simakma5/diploma-thesis/latex/declaration.tex

\clearpage
\vspace*{\fill}
\noindent\textbf{Declaration}\\[0.25cm]
I declare that I completed the presented thesis independently and that all used sources are quoted in accordance with the Methodological instructions that cover the ethical principles for writing an academic thesis.\\
\hrule\vspace*{1cm}
\begin{otherlanguage}{czech}
    \noindent\textbf{Prohlášení}\\[0.25cm]
    Prohlašuji, že jsem předloženou práci vypracoval samostatně a že jsem uvedl veškeré použité informační zdroje v souladu s Metodickým pokynem o dodržování etických principů při přípravě vysokoškolských závěrečných prací.\\
    \begin{center}
        \begin{minipage}{0.45\textwidth}
            \begin{flushleft}
                V Praze \hdashrule{3cm}{0.5pt}{2pt}
            \end{flushleft}
        \end{minipage}
        ~
        \begin{minipage}{0.45\textwidth}
            \begin{flushright}
                \noindent\begin{tabular}{c}
                    \\
                    \hdashrule{4cm}{0.5pt}{2pt}\\
                    Martin Šimák
                \end{tabular}
            \end{flushright}
        \end{minipage}
    \end{center}
\end{otherlanguage}
\clearpage
