simakma5/diploma-thesis/latex/frontpage.tex

% Define a new command for horizontal lines, change thickness here
\newcommand{\HRule}{\rule{\linewidth}{0.5mm}}
\center

%========== Header ==========
\textsc{\LARGE Czech Technical University in Prague,\\Faculty of Electrical Engineering}\\[1.5cm]
\textsc{\Large Master's thesis}\\[0.5cm]

%========== Title ==========
\HRule\\[0.6cm]
{\huge\bfseries Dual Circularly Polarized Waveguide Antenna}\\[0.3cm] % Title of your document
\HRule\\[1.5cm]

%========== Authors ==========
\begin{minipage}{0.45\textwidth}
    \begin{flushleft}
        \large
        \textit{Author}\\
        M. \textsc{Šimák}\\
        \textsc{Department of Electromagnetic Field}
    \end{flushleft}
\end{minipage}
~
\begin{minipage}{0.45\textwidth}
    \begin{flushright}
        \large
        \textit{Supervisor}\\
        doc. Ing. P. \textsc{Hazdra}, Ph.D.\\
        \textsc{Department of Electromagnetic Field}
    \end{flushright}
\end{minipage}

%========== Logo ==========
% Position at 3/4 of the screen
\vfill\vfill\vfill
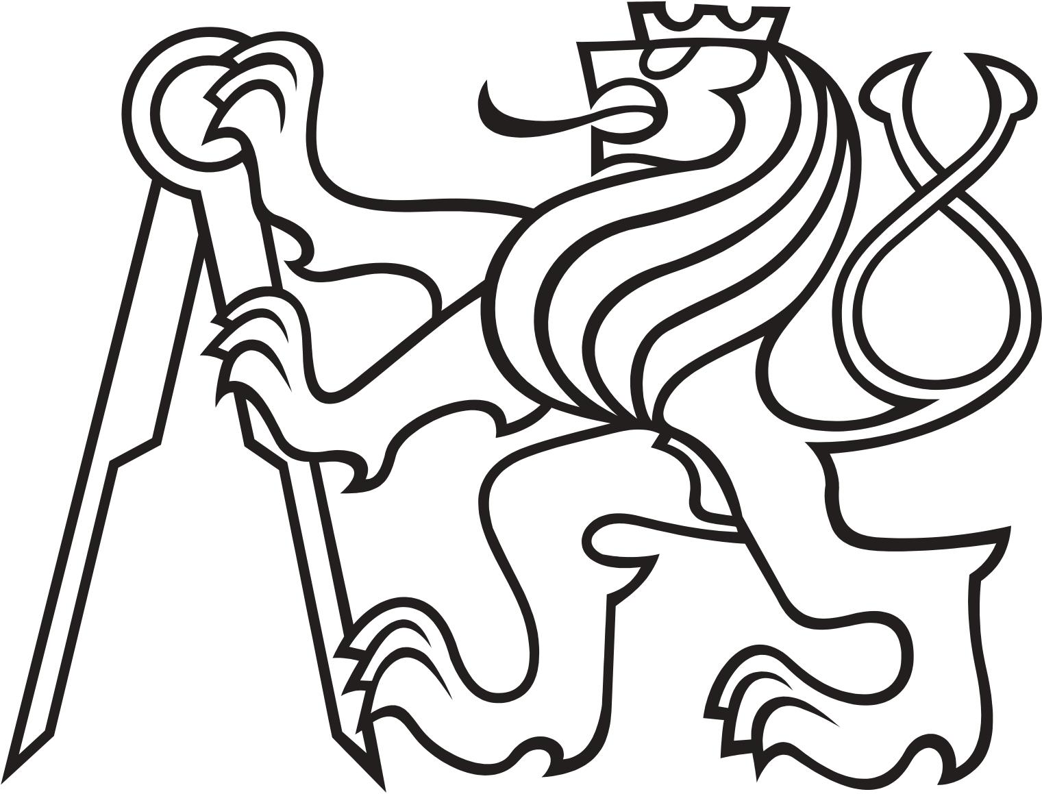
[picture p1: latex/src/ctu_logo_black.jpg]


%========== Date ==========
\vfill\vfill
{\large\monthyeardate\today}
% Push the date up 1/4 of the remaining page
\vfill
