simakma5/diploma-thesis/progress-reports/09-progress_report.pptx

## Dual circularly polarized waveguide antenna

Final design

## Outline

- Conical horn design
- Prototype
- Functional changes
- Assembly-related adjustments
- Thesis
- Conclusion

Research progress report

## Conical horn design

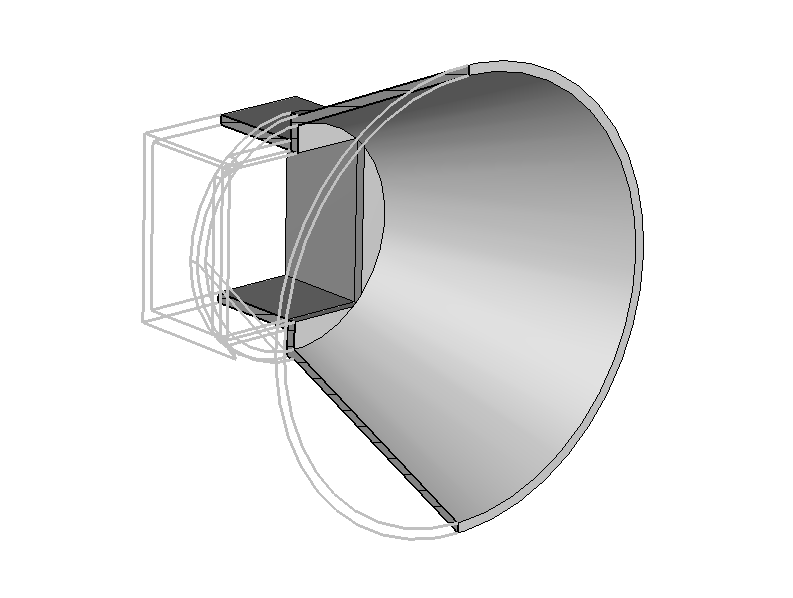
[picture p2: figure]

- Valuable theoretical analysis and guidelines given in [1]
- Antenna Magus
- Adaptation of a cone to the square waveguide

## Conical horn – reflection

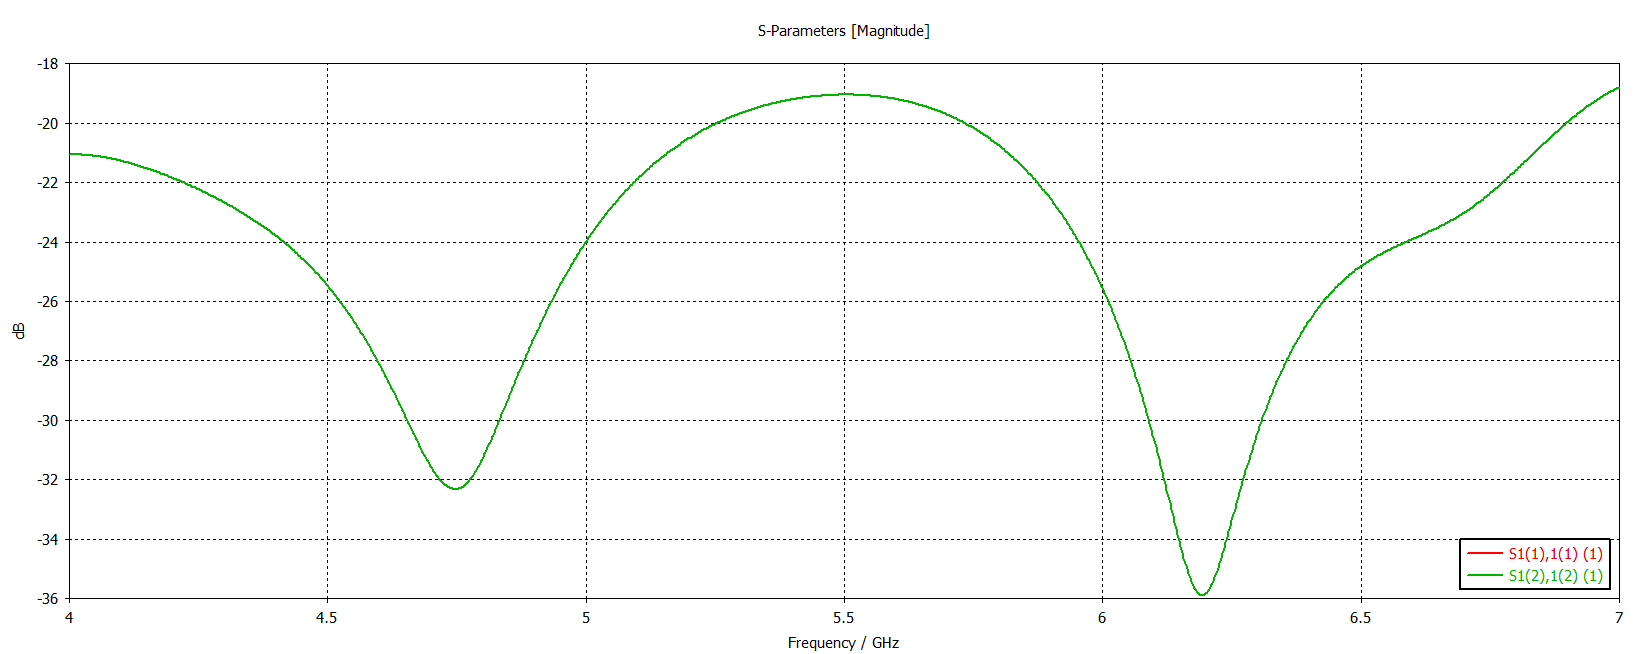
[picture p3: figure]

## Conical horn – gain

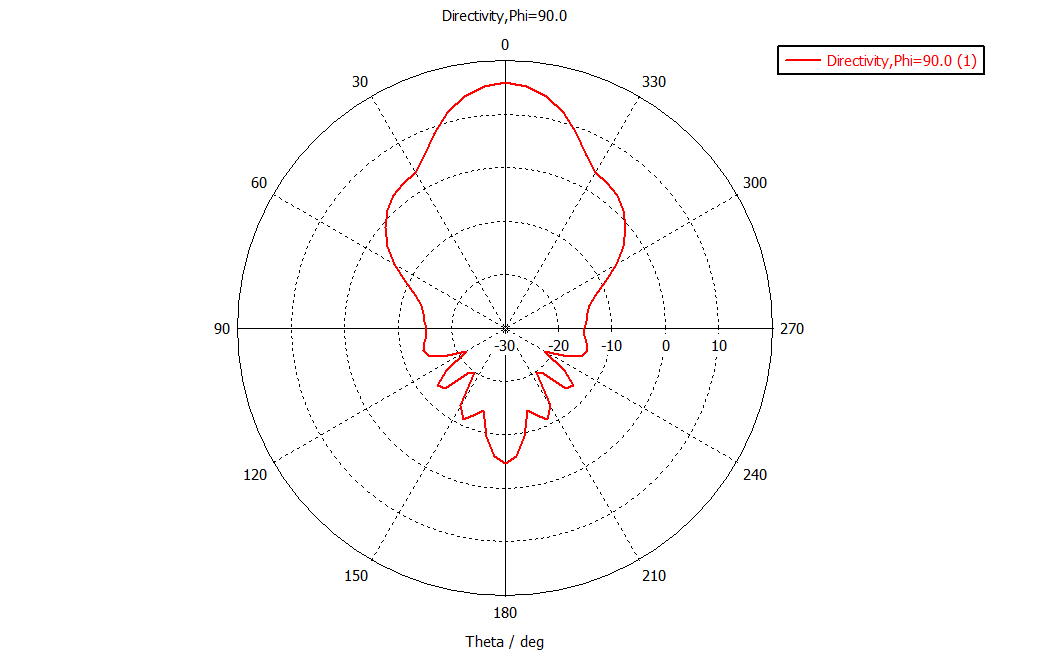
[picture p4: figure]

## Prototype – per partes

- Managed to get good simulation results piece-by-piece
- Especially difficult of the dual feeding structure with grating

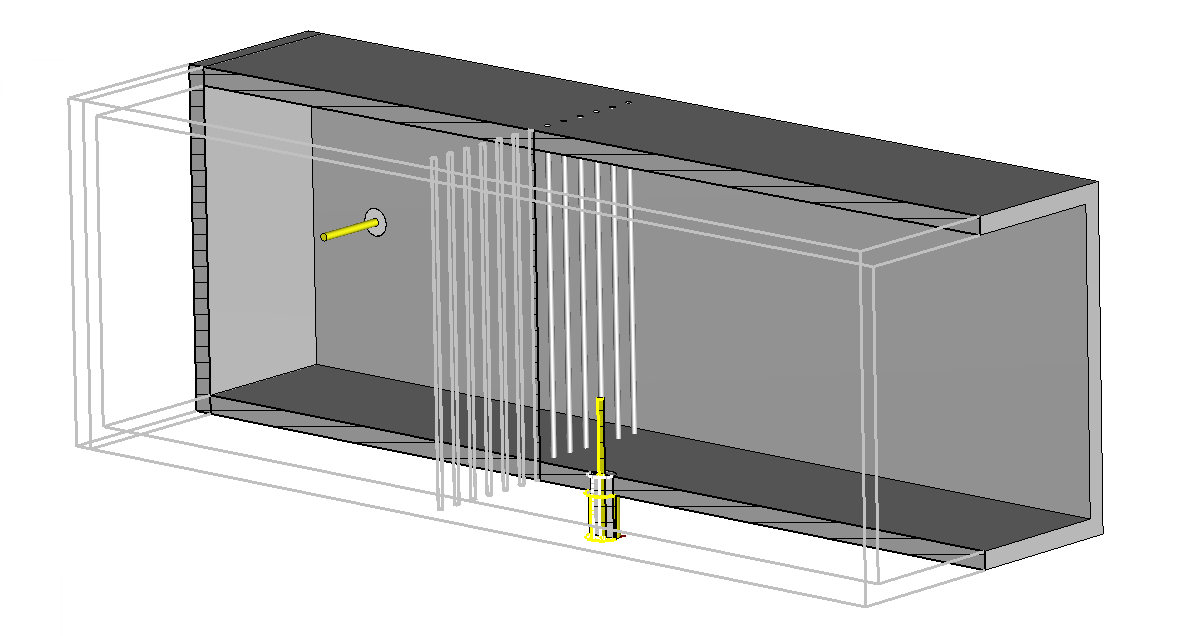
[picture p5: figure]
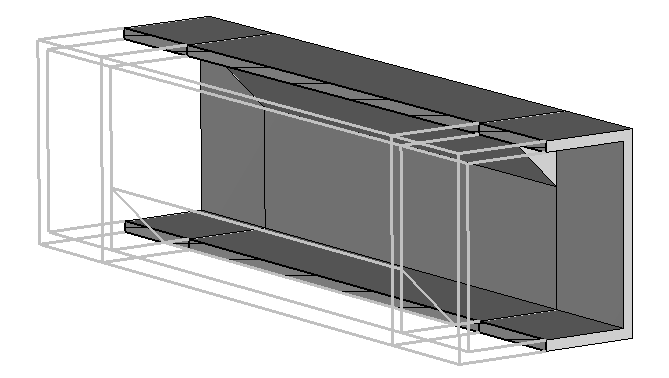
[picture p6: figure]
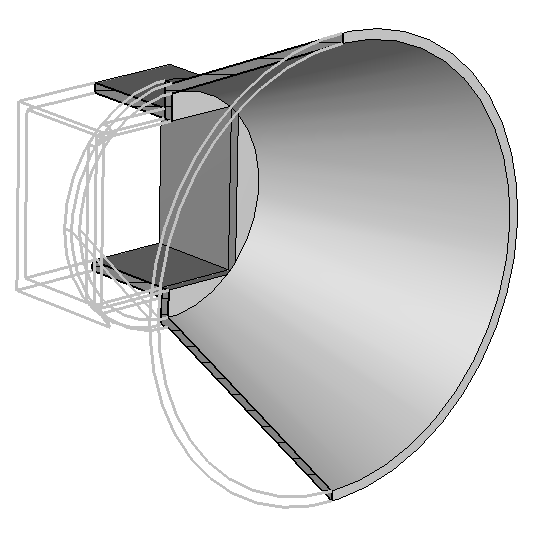
[picture p7: figure]

## Prototype – model

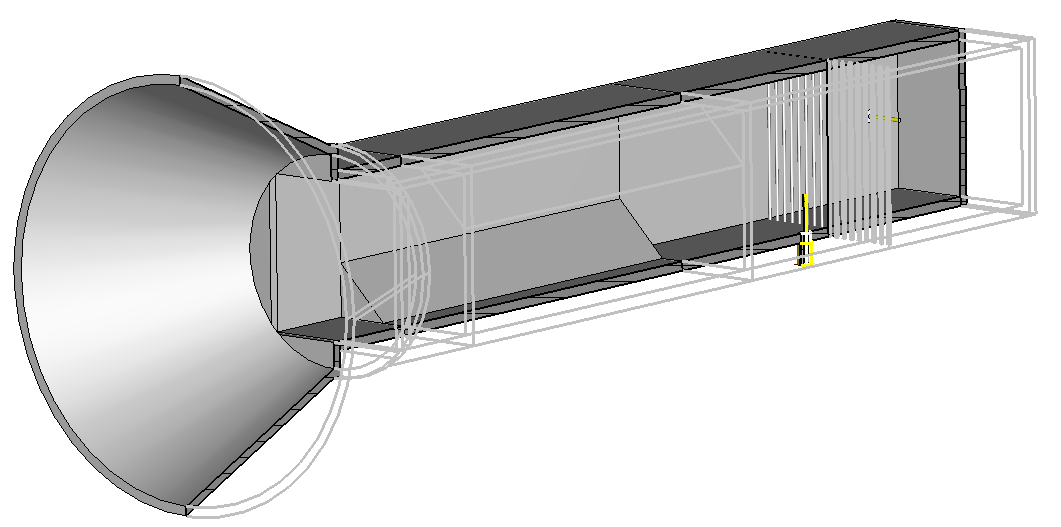
[picture p8: figure]

## Prototype – results

- Unfortunately, performance was much worse after completion
- Cause analysis
  - Grating causes unwanted field torsion
  - Newly introduced reflections increase probe coupling
  - Higher order modes appearance with more complex propagation geometry
- Crosstalk had risen so much the grating polarizer lost its meaning

## Prototype – S-parameters

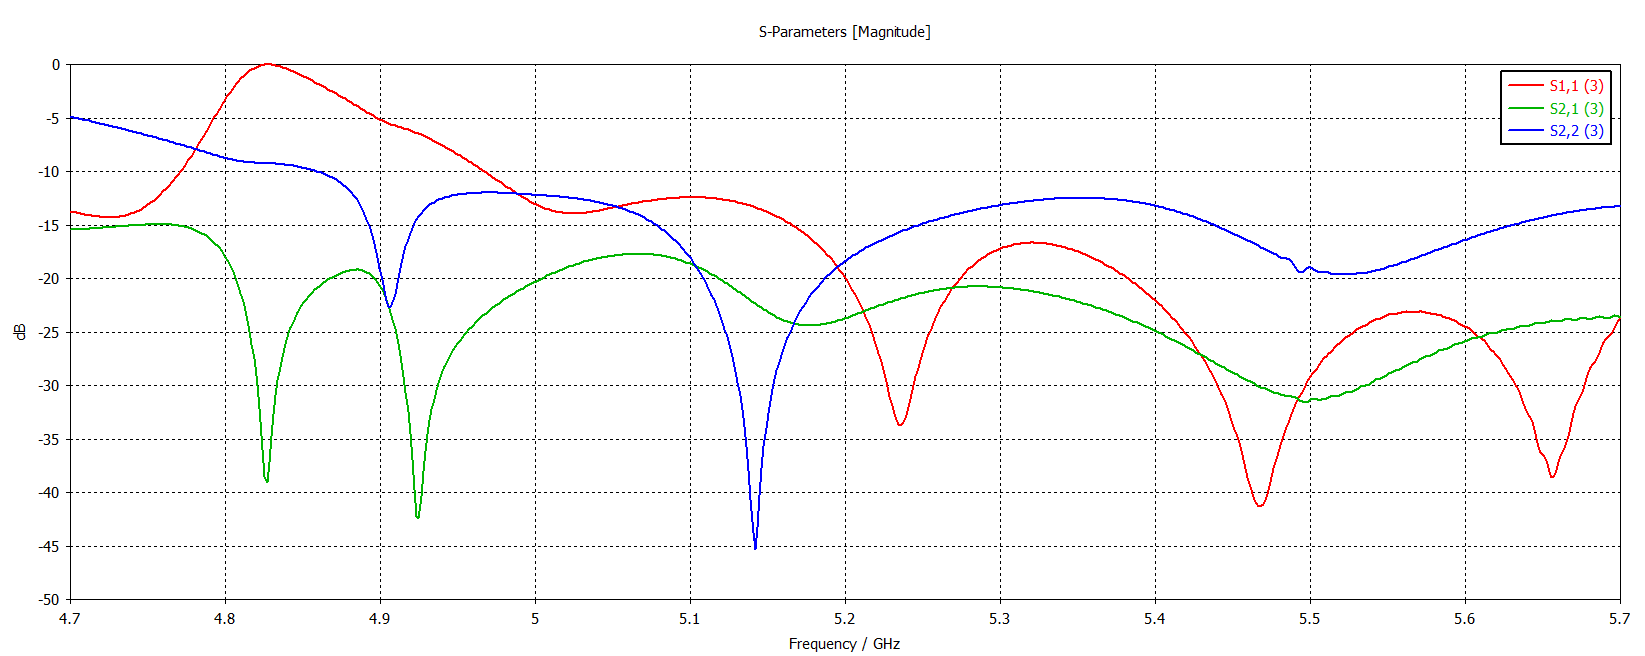
[picture p9: figure]

## Prototype – Axial ratio

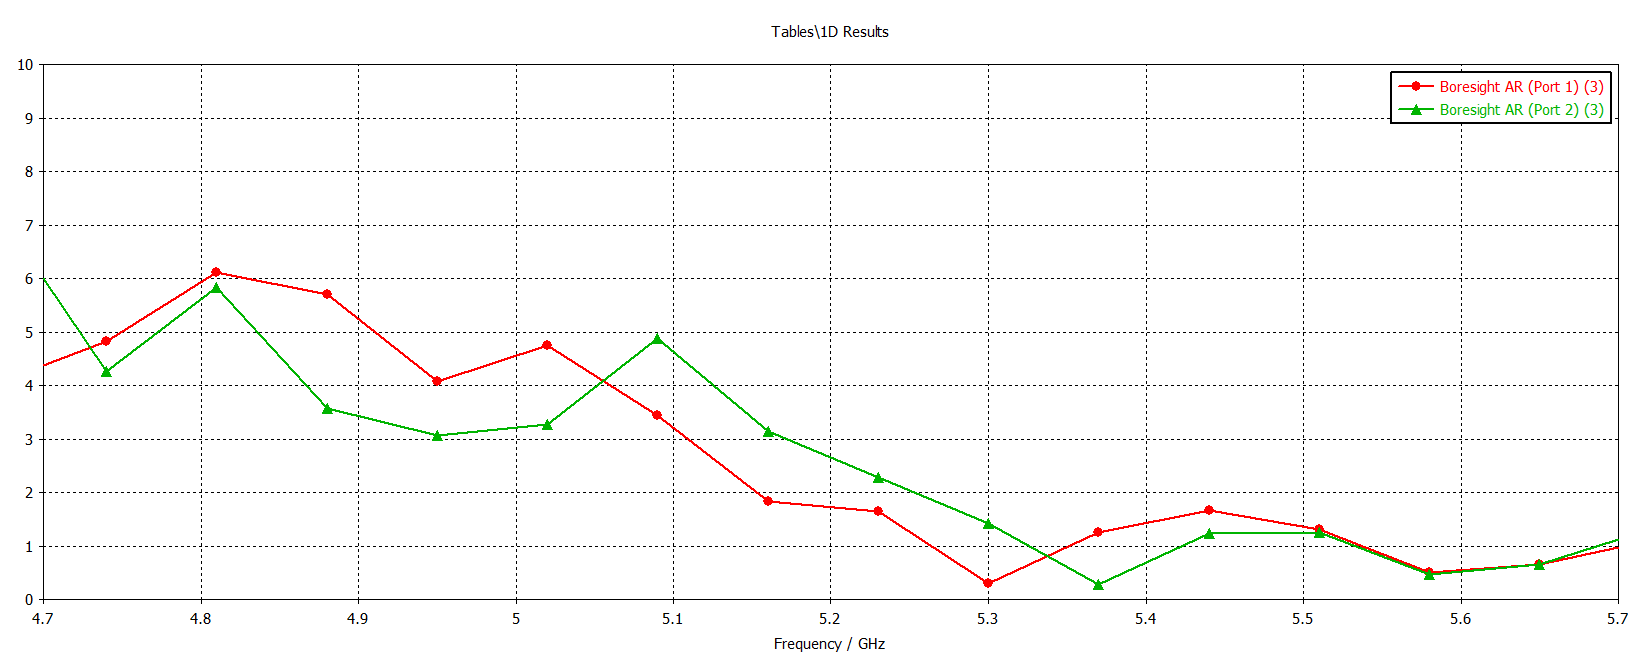
[picture p10: figure]

## Functional changes

- Further simulations, tweaking the geometry:
  - Tuning the grating geometry
  - Adjusting various waveguide lengths
  - Complete removal of grating
- Turns out the crosstalk without the grating is viable!
- Design MVP* was simulated for timely manufacturing
  - Precise simulation with over 35 million mesh cells, -50 dB energy precision
*MVP stands for Minimum Viable Product

## Functional changes – model

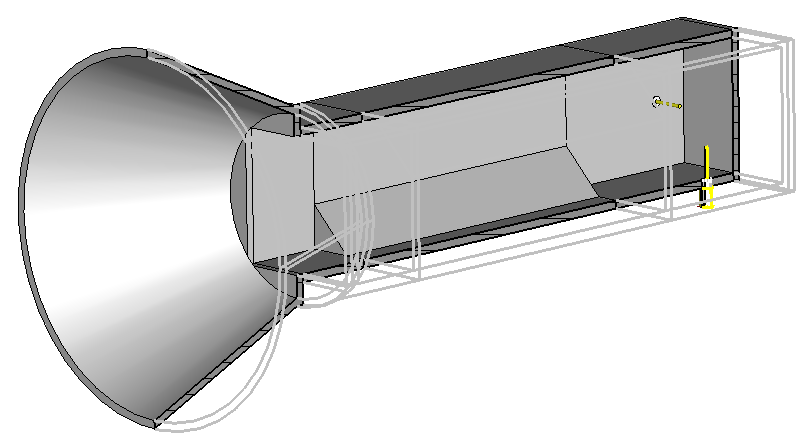
[picture p11: figure]

## Functional changes – S-parameters

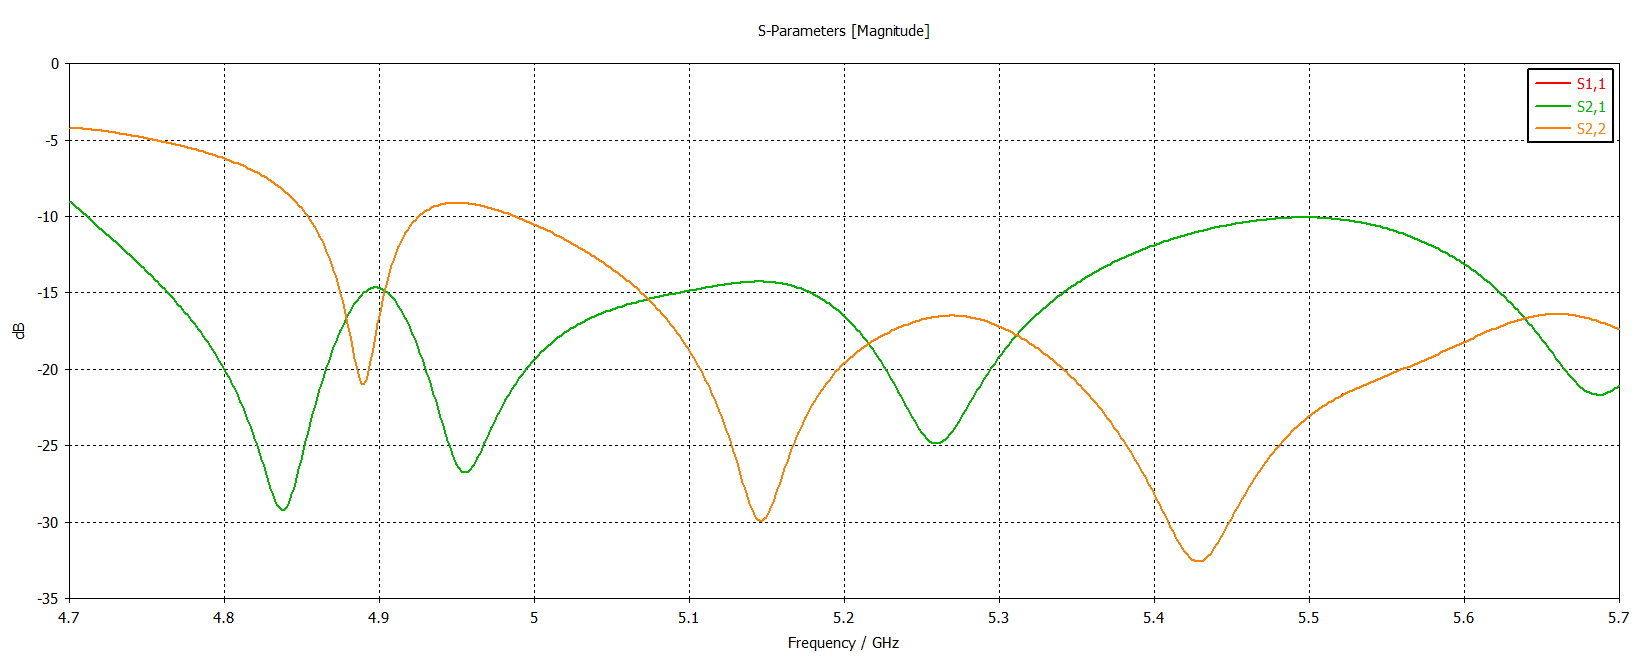
[picture p12: figure]

## Functional changes – Axial ratio

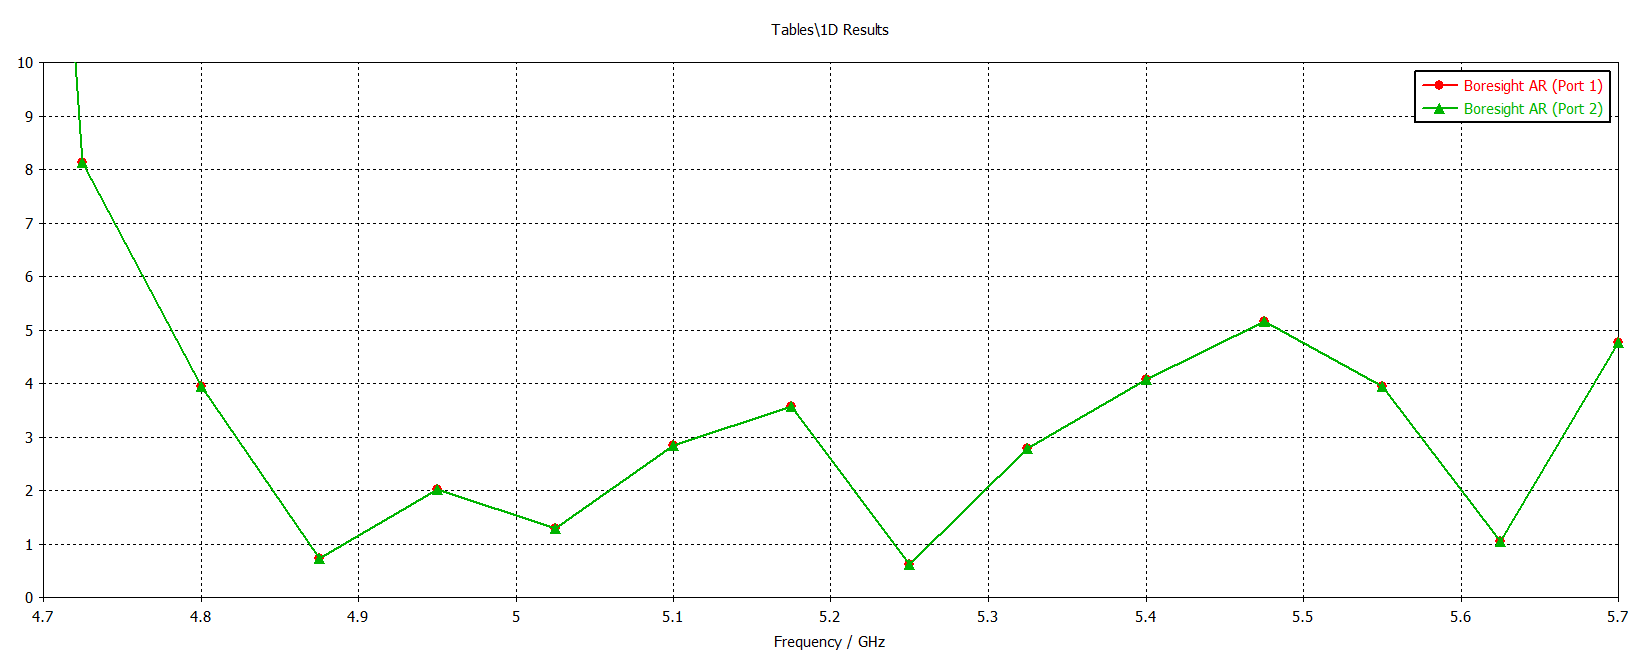
[picture p13: figure]

## Assembly-related adjustments

- The fabrication company* uses CNC machining for fabrication
- Division of the whole piece into 5
  - Horn, transition, polarizer, feed, back-short
  - Connected by flanges
- Adjustments of the horn antenna to make it suitable for milling fabrication
  - While preserving inner dimensions
*Universal Microwave Technology

## Assembly-related adjustments (final)

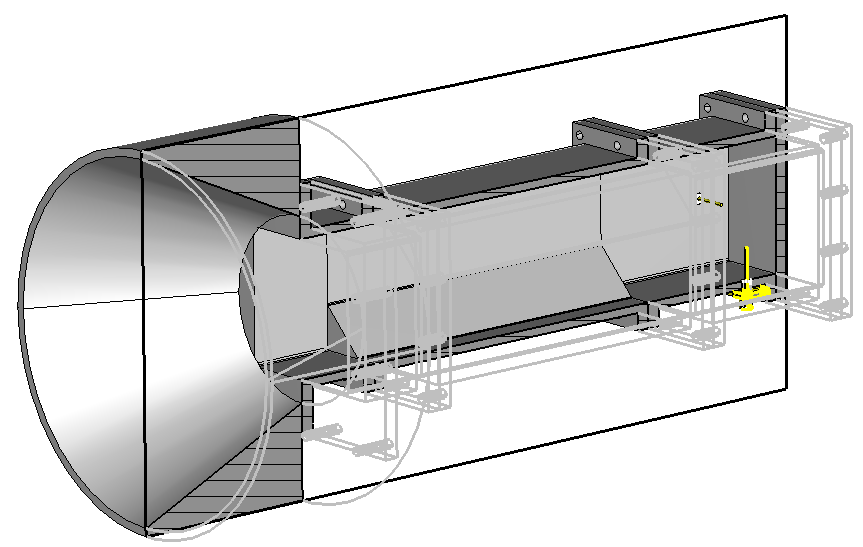
[picture p14: figure]

## Thesis

- Introduction
- 1 Theory of operation
- 2 Design process
  - 2.1 Polarizer design
  - 2.2 Dual feeding structure
    - Mention the grating polarizer variant
  - 2.3 Horn antenna
- 3 Fabrication, measurement and comparison
  - Discuss possibility of the grating polarizer, provide simulation results
  - Simulation and measurement results
- Conclusion

## Conclusion

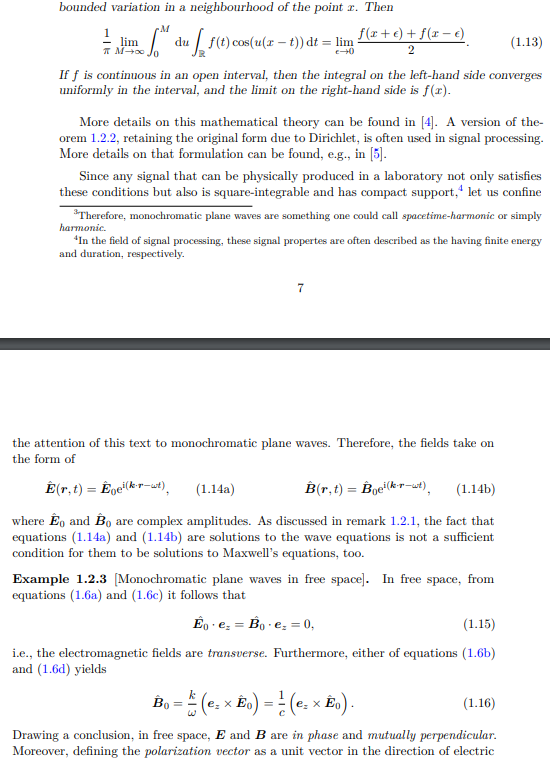
[picture p15: figure]

- Design
  - finalized
  - being manufactured
- In the meanwhile
  - Thesis text in progress
  - Analysis of dual feeding structure with grating

## Thank you

for your attention

## References

[1] N. A. Aboserwal, C. A. Balanis and C. R. Birtcher, "Conical Horn: Gain and Amplitude Patterns," in IEEE Transactions on Antennas and Propagation, vol. 61, no. 7, pp. 3427-3433, July 2013, doi: 10.1109/TAP.2013.2256453.
