simakma5/diploma-thesis/progress-reports/01-progress-report.pptx

## Inductive wireless power transfer

Simulation results and analytical validation

## Outline

- Motivation
- Equivalent circuit analysis
- Coupled inductors
  - Resistance
  - Inductance
  - Comparison of results
- Conclusion
- Outlooks

Research progress report

## Motivation

- Growing demand for WPT systems
- Imperfections in the Qi 2.0 standard, especially the Magnetic Power Profile (MPP)
- Need for accurate and precise simulations
- Collaboration with esteemed companies
Image: How the New Qi2 Standard Will Change the Future of Wireless Charging (graniteriverlabs.com) (https://www.graniteriverlabs.com/en-us/industry-insights/qi2-wireless-charging-mpp-wpc)

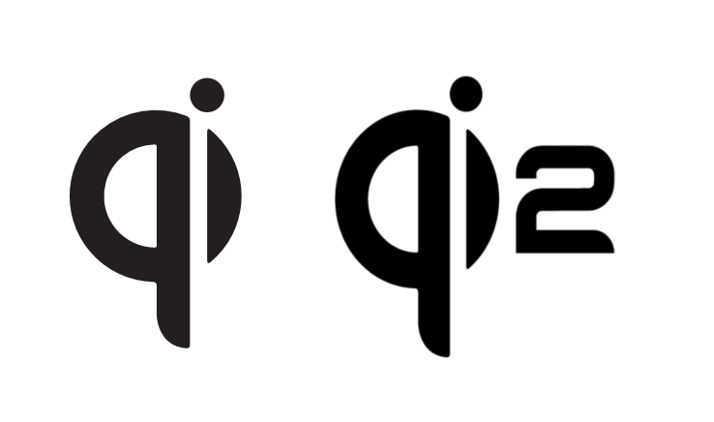
[picture p16: figure]
How the New Qi2 Standard Will Change the Future of Wireless Charging

## Equivalent circuit analysis – IWPT system

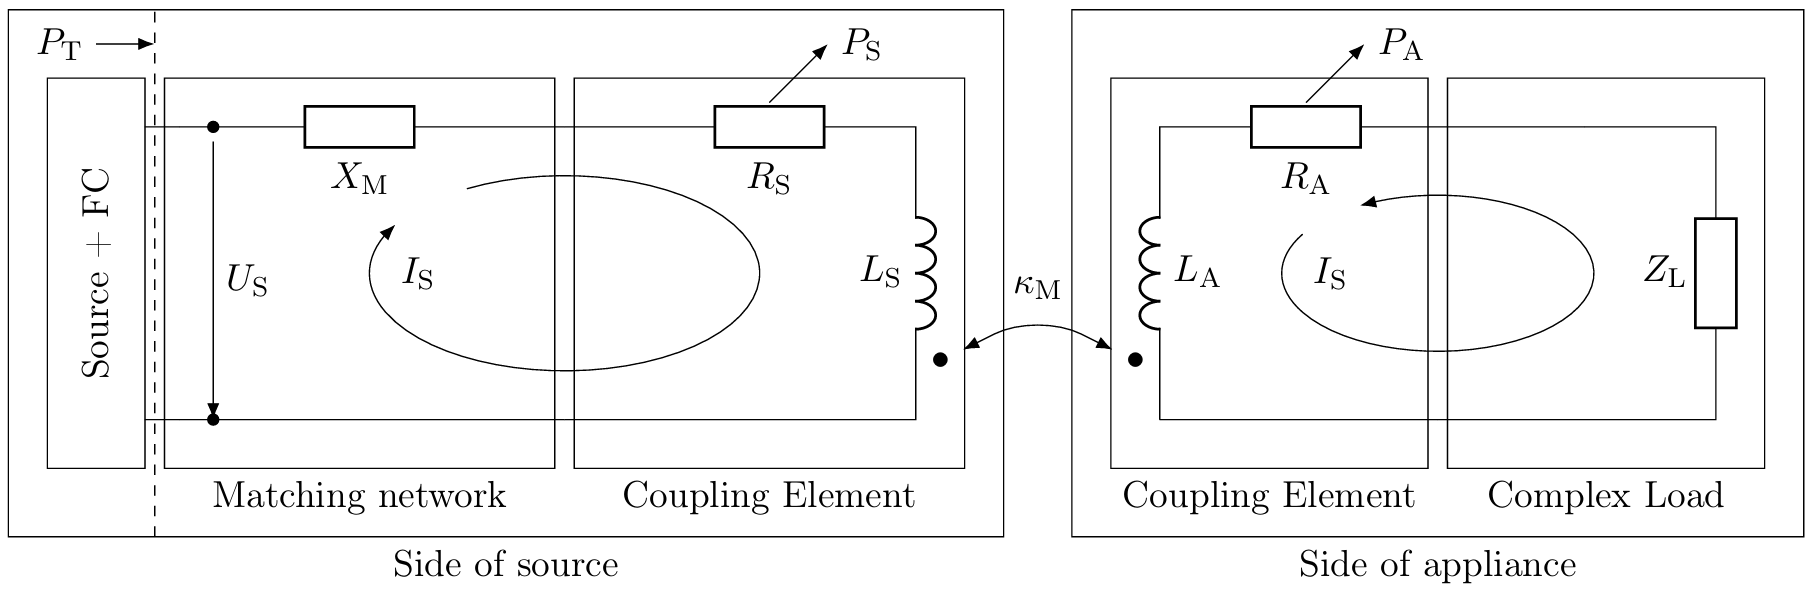
[picture p17: figure]

## Equivalent circuit analysis – coupled inductors

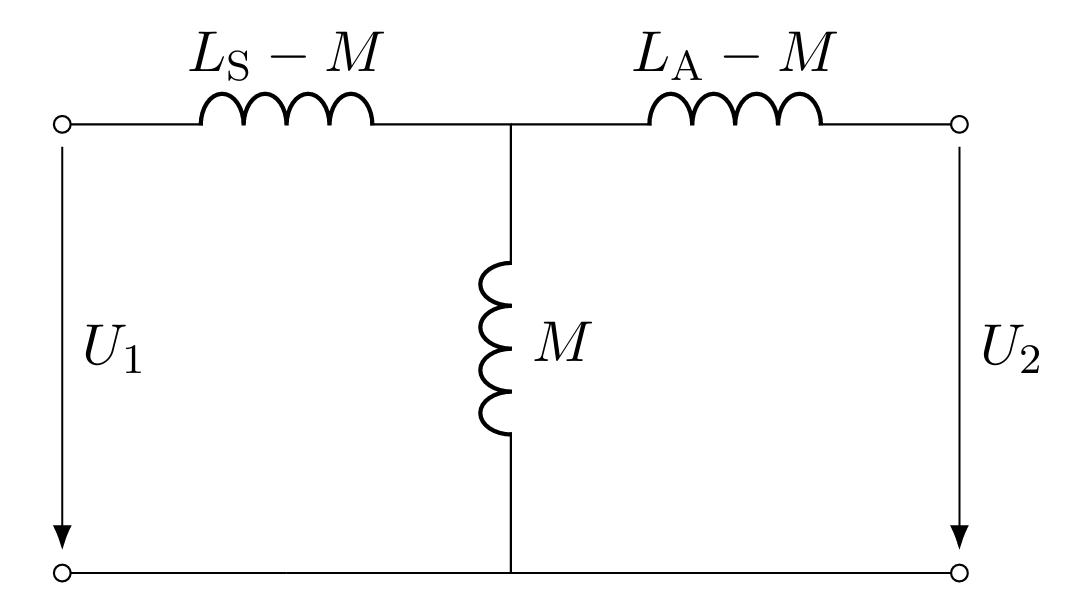
[picture p18: figure]
Equivalent circuit of coupled inductors

## Coupled inductors – 3D CAD model

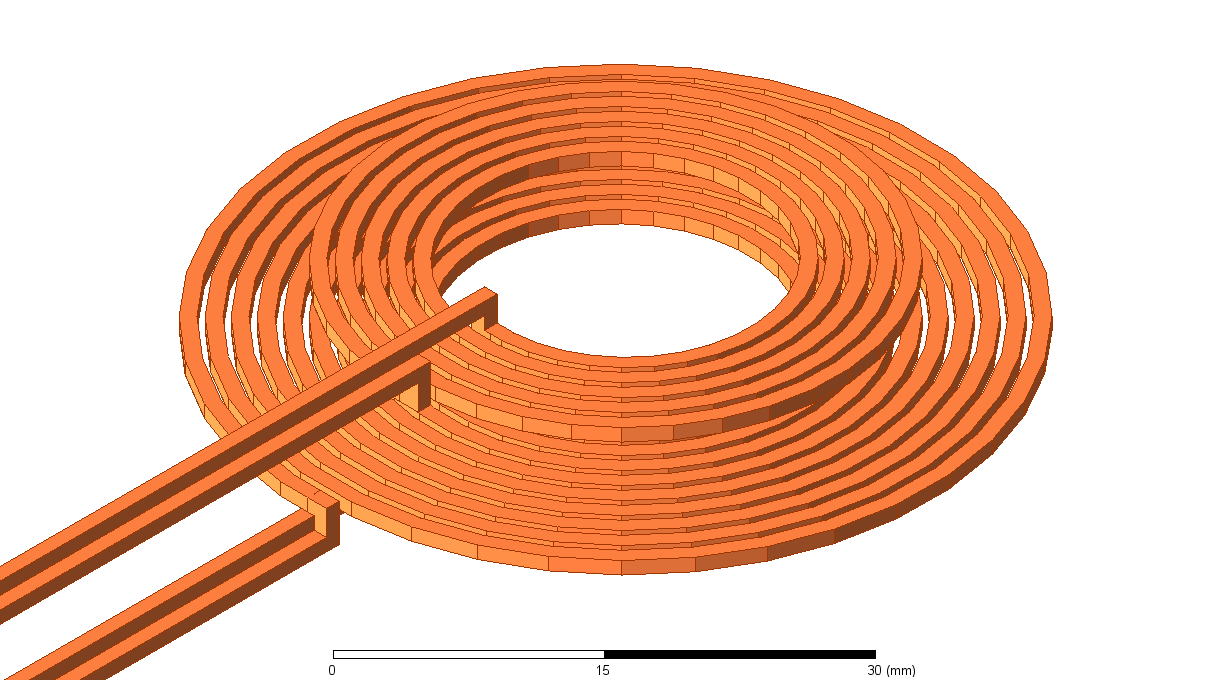
[picture p19: figure]
CAD model of coupled inductors

## Coupled inductors – dimensions

- Transmitting coil (Tx)

- Inner diameter: 20 mm,
- outer diameter: 51 mm,
- coil height: 1 mm,
- number of turns: 10.

- Receiving coil (Rx)

- Inner diameter: 20 mm,
- outer diameter: 36 mm,
- coil height: 1 mm,
- number of turns: 5.

## Resistance – analytical formulas

- DC resistance R=(ρ⋅ℓ)/A=ℓ/(σA) .
- Conductivity of annealed copper σ=5.8001×10^7 S m^(−1) .
- Length ℓ=∫_α^β √(|f(θ)|^2 +|f^(′) (θ)|^2) dθ= ∫_α^β √(r^2 +((∂r)/(∂θ))^2) dθ .
- Transmitting inductor r_(Tx) (θ)=10+1.46/(2π)θ, where 0≤θ≤10×2π .
- Receiving inductor r_(Rx) (θ)=10+1.46/(2π)θ, where 0≤θ≤5×2π .

## Inductance – analytical formulas

- The formulas are in accordance with [3].
- M=4/3μ_0 (R_1 R_2 )^(3/2) (N_1)/(h_1)(N_2)/(h_2)[X(k_11 )−X(k_22 )−X(k_33 )−X(k_44 )].
- L=8/3μ_0 R^3 (N^2)/(h^2)[1/kCel(k,1,1,−2(k^2 −1))−1] .
- Mathematical functions: X(k)=1/k[Cel(k,1,(3ρ)/2−2,−((3ρ−2)(k^2 −1))/2)−3/2ρ(1−k^2 )Cel(k,−(ρ(k^2 −1))/(ρ−2),1,1)] , Cel(k,p,a,b)=∫_0^(π/2) (acos^2 (φ)+bsin^2 (φ))/(cos^2 (φ)+psin^2 (φ))1/(√(1−k^2 sin^2 (φ))) dφ .

## Inductance – numerical software [2]

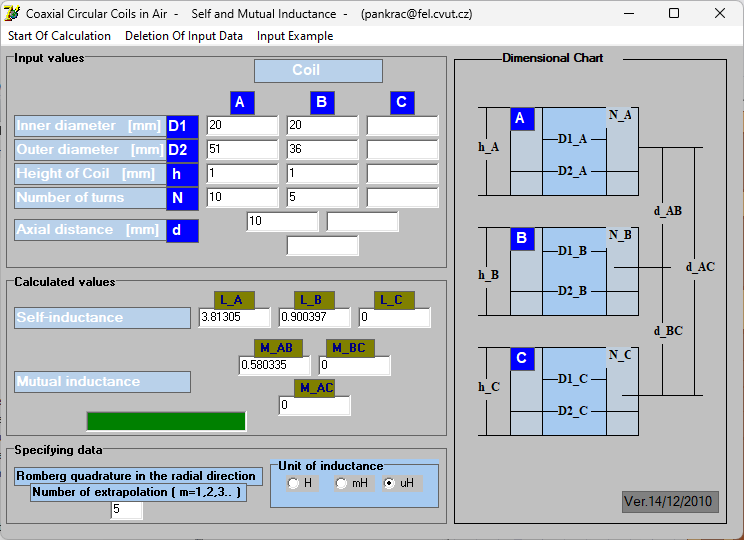
[picture p20: figure]

## Comparison of results

- Analytical

- R_(Tx) =21.9 mΩ ,
- R_(Rx) =10.4 mΩ ,
- L_(Tx) =3.8 μH ,
- L_(Rx) =0.9 μH ,
- M=0.6 μH.

- Simulation

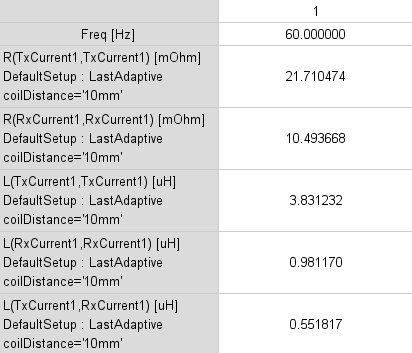
[picture p21: figure]

## Conclusion

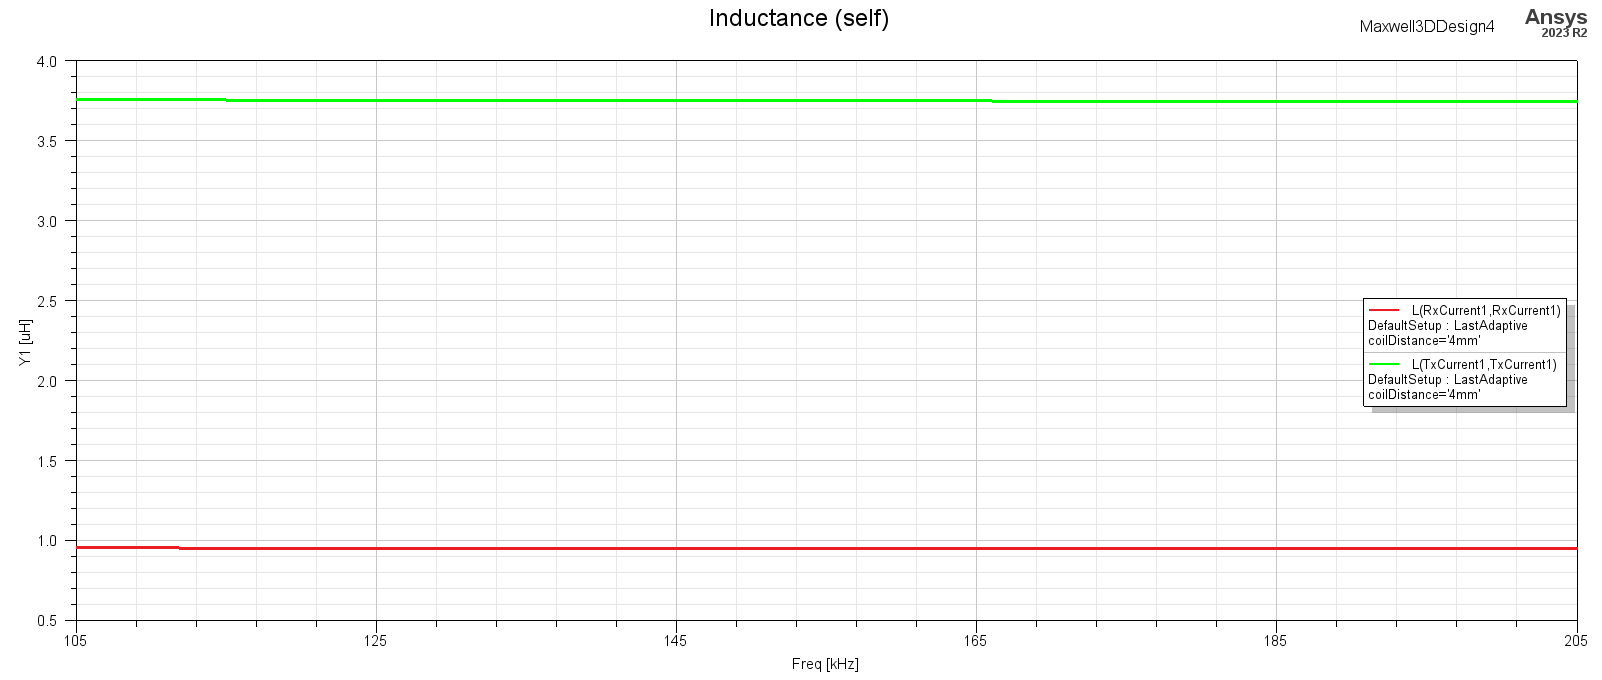
[picture p22: figure]

- ANSYS Maxwell software result validation
- Extension to different geometries
- Extension to AC-excited systems

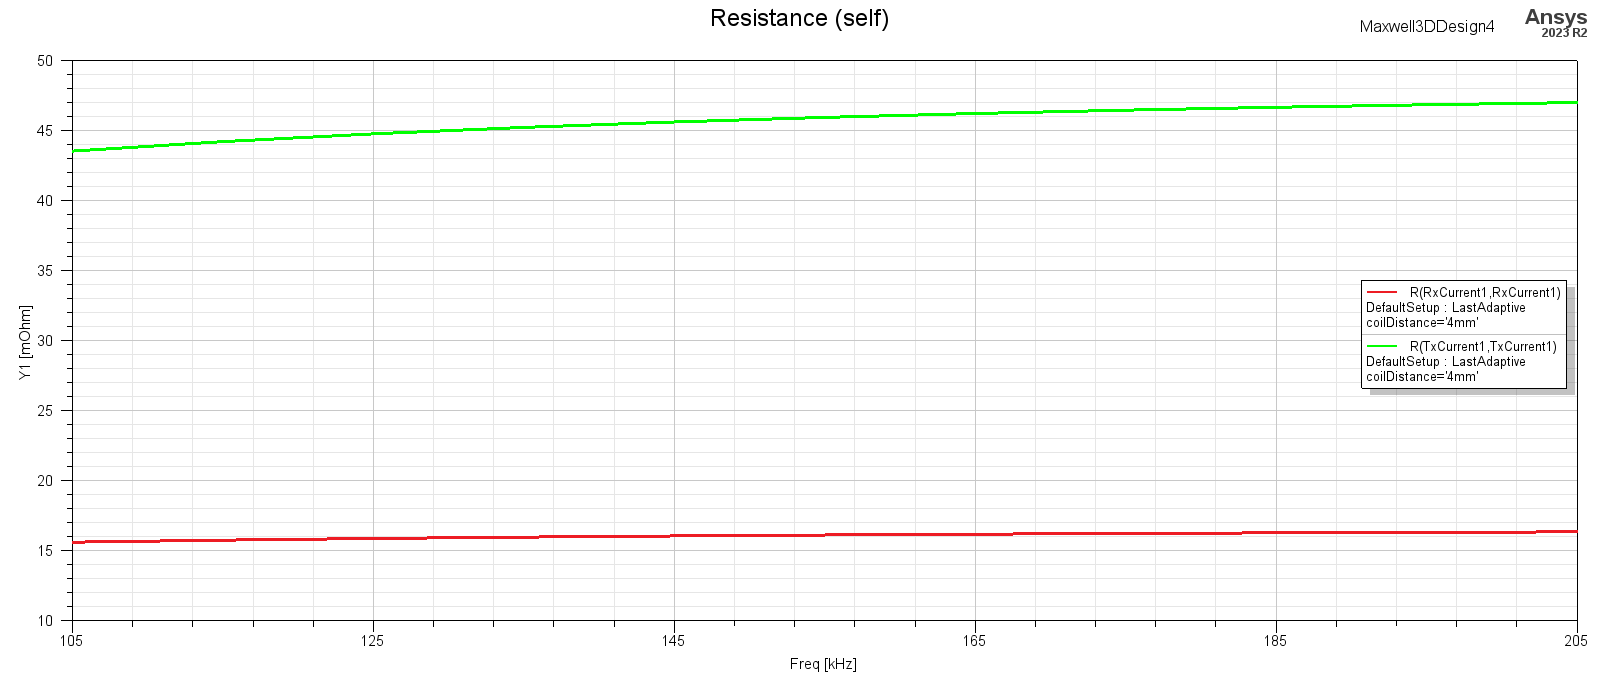
[picture p23: figure]
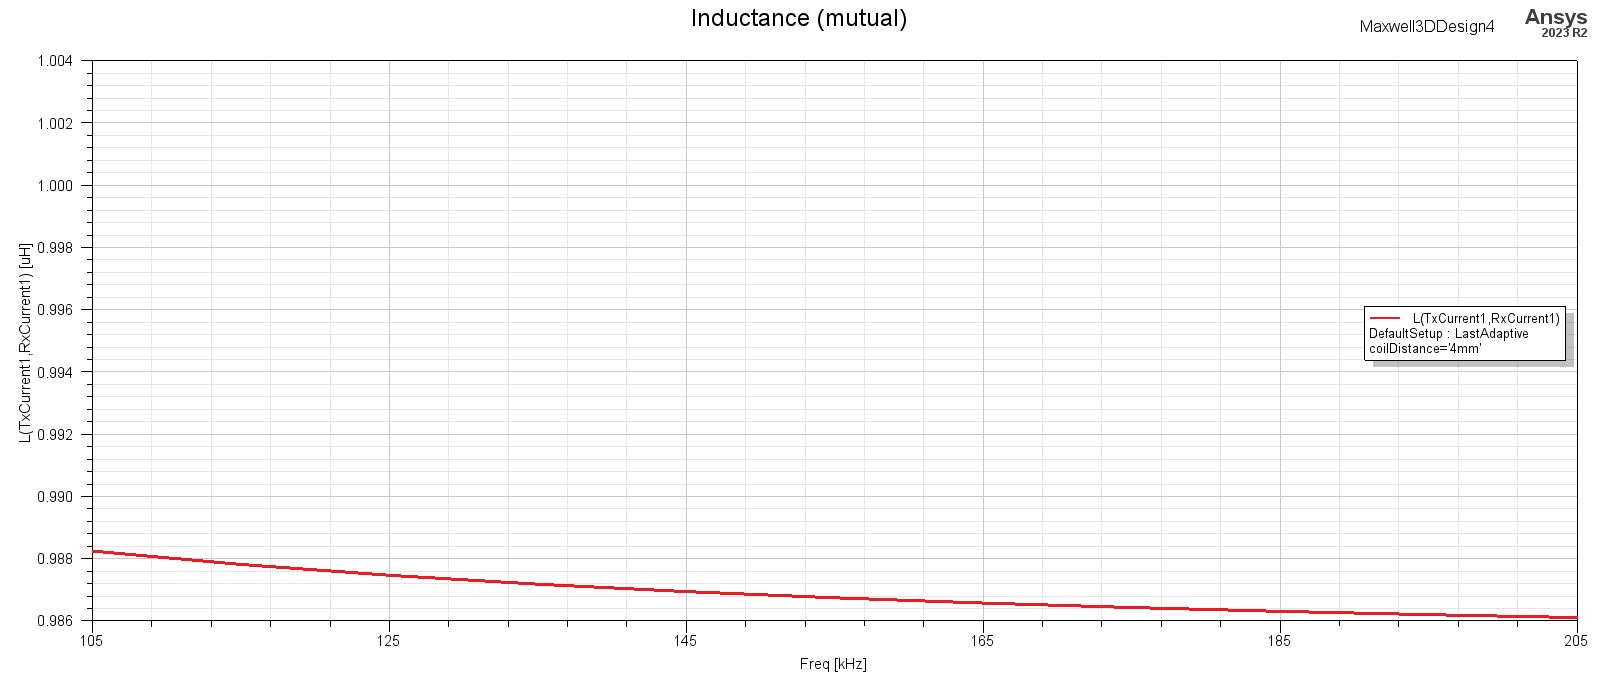
[picture p24: figure]

## Outlooks – STMicroelectronics

- A multinational corporation of French-Italian origin.
- Regional headquarters in Singapore and Shanghai.
- Design centers across the world including Prague, Czech Republic.
- Manufacturer of Qi(氣)-compliant IWPT systems.

## References

[1] J. Kraček and M. Mazánek. Power balance of inductive wireless power transmission. Proceedings of the 5th European Conference on Antennas and Propagation, EUCAP 2011, 01 2011.
[2] V. Pankrác. Software for self and mutual inductance calculation of coaxial coils in air. https://elmag.fel.cvut.cz/uzivatel/vitezslav-pankrac/.
[3] V. Pankrác. Power inductors (part 3). Elektrorevue, 12(1):1–15, 2010. ISSN 1213 1539.

## Thank you

for your attention
