simakma5/diploma-thesis/progress-reports/02-progress_report.pptx

## Inductive wireless power transfer

Power transfer efficiency assessment

## Outline

- Coupled inductors
- Power transfer efficiency assessment
- Power balance
  - Maximal efficiency
  - Maximal active power delivered
- Simulation results
- Conclusion

Research progress report

## Coupled inductors

- Reference coils used by STMicroelectronics
- Oval transmitter coil [1]
- Ferrite cores

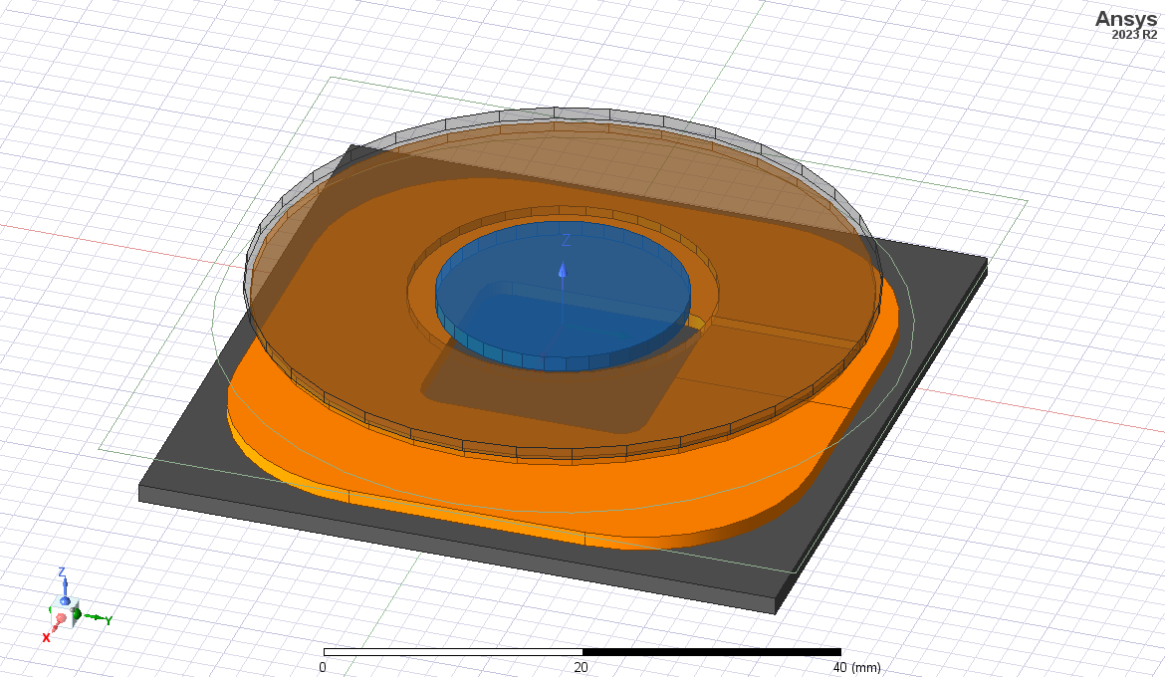
[picture p25: figure]

## Slide 4

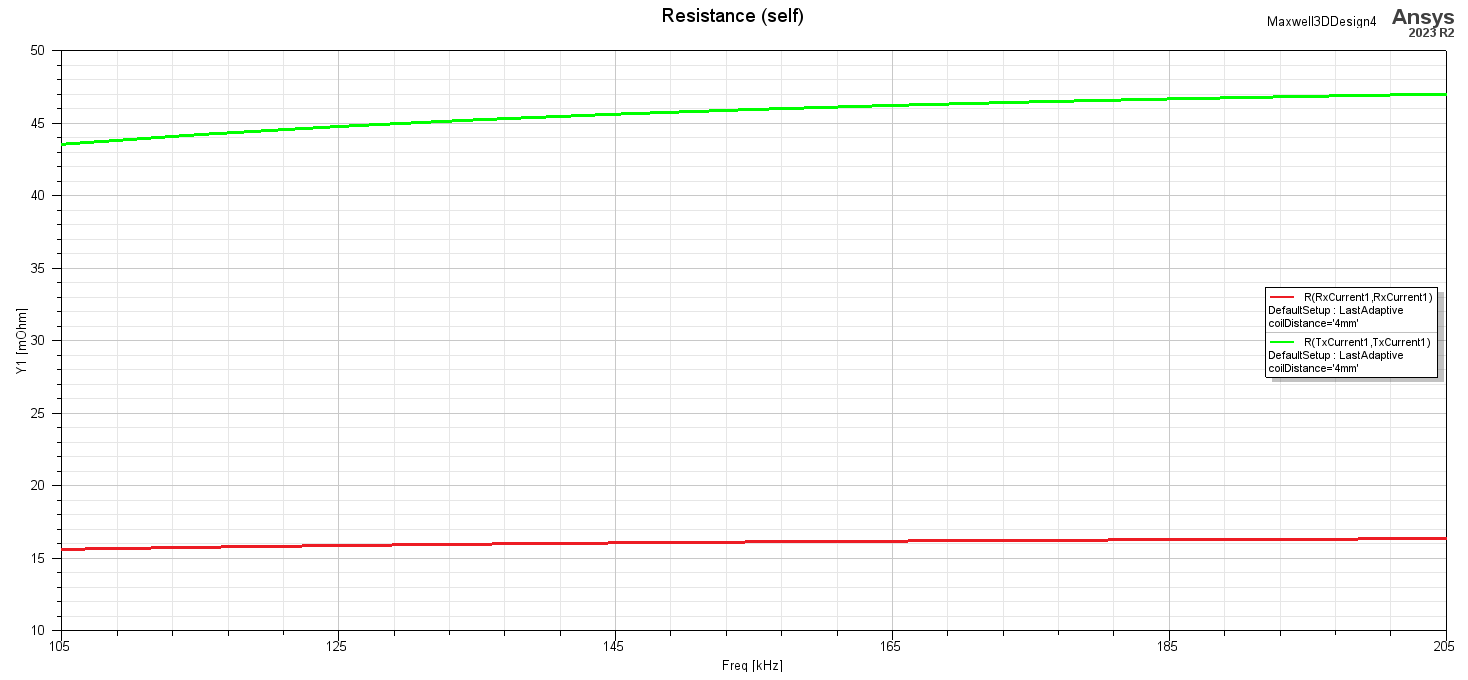
[picture p26: figure]
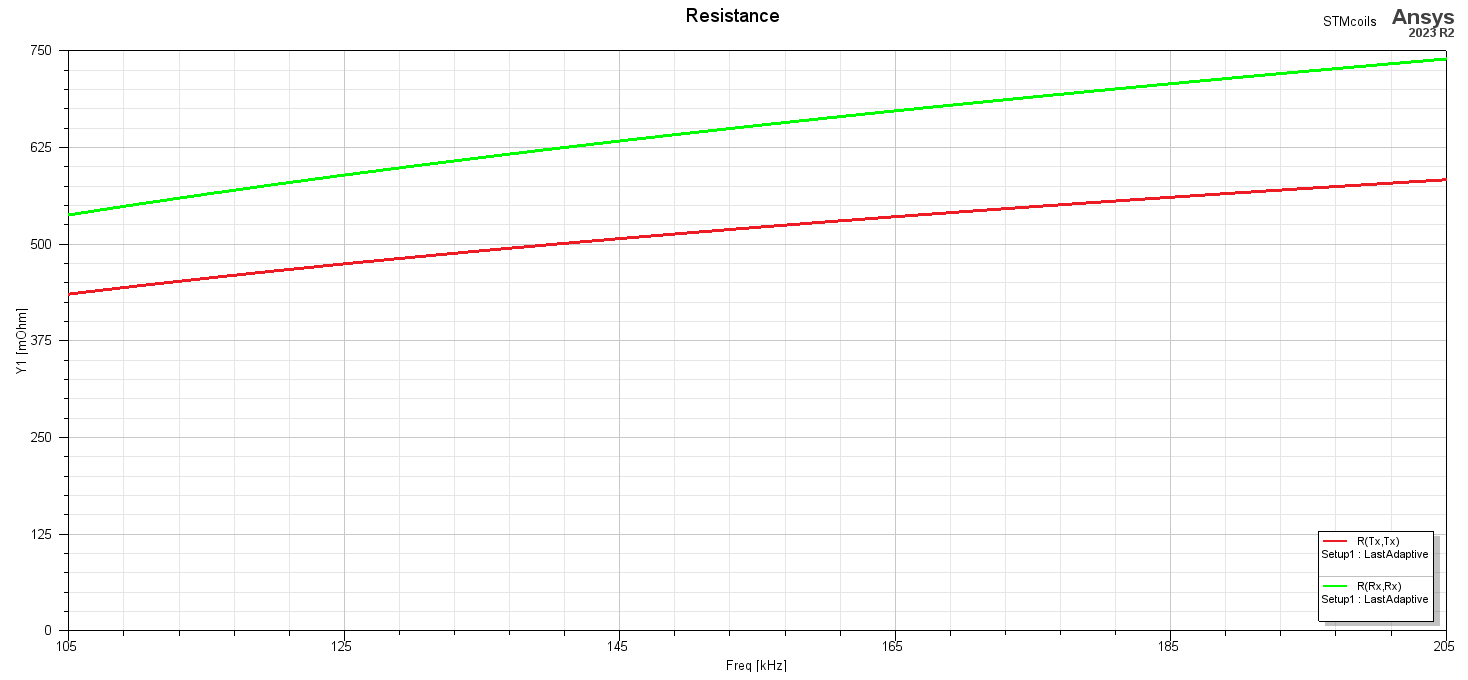
[picture p27: figure]

## Slide 5

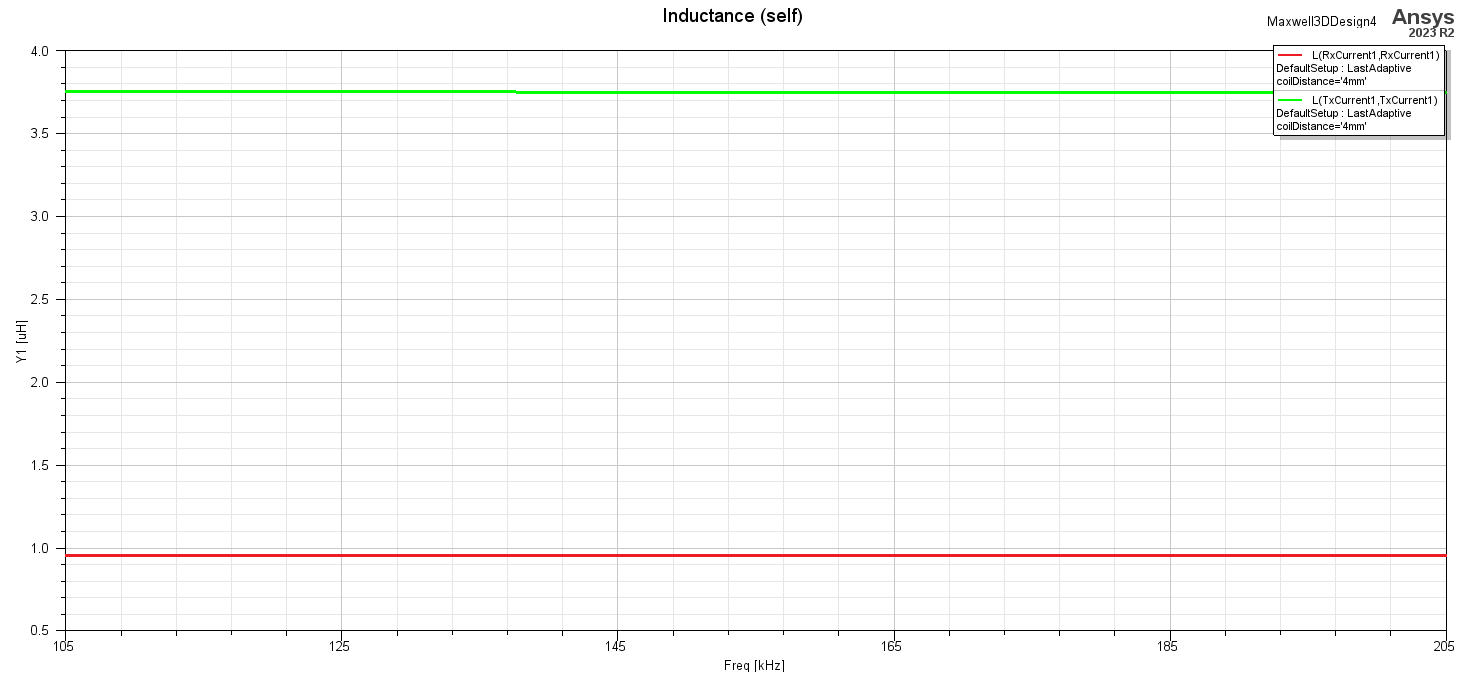
[picture p28: figure]
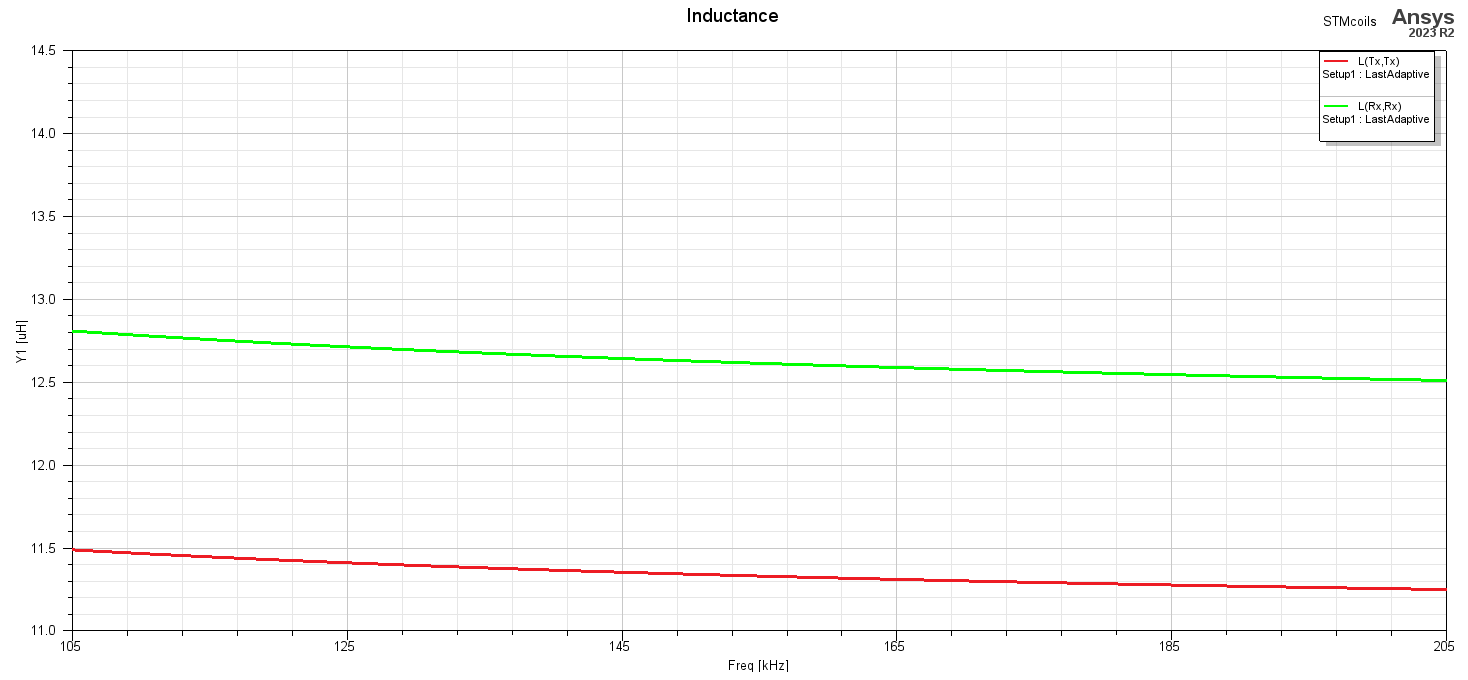
[picture p29: figure]

## Slide 6

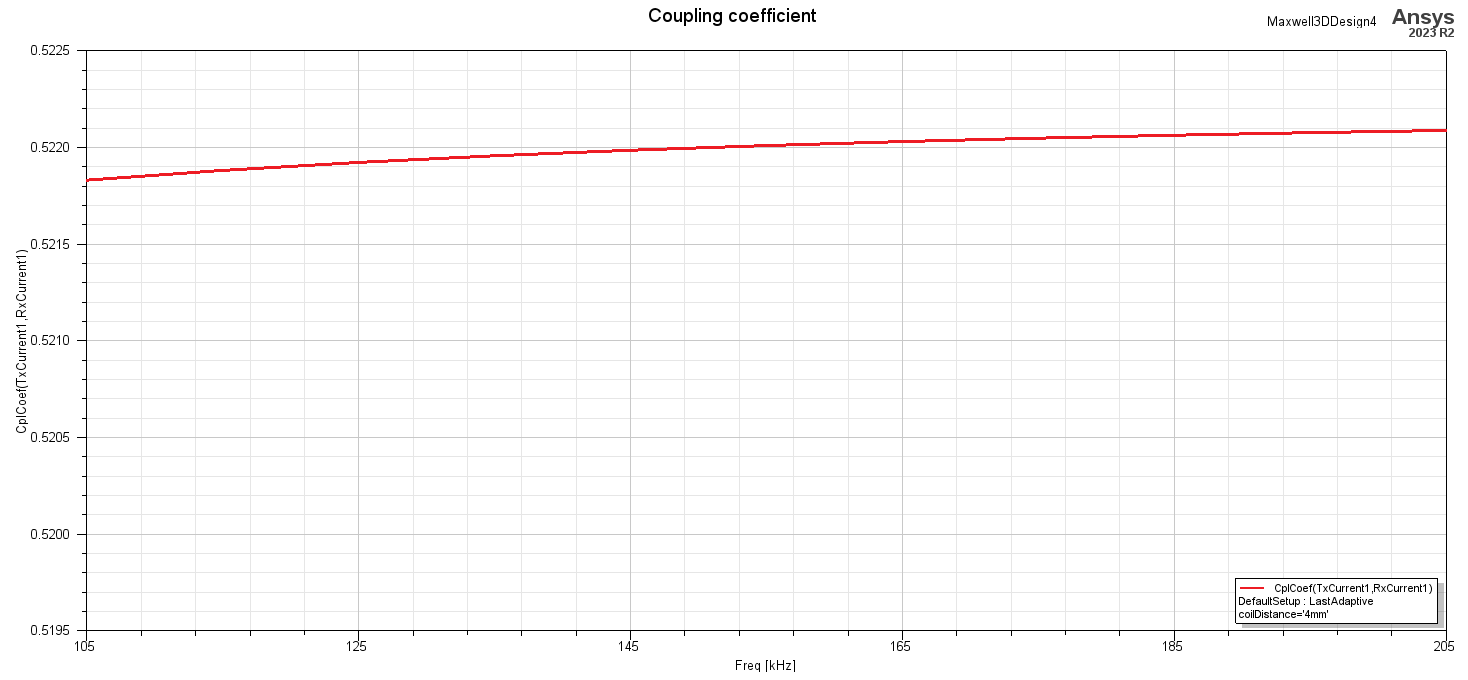
[picture p30: figure]
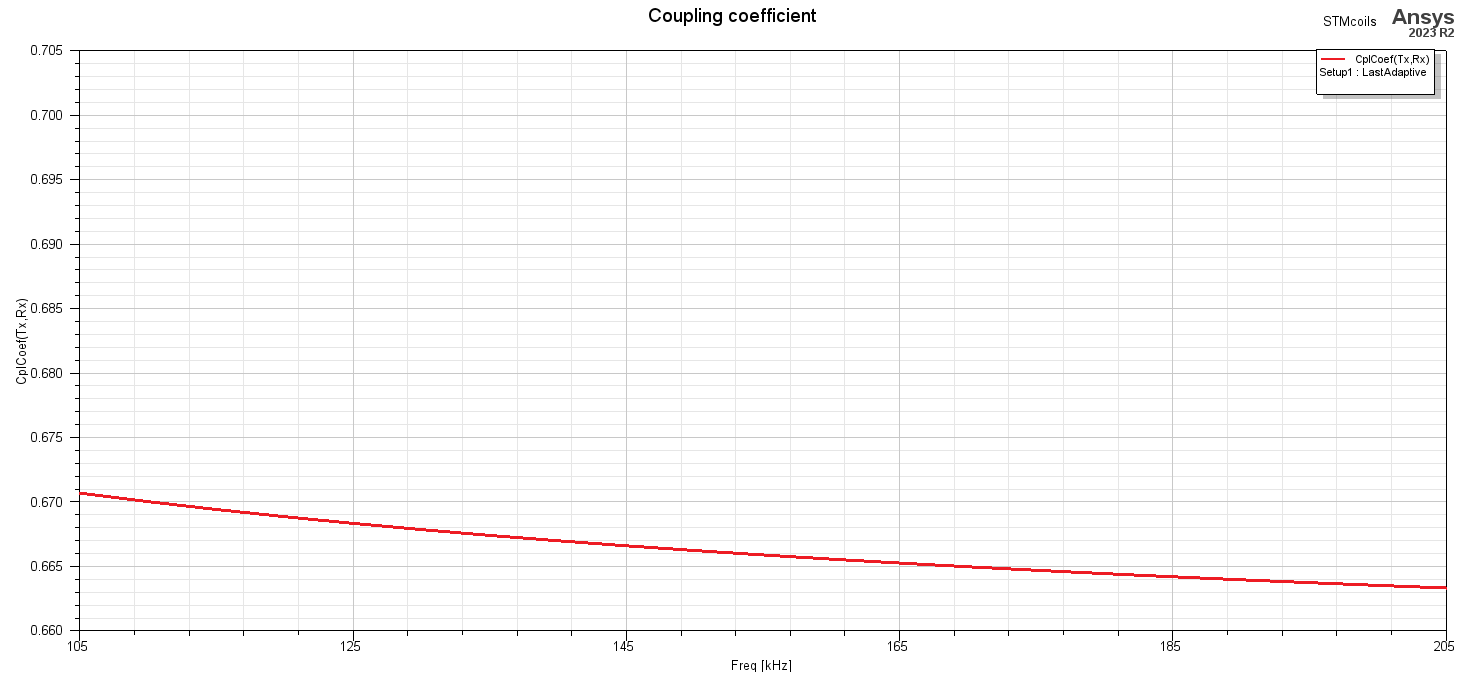
[picture p31: figure]

## Power transfer efficiency assessment

- Whole transmission chain analysis
  - Source
  - Source matching circuit
  - Complex load (appliance matching)

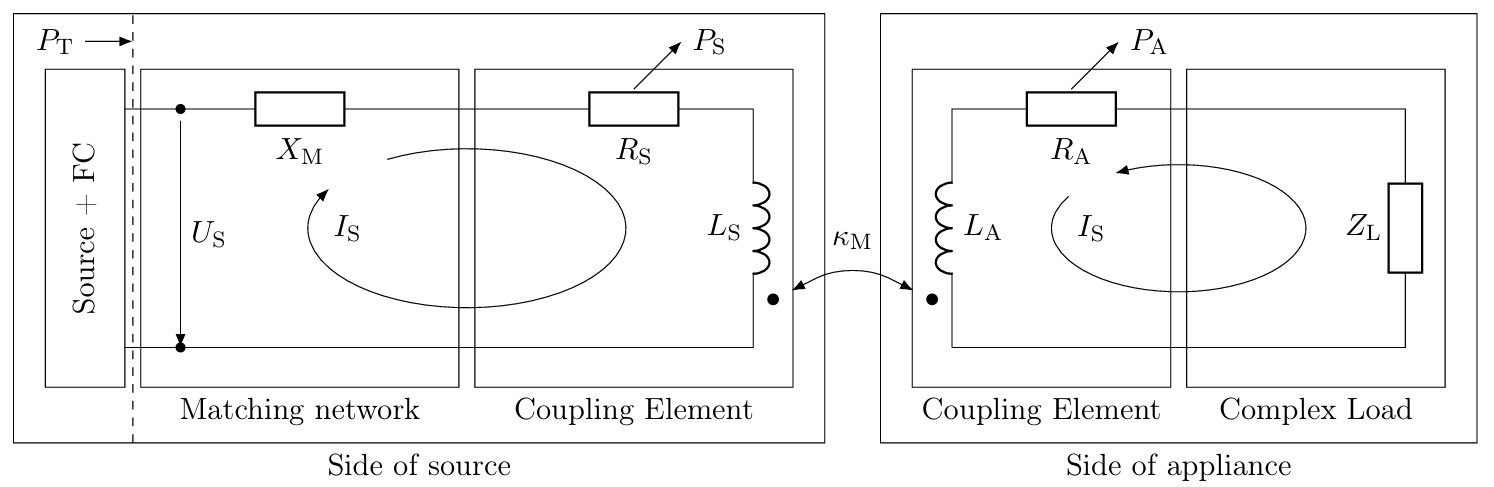
[picture p32: figure]

## ANSYS Simplorer circuit with ROM

- Reduced-order modelling
- RLGC-based dynamic description
- Embedding the model in a custom circuit
- Complex output variables tracking

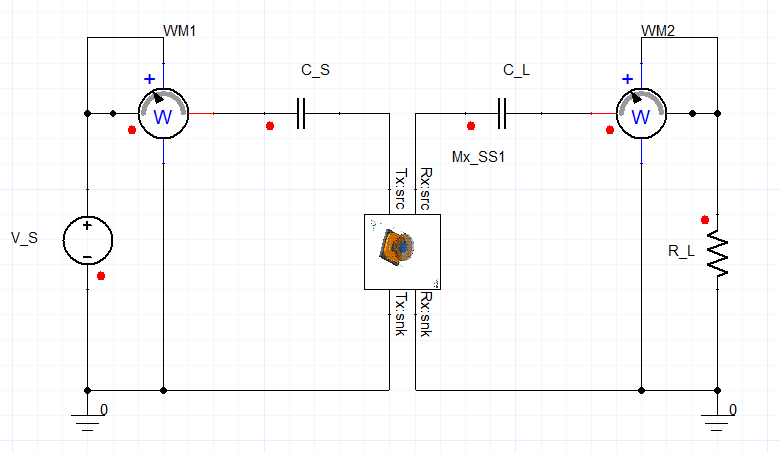
[picture p33: figure]

## Power balance

- Calculation of the matching circuit parameters [2]
- Maximization of efficiency
  - Load impedance
- Maximization of active power delivered
  - Source impedance

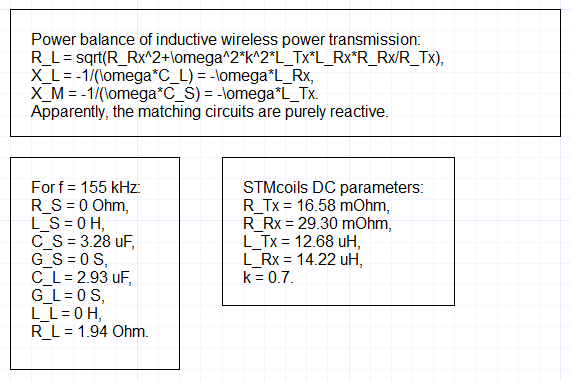
[picture p34: figure]

## Maximal efficiency

- Condition of maximal efficiency: (∂η)/(∂ξ_i)(R_L ,X_L )=(∂)/(∂ξ_i)[(P_L)/(P_S +P_A +P_L)](R_L ,X_L )=0.
- Circuit equations (Kirchhoff’s laws) yield the load parameters.
- R_L =√(R_(Rx) +ω^2 k^2 L_(Rx) L_(Tx) (R_(Rx))/(R_(Tx))).
- X_L =−X_(Rx) =−ωL_(Rx) is clearly capacitive.
- C_L =1/(ω^2 L_(Rx)).

## Maximal active power delivered

- Condition of maximal active power delivered: (∂P_L)/(∂X_S)=0.
- Circuit equations (Kirchhoff’s laws) yield the source parameters.
- Source matching is reactive ( R_S =0 Ω ).
- X_S =−X_(Tx) =−ωL_(Tx) is clearly capacitive.
- C_S =1/(ω^2 L_(Tx)).

## Simulation results – powers

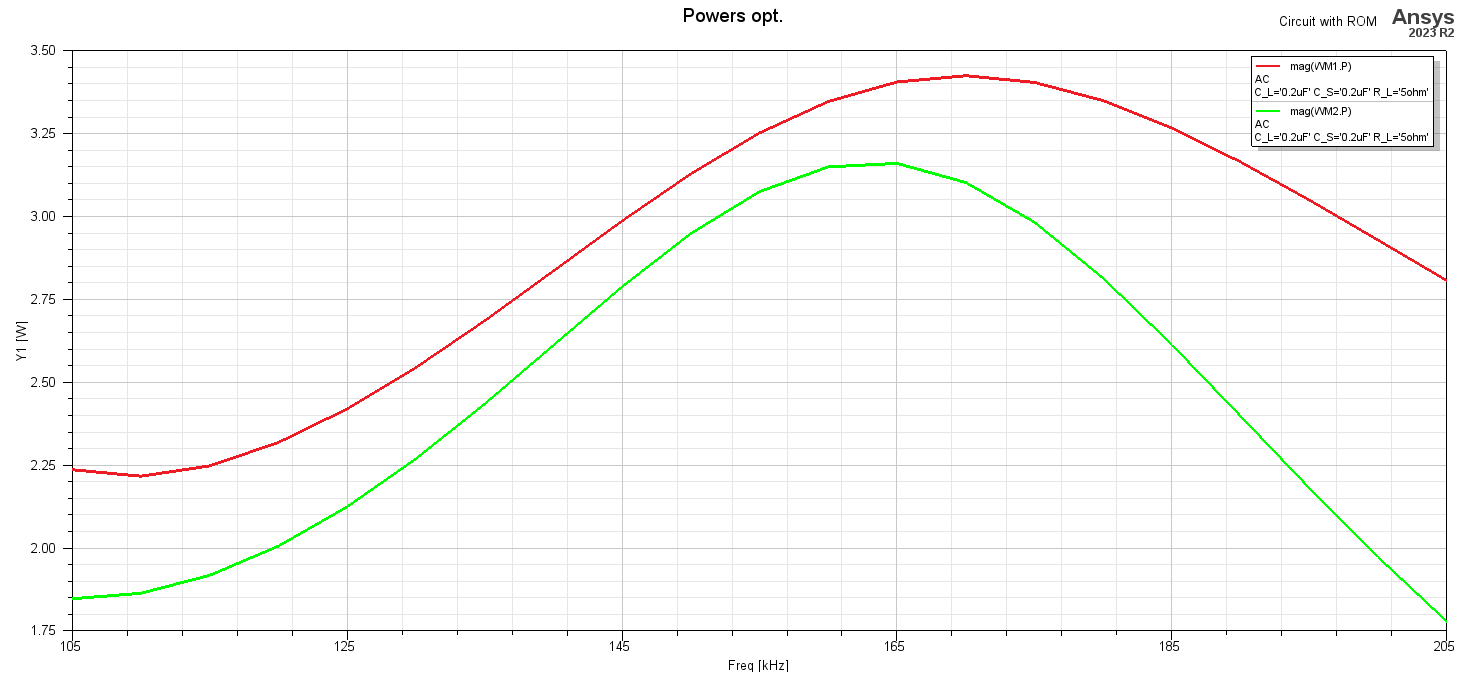
[picture p35: figure]

## Simulation results – transfer efficiency

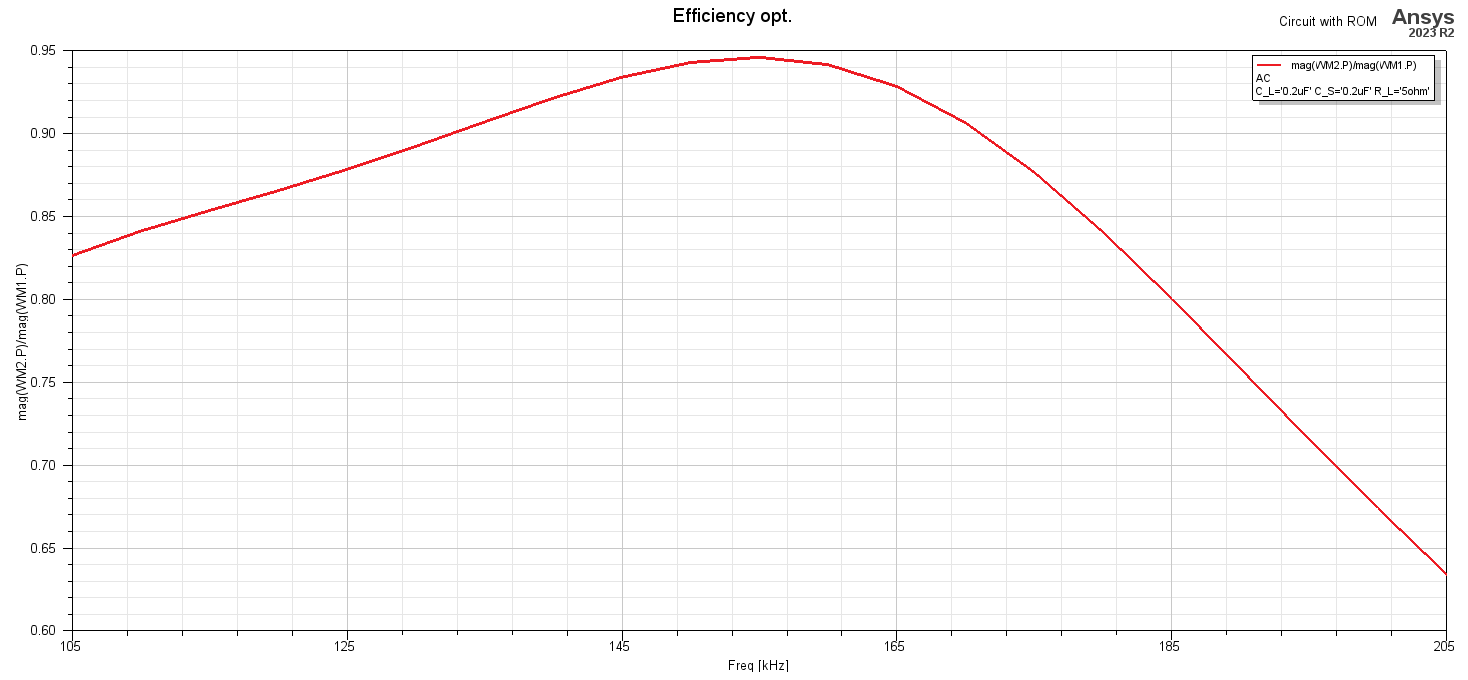
[picture p36: figure]

## Simulation results – tabular data

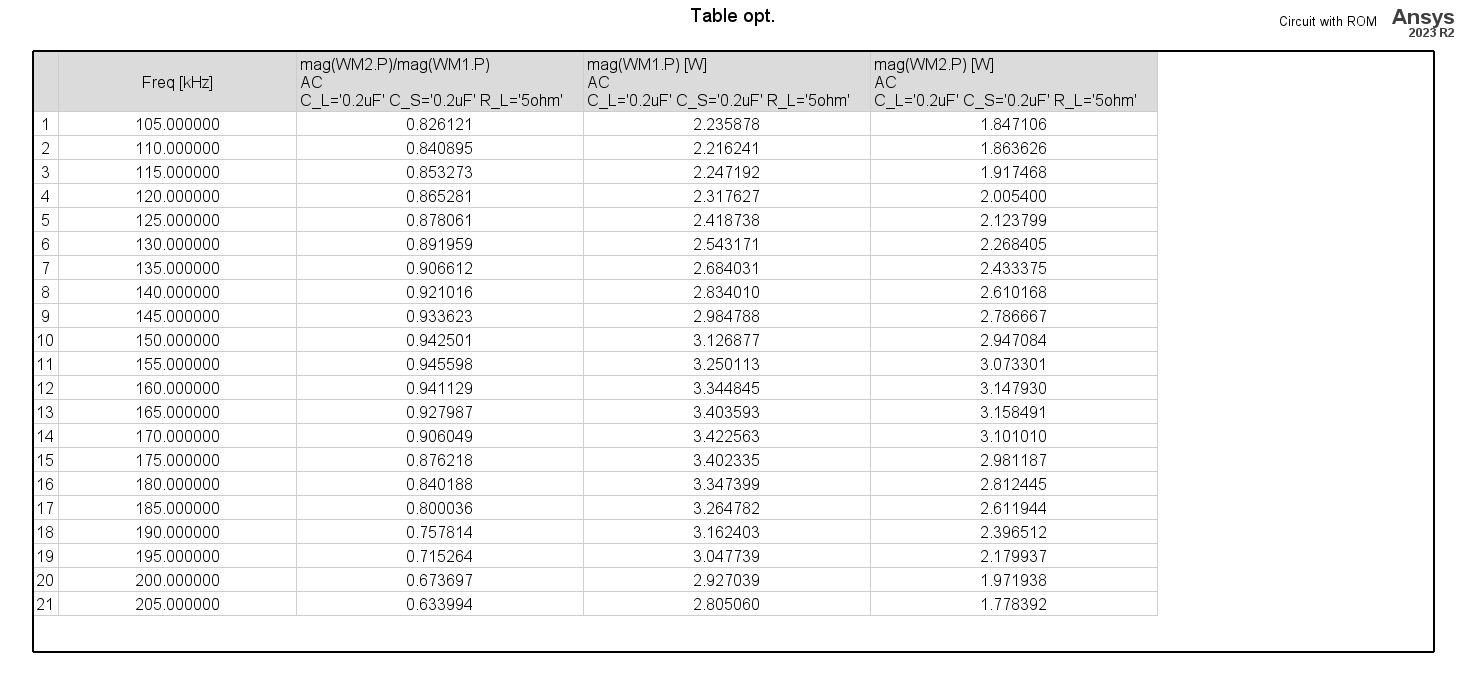
[picture p37: figure]

## Conclusion

- Increase of coupling in the new coil arrangement
- Ability to assess the transfer efficiency of the whole transmission chain
- Analytical guidelines for the selection of matching elements based on power balance
  - Confirmed within reasonable bounds
  - Slight tuning was necessary

## Thank you

for your attention

## References

[1] S. Hasegawa and H. Iwasaki, "Oval double spiral coil for high efficiency wireless power transmission," 2017 11th European Conference on Antennas and Propagation (EUCAP), Paris, France, 2017, pp. 496-499, doi: 10.23919/EuCAP.2017.7928055.
[2] J. Kraček and M. Mazánek, "Power balance of inductive wireless power transmission," Proceedings of the 5th European Conference on Antennas and Propagation (EUCAP), Rome, Italy, 2011, pp. 3974-3978.
