simakma5/diploma-thesis/progress-reports/05-progress_report.pptx

## Dual circularly polarized waveguide antenna

Waveguide polarizer design – broadband performance evaluation

## Outline

- Evaluation of polarization purity
  - Far field
  - Intrinsic
- CST Studio Suite results
- Post-processing
  - Port information
  - S-parameters
  - E-field probe
- Conclusion

Research progress report

## Evaluation of polarization purity – far field

- Assumes elliptical polarization
- Uses polarization components E_(major) and E_(minor) of the radiated waves
- Axial ratio AR=20log((E_(major))/(E_(minor))) [dB]
- Ideal circular polarization has E_(major) =E_(minor)
  - AR = 0 dB

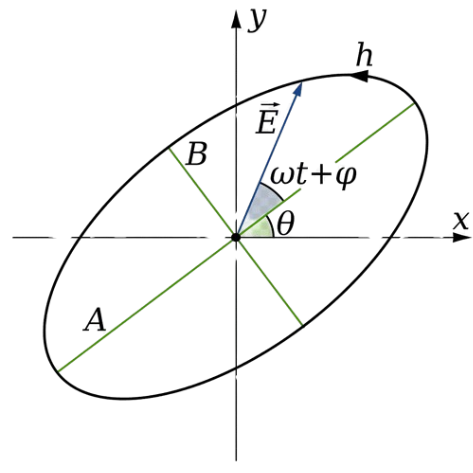
[picture p38: figure]

## Evaluation of polarization purity – intrinsic

- No assumptions
- Uses properties intrinsic to the waveguide polarizer
- Orthogonal modes TE01 and TE10 excited in the waveguide cavity
- Given by the polarizer physical dimensions

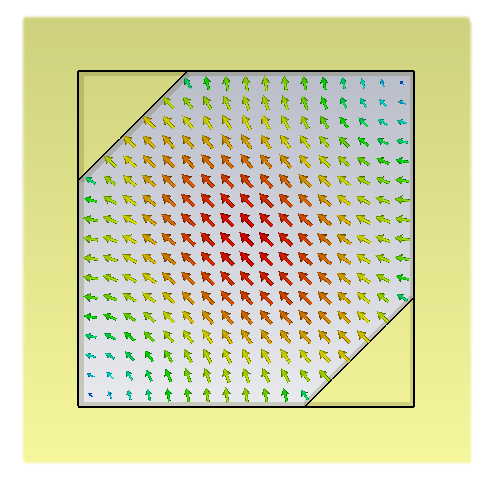
[picture p39: figure]
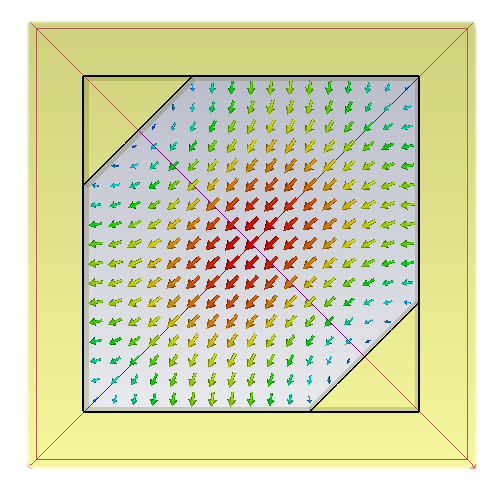
[picture p40: figure]

## Evaluation of polarization purity – intrinsic

1. Condition of polarization ellipticity (orthogonality)
  - Mode phase difference |∠E_2 −∠E_1 |=90°
2. Condition of polarization circularity (symmetry)
  - Mode amplitude ratio (|E_2 |)/(|E_1 |)=1
- Notation: E_1 and E_2 represent the E-field of modes 1 and 2, respectively.
- Axial ratio is an aggregate figure of intrinsic field properties

## CST Studio Suite results

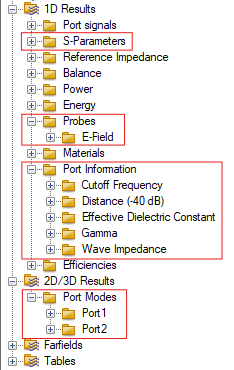
[picture p41: figure]

- No direct means of evaluating intrinsic properties
- Extracting the properties from existing results:
  - Port information/Gamma
  - Port modes
  - S-parameters
  - E-field probe
- Axial ratio evaluated using a predefined macro

## Post-processing – port information

- Mode phase difference
  - |∠E_2 −∠E_1 |=|Im(γ_2 )−Im(γ_1 )|⋅L
  - L as the waveguide length
  - γ_i from Port Information/Gamma
- Mode amplitude ratio
  - |E_i |=max⁡(|E_i (x,y,z=L)|)
  - E_i (x,y,z) from Port Modes
- Advantages: very accurate, direct results by CST
- Disadvantages: single-frequency results

## Post-processing – port information (phase)

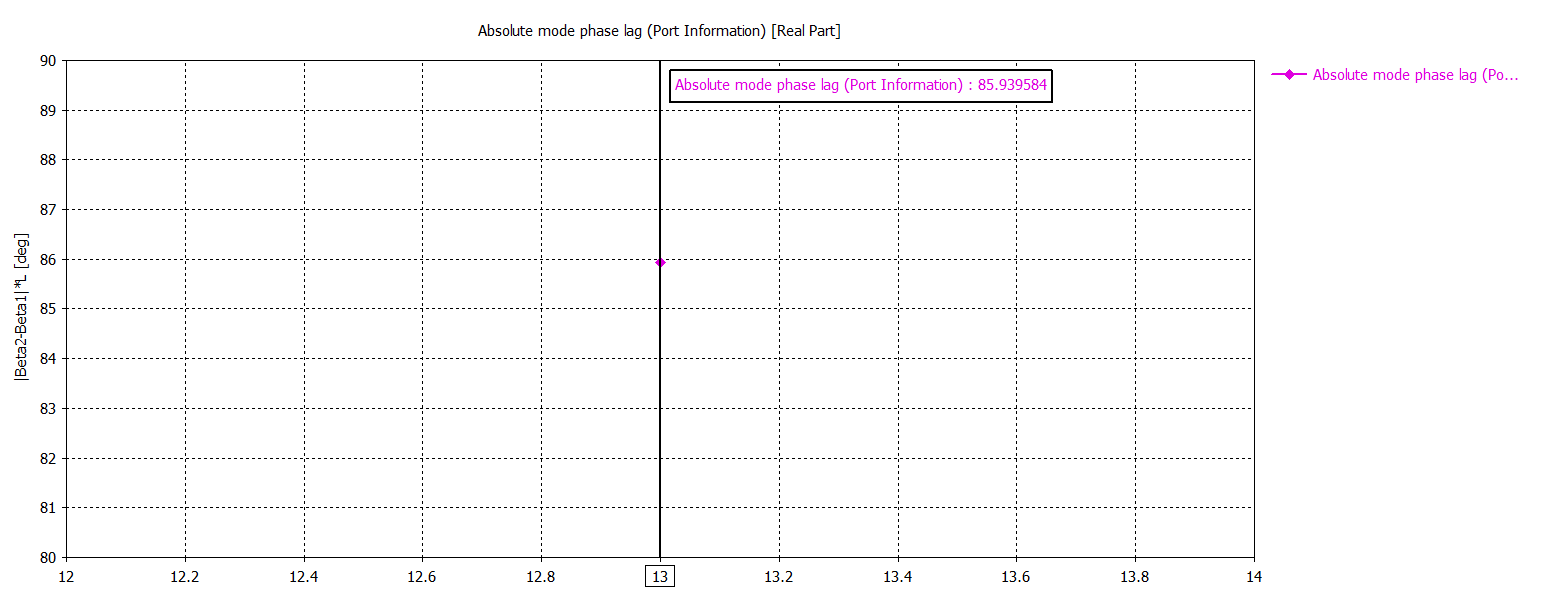
[picture p42: figure]

## Post-processing – port information (amplitude)

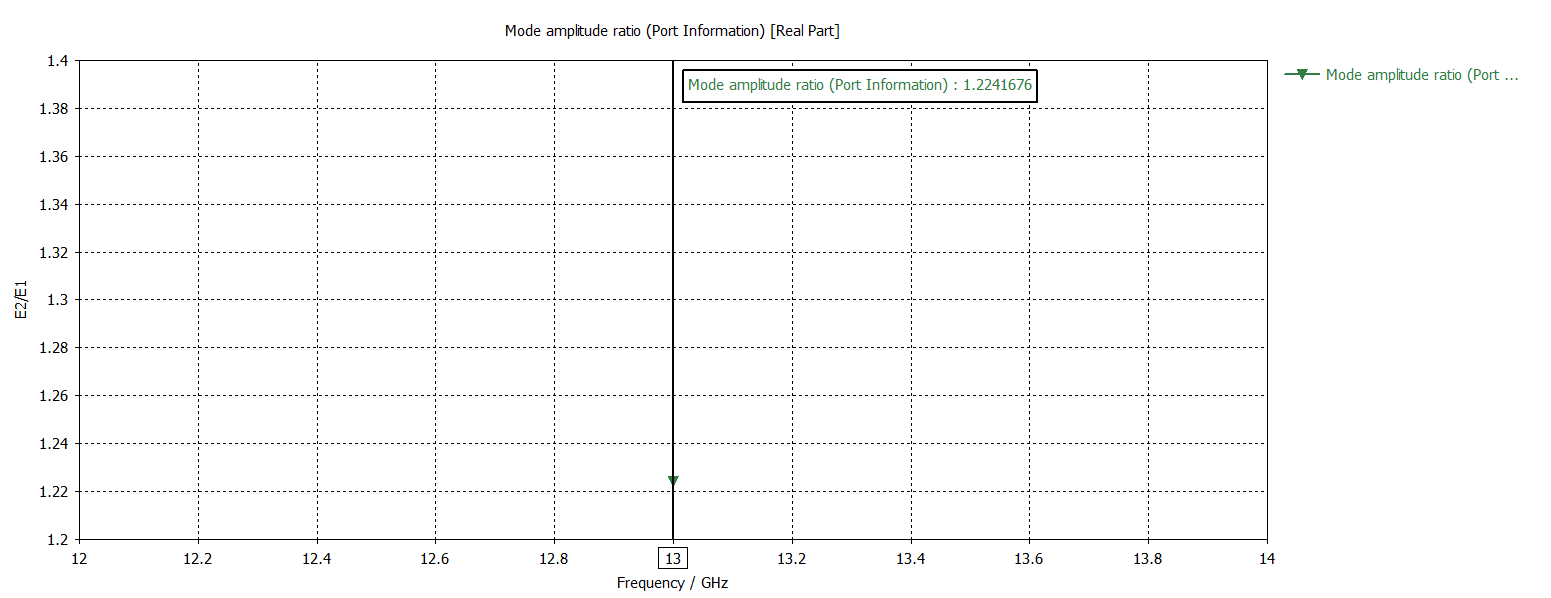
[picture p43: figure]

## Post-processing – S-parameters

- Mode phase difference
  - Guided wave description E(x,y,z,t)=E_0 (x,y)exp⁡(−i(kz−ωt))
  - Transmission S-parameter S_21 =(|E(x,y,L,t)|)/(|E(x,y,0,t)|)=(E_0 (x,y)exp⁡(−i(kL−ωt)))/(E_0 (x,y)exp⁡(iωt))=exp⁡(−ikL)
  - Assuming low loss, attenuation constant α→0 , propagation constant k→iβ
  - Therefore ∠S_21 =βL and |∠E_2 −∠E_1 |=|∠S_(21,2) −∠S_(21,1) |
- Mode amplitude ratio
  - Undefined
- Advantages: analytically straightforward phase extraction
- Disadvantages: impossibility of amplitude extraction

## Post-processing – S-parameters (phase)

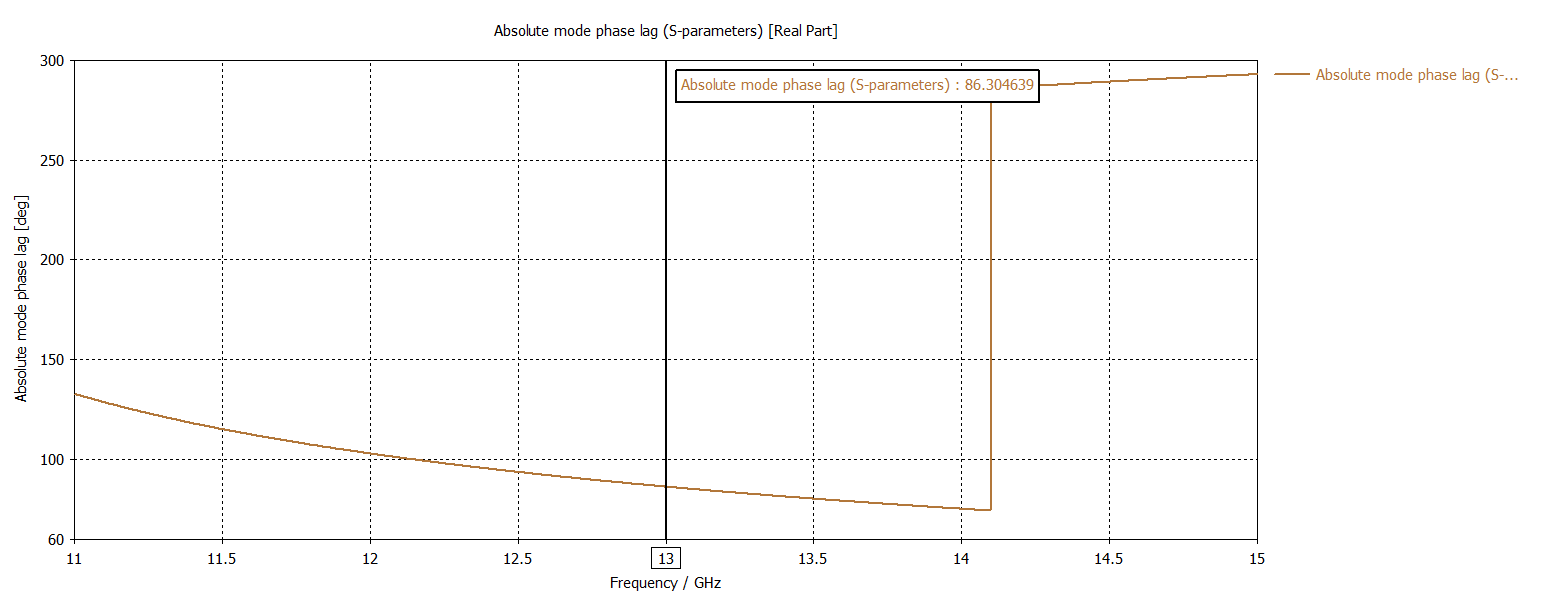
[picture p44: figure]

## Post-processing – E-field probe

- CST supports defining E-field probes on a given plane
  - Probes yield transient field values ( x , y , z components and magnitude)
  - Specifying plane z=L , i.e., the polarizer output, gives the necessary results
- Mode phase difference
  - Combination of direct results
- Mode amplitude ratio
  - Combination of direct results
- Advantages: close to direct extraction
- Disadvantages: none so far

## Post-processing – E-field probe (phase)

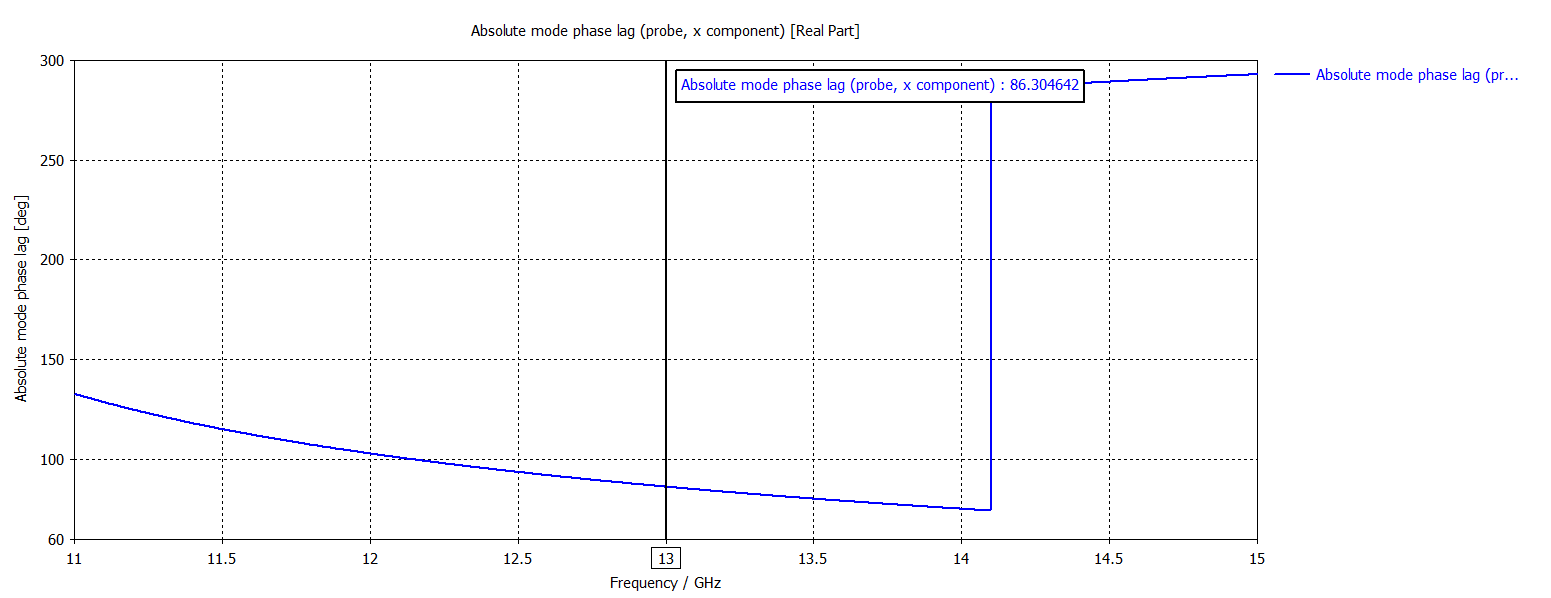
[picture p45: figure]

## Post-processing – E-field probe (amplitude)

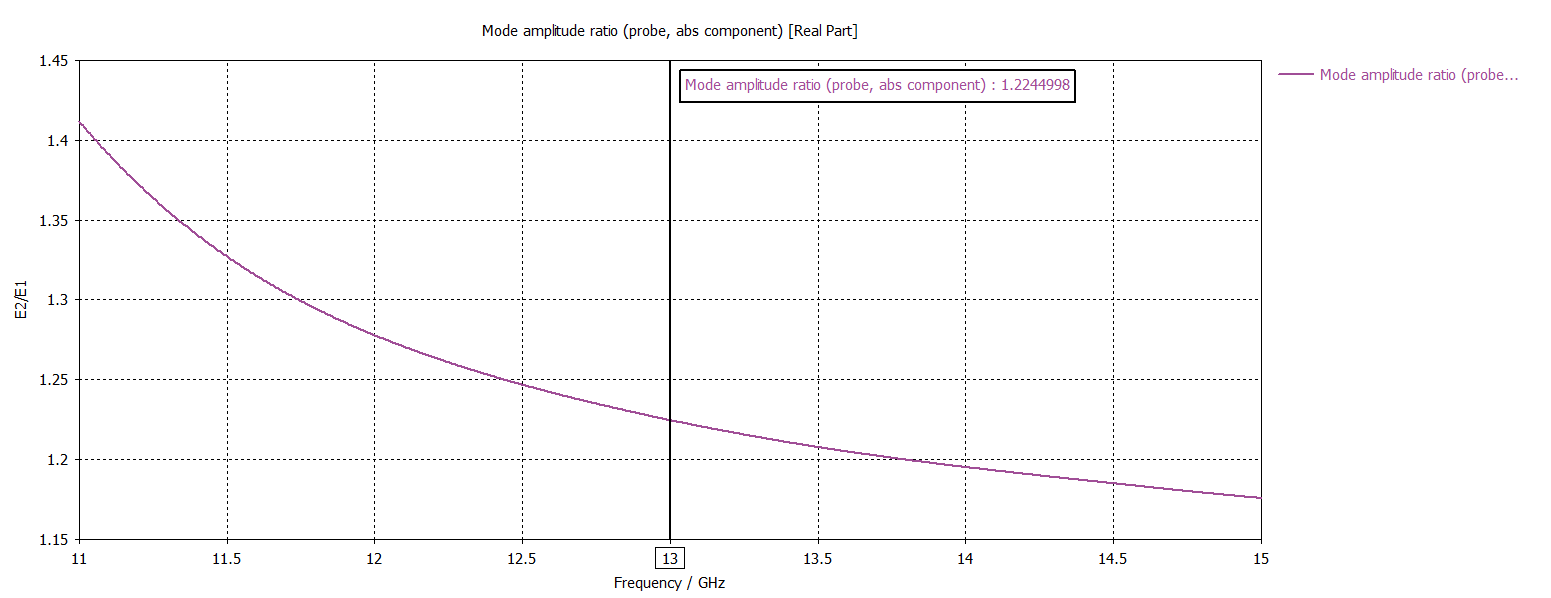
[picture p46: figure]

## Conclusion

- Extraction of intrinsic properties is possible using post-processing
- Port information provide reference results for a single frequency point
- S-parameters serves as a broadband verification of phase extraction
- E-field probe is the candidate for main extraction method
- Axial ratio will be easily evaluated in later stages of the design

## Thank you

for your attention
