simakma5/diploma-thesis/progress-reports/07-progress_report.pptx

## Dual circularly polarized waveguide antenna

Radiation part & Coaxial feeding structure

## Outline

- Introduction
- Part 1: Radiation part
- Part 2: Coaxial feeding structure
  - Single feed
  - Dual feed
- Prototype fabrication
- Conclusion

Research progress report

## Introduction

- Polarizer finished
- Radiation part almost finished
  - Open-ended waveguide radiation
  - Conical horn to be done
- Dual polarization feed in progress

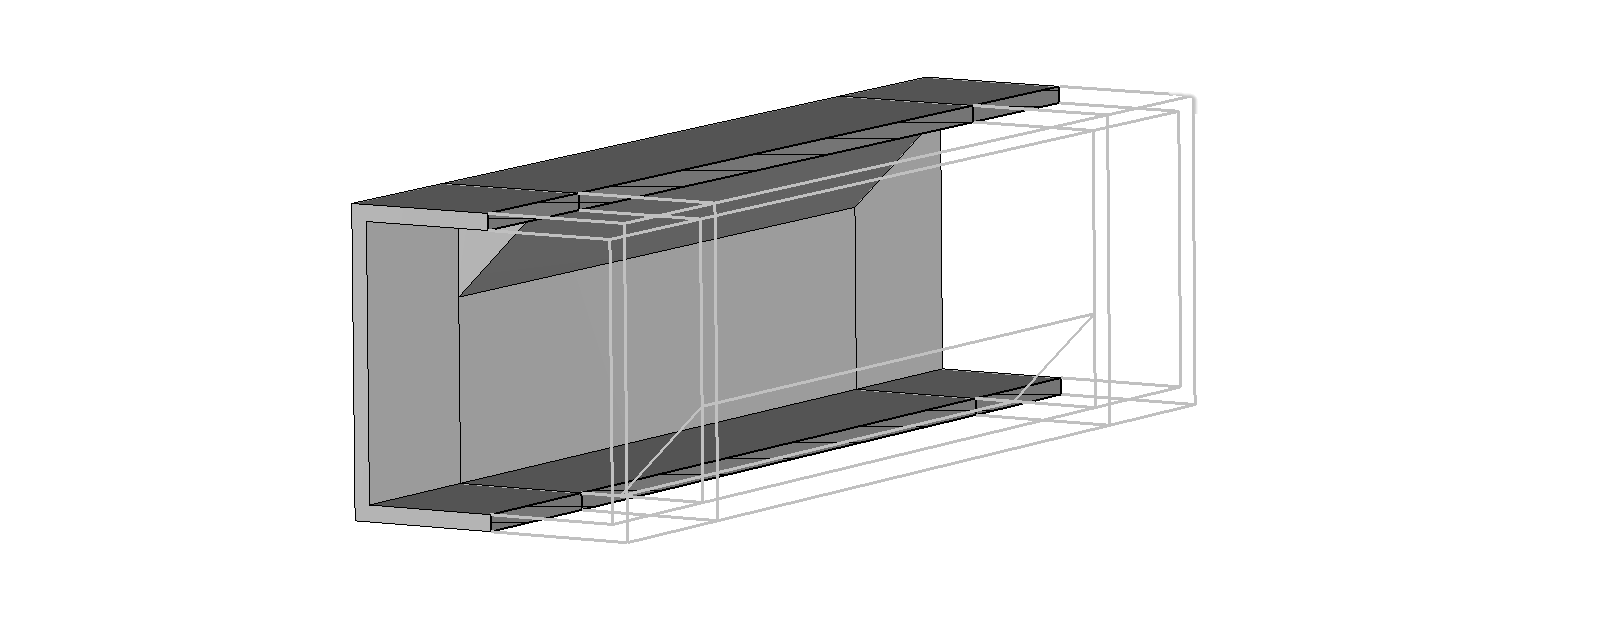
[picture p47: figure]

## Part 1

Radiation part

## Open-ended waveguide radiation

- Polarizer design in done for now
  - Good performance in terms of intrinsic figures of merit (eigenmode analysis)
- Section of a square waveguide added at the output to improve the radiation properties
  - Now evaluated using far-field properties (co-/cross-polarizations)

## Mode 1 co-polarization (RHCP) pattern

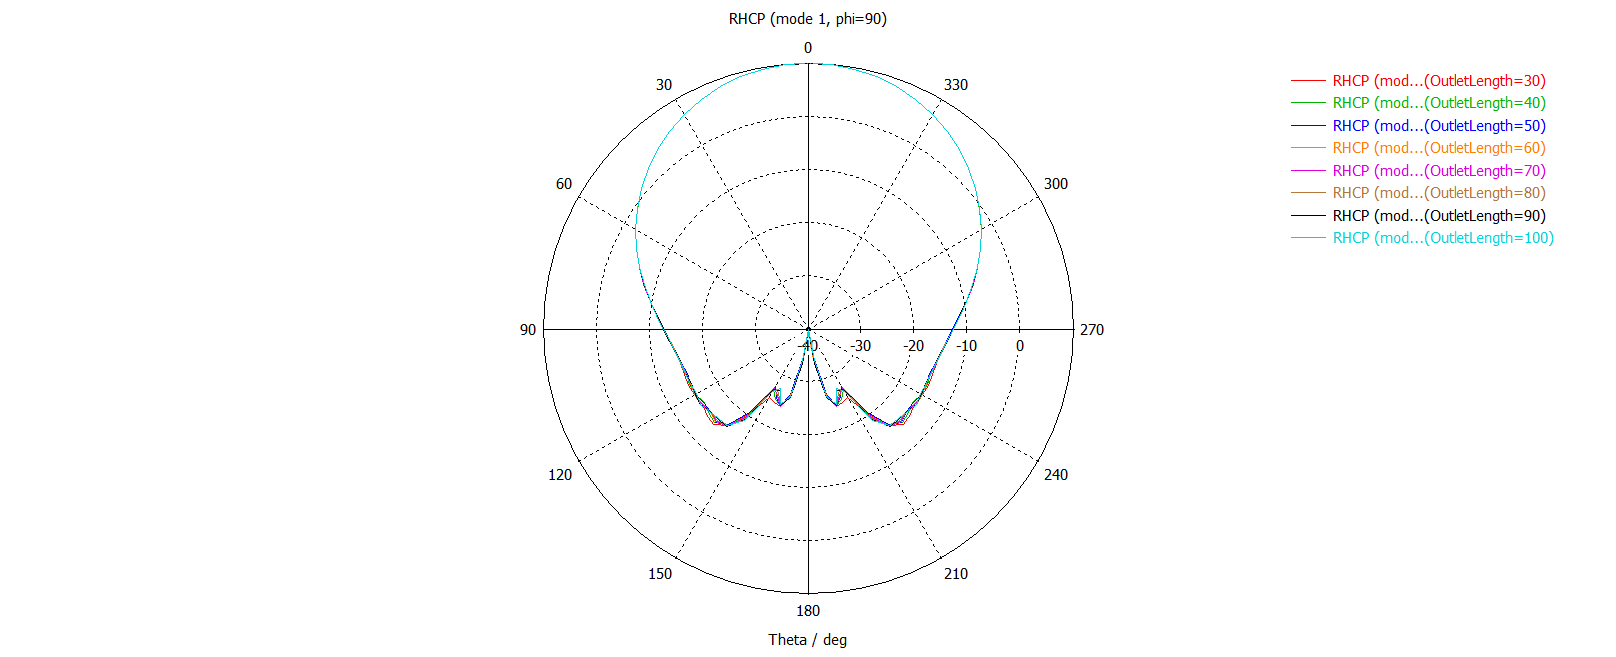
[picture p48: figure]

## Mode 1 cross-polarization (LHCP) pattern

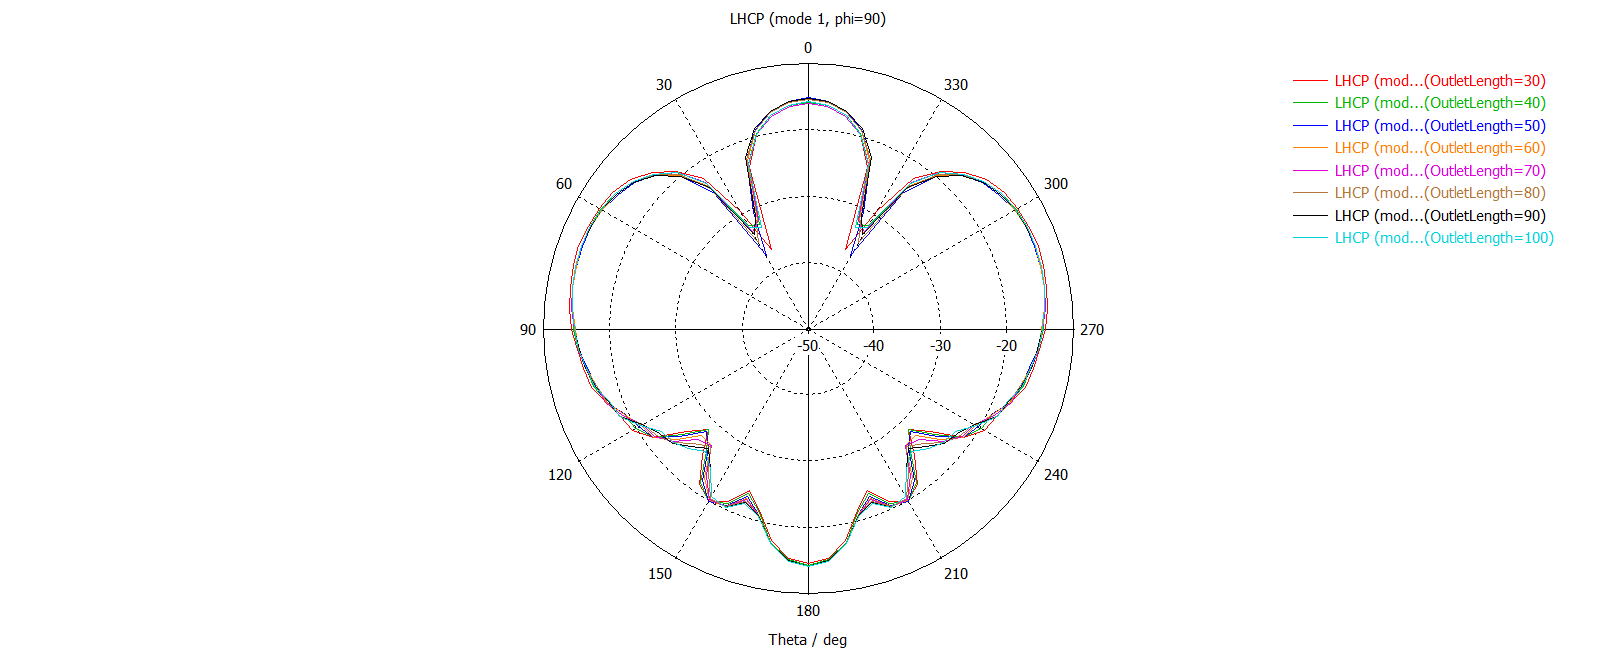
[picture p49: figure]

## Mode 1 axial ratio

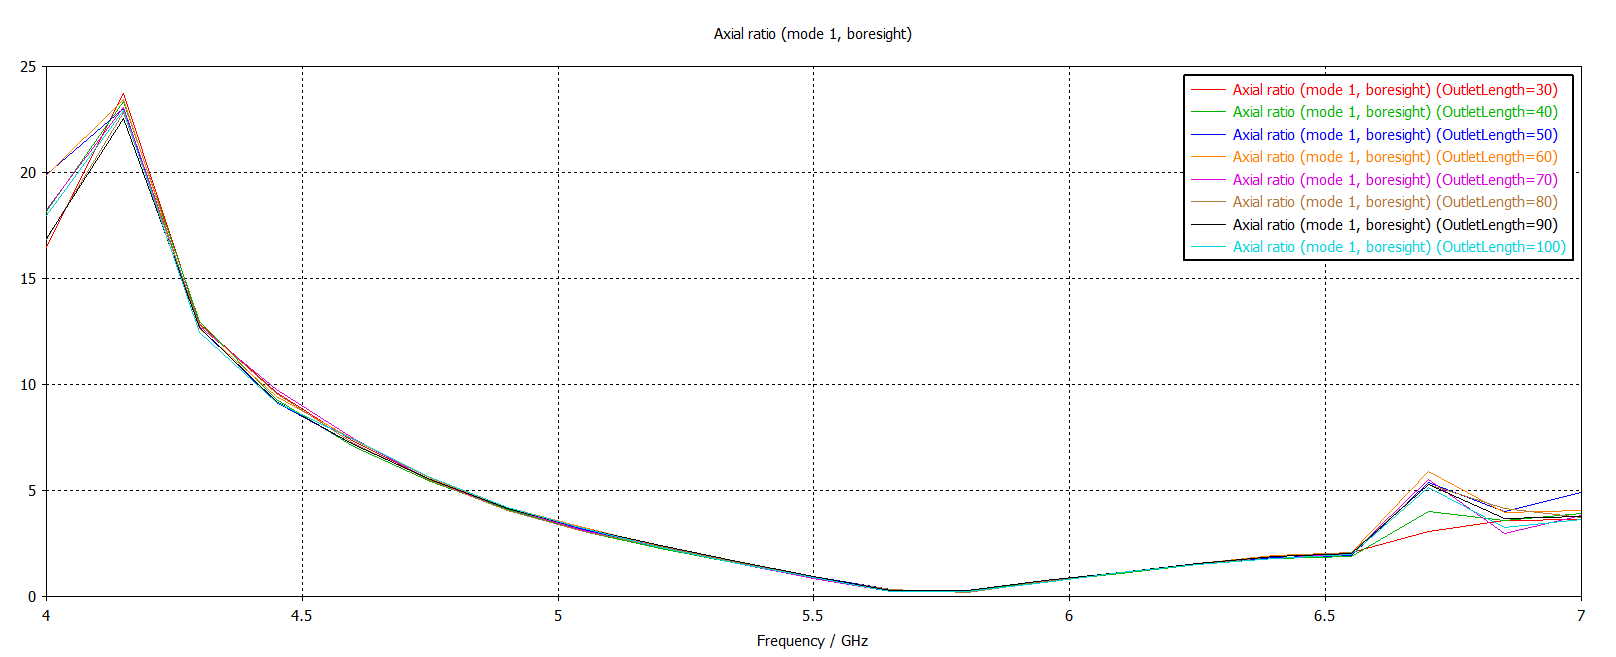
[picture p50: figure]

## Mode 2 co-polarization (LHCP) pattern

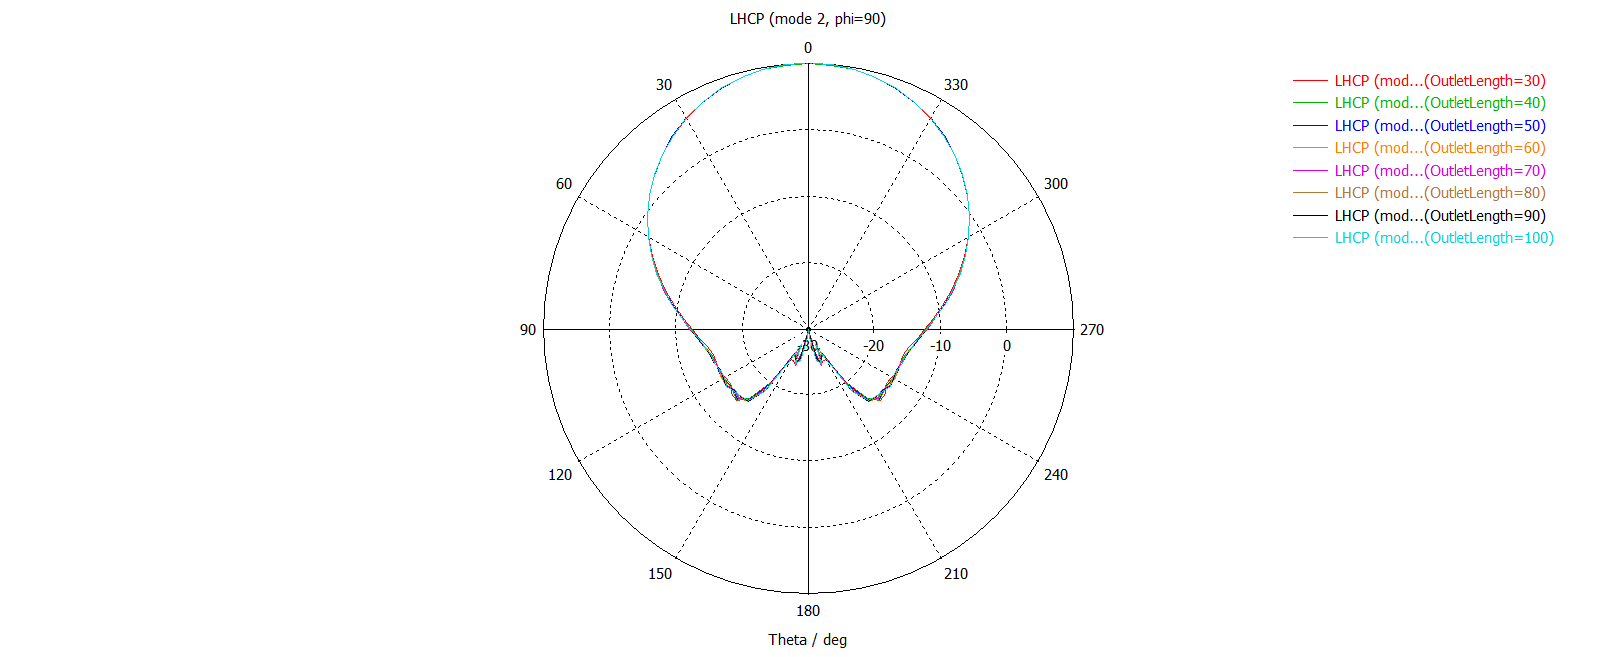
[picture p51: figure]

## Mode 2 cross-polarization (RHCP) pattern

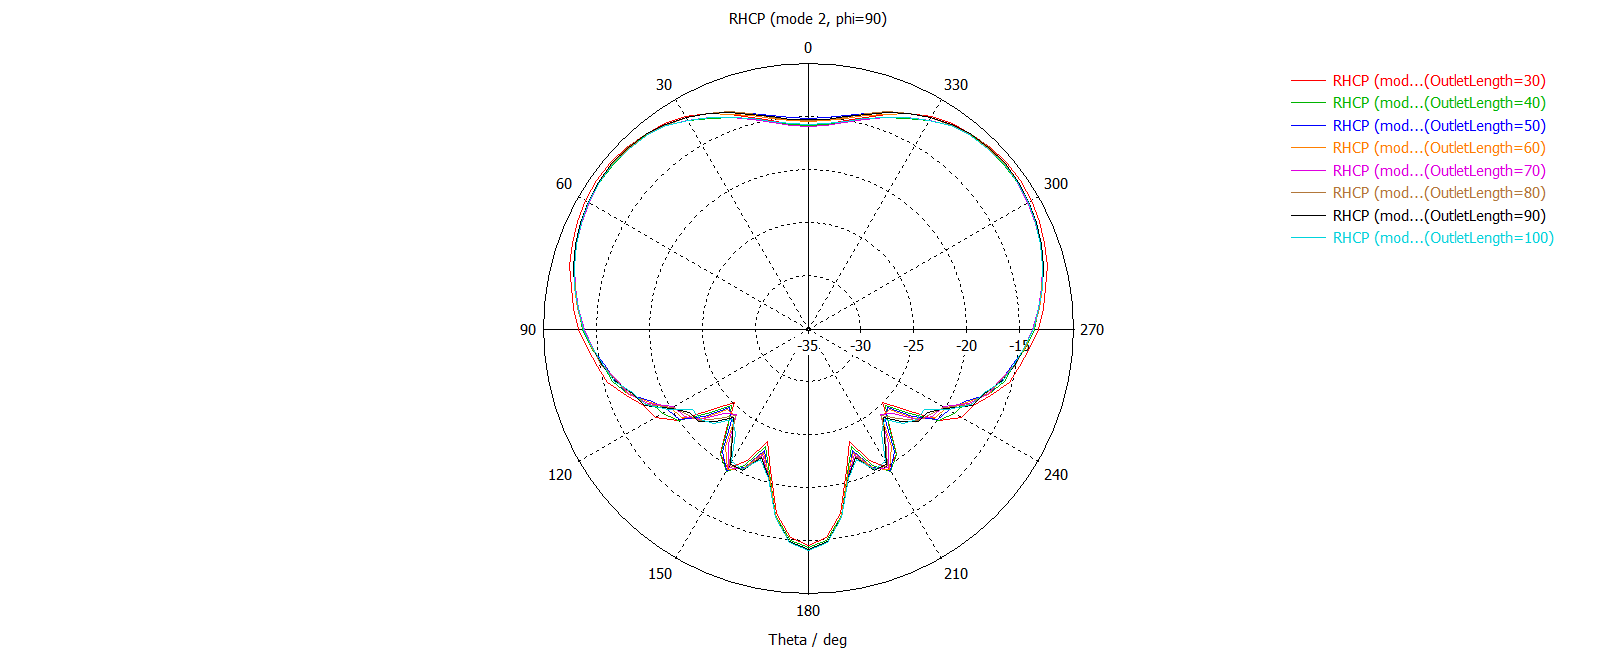
[picture p52: figure]

## Mode 2 axial ratio

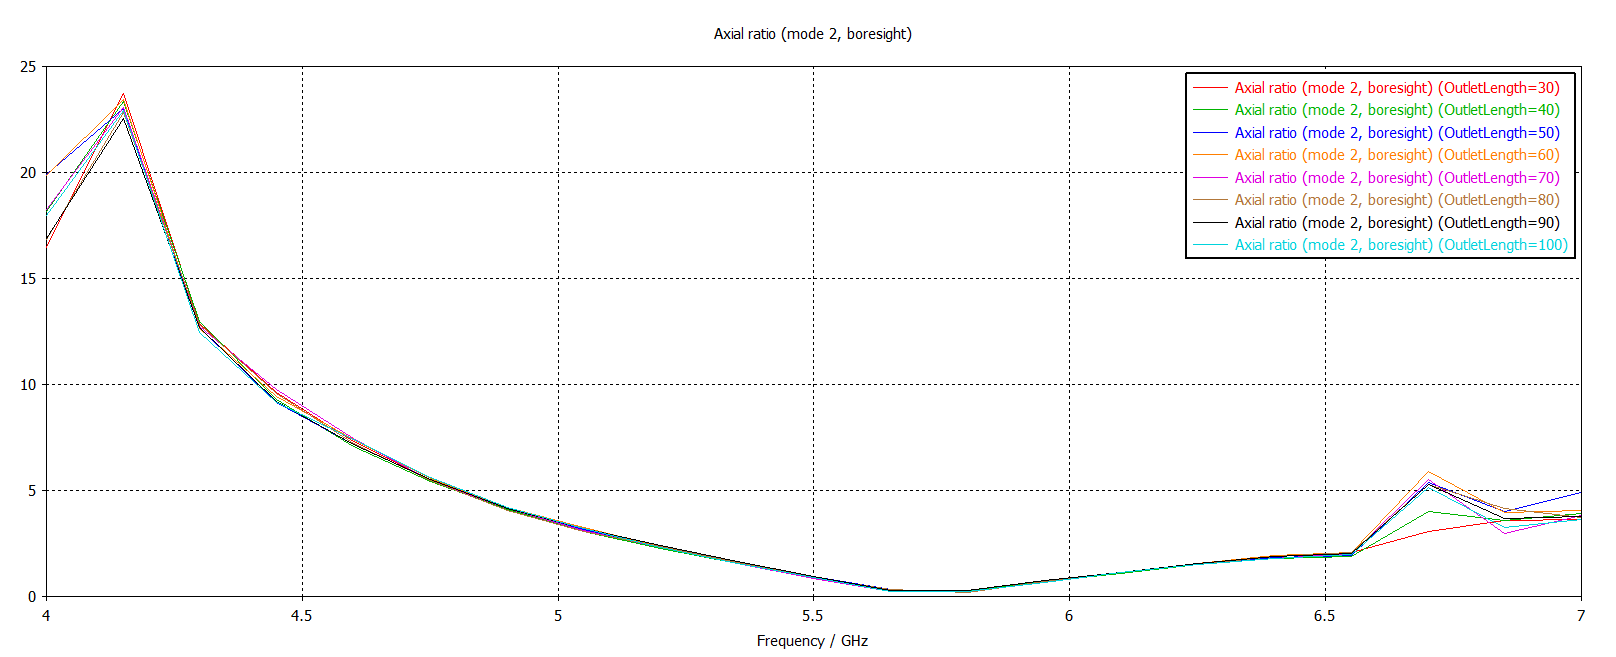
[picture p53: figure]

## Part 2

Coaxial feeding structure

## Single feed: right-angle transition

- Coax inner conductor reaches into the cavity serving as an antenna
- Antenna probe excites TE01 mode
- Back-short reflects energy
- In-phase wave combination at probe
- Electric field propagates

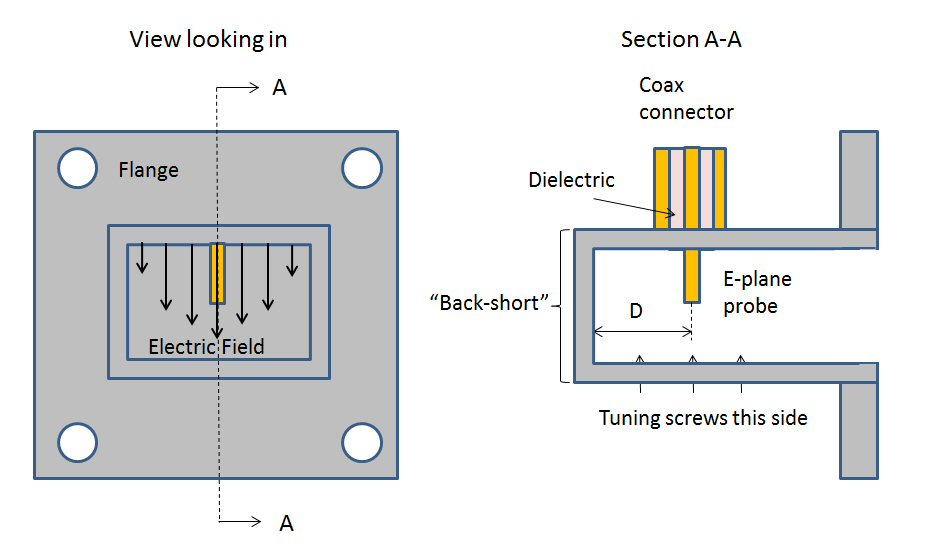
[picture p54: figure]

## Single feed: variables

- Length of the antenna probe
  - Usually ≈3λ_g /16
- Distance from the back-short
  - Usually ≈λ_0 /4
Guide wavelength
λ_g =(λ_0)/(√(1−((λ_0)/(λ_(cutoff)))^2)) ≈54.51 mm @ 5.5 GHz

## Single feed: implementation

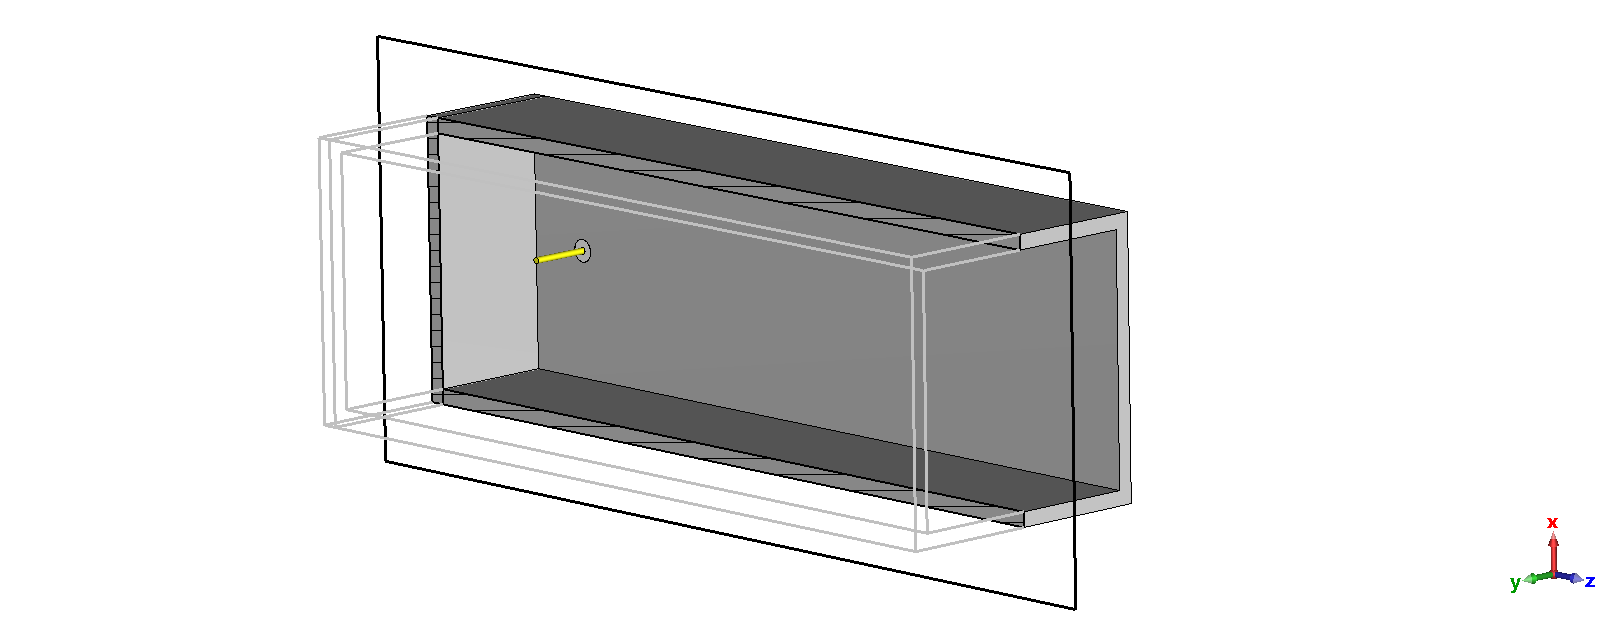
[picture p55: figure]

## Reflection

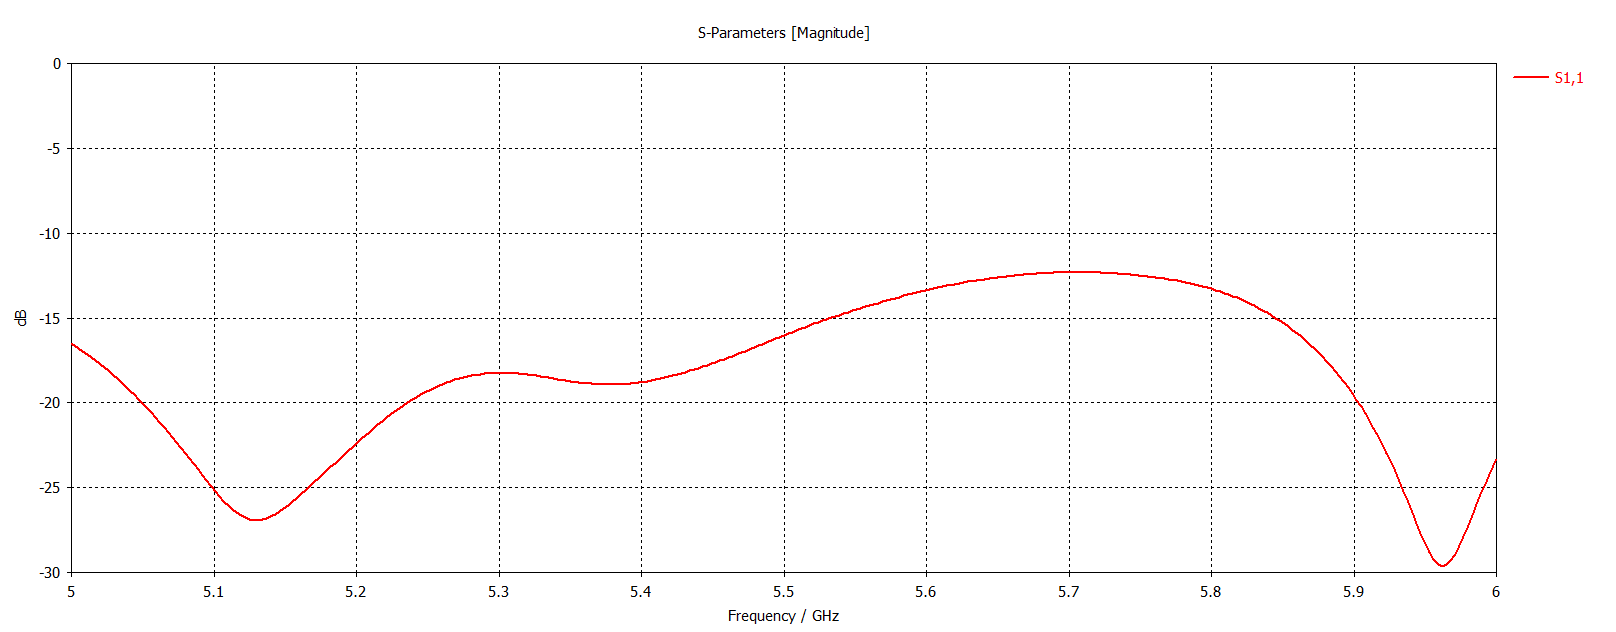
[picture p56: figure]

## Radiation pattern

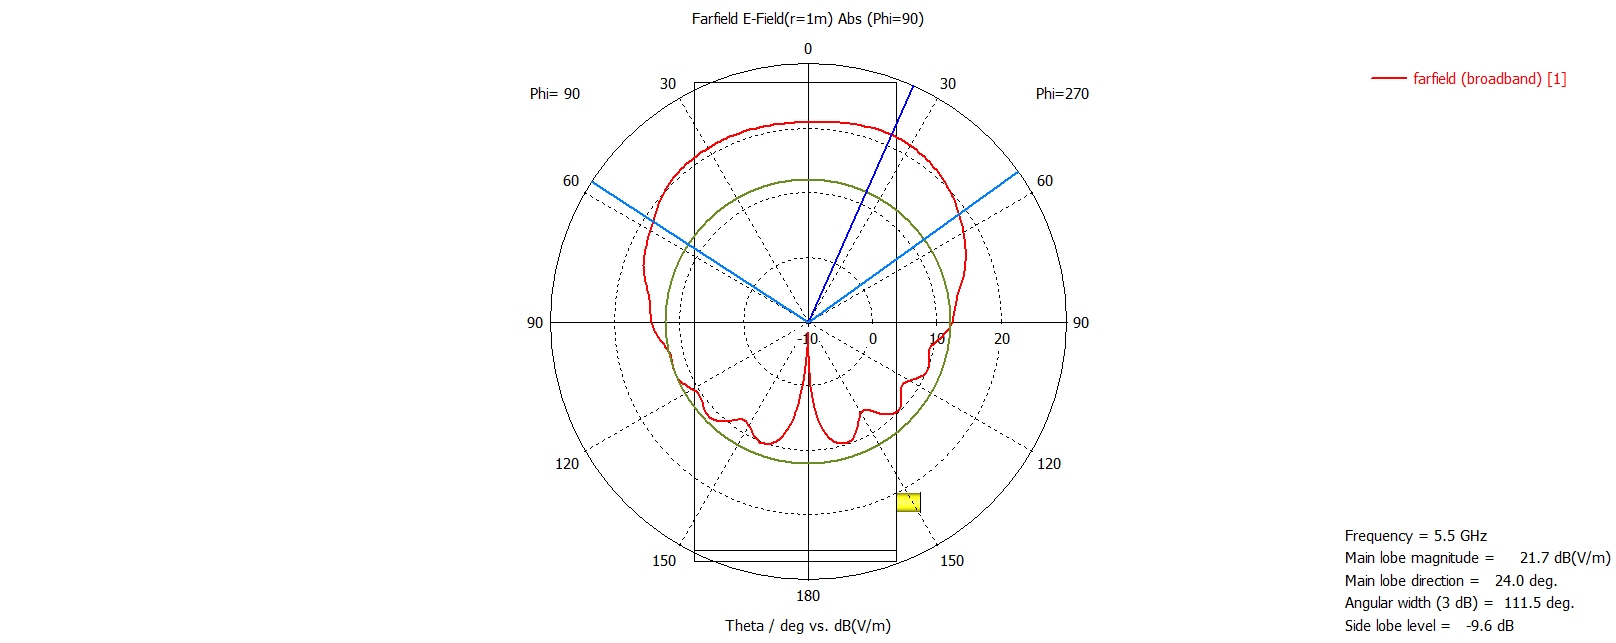
[picture p57: figure]

## Dual feed: idea [1]

- Same principal as the single feed
- Two orthogonal probes separated by distance
- Port 2 back-short replaced by a grating parallel to the probe
  - Grating ideally transparent to port 1 while shorting port 2
  - Helps minimize crosstalk

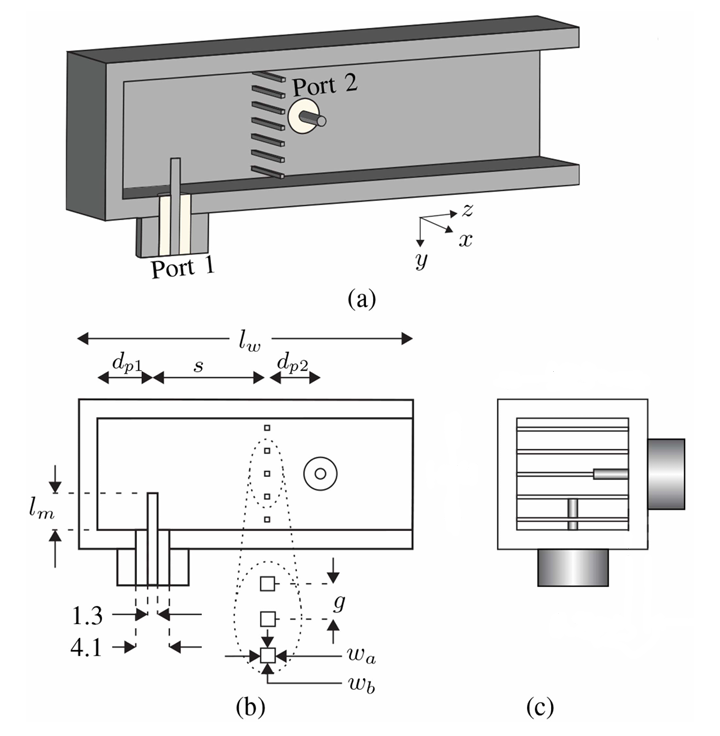
[picture p58: figure]

## Dual feed: variables

- Length of both antenna probes
- Distance of port 1 from the back-short
- Distance of the grating from port 1
- Distance of port 2 from the grating
- Diameter of the grating wires
- Gap (distance) between the grating wires
- Number of grating wires

## Dual feed: implementation

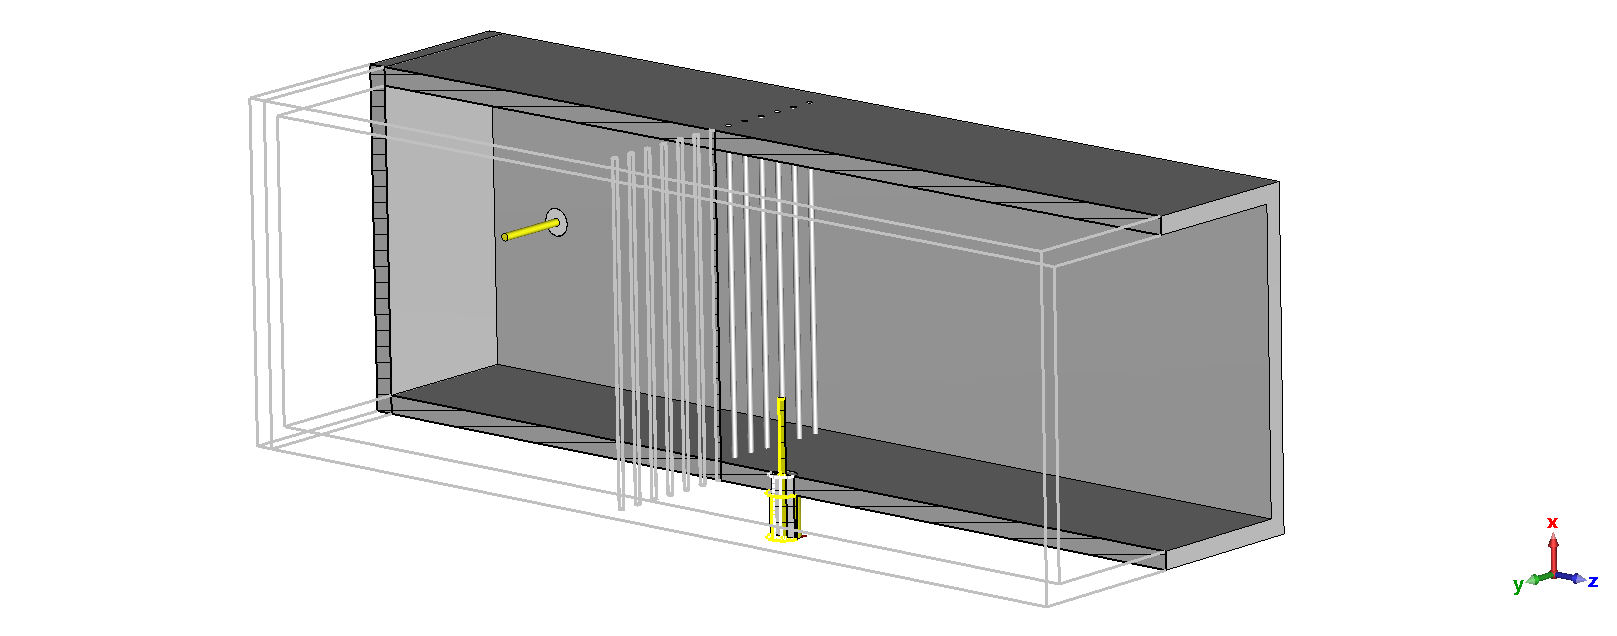
[picture p59: figure]

## Port 1 reflection

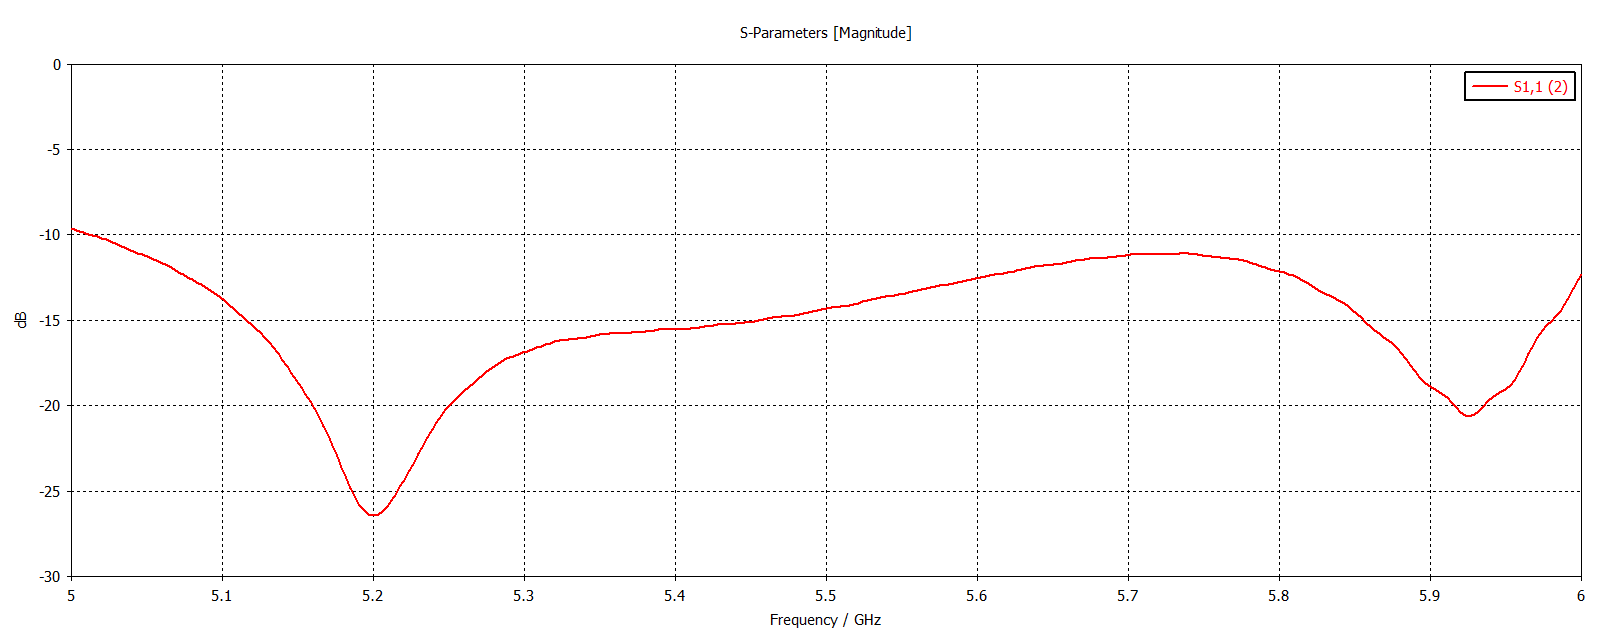
[picture p60: figure]

## Port 1 radiation pattern

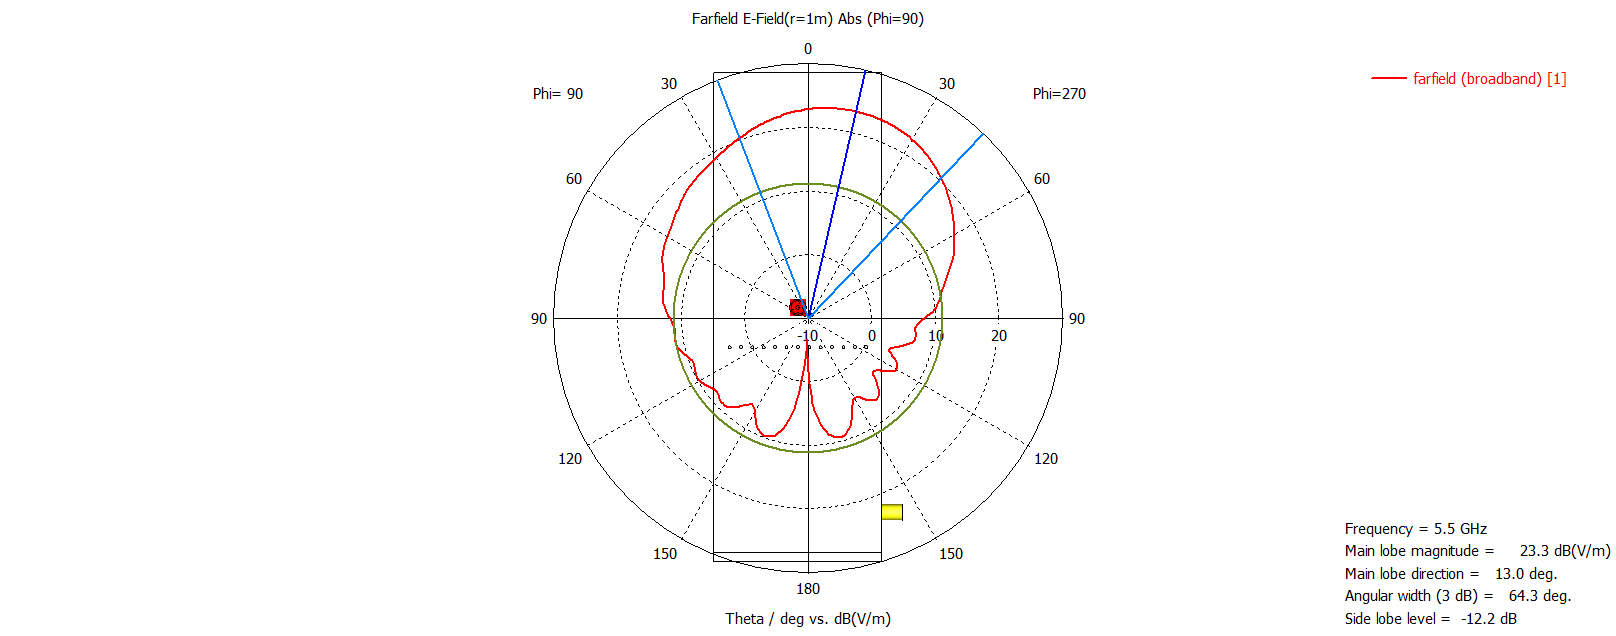
[picture p61: figure]

## Port 2 reflection

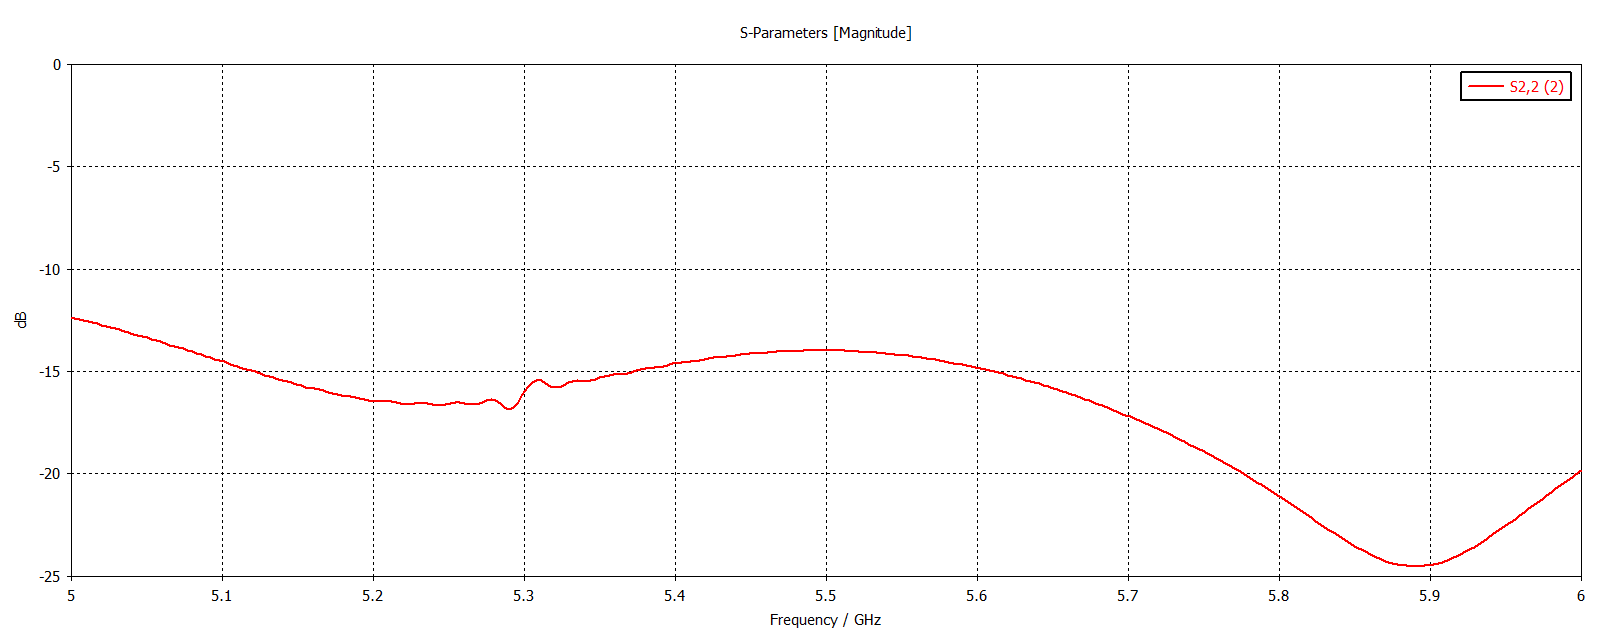
[picture p62: figure]

## Port 2 radiation pattern

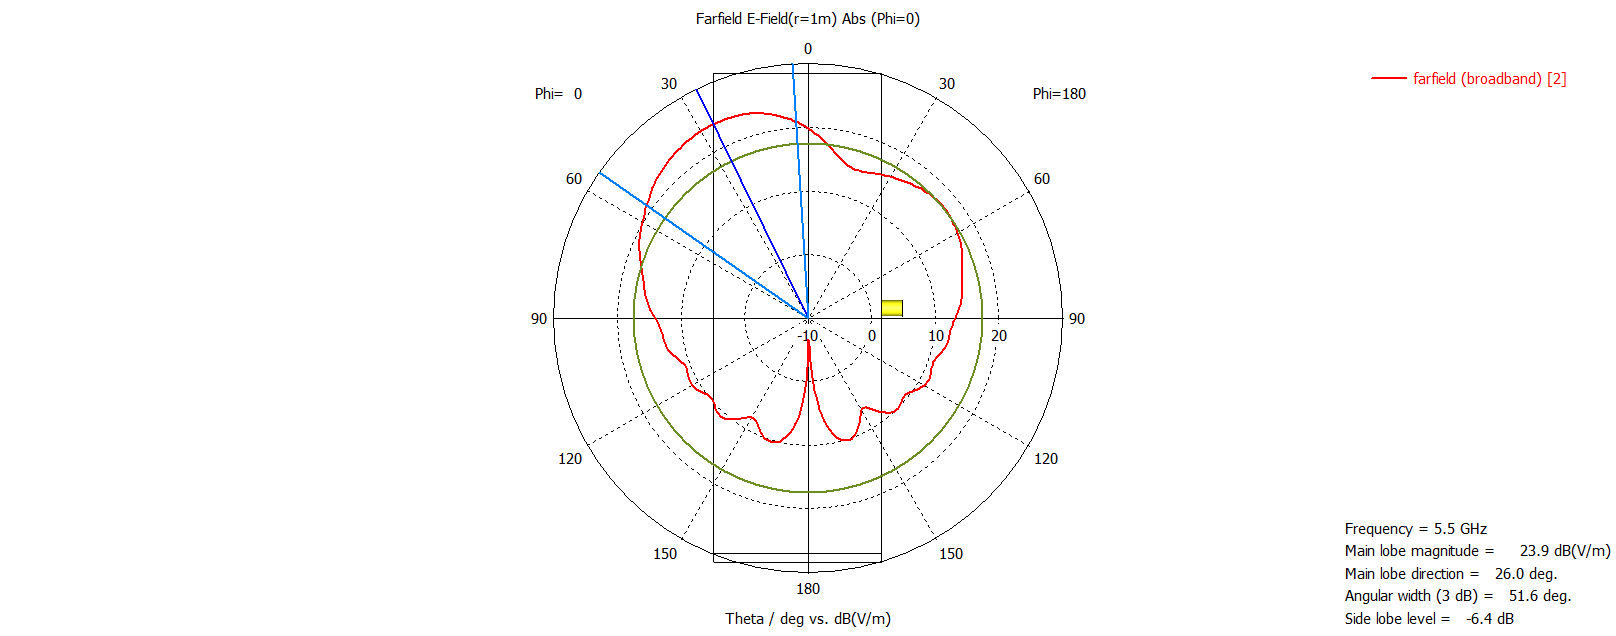
[picture p63: figure]

## Port crosstalk

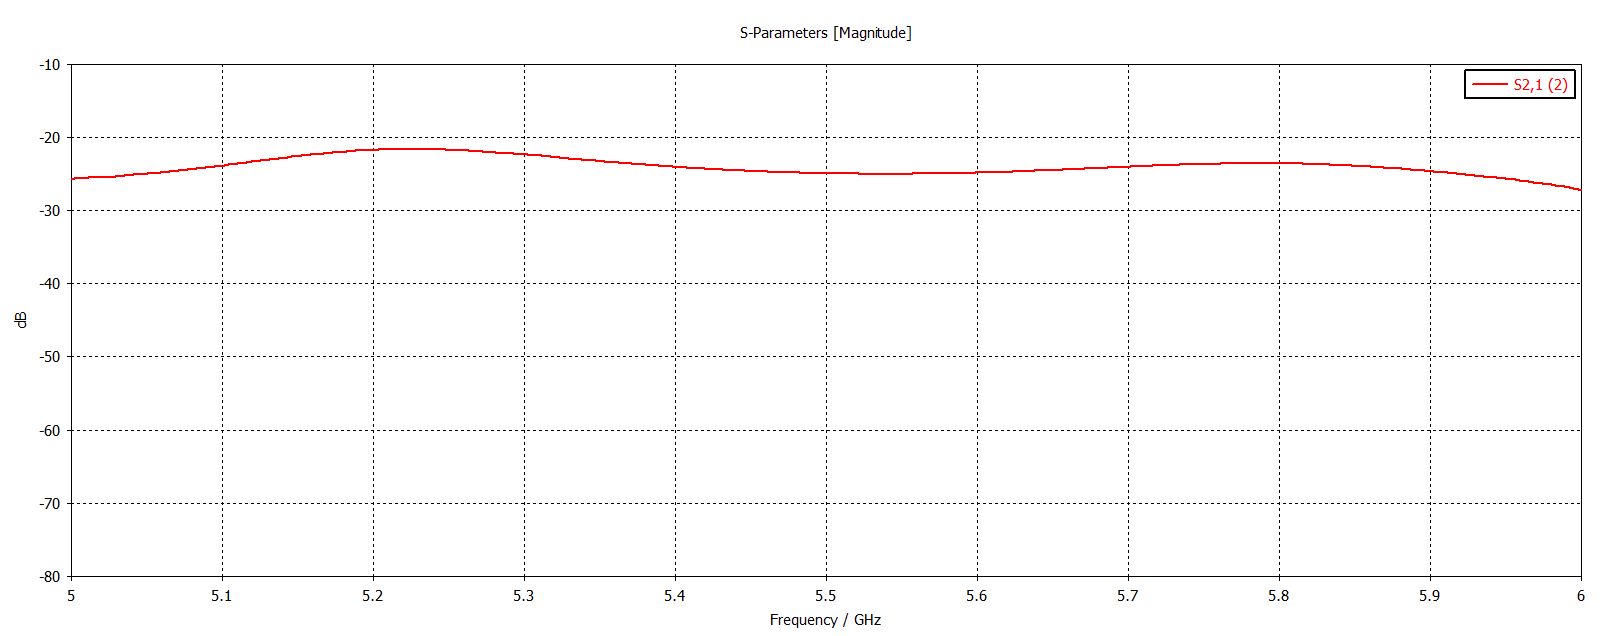
[picture p64: figure]

## Prototype fabrication

- Prototyping
  - Polarizer and radiation part are almost done
  - Feeding issues due the use of a non-standard waveguide
  - Optimizing the dual feed is the tricky
- Idea: fabrication by parts with flanges
  - Conical horn, polarizer, and adapter
  - Single feed for the prototype measurement
  - Possibility to test both polarizations by rotating the adapter
  - Dual feed can be fabricated later

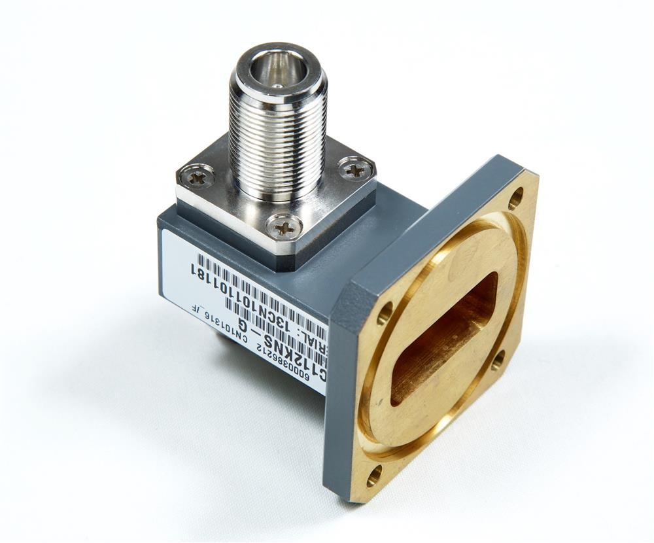
[picture p65: figure]
C137CNSG Waveguide Flange 5.85-8.2 GHz CPR137G to N-Female Transistion, MFR: Commscope

## Conclusion

Radiation part
- Open-ended waveguide radiation looks good
- Now only to add a conical horn
- Almost done
Dual feed
- First simulations done
- Very tricky
- Needs a lot of optimization work

## Thank you

for your attention

## References

1. S. K. Karki, J. Ala-Laurinaho and V. Viikari, "Dual-Polarized Probe for Planar Near-Field Measurement," in IEEE Antennas and Wireless Propagation Letters, vol. 22, no. 3, pp. 576-580, March 2023, doi: 10.1109/LAWP.2022.3218731
Pictures
- Microwaves101 | Waveguide to coax transitions (https://www.microwaves101.com/encyclopedias/waveguide-to-coax-transitions?jtpl=12)
- C137CNSG Waveguide Flange 5.85-8.2 GHz CPR137G to N-Female (https://www.rfparts.com/c137cnsg.html)Transistion (https://www.rfparts.com/c137cnsg.html), MFR: (https://www.rfparts.com/c137cnsg.html)Commscope (https://www.rfparts.com/c137cnsg.html) (rfparts.com) (https://www.rfparts.com/c137cnsg.html)
