simakma5/diploma-thesis/progress-reports/08-progress_report.pptx

## Dual circularly polarized waveguide antenna

Dual feeding structure

## Outline

- Current design state
- Refresher
- Single feed
- Dual feed
- Design process
- Results (WIP)
- Conclusion

Research progress report

## Current design state

- Polarizer finished
  - Generates both RHCP/LHCP waves
  - Excited by the two fundamental modes of a square waveguide
- Dual feeding structure WIP
  - Provides realistic excitation of the two modes

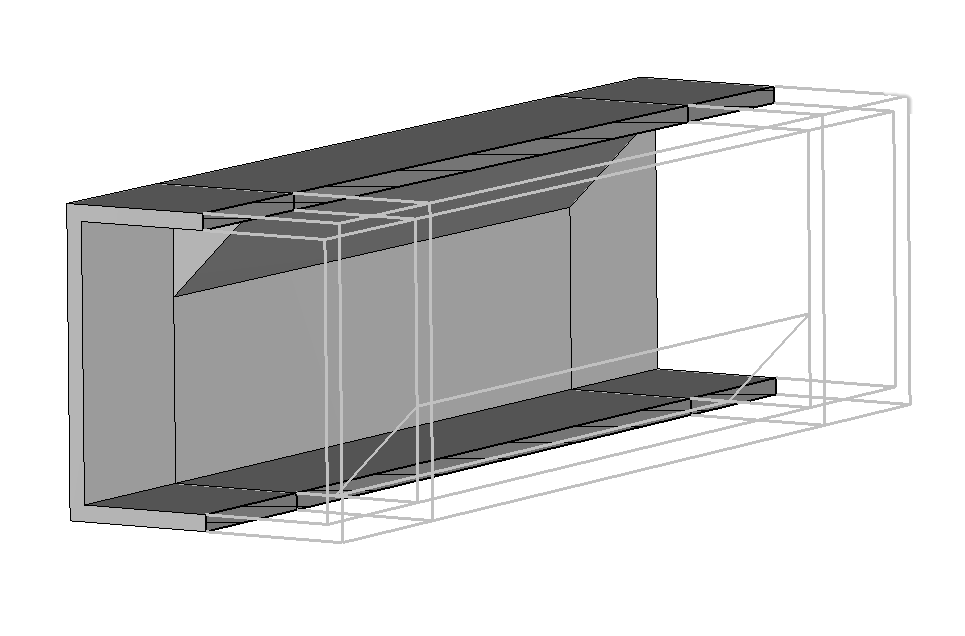
[picture p66: figure]

## Refresher: rectangular waveguide

- Guided wave description
E_y =E_0 sin(k_x x)e^(i(ωt−k_z z))
- Fundamental mode
k_x =(2π)/(λ_(cutoff))=π/a
- Phase velocity
v=ω/(k_z)

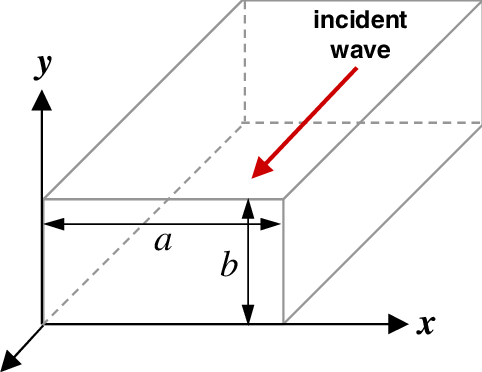
[picture p67: figure]
Coordinate system of rectangular waveguide.

## Refresher: wave equation

- Maxwell’s equations dictate a compliance with the wave equation.
(∂^2 E_y)/(∂x^2)+(∂^2 E_y)/(∂y^2)+(∂^2 E_y)/(∂z^2)−1/(c^2)(∂^2 E_y)/(∂t^2)=0,
k_x^2 E_y +k_z^2 E_y −(ω^2)/(c^2)E_y =0.
- Since the solution E_y =0 is uninteresting,
k_x^2 +k_z^2 −(ω^2)/(c^2)=0,
k_z =√((ω^2)/(c^2)−(π^2)/(a^2)).

## Refresher: guide wavelength

- Using λ=2πv/ω and defining λ_g so that k_z =2π/λ_g ,
λ_g =(λ_0)/(√(1−((λ_0)/(2a))^2)).
- In our case of f=5.5 GHz and a=50 mm ,
λ_0 =c/f≈54.51 mm,
λ_g ≈65.02 mm.

## Single feed: overview

- Coax inner conductor reaches into the cavity serving as an antenna
- Antenna probe excites TE01 mode
- Back-short reflects energy
- In-phase wave combination at probe
- Electromagnetic wave propagation


## Single feed: variables

- Length of the antenna probe
  - Usually ≈3λ_0 /16
- Distance from the back-short
  - Should be somewhat <λ_g /4
Quantity λ_g is the guide wavelength introduced earlier.

## Single feed: implementation


## Reflection

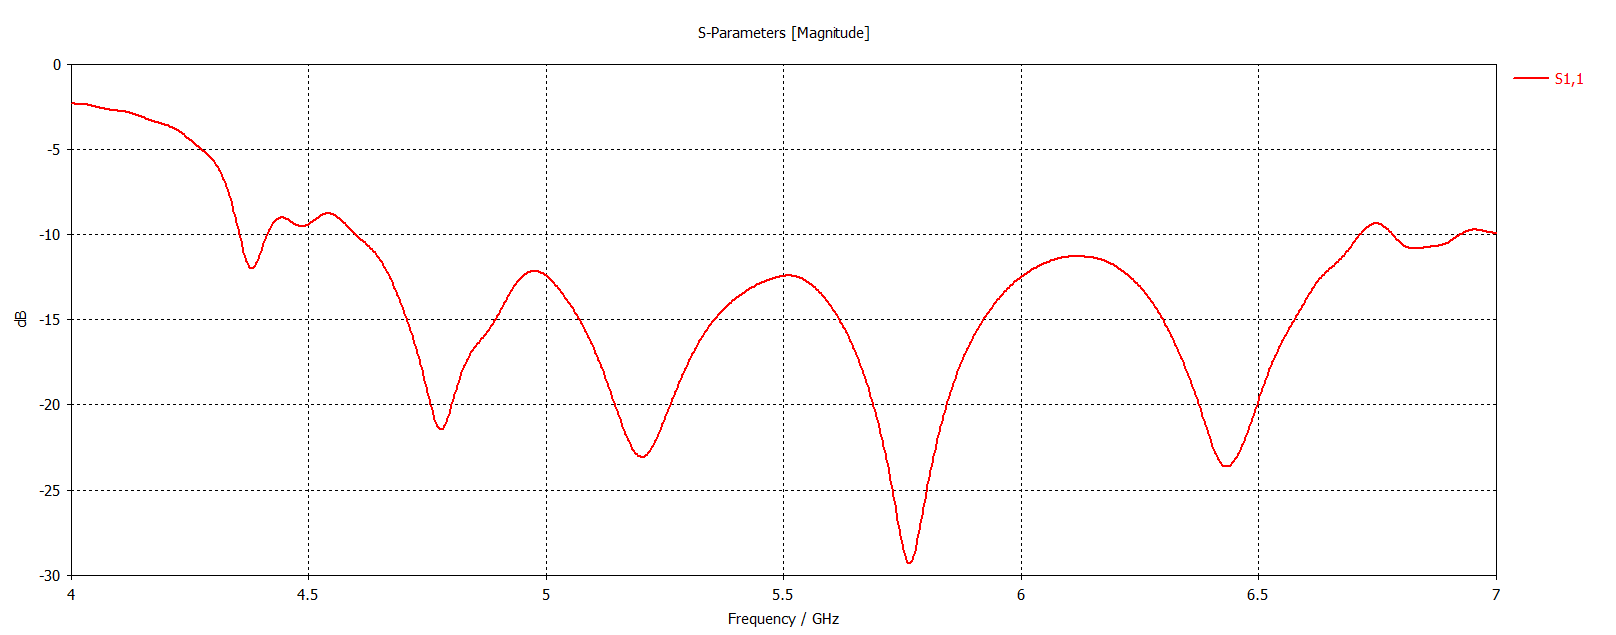
[picture p68: figure]

## Dual feed: idea [1]

- Same principal as the single feed
- Two orthogonal probes separated by distance
- Port 2 back-short replaced by a grating parallel to the probe
  - Grating ideally transparent to port 1 while a back-short for port 2
  - Helps minimize crosstalk


## Dual feed: variables

- Length of both antenna probes
- Distance of port 1 from the back-short
- Distance of the grating from port 1
- Distance of port 2 from the grating
- Diameter of the grating wires
- Gap (distance) between the grating wires
- Number of grating wires

## Dual feed: implementation


## Design process

1. Start with just a single feed (Port 1)
  - Helps get an idea of optimal probe geometry
  - Optimize probe length and distance from back-short
2. Draw the grating with single feed
  - Grating distance from Port 1 shouldn’t affect Port 2 radiation
  - Optimize grating distance
3. Add the second feed (Port 2)
  - Optimize grating gap and wire count which affect both ports
  - Trade-off between port reflection and crosstalk

## Results (WIP): Port 1 reflection

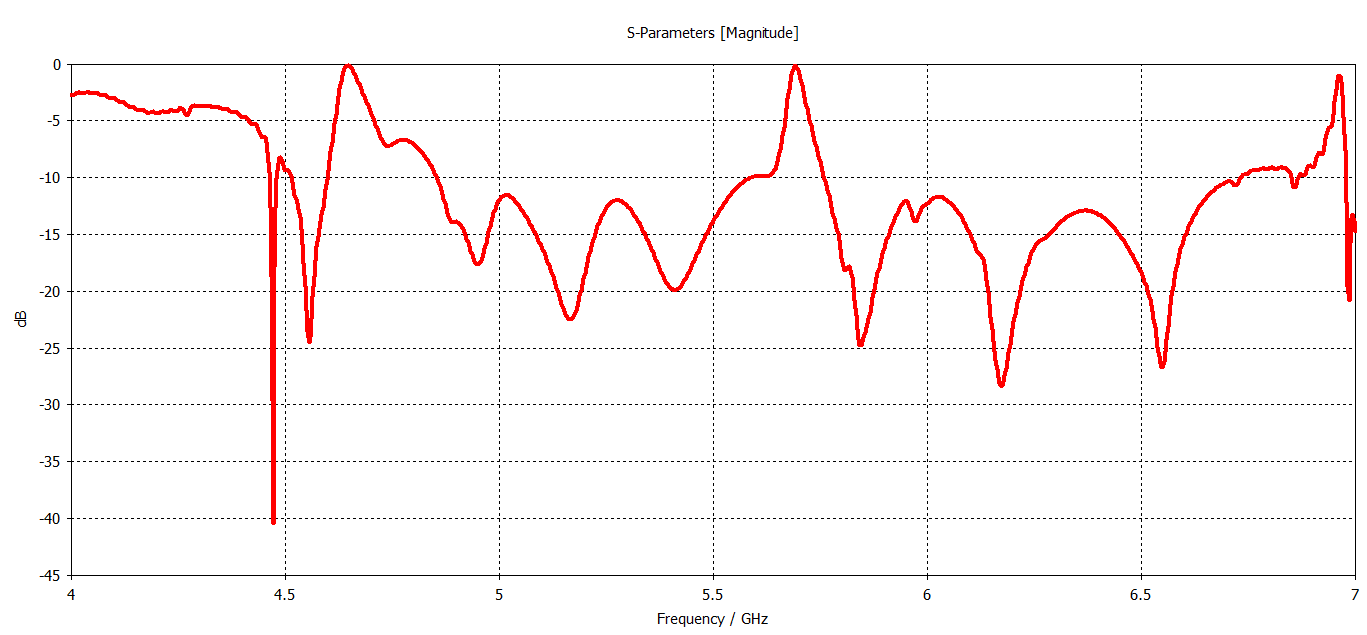
[picture p69: figure]

## Results (WIP): Port 2 reflection

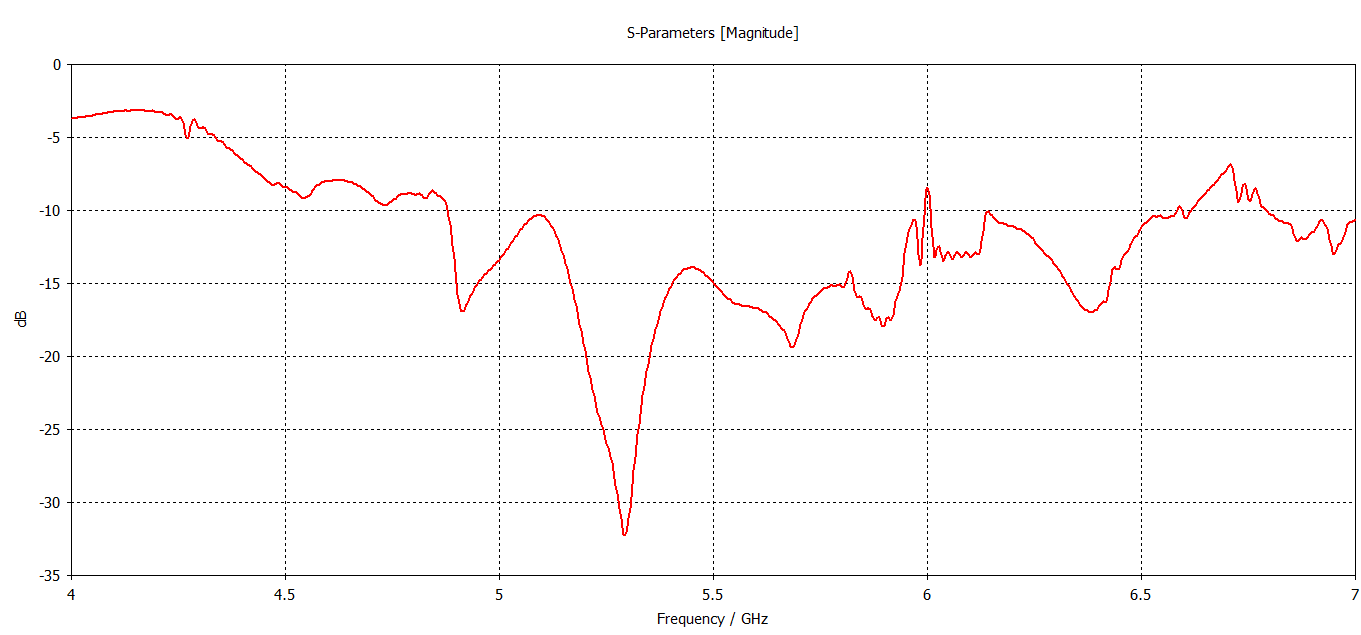
[picture p70: figure]

## Results (WIP): Port crosstalk

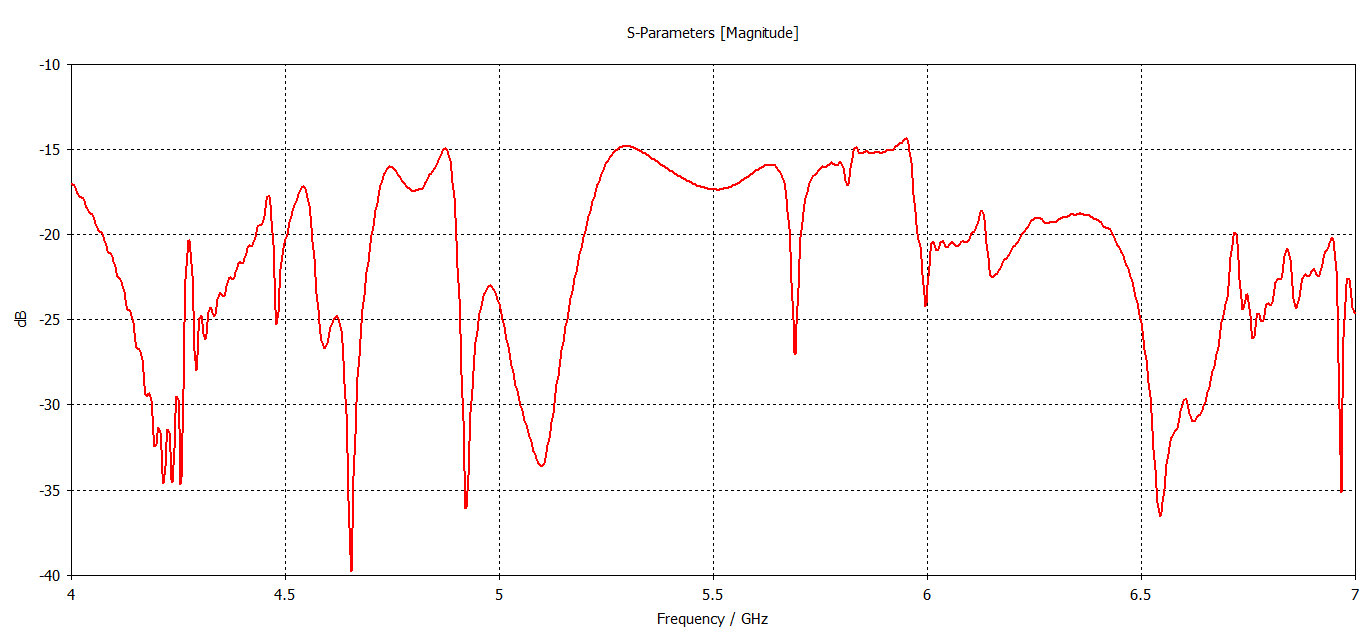
[picture p71: figure]

## Conclusion

- Solid theoretical foundation built
- Early results indicate a solution exists
- Complex structure for optimization
  - Several points of reflection, leading to potential resonances
  - Difficult tuning and optimization

## Thank you

for your attention

## References

1. https://www.feynmanlectures.caltech.edu/II_24.html#Ch24-F4
2. S. K. Karki, J. Ala-Laurinaho and V. Viikari, "Dual-Polarized Probe for Planar Near-Field Measurement," in IEEE Antennas and Wireless Propagation Letters, vol. 22, no. 3, pp. 576-580, March 2023, doi: 10.1109/LAWP.2022.3218731
Pictures
- Microwaves101 | Waveguide to coax transitions (https://www.microwaves101.com/encyclopedias/waveguide-to-coax-transitions?jtpl=12)
- ResearchGate | Coordinate system of rectangular waveguide (https://www.researchgate.net/figure/Coordinate-system-of-rectangular-waveguide_fig1_322877129)
