simakma5/diploma-thesis/latex/src/coverpage.docx

| 國立台灣科技大學 電子工程系

碩士學位論文

雙圓極化波導天線

Dual Circularly Polarized Waveguide Antenna

Martin Šimák

M11202825

指導教授：林丁丙 博士

中華民國 114 年 1 月 17 日
