simakma5/diploma-thesis/latex/project.tex

% ========== Compiler Directives ==========
% !TeX program = lualatex                                   
% !TeX encoding = utf8
% !TeX spellcheck = english

% ========== Document settings ==========
\documentclass[14pt,a4paper]{ntust_report}
% \setlength\textwidth{145mm}
% \setlength\textheight{247mm}
% \setlength\oddsidemargin{14.2mm}
% \setlength\evensidemargin{0mm}
% \setlength\topmargin{0mm}
% \setlength\headsep{0mm}
% \setlength\headheight{0mm}
% \let\openright=\cleardoublepage

% ========== Language settings ==========
\usepackage[main=american,czech]{babel}

% ========== Packages =============
\usepackage{thesis-package}

% ========== Date format ===============
% \newdateformat{monthyeardate}{\monthname[\THEMONTH] \THEYEAR}

% ========== Bibliography ==========
\addbibresource{bibliography.bib}

% ========== Draft settings ==========
\usepackage{lipsum}
\newlength{\twosubht}
\newsavebox{\twosubbox}

\makeindex[intoc]
\makenomenclature
\renewcommand{\nomname}{Glossary of Symbols}

% ========== NTUST settings ==========
% \usepackage{xeCJK}
\setmainfont{Times New Roman}
% \setCJKmainfont{cwTeXKai}
% \XeTeXlinebreaklocale "zh"
% \XeTeXlinebreakskip = 0pt plus 1pt

\usepackage{geometry}
\geometry{verbose,a4paper,tmargin=3.5cm,bmargin=2cm,lmargin=3cm,rmargin=3cm}
\newcommand{\mybaselinestretch}{1.5}
\renewcommand{\baselinestretch}{\mybaselinestretch}
\parskip=2ex
\parindent = 24Pt

\usepackage{fancyhdr}
\pagestyle{fancy}
\fancyhead{}
\fancyfoot[C]{\thepage}
\renewcommand{\headrulewidth}{0pt}

\begin{document}

\pagenumbering{gobble}

% ========== Title page ==========
\includepdf{src/coverpage.pdf}

% ========== Recommendation form ==========
\includepdf{src/recommendation_form.pdf}

% ========== Qualification form ==========
\includepdf{src/qualification_form.pdf}

\pagenumbering{roman}

% % ========== Abstract ==========
\input{abstract.tex}

% % ========== Acknowledgements ==========
\input{acknowledgements.tex}

\pagenumbering{arabic}

% ========== Table of contents ==========
\tableofcontents

% ========== List of figures ==========
\listoffigures

% ========== Introduction ==========
\chapter*{Introduction}
\label{chapter:introduction}
\addcontentsline{toc}{chapter}{\nameref{chapter:introduction}}

This thesis focuses on the design and implementation of a dual circularly polarized antenna operating within the $\frequencyrange$ frequency band. This range, a subset of the C-band, finds widespread use in various applications such as satellite communications, radar systems, and certain Wi-Fi standards. The selection of this frequency band was driven by the increasing demand for high-bandwidth, reliable communication and the availability of established waveguide technology within this range.

Building upon this established need for high-bandwidth, reliable communication within the $\frequencyrange$ frequency band, this thesis further focuses on achieving dynamic control over signal polarization. Specifically, the work introduces a novel waveguide-based antenna capable of producing switchable right-hand and left-hand circular polarization (RHCP and LHCP). This capability is achieved through the development of a new polarizer design based on a hexagonal waveguide structure. This simple geometry allows for straightforward switching between RHCP and LHCP by selectively exciting one of the two orthogonal fundamental modes of the waveguide. Importantly, the uncomplicated nature of the polarizer's design lends itself to easy and cost-effective mass production, making it a highly practical solution. The ability to dynamically control polarization offers significant advantages in applications such as polarization multiplexing, potentially increasing channel capacity, and provides a robust solution for achieving polarization diversity in challenging environments, including compact or integrated systems.

The design process leveraged several software tools. CST Studio Suite~\parencite{cst} was the primary tool for full-wave electromagnetic simulations due to its comprehensive features for modelling and simulating complex electromagnetic structures, including waveguides and antennas. Its transient solver, based on the Finite Integration Technique (FIT), was particularly suitable for analyzing the time-domain behavior of the proposed designs. Antenna Magus~\parencite{antenna-magus} was integrated into the initial design stages, specifically for the conical horn antenna, expediting the prototyping process through its extensive database of antenna designs and ability to synthesize antenna geometries based on user-defined parameters. The Nelder-Mead method, a derivative-free optimization technique, was employed to optimize the geometric parameters of the polarizer and the feeding structure. This method is well-suited for problems with non-smooth or noisy objective functions, which can arise from complex electromagnetic simulations. It was utilized both within CST's native optimizer tool and within the Python-based SciPy optimization framework. MATLAB~\parencite{matlab} was employed for data visualization and generating publication-ready plots due to its robust plotting capabilities and fine-grained control over figure aesthetics.

\paragraph*{Synopsis.} \textbf{\cref{chapter:electrodynamics}} establishes the theoretical foundations of electromagnetic wave propagation in guided structures, starting from Maxwell's equations and culminating in the derivation of the wave equations for waveguide modes.

\textbf{\cref{chapter:polarizer}} details the design and analysis of the waveguide polarizer, exploring various polarizer designs, and ultimately focusing on a novel approach utilizing a square waveguide with chamfered corners.

\textbf{\cref{chapter:feeding-structure}} addresses the challenge of efficiently exciting the two orthogonal modes within the square waveguide using a dual-coaxial feed. A modified feeding structure is presented and optimized for minimal reflection and cross-talk.

\textbf{\cref{chapter:antenna}} focuses on the design of a conical horn antenna, specifically adapted to interface with the square waveguide output of the polarizer developed in \cref{chapter:polarizer}. This section discusses the optimization of the horn's geometry for achieving the desired gain and radiation characteristics.

\textbf{\cref{chapter:final-structure}} details the culmination of the design process, integrating the individual components developed in previous chapters into a complete antenna system, and outlines the final design adjustments. Furthermore, it presents a comprehensive comparison of the simulated and measured performance results of the fabricated prototype, including a thorough discussion of the observed agreement and discrepancies.

\paragraph*{Methodology.} The methodology combined numerical simulations with experimental validation. Full-wave electromagnetic simulations, conducted using CST Studio Suite, were used to analyze the performance of individual components and the integrated antenna system. Optimization algorithms, implemented in both CST Studio Suite and Python using the SciPy library, refined the design parameters for optimal performance. A prototype of the finalized design was fabricated and measured to validate the simulation results and demonstrate the feasibility of the proposed approach.

% ========== Chapter 1: Electrodynamics of guided waves ==========
\chapter{Electrodynamics of guided waves}
\label{chapter:electrodynamics}
This chapter establishes the theoretical foundation for the analysis and design of a waveguide-based antenna system. Building on the Maxwell's equations and a general description of electromagnetic fields in various settings, the wave equations governing guided waves are derived, and their solutions are analyzed to elucidate the behavior of electromagnetic fields within waveguides. This analysis provides a framework for understanding the operation of structures designed in the following chapters. While focusing on the essential elements of waveguide theory, this chapter provides a comprehensive treatment of the subject and establishes the notation used throughout this work.

The exposition endeavors to take inspiration and build upon the foundations laid in~\parencite{balanis:advanced-engineering-electromagnetics,griffiths:introduction-to-electrodynamics,zangwill:modern-electrodynamics}, incorporating personal insights and notational preferences to present a cohesive theoretical framework for further chapters.

\section{Electromagnetic waves}
\label{section:electromagnetic-waves}
In this section, the manner in which Maxwell's equations predict the propagation of these waves is explored. The wave equations for the electric and magnetic fields are derived, revealing their interconnected nature and ability to sustain each other even in the absence of sources. Subsequently, the simplest and most fundamental solutions to these equations, \emph{monochromatic plane waves}, are investigated. Finally, the confinement and guidance of these plane waves within conducting cavities are examined, laying the groundwork for understanding waveguides and resonant structures.

\subsection{The wave equations}
\label{subsection:the-wave-equations}
Maxwell's equations provide a comprehensive description of electromagnetic phenomena, but their coupled nature can make them challenging to solve directly. Decoupling the equations and expressing them individually in terms of the electric and magnetic fields is often advantageous to facilitate analysis, particularly in source-free regions. Inside regions with no \emph{free} charge or \emph{free} current, Maxwell's equations as stated e.g., in~\parencite{griffiths:introduction-to-electrodynamics}, take on the form of\\
\begin{subequations}
    \label[pluralequation]{subeq:maxwell-sourceless}
    \begin{align}
        \label{eq:maxwell-sourceless-div-d}
        \div \vec D &= 0,
    \\
        \label{eq:maxwell-sourceless-curl-e}
        \curl \vec E &= -\partial_t\vec B,
    \\
        \label{eq:maxwell-sourceless-div-b}
        \div\vec B &= 0,
    \\
        \label{eq:maxwell-sourceless-curl-h}
        \curl\vec H &= \sigma\vec E + \partial_t\vec D.
    \end{align}
\end{subequations}
Furthermore, if the medium is \emph{linear} and \emph{homogeneous}, \cref{eq:maxwell-sourceless-curl-h} can be fully expressed in terms of $\vec E$. With this simplification, applying the curl to \cref{eq:maxwell-sourceless-curl-e,eq:maxwell-sourceless-curl-h} yields\\
\begin{subequations}
    \label[pluralequation]{subeq:wave-equations-lossy}
    \begin{align}
        \label{eq:wave-equation-e}
        \Delta\vec E &= \mu\sigma\partial_t\vec E + \mu\epsilon\partial^2_t\vec E,
    \\
        \label{eq:wave-equation-b}
        \Delta\vec B &= \mu\sigma\partial_t\vec B + \mu\epsilon\partial^2_t\vec B.
    \end{align}
\end{subequations}

Therefore, electric and magnetic fields in linear homogeneous media both clearly satisfy the wave equation with a linear damping term $\mu\sigma\partial_t$, introduced by conductive losses. Moreover, in regions with $\sigma = 0$, such as free space or ideal insulators, \cref{subeq:wave-equations-lossy} simplify even more to\\
\begin{subequations}
    \label[pluralequation]{subeq:wave-equations-lossless}
    \begin{align}
        \label{eq:wave-equation-e-lossless}
        \Delta\vec E &= \mu\epsilon\partial^2_t\vec E,
    \\
        \label{eq:wave-equations-b-lossless}
        \Delta\vec B &= \mu\epsilon\partial^2_t\vec B,
    \end{align}
\end{subequations}
taking on the form of classical wave equations, which are ubiquitous in physics. This consequently yields the formula
\begin{align}
    v &= \frac{1}{\sqrt{\epsilon\mu}} = \frac{c}{\sqrt{\epsilon_r\mu_r}}
\end{align}
for the speed of electromagnetic waves in linear homogeneous media.

\subsection{Monochromatic plane waves}
\index{monochromatic plane wave}
The electromagnetic theory presented thus far describes general vector fields that vary in space and time. However, as shown in \cref{subsection:the-wave-equations}, electromagnetic fields in source-free regions exhibit wave behavior. Nonetheless, these time-varying vector fields remain complex and challenging to analyze in practical systems. Consider the elementary solution to the wave equation
\begin{align}
    \label{eq:monochromatic-plane-wave}
    \hat{\vec\psi}(\vec r,t) &= \hat{\vec\Psi}_0\exp\[\i\(\hat{\vec k} \cdot \vec r-\omega t\)\].
\end{align}
\nomenclature{$\vec k$}{wave vector }%
Here, $\hat{\vec k}$ is the complex \emph{wave vector} indicating the direction of wave propagation, and $\omega$ is the angular frequency of the wave. \Cref{eq:monochromatic-plane-wave} is expressed in terms of a \emph{complex wave function} with a \emph{complex amplitude} $\hat{\vec\Psi}_0 \equiv \vec\Psi_0\e^{\i\delta}$. This quantity encapsulates both the \emph{real amplitude} $\vec\Phi_0$ and the \emph{phase shift} $\delta$ of the physical wave. A sinusoidal wave representing this solution in physical reality can be extracted from \cref{eq:monochromatic-plane-wave} using \emph{Euler's formula}, yielding
\begin{align}
    \label{eq:sinusoidal-wave}
    \vec{\psi}(\vec r, t) &= \Re\[\hat{\vec\Psi}_0\exp\[\i\(\hat{\vec k} \cdot \vec r-\omega t+\delta\)\]\] = \Re\[\hat{\vec\psi}(\vec r, t)\].
\end{align}

\begin{remark}
    Clearly, if \cref{eq:sinusoidal-wave} satisfies \cref{subeq:wave-equations-lossless} and Maxwell's equations, the same holds true for \cref{eq:monochromatic-plane-wave}, as the imaginary part differs from the real part only by the replacement of sine with cosine.
\end{remark}

\Cref{eq:monochromatic-plane-wave} serves as an established elementary solution to the general wave equation and hence also to \cref{subeq:wave-equations-lossless}. Substituting this solution into \cref{subeq:wave-equations-lossy}, it becomes evident that these \enquote{lossy wave equations} also admit plane-wave solutions. Furthermore, this substitution allows for deriving a general formula for the complex \emph{wavenumber} of a plane wave:
\begin{align}
    \label{eq:wave-number}
    \hat k^2 = \hat{\vec k} \cdot \hat{\vec k} = \mu\epsilon\omega^2 + \i\mu\sigma\omega.
\end{align}
In the context of \cref{eq:monochromatic-plane-wave}, it is evident that the real part of the complex wavenumber $\hat k$ is the \emph{actual} wavenumber as it determines the change of phase with spatial propagation. For this reason, the real part is simply denoted $k$ and is called the \emph{phase constant}. In contrast, the imaginary part of $\hat k$ is responsible for the exponential damping, or attenuation, in conductive media and hence is called the \emph{attenuation constant}.

Waves described by \cref{eq:monochromatic-plane-wave} are called \emph{monochromatic}, or \emph{time-harmonic}, \emph{plane}
waves. Monochromaticity refers to the wave oscillating at a single frequency $\omega$ through time, while planarity indicates that the fields are uniform over every plane perpendicular to the direction of propagation. Although less common, plane waves could alternatively be called \emph{space-harmonic},%
    \footnote{Therefore, monochromatic plane waves are something one could call \emph{spacetime-harmonic} or simply \emph{harmonic}.}
as both terms signify a sinusoidal dependence on a given variable. In the case of monochromaticity, the variable is time, oscillating with an angular frequency $\omega$. Similarly, planarity reflects the waveform repetition in the spatial coordinates, projected into the propagation direction, with a well-defined spatial frequency $k$.

The significance of this particular solution stems from the fact that, in practice, any wave relevant to engineering purposes can be expressed as a linear combination of these monochromatic plane waves, i.e.,
\begin{align}
    \label{eq:fourier-transform}
    \hat{\vec\psi}(\vec r,t) &= \int_{\R^3} \hat{\vec{\Psi}}_0(\vec k)\exp\[\i\(\hat{\vec k} \cdot \vec r-\omega t\)\]\,\d\vec k.
\end{align}
This superposition principle mathematically reflects the Fourier transform over every plane wave corresponding to a given frequency $\omega$. With this formally sound mathematical description, the existence of a unique linear combination for \enquote{any wave relevant to engineering purposes}, as vaguely stated above, can be rigorously established.

Indeed, since any physically realizable signal is square-integrable and has compact support,%
    \footnote{In the field of signal processing, these signal properties are often described as having \emph{finite energy} and \emph{duration}, respectively.}
the existence of its Fourier transform is guaranteed. This implication is granted by recalling that the combination of square integrability and compact support implies absolute integrability by the Cauchy-Schwarz inequality, which forms a sufficient condition for the existence of the Fourier transform. Therefore, any such physical signal can be confidently decomposed into a superposition of monochromatic plane waves, as expressed in \cref{eq:fourier-transform}. This decomposition into a unique linear combination of plane waves of different frequencies underpins much of the mathematical theory concerning Fourier analysis. For a deeper dive into the mathematical foundations of Fourier integrals,~\parencite{titchmarsh:introduction-to-the-theory-of-fourier-integrals} can be consulted. Furthermore, a formulation of Dirichlet conditions, which are more relevant to signal processing applications, can be found in~\parencite{oppenheim:signals-and-systems}.

Because the focus of this text is confined to physically realizable signals, i.e., signals possessing these crucial properties, a restriction of our attention to monochromatic plane waves is justified. Therefore, fields taking on the form of
\begin{subequations}
    \label[pluralequation]{subeq:monochromatic-plane-wave-fields}
    \begin{align}
        \label{eq:monochromatic-plane-wave-e}
        \hat{\vec E}(\vec r, t) &= \hat{\vec E}_0 \exp\[\i\(\hat{\vec k} \cdot \vec r-\omega t\)\],
    \\
        \label{eq:monochromatic-plane-wave-b}
        \hat{\vec B}(\vec r, t) &= \hat{\vec B}_0 \exp\[\i\(\hat{\vec k} \cdot \vec r-\omega t\)\]
    \end{align}
\end{subequations}
are considered, where $\hat{\vec E}_0$ and $\hat{\vec B}_0$ are complex amplitudes.

\subsection{Polarization}
\label{subsection:polarization}
A brief examination of the general polarization properties of monochromatic plane waves is now undertaken. For the sake of simplicity, consideration is restricted to propagation within a vacuum. Consequently, the Cartesian coordinate system is aligned such that the unit vector $e_z$ coincides with the unit vector $e_{\vec k}$, which defines the direction of propagation. The remaining real unit vectors, $\vec e_x$ and $\vec e_y$, are then defined such that $(\vec e_x, \vec e_y, \vec e_z)$ constitutes a right-handed orthogonal triad of unit vectors. Thus, the ordered set of vectors $(\vec e_x, \vec e_y)$ forms a basis for the complex amplitude of the electric field E, and the electric field can thereby be expressed as
\begin{align}
    \label{eq:polarization-e}
    \hat{\vec E}(\vec r,t) &= \[\hat E_x\vec e_x + \hat E_y\vec e_y\]\exp\[\i\phi(\vec r,t)\],
\end{align}
where
\begin{align}
    \hat E_x &= E_x\exp\(\i\delta_x\),
&
    \hat E_y &= E_y\exp\(\i\delta_y\),
\end{align}
for some real numbers $E_x$, $E_y$, $\delta_x$, and $\delta_y$, and
\begin{align}
    \phi(\vec r,t) &= \hat{\vec k} \cdot \vec r - \omega t.
\end{align}
Expressing the real part of \cref{eq:polarization-e} yields
\begin{align}
    \label{eq:polarization-e-real-part}
    \Re\[\hat{\vec E}\] &= E_x\cos\(\phi + \delta_x\)\vec e_x + E_y\cos\(\phi + \delta_y\)\vec e_y = A_x\vec e_x + A_y\vec e_y.
\end{align}
Equating the components from the second relation in \cref{eq:polarization-e-real-part} and applying goniometric identities, the following relationships are obtained:
\begin{subequations}
    \begin{align}
        \label{eq:polarization-ellipse-a}
        \frac{A_x}{E_x}\sin(\delta_y)-\frac{A_y}{E_y}\sin(\delta_x) &= \sin(\delta_y-\delta_x)\cos(\phi),
    \\
        \label{eq:polarization-ellipse-b}
        \frac{A_x}{E_x}\sin(\delta_y)-\frac{A_y}{E_y}\sin(\delta_x) &= \sin(\delta_y-\delta_x)\cos(\phi).
    \end{align}
\end{subequations}
Subsequent squaring and addition of \cref{eq:polarization-ellipse-a,eq:polarization-ellipse-b} yields
\begin{align}
    \label{eq:polarization-ellipse}
    \(\frac{A_x}{E_x}\)^2 + \(\frac{A_y}{E_y}\)^2 - 2\frac{A_x}{E_x}\frac{A_y}{E_y}\cos\(\delta\) &= \sin^2\(\delta\),
\end{align}
\index{elliptical polarization}
where $\delta \equiv \delta_y-\delta_x$. Clearly, \cref{eq:polarization-ellipse} defines an ellipse in the plane transverse to the propagation direction. Accordingly, the general monochromatic plane wave described in \cref{eq:monochromatic-plane-wave} exhibits \emph{elliptical polarization}. The eccentricity and orientation of the ellipse are related to the phase difference $\delta$ and the amplitude ratio $E_y/E_x$. Upon inspecting \cref{eq:polarization-ellipse}, two special types of polarization can be identified for specific parameter values.

\paragraph{Linear polarization.} \index{linear polarization}
The first situation arises when the polarization ellipse degenerates into a straight line. This condition occurs when the electric field components are either in-phase or out-of-phase by half-wavelength, i.e.,
\begin{align}
    \label{eq:polarization-linear-condition}
    \delta = \delta_y-\delta_x = m\pi, \quad m \in \N_0.
\end{align}
This situation corresponds to \emph{linear polarization} and \cref{eq:polarization-e-real-part} is rendered as
\begin{align}
    \label{eq:polarization-linear-e}
    \Re\[\hat{\vec E}(\vec r,t)\] &= \[E_x\vec e_x \pm E_y\vec e_y\]\cos\(\phi + \delta_x\).
\end{align}

\paragraph{Circular polarization.} \index{circular polarization}
The alternative scenario arises when the polarization ellipse simplifies into a circle. This simplification occurs exclusively when the orthogonal electric field components possess equal amplitude and are out-of-phase by one-quarter wavelength, i.e.,
\begin{align}
    \label{eq:polarization-circular-condition}
    E_x = E_y &= \frac{E}{\sqrt 2},
&
    \delta = \delta_y-\delta_x &= (2m+1)\frac{\pi}{2}, \quad m \in \Z.
\end{align}
This condition corresponds to \emph{circular polarization}, as the tip of the polarization vector traces a circle within every fixed transverse plane. The plane $z = 0$ is considered to ascertain the direction of circular movement By setting $\delta_x = 0$,%
    \footnote{The choice $\delta_x=0$ is inconsequential to the resulting polarization as it depends only on the phase difference $\delta$.}
\cref{eq:polarization-e-real-part} is expressed as
\begin{align}
    \label{eq:polarization-circular-e-r0}
    \Re\[\hat{\vec E}_\pm(\vec 0,t)\] &= \frac{E}{\sqrt 2}\[\cos(\omega t)\vec e_x \pm \sin(\omega t)\vec e_y\].
\end{align}
This expression demonstrates that when viewed from the direction defined by $\hat{\vec k}$, the electric field $\hat{\vec E}^+$ represents a circularly polarized wave with the polarization vector rotating anticlockwise, thus defining \emph{left-hand circular polarization} (LHCP). Conversely, the case of $\hat{\vec E}^-$ represents a circularly polarized wave with the polarization vector rotating clockwise, defining \emph{right-hand circular polarization} (RHCP).

The exposition given so far is aligned with Augustin-Jean Fresnel's general definition of elliptical polarization, as presented in his memoir to the French Academy of Sciences on 9 December 1822, wherein the concepts of the three types of polarization---general elliptical polarization, and its specific forms, linear and circular polarization---were coined. The following remark, however, provides an alternative and often advantageous approach.

\begin{remark}[Complex basis for circular polarization]
    For the electric field decomposition basis in \cref{eq:polarization-e}, the following complex conjugate vectors, rather than the Cartesian vectors $\vec e_x$ and $\vec e_y$, are now considered:
    \begin{align}
        \label{eq:polarization-circular-complex-vectors}
        \vec e_+ &= \frac{1}{\sqrt 2}\(\vec e_x + \i\vec e_y\),
    &
        \vec e_- &= \frac{1}{\sqrt 2}\(\vec e_x - \i\vec e_y\).
    \end{align}
    These vectors maintain orthonormality. Using this basis, it is evident that the real part of the thus-formed complex electric field
    \begin{align}
        \hat{\vec E}_\pm(\vec r,t) &= E\vec e_\pm\exp\[\i\(\hat{\vec k}\cdot\vec r - \omega t\)\]
    \\
        &= \frac{E}{\sqrt 2}\[\vec e_x \pm \i\vec e_y\]\exp\[\i\(\hat{\vec k}\cdot\vec r - \omega t\)\],
    \end{align}
    evaluated at $\vec r = 0$, is equivalent to \cref{eq:polarization-circular-e-r0}. Because the ordered set of vectors defined by \cref{eq:polarization-circular-complex-vectors} constitutes a valid basis for the transverse plane, analogous to the $(\vec e_x,\vec e_y)$ basis, the expression
    \begin{align}
        \hat{\vec E} &= \[E_+\vec e_+ + E_-\vec e_-\]\exp\[\i\phi\]
    \end{align}
    is an equivalent representation to \cref{eq:polarization-e}. Consequently, any monochromatic plane wave can be decomposed into RHCP and LHCP components analogous to its decomposition into orthogonal linearly polarized components.
\end{remark}

\subsection{Guided waves}
The behavior of electromagnetic waves within a waveguide is now explored. An assumption is made to provide a clear framework for analysis that the waveguide walls are perfect electric conductors (PEC), implying the absence of surface sources. This idealization leads to specific boundary conditions\\
\begin{subequations}
    \label[pluralequation]{subeq:guided-waves-boundary-conditions}
    \begin{align}
        \label{eq:guided-waves-boundary-condition-e}
        \vec e_n \times \vec E &= 0,
    \\
        \label{eq:guided-waves-boundary-condition-b}
        \vec e_n \cdot \vec B &= 0.
    \end{align}
\end{subequations}
It is essential to recognize that free charges and currents will be induced on the surface precisely to enforce these constraints.

Furthermore, the focus is on monochromatic plane waves propagating along the waveguide. This implies that the electric and magnetic fields have a harmonic time dependence with a single angular frequency $\omega$. The $\hat{\phantom{x}}$ notation is dispensed with as $\hat k$ is real for the cases of interest. The general form of the fields is then given by \cref{subeq:monochromatic-plane-wave-fields}, where the $z$-axis is aligned with the waveguide's longitudinal direction. The complex amplitudes of the fields,\\
\begin{subequations}
    \label[pluralequation]{subeq:complex-amplitudes}
    \begin{align}
        \label{subeq:complex-amplitude-e}
        \hat{\vec E}_0 &= E_x\vec e_x + E_y\vec e_y + E_z\vec e_z,
    \\
        \label{subeq:complex-amplitude-b}
        \hat{\vec B}_0 &= B_x\vec e_x + B_y\vec e_y + B_z\vec e_z,
    \end{align}
\end{subequations}
are functions of the transverse coordinates, $x$ and $y$, reflecting the spatial variations of the fields within the waveguide cross-section.

To further simplify the analysis, the waveguide is considered source-free, meaning that no free charges or currents are \emph{impressed} within the waveguide. This allows the utilization of the simplified form of Maxwell's equations \eqref{subeq:maxwell-sourceless}. Due to the assumed linearity of the medium within the waveguide, these equations are expressed in terms of $\vec E$ and $\vec B$.

With these assumptions in place, the behavior of guided waves can be analyzed. From \cref{eq:maxwell-sourceless-curl-e,eq:maxwell-sourceless-curl-h}, adapted for a linear medium, a set of coupled differential equations relating the transverse components of the electric and magnetic fields is obtained. These equations can be solved to express the transverse field components in terms of the longitudinal components, taking the form of\\
\begin{subequations}
    \label[pluralequation]{subeq:guided-wave-transverse-fields}
    \begin{align}
        \label{eq:guided-wave-ex}
        E_x &= \zeta\(k\partial_xE_z+\omega\partial_yB_z\)\vphantom{\frac{\omega}{c^2}},
    \\
        \label{eq:guided-wave-ey}
        E_y &= \zeta\(k\partial_yE_z-\omega\partial_xB_z\)\vphantom{\frac{\omega}{c^2}},
    \\
        \label{eq:guided-wave-bx}
        B_x &= \zeta\(k\partial_xB_z-\frac{\omega}{c^2}\partial_yE_z\),
    \\
        \label{eq:guided-wave-by}
        B_y &= \zeta\(k\partial_yB_z+\frac{\omega}{c^2}\partial_xE_z\),
    \end{align}
\end{subequations}
where $\zeta = \i/((\omega/c)^2-k^2)$. Finally, substituting \cref{subeq:guided-wave-transverse-fields} into \cref{eq:maxwell-sourceless-div-d,eq:maxwell-sourceless-div-b} yields the uncoupled equations
\begin{subequations}
    \label[pluralequation]{subeq:guided-wave-longitudinal-fields}
    \begin{align}
        \label{eq:guided-wave-ez}
        \[\partial^2_x+\partial^2_y+\(\frac{\omega}{c}\)^2-k^2\]E_z &= 0,
    \\
        \label{eq:guided-wave-bz}
        \[\partial^2_x+\partial^2_y+\(\frac{\omega}{c}\)^2-k^2\]B_z &= 0.
    \end{align}
\end{subequations}
\index{Helmholtz equations}
These equations, often referred to as the \emph{Helmholtz equations}, govern the longitudinal field components and play a crucial role in determining the allowed modes of propagation within the waveguide. These modes are categorized based on the presence or absence of longitudinal components in the electric and magnetic fields. \emph{Transverse electric} (TE) waves have $E_z=0$, while \emph{transverse magnetic} (TM) waves have $B_z=0$. The simplest waves, for which both $E_z=B_z=0$, are called \emph{transverse electromagnetic} (TEM) waves, but these cannot exist within a hollow waveguide due to boundary conditions.

\begin{remark}[Non-existence of TEM waves in hollow waveguides]
    \label{remark:nonexistence-of-tem-waves-in-hollow-waveguides}
    To further illustrate this point, consider the case of a waveguide with perfectly conducting walls.
    
    Beginning with the scenario where the longitudinal component of the electric field, $E_z$, is zero, it follows from \cref{eq:maxwell-sourceless-div-d} that the divergence of the electric field in the transverse plane must also be zero. Similarly, when the longitudinal component of the magnetic field, $B_z$, is zero, \cref{eq:maxwell-sourceless-curl-e} dictates that the curl of the electric field in the transverse plane must vanish.
    
    Combining these results, the complex amplitude of the electric field, $\hat{\vec E}_0$, can be expressed as the gradient of a scalar potential $\varphi$ that satisfies Laplace's equation $\Delta\varphi = 0$. However, the boundary condition on the electric field, as expressed in \cref{eq:guided-waves-boundary-condition-e}, enforces an equipotential at the conductor surface. Since the solution to Laplace's equation is unique given the boundary conditions, and the boundary condition enforces an equipotential, the potential must be constant throughout the waveguide. Thus, the electric field must be zero.
\end{remark}

\begin{remark}[Modal decomposition of guided waves]
    \label{remark:modal-decomposition-of-guided-waves}
    \Cref{subeq:guided-wave-longitudinal-fields} for $E_z$ and $B_z$ are instances of the \emph{Helmholtz equation} with Dirichlet and Neumann boundary conditions, respectively. This mathematical structure is the eigenvalue problem for the Laplace operator arising in various physical contexts.
    
    For instance, the same equation and boundary conditions govern the vertical displacements of a vibrating drumhead. In this analogy, TM modes correspond to a drumhead with fixed boundaries, while TE modes correspond to a drumhead with free boundaries. The TM case is also isomorphic to the Schr\"odinger problem for a free particle's wave functions and energy eigenvalues in a two-dimensional box with rigid walls. Seeking inspiration in these analogous problems provides valuable intuition when thinking about a waveguide's modal eigenfunctions and eigenvalues. Some key mathematical results stemming from these analogies include:
    \begin{enumerate}[label=(\alph*)]
        \item There are infinite TE- and TM-mode eigenfunctions.
        \item The eigenvalues are all real and positive.
        \item The eigenfunctions can always be chosen real.
        \item The eigenfunctions form a complete set of functions.
        \item Eigenfunctions belonging to different eigenvalues are orthogonal, i.e.,
        \begin{align}
            \label{eq:mode-orthogonality}
            \int_S \[\hat{\vec E}_{0,\alpha} \times \hat{\vec B}_{0,\beta}^\ast\]\,\d S = C\delta_{\alpha\beta},
        \end{align}
        where $S$ is an arbitrary waveguide cross-section and $\delta_{\alpha\beta}$ is the Kronecker's delta distribution.
    \end{enumerate}

    The most significant result in terms of applied electrodynamics is the completeness of the eigenfunctions, which implies that any field within a waveguide can be composed of its modes. Specifically, if $\alpha$ denotes a distinct mode,%
        \footnote{For example, in the case of a rectangular waveguide, a mode is given by the combination of two integers, $m$ and $n$.}
    then any wave travelling in the positive direction (denoted by the $+$ superscript) can be decomposed as
    \begin{align}
        \hat{\vec E}^+ &= \sum_\alpha C_\alpha^+\[\hat{\vec E}_{0,\alpha} + \vec e_zE_{z,\alpha}\]\exp\(-\i k_{\alpha}z\),
    \\
        \hat{\vec B}^+ &= \sum_\alpha C_\alpha^+\[\hat{\vec B}_{0,\alpha} + \vec e_zB_{z,\alpha}\]\exp\(-\i k_{\alpha}z\).
    \end{align}
    \index{modal decomposition}
    Similarly, for the negative direction (denoted by the $-$ superscript), the decomposition is given by
    \begin{align}
        \hat{\vec E}^- &= \sum_\alpha C_\alpha^-\[\hat{\vec E}_{0,\alpha} - \vec e_zE_{z,\alpha}\]\exp\(\i k_{\alpha}z\),
    \\
        \hat{\vec B}^- &= \sum_\alpha C_\alpha^-\[-\hat{\vec B}_{0,\alpha} + \vec e_zB_{z,\alpha}\]\exp\(\i k_{\alpha}z\).
    \end{align}
    Furthermore, thanks to the mutual orthogonality of modes, the modal decomposition is uniquely given by the orthogonal projection
    \begin{align}
        C_{\alpha}^\pm &= \frac 12 \frac{\displaystyle\int_S \[\hat{\vec E}_{0,\alpha}^\ast \cdot \hat{\vec E} \pm \(\frac{\omega}{k_\alpha}\)^2 \hat{\vec B}_{0,\alpha}^\ast \cdot \hat{\vec B}\]\,\d S}{\displaystyle\int_S \hat{\vec E}_{0,\alpha}^\ast \cdot \hat{\vec E}_{0,\alpha}\,\d S}\exp\(\pm\i k_\alpha z\),
    \end{align}
    where $S$ is an arbitrary cross-section of the waveguide.
    
    These two results combined lead to a powerful conclusion: the tangential fields within an arbitrary cross-section of the waveguide fully determine the field everywhere within the waveguide. This means that if the tangential components of the electric and magnetic fields are known on a single transverse plane, the entire field distribution within the waveguide can be uniquely determined, both in the transverse plane and along the direction of propagation.
\end{remark}

\begin{example}[TE waves in a rectangular waveguide]
    \label{example:te-waves-in-a-rectangular-waveguide}
    This example explores the specific case of TE waves within a rectangular waveguide. A waveguide with height $a$ in the $x$-direction and width $b$ in the $y$-direction is considered, the $z$-axis again being aligned with the waveguide's longitudinal direction. The objective is to derive an expression for the longitudinal component of the magnetic field, $B_z$, using the method of separation of variables. This method involves assuming that, for every $x$ and $y$, $B_z(x,y)$ can be expressed as the product of two independent functions, $X(x)$ and $Y(y)$.

    Substituting this product into \cref{eq:guided-wave-bz} yields a differential equation that can be rearranged by dividing through by $B_z$. This rearranged equation reveals that the $x$-dependent and $y$-dependent terms must be constant, leading to two ordinary differential equations,\\
    \begin{subequations}
        \label[pluralequation]{subeq:rectangular-waveguide-te-odes}
        \begin{align}
            \label{eq:rectangular-waveguide-te-ode-x}
            \frac1X X'' &= -k_x^2,
        \\
            \label{eq:rectangular-waveguide-te-ode-y}
            \frac1Y Y'' &= -k_y^2.
        \end{align}
    \end{subequations}
    Additionally, a relationship between the separation constants, $k_x$ and $k_y$, and the wave number, $k$, is established:
    \begin{align}
        \label{eq:rectangular-waveguide-te-k}
        -k_x^2-k_y^2+\(\frac\omega c\)^2 - k^2 &= 0.
    \end{align}

    \Cref{eq:rectangular-waveguide-te-ode-x} is a simple second-order ordinary differential equation with a general solution
    \begin{align}
        X(x) &= A\sin(k_xx)+B\cos(k_xx).
    \end{align}
    Furthermore, boundary conditions must be applied to determine the particular solution. The boundary condition~\eqref{eq:guided-waves-boundary-condition-b} enforces the vanishing of $B_x$ at $x=0$ and $x=a$. According to \cref{eq:guided-wave-bx}, this translates to enforcing the vanishing of $\partial_xB_z = X'$ at those points. This implies $A=0$ and the separation constant $k_x$ must satisfy the condition
    \begin{align}
        \label{eq:rectangular-waveguide-te-kx}
        k_x &= \frac{m\pi}{a},\quad m \in \N_0.
    \end{align}
    Similarly, for the function $Y(y)$, the boundary condition leads to the condition
    \begin{align}
        \label{eq:rectangular-waveguide-te-ky}
        k_y &= \frac{n\pi}{b},\quad n \in \N_0.
    \end{align}
    Combining these results, the particular solution for $B_z$ takes the form of
    \begin{align}
        \label{eq:rectangular-waveguide-te-bz}
        B_z(x,y) &= B_0\cos\(\frac{m\pi}{a}x\)\cos\(\frac{n\pi}{b}y\),
    \end{align}
    representing the $\TE mn$ wave with the corresponding wavenumber given by \cref{eq:rectangular-waveguide-te-k}. This information is a complete solution to the wave propagation since the remaining field components are provided by \cref{subeq:guided-wave-transverse-fields}.

    Examining \cref{eq:rectangular-waveguide-te-k}, it becomes evident that if the frequency falls below a specific \emph{cutoff frequency},
    \begin{align}
        \label{eq:cutoff-frequency}
        f_{mn} \equiv \frac c2\sqrt{\(\frac ma\)^2 + \(\frac nb\)^2},
    \end{align}
    \index{cutoff frequency}
    the wavenumber becomes imaginary. This signifies that the wave cannot propagate and instead decays exponentially within the waveguide. Such solutions are referred to as \emph{evanescent waves}. This cutoff frequency depends  on the mode numbers $(m, n)$ and the waveguide dimensions $(a, b)$. Modes having the same cutoff frequency are called \emph{degenerate}.
    \index{degenerate modes}

    The wavelength corresponding to wavenumber $k$ in the direction of guided wave propagation is called the \emph{guide wavelength} and is given by
    \begin{align}
        \label{eq:guide-wavelength}
        \lambda_{\mathrm g} \equiv \frac{2\pi}{k} &= \frac{\lambda}{\sqrt{1-\(\dfrac{f_{mn}}{f}\)^2}} = \frac{\lambda}{\sqrt{1-\(\dfrac{\lambda}{\lambda_{mn}}\)^2}}.
    \end{align}
    \index{guide wavelength}
    This guide wavelength is related to the free-space wavelength, $\lambda$, and the cutoff wavelength, $\lambda_{mn}$, for the $\TE mn$ mode.
\end{example}

The analysis presented in this chapter establishes the fundamental principles governing electromagnetic wave propagation in waveguides, with a particular focus on rectangular geometries. The concept of cutoff frequency, below which waves become evanescent, has been introduced, and its dependence on waveguide dimensions and mode numbers has been highlighted. This understanding is crucial for the design of waveguide-based components, as it dictates the operational frequency range and the selection of appropriate waveguide dimensions to support the desired modes. Furthermore, the distinction between propagating and evanescent modes is essential for optimizing the performance of the polarizer and the feeding structure, which will be discussed in subsequent chapters. By carefully considering the cutoff frequencies of different modes, the design can be tailored to ensure that only the desired modes propagate efficiently while undesired modes are effectively suppressed. This modal selectivity is key in achieving high polarization purity and minimizing signal loss in the overall antenna system.

\chapter{Polarizer}
\label{chapter:polarizer}
The design process of a waveguide polarizer is detailed in this chapter. An initial survey of existing literature, including relevant conference papers and research articles, is undertaken. Based on this survey, the performance characteristics of various design concepts are compared and contrasted. A solution to the design problem is proposed, with a rationale for the selected approach. Following this selection, an in-depth eigenmode analysis of the chosen structure is performed. As demonstrated in this chapter, this analysis yields crucial insights into the operational principles, allows for the recognition of key performance parameters, and provides the foundation for defining the optimization problem. The chosen structure is subsequently implemented and optimized within CST Studio Suite for a specified target frequency band. The inherent trade-offs between key performance parameters are then discussed with reference to established principles of guided wave propagation in rectangular waveguides. Finally, the simulated performance of the designed component is presented graphically, derived from full-wave simulations.

\section{Principle of operation}
Typically, the inherent characteristics of symmetric waveguides are leveraged to achieve polarization transformation. This choice stems from their unique ability to enable independent control over two orthogonal polarization states possessing identical propagation characteristics. Such independent control is essential for polarization manipulation, facilitating the adjustment of these orthogonal modes' relative phase and amplitude to achieve the desired polarization states. This capability is applied directly in the design of the dual linear-to-circular polarizer detailed herein. The desired polarization states of RHCP and LHCP were elaborated on mathematically in \cref{subsection:the-wave-equations}.

This crucial characteristic arises from two fundamental properties rooted in the electrodynamics of symmetric waveguides. Firstly, their geometric symmetry, manifesting as mirror or rotational symmetry, permits the existence of two fundamental degenerate modes. As illustrated in \cref{example:te-waves-in-a-rectangular-waveguide}, a square waveguide exhibits this characteristic with its $\TE 10$ and $\TE 01$ modes. Secondly, as detailed in \cref{remark:modal-decomposition-of-guided-waves}, a fundamental principle derived from Maxwell's equations dictates that any two distinct modes within a waveguide are mutually orthogonal. This orthogonality expressed mathematically in \cref{eq:mode-orthogonality}, ensures that the power flow associated with the interaction of any two distinct modes is zero. In essence, transverse symmetry enables the existence of orthogonally polarized modes, while their inherent orthogonality ensures their independent propagation without coupling or interference.

The description of circular polarization expressed compactly in \cref{eq:polarization-circular-condition} establishes a clear objective for the design of a waveguide polarizer: the creation of a segment, based on a symmetrical waveguide, that introduces a one-quarter wavelength phase difference between the two orthogonal modes along its length while maintaining equal magnitudes. In subsequent design stages, this latter criterion is quantified by a singular metric known as the \emph{axial ratio} of the emitted wave, characterizing the polarization purity based on its far-field properties. Several widely adopted approaches exist for achieving these objectives; these may be referred to as standard methods. Notable examples include the following:
\begin{itemize}
    \item \emph{Dielectric vane polarizers} utilize a dielectric element (a so-called quarter-wave plate) inserted into a segment of a symmetrical waveguide at an angle of $\pm \ang{45}$ relative to the incident electric field. The inserted dielectric introduces a difference in the propagation velocities of the two orthogonal modes along this segment. This differential propagation velocity arises from the interaction of one mode with the vane, which reduces its propagation velocity due to its parallel orientation relative to the vane. In contrast, the orthogonal mode remains unaffected due to its perpendicular orientation.

    \item \emph{Septum polarizers} comprise two rectangular ports converging at a stepped septum and extending into a symmetrical waveguide. When the structure is excited through one of these ports, the septum polarizer converts approximately half of the incident energy to the orthogonal polarization, achieving circular polarization by introducing a one-quarter wavelength phase shift at the output port. Excitation of the structure through the alternate port results in circular polarization of the opposite handedness.

    \item \emph{Iris polarizers} utilize symmetrical waveguides with non-trivial cross-sections, incorporating ridges, also called corrugations or irises, typically positioned symmetrically on two opposing sides. These polarizers operate on a linearly polarized wave incident diagonally into the waveguide. In this configuration, the ridges present inductive characteristics to one of the waveguide modes and capacitive characteristics to the orthogonal mode. This differential interaction results in a one-quarter wavelength phase delay at the output port.
\end{itemize}

\section{Literature survey}
While the methods established above can be refined and adjusted to achieve favorable results in typical metrics for linear-to-circular polarizers, each also exhibits inherent limitations. While simple to implement, dielectric vane polarizers encounter narrow bandwidth issues and suffer from significant power limitations due to inherent dielectric losses. The dielectric losses are encompassed in \cref{eq:wave-number} as any real dielectric exhibits a small but non-zero conductivity $\sigma > 0$. These losses become particularly pronounced at higher frequencies and power levels, restricting their applicability in certain scenarios. In contrast, septum polarizers offer promising capabilities for a wide range of applications, particularly in power handling and the efficient generation of both right-hand and left-hand circular polarization. As noted by~\parencite{ruiz-cruz-et-al:compact-reconfigurable-waveguide-circular-polarizer}, modifications to septum designs, such as integrating RF MEMS switches, can effectively achieve reconfigurability and control over the handedness of the produced circular polarization. However, the size and weight of septum structures can pose significant constraints, especially in compact or weight-sensitive applications. Furthermore, as highlighted by~\parencite{wang-et-al:novel-square-rectangle-waveguide-septum-polarizer}, alternative septum geometries, such as tapered slots, while offering potential design variations, do not necessarily demonstrate substantial performance improvements over conventional stepped septum designs. While capable of converting linearly polarized input into circular polarizations and operating at higher power levels, iris polarizers often exhibit challenges related to \enquote{overmoding} within their structures, necessitating precise mode-matching to maintain a satisfactory axial ratio across a broad frequency band. As observed by~\parencite{song-et-al:design-of-wideband-quad-ridge-waveguide-polarizer}, variations in iris design, such as incorporating ridges on four sides instead of two, can be explored. Moreover, as emphasized by~\parencite{virone-et-al:optimum-iris-set-concept-for-waveguide-polarizers}, the design of iris arrays requires extensive analysis of the optimal geometry, often involving complex mathematical techniques, to achieve desired performance characteristics. This complexity is further compounded when considering wider bandwidth operation, as noted by~\parencite{piltyay-et-al:new-tunable-iris-post-square-waveguide-polarizers-for-satelliste-information-systems}, which may necessitate cascading individual sections and careful consideration of different ridge types and transmission matrix approaches. Finally, as demonstrated by~\parencite{deutschmann-arne:broadband-septum-polarizer-with-triangular-common-port}, innovative manufacturing techniques, such as additive manufacturing, combined with alternative waveguide geometries like triangular waveguides, offer potential avenues for further advancement in polarizer design, encompassing design, manufacturing, and measurement aspects.

An approach diverging from these standard methods is designing waveguide geometries utilizing mode dispersion to manipulate electromagnetic waves. Two prominent examples of modified waveguides include elliptical and waveguides with shaped metallic inserts. As demonstrated in~\parencite{yu-et-al:a-wideband-circularly-polarized-horn-antenna-with-a-tapered-elliptical-waveguide-polarizer}, in the context of a wideband circularly polarized horn antenna, elliptical waveguides leverage their inherent anisotropy to induce the required phase shift. The use of tapered elliptical waveguides, as also explored in~\parencite{yu-et-al:a-wideband-circularly-polarized-horn-antenna-with-a-tapered-elliptical-waveguide-polarizer}, facilitates wideband operation. On the other hand, waveguides with shaped metallic inserts introduce field perturbations to achieve the desired polarization transformation. As shown in~\parencite{rud-shpachenko:polarizers-on-sections-of-square-waveguides-with-inner-corner-ridges,bhardwaj-volakis:hexagonal-waveguides-new-class-of-waveguides-for-mmwave-circularly-polarized-horns,bhardwaj-volakis:hexagonal-waveguide-based-circularly-polarized-horn-antennas-for-submmwave-terahertz-band,bhardwaj-volakis:circularly-polarized-horn-antennas-for-terahertz-communications-using-differential-mode-dispersion-in-hexagonal-waveguides}, these inserts can take various forms, including square or triangular blocks inserted into diagonally opposite corners of a square waveguide. Due to the modified geometry and resulting boundary conditions of such waveguides, their modes experience variations in their transverse field distributions and, consequently, their effective transverse wavenumbers. This difference in transverse wavenumbers necessitates a corresponding difference in their longitudinal wavenumbers, or phase constants, to satisfy the waveguide's dispersion relation, which links the transverse and longitudinal wavenumbers. Consequently, an accumulative phase difference develops between the modes as they propagate along the length of the polarizer. Furthermore, as explored in~\parencite{garcia-marin-masa-campos:bowtie-shaped-radiating-element-for-single-and-dual-circular-polarization}, more optimal cross-sectional shapes, such as a bow-tie configuration, can enhance performance, although often at the expense of increased manufacturing complexity. While the higher frequency regions targeted in most of the explored articles are not the primary focus of this work, the underlying principles of achieving polarization control through modified waveguide cross-sections provide valuable insights and inspiration for the design of the polarizer presented herein.

\begin{figure}[!hbt]
    \centering
    \begin{subfigure}{.45\textwidth}
        \centering
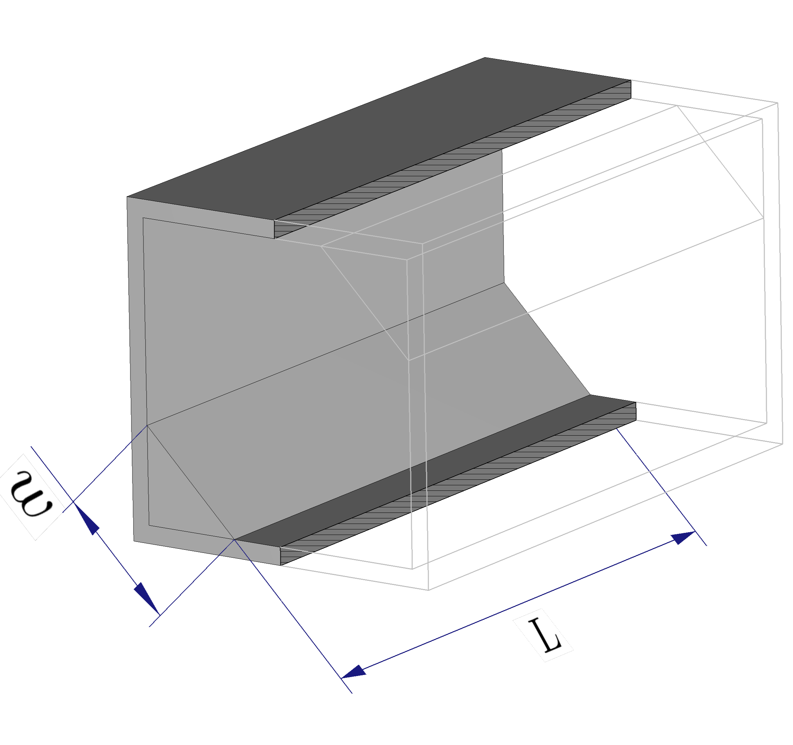
[picture p72: latex/src/polarizer_square_perspective.png]
        
        \caption{\label{fig:polarizer-square-perspective}}
    \end{subfigure}
    \hfill
    \begin{subfigure}{.45\textwidth}
        \centering
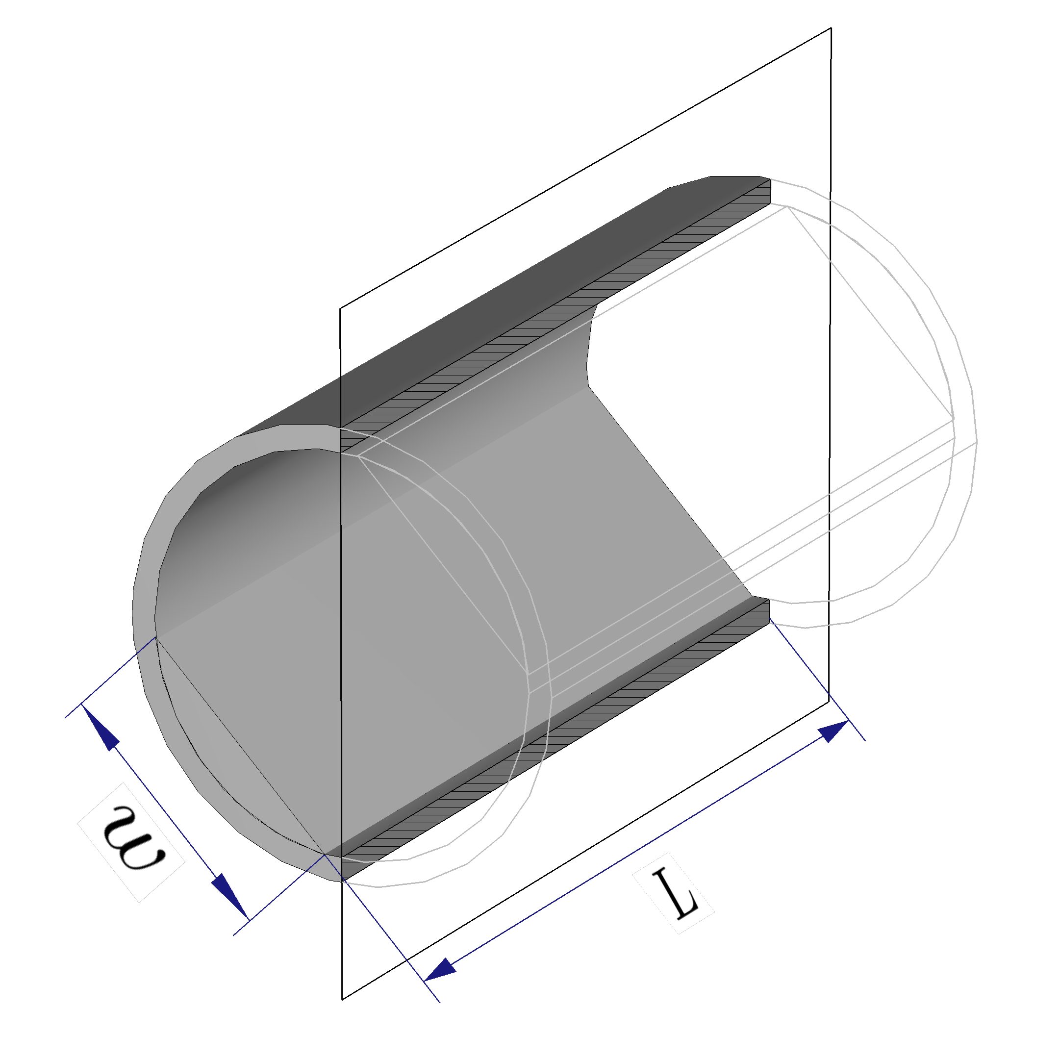
[picture p73: latex/src/polarizer_circular_perspective.png]
        
        \caption{\label{fig:polarizer-circular-perspective}}
    \end{subfigure}
    \caption{\label{fig:polarizers}Symmetric polarizers: models}
\end{figure}

\paragraph{Selected approach.} This thesis introduces a novel approach to achieving enhanced polarization purity using a straightforward and robust cross-sectional geometry. This geometry is realized by inserting simple shapes into two opposing sides of a waveguide's cross-section. Initially, both square and circular waveguides, each suitable for dual linear-to-circular polarization conversion, are examined and compared to determine the more advantageous geometry. For the square waveguide illustrated in \cref{fig:polarizer-square-perspective}, triangular prisms are inserted into two opposing corners, forming a hexagonal waveguide studied in~\parencite{bhardwaj-volakis:hexagonal-waveguides-new-class-of-waveguides-for-mmwave-circularly-polarized-horns}. At the same time, cylindrical segments are used for the circular waveguide in \cref{fig:polarizer-circular-perspective}. This concept is inspired by the established technique of achieving circular polarization with a square patch antenna by chamfering its opposing corners. The resulting cross-sections can be considered Babinet-complementary%
    \footnote{This name refers to the notion of complementary structures according to \emph{Babinet's principle}, derivation of which is out of scope for this text. More details can be found, e.g., in~\parencite{born-wolf:principles-of-optics}.}
to this antenna configuration.

This approach was selected primarily for its relative ease of fabrication, particularly at higher frequencies, and its potential for adaptation to various frequency bands. However, due to the resonant, and hence geometry-dependent, nature of the mode dispersion introduced by the metallic inserts, optimal performance is anticipated over a moderately wide bandwidth rather than an ultrawide one. This bandwidth limitation represents a trade-off for the design's simplicity, robustness, and manufacturability. Triangular prisms, in particular, simplify fabrication compared to more complex curved geometries while providing effective field manipulation for polarization control.

\section{Eigenmode analysis}
The focus now shifts to the \emph{eigenmode analysis} of the two waveguides illustrated in \cref{fig:polarizers}. This powerful technique, based on the theory outlined in \cref{remark:modal-decomposition-of-guided-waves}, facilitates the establishment of figures of merit intrinsic to polarizing structures, enabling performance tracking and aiding in the determination of the more advantageous geometry.

Initially, the fundamental propagation modes in the symmetric waveguides are considered \emph{without} the inserted shapes. In the case of the square waveguide, it is the $\TE 10$ and $\TE 01$ modes illustrated in \cref{fig:square-waveguide-mode1,fig:square-waveguide-mode2}, whereas the two degenerate $\TE 11$ modes%
    \footnote{Note that circular waveguides posses an infinite number of degenerate $\TE 11$ modes due to their rotational symmetry. Here, two are chosen for their perpendicular oscillations which aligns well with the definition of circular polarization in \cref{subsection:polarization}.}
of the circular waveguide are presented in \cref{fig:circular-waveguide-mode1,fig:circular-waveguide-mode2}. For both waveguides individually, these two degenerate modes represent the waves launched into the polarizer via a standard waveguide section. Upon encountering the metallic inserts, incident waves can no longer be represented by the eigenmodes of the simple waveguide structure; their energy is coupled into a linear combination of the fundamental eigenmodes of the respective polarizer.

\begin{figure}
    \centering
    \begin{subfigure}{.45\textwidth}
        \centering
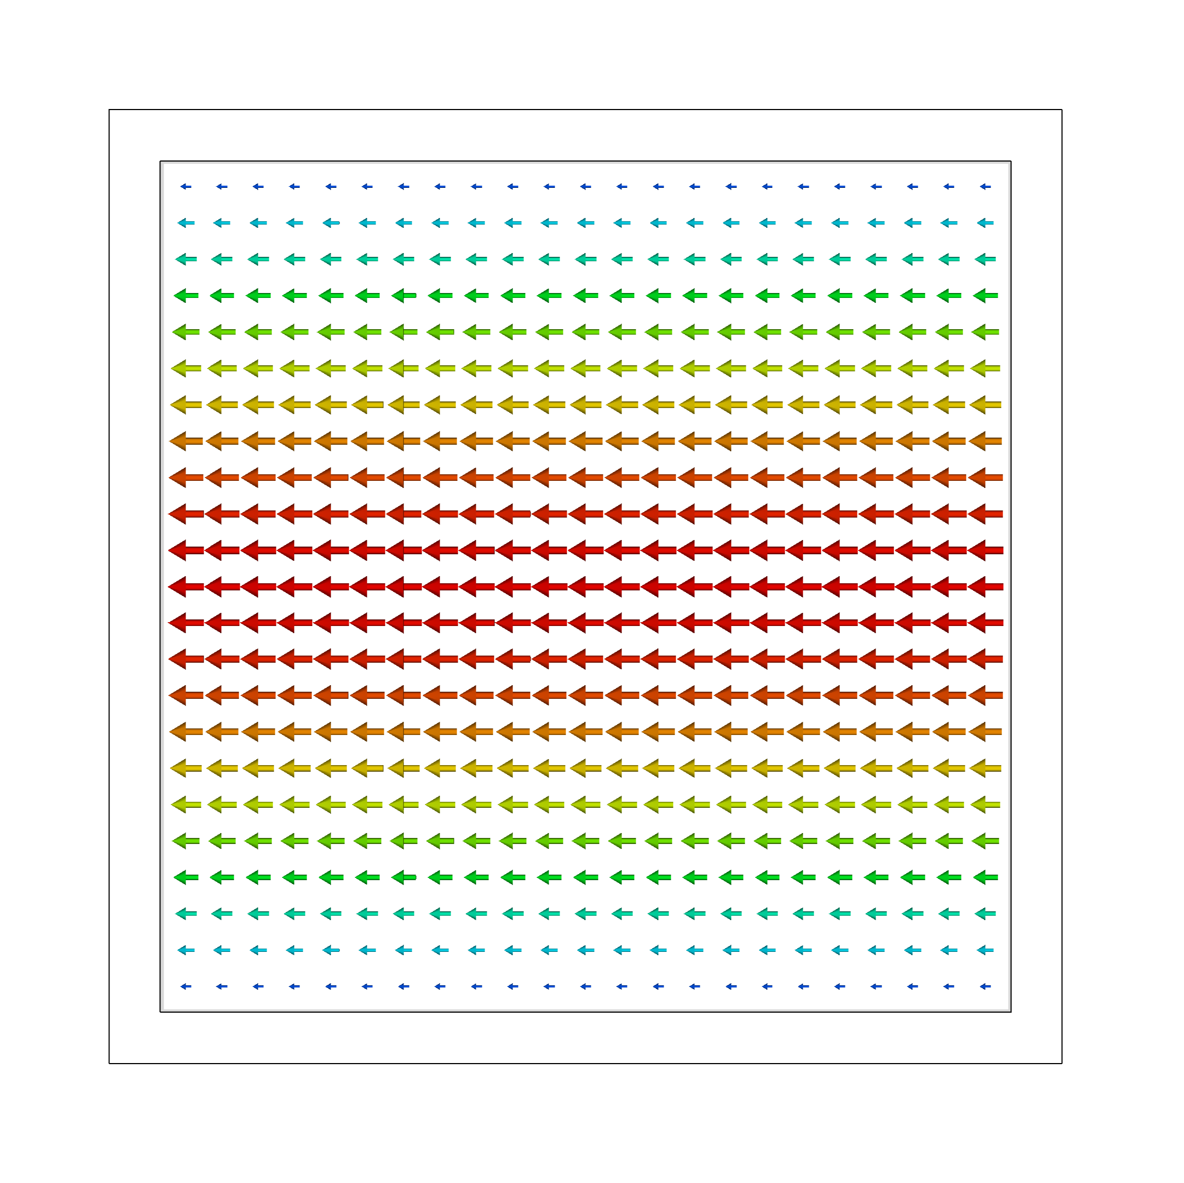
[picture p74: latex/src/waveguide_square_mode1.png]
        
        \caption{\label{fig:square-waveguide-mode1}}
    \end{subfigure}
    ~
    \begin{subfigure}{.45\textwidth}
        \centering
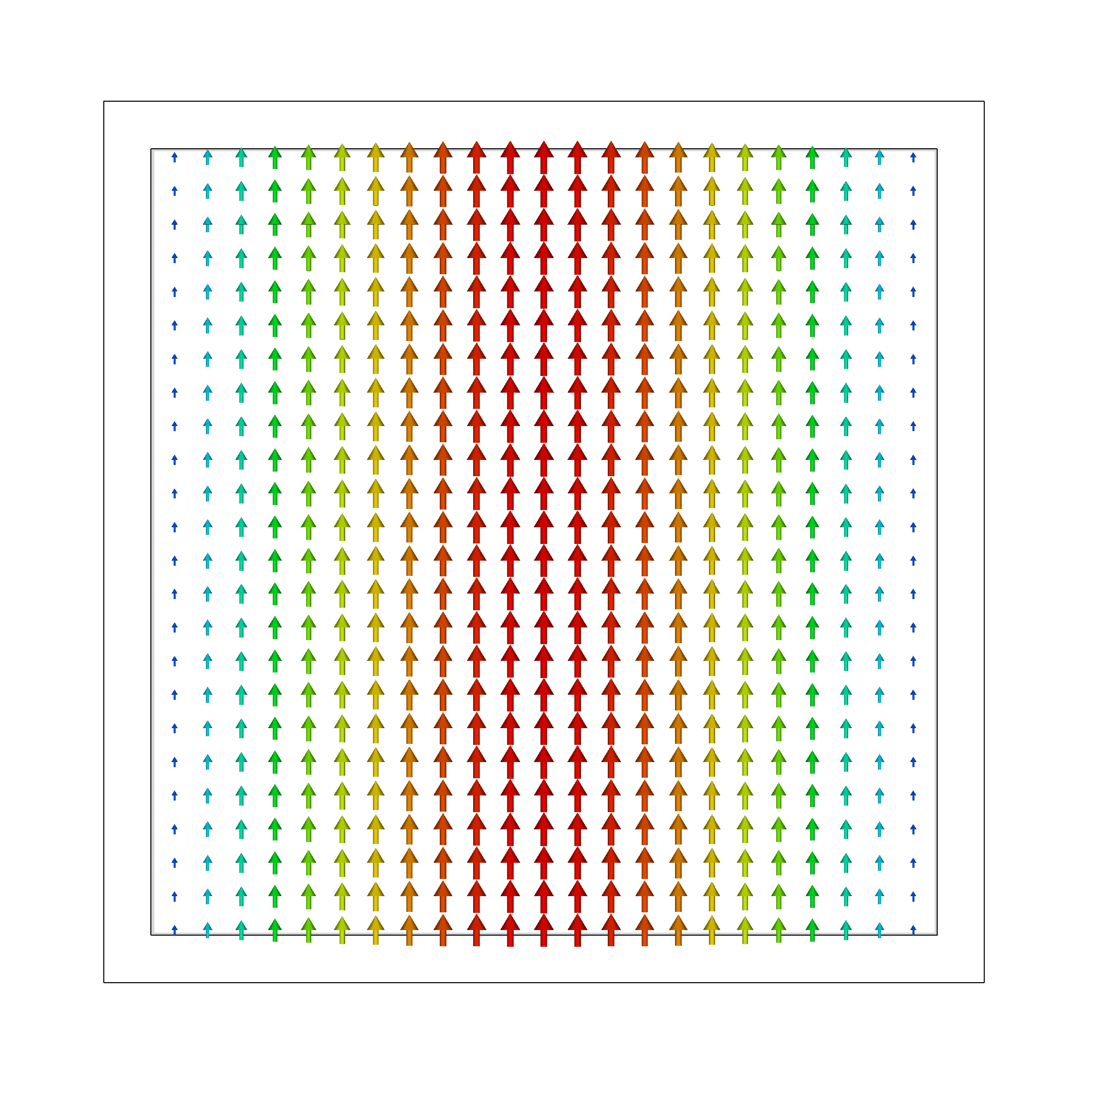
[picture p75: latex/src/waveguide_square_mode2.png]
        
        \caption{\label{fig:square-waveguide-mode2}}
    \end{subfigure}
    \\
    \begin{subfigure}{.45\textwidth}
        \centering
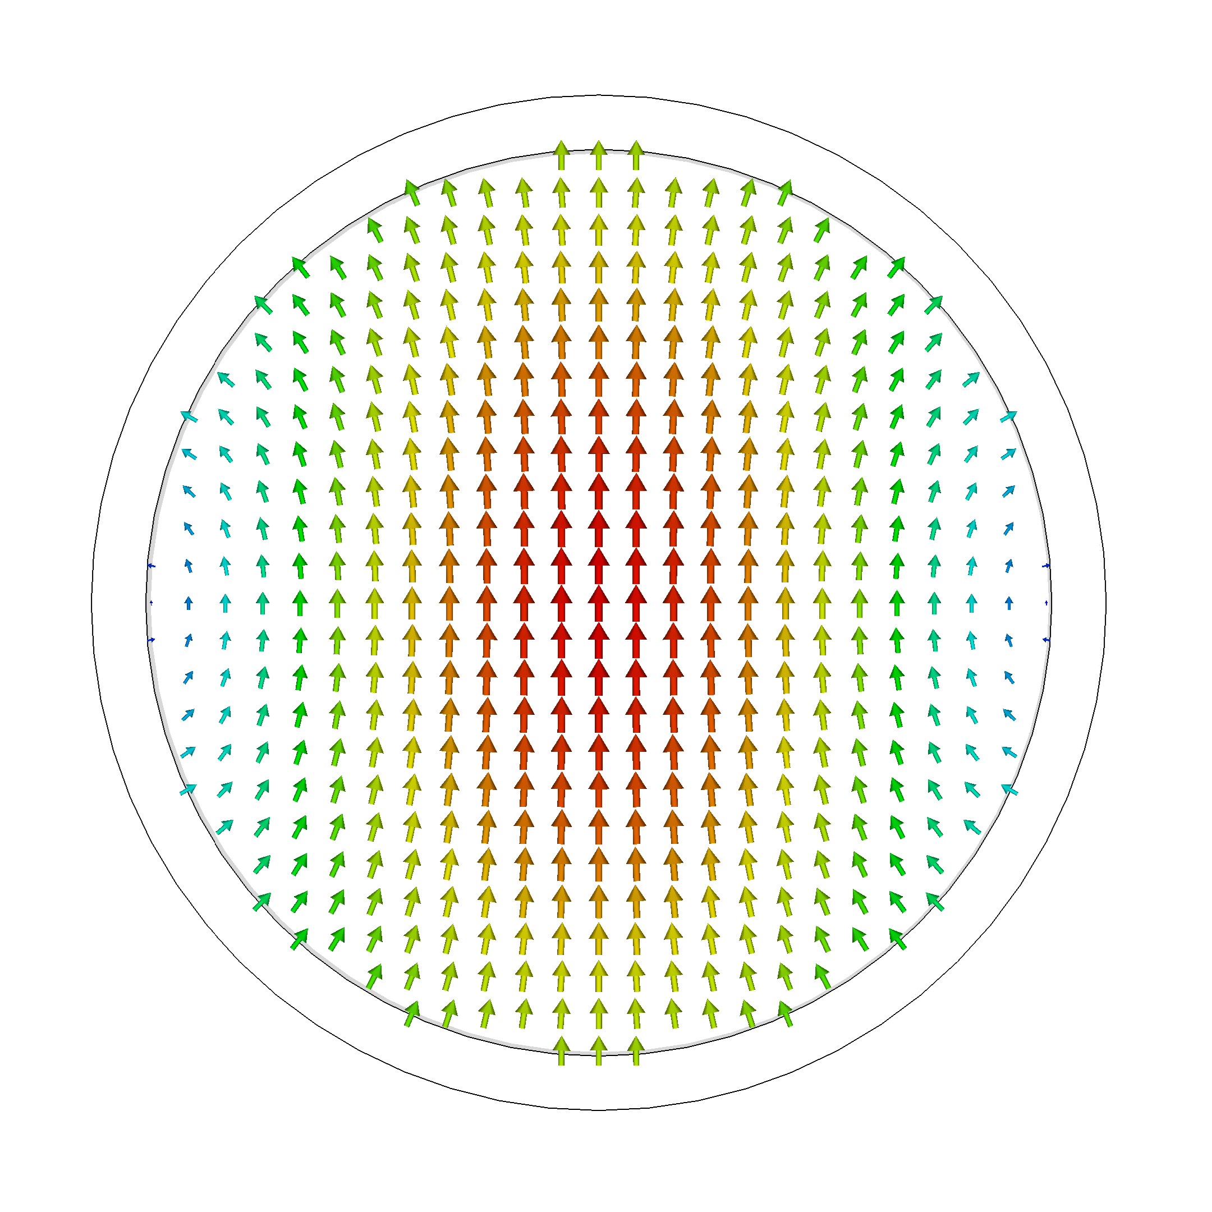
[picture p76: latex/src/waveguide_circular_mode1.png]
        
        \caption{\label{fig:circular-waveguide-mode1}}
    \end{subfigure}
    ~
    \begin{subfigure}{.45\textwidth}
        \centering
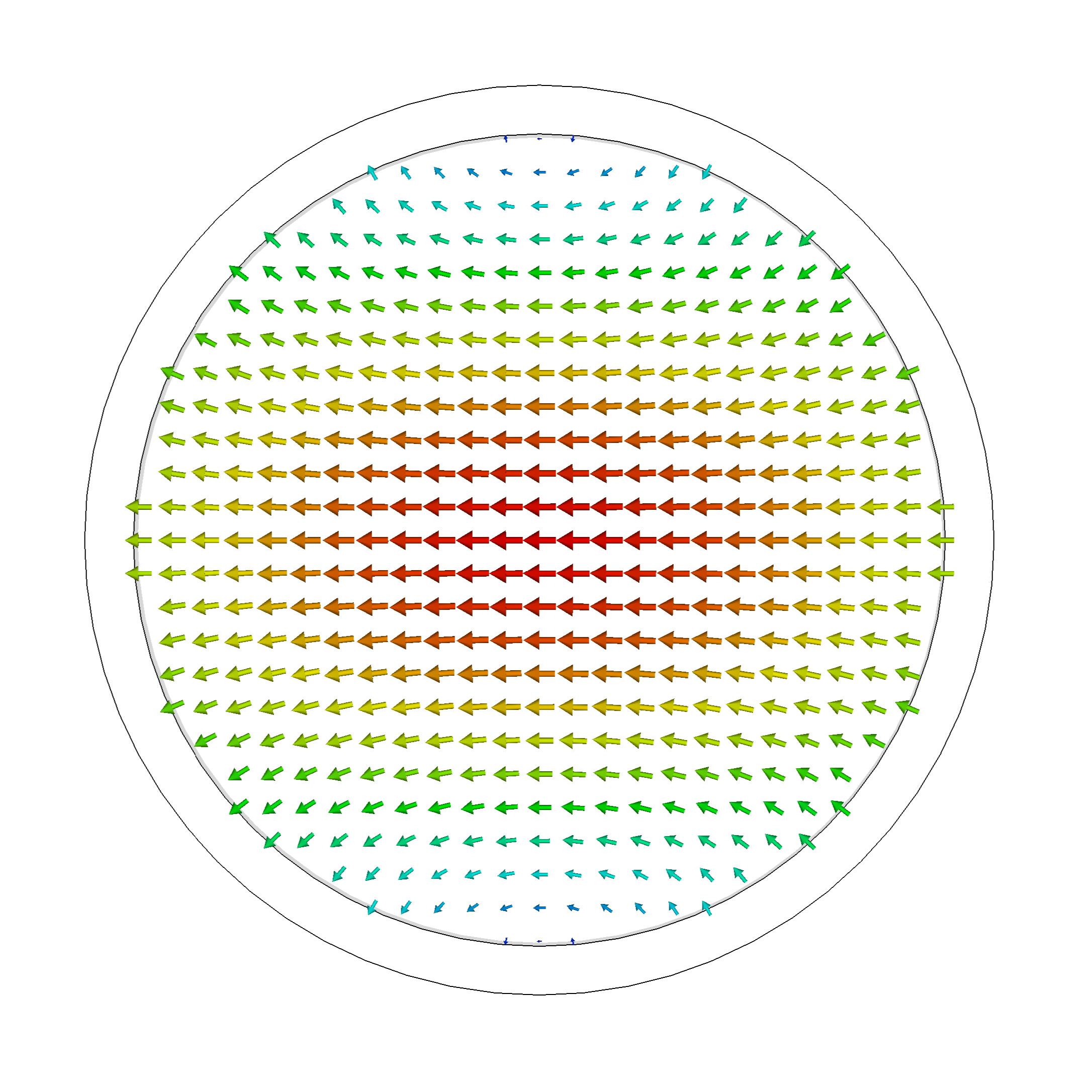
[picture p77: latex/src/waveguide_circular_mode2.png]
        
        \caption{\label{fig:circular-waveguide-mode2}}
    \end{subfigure}
    \caption{\label{fig:symmetric-waveguide-modes}Symmetric waveguides: fundamental modes}
\end{figure}

\begin{figure}
    \centering
    \begin{subfigure}{.45\textwidth}
        \centering
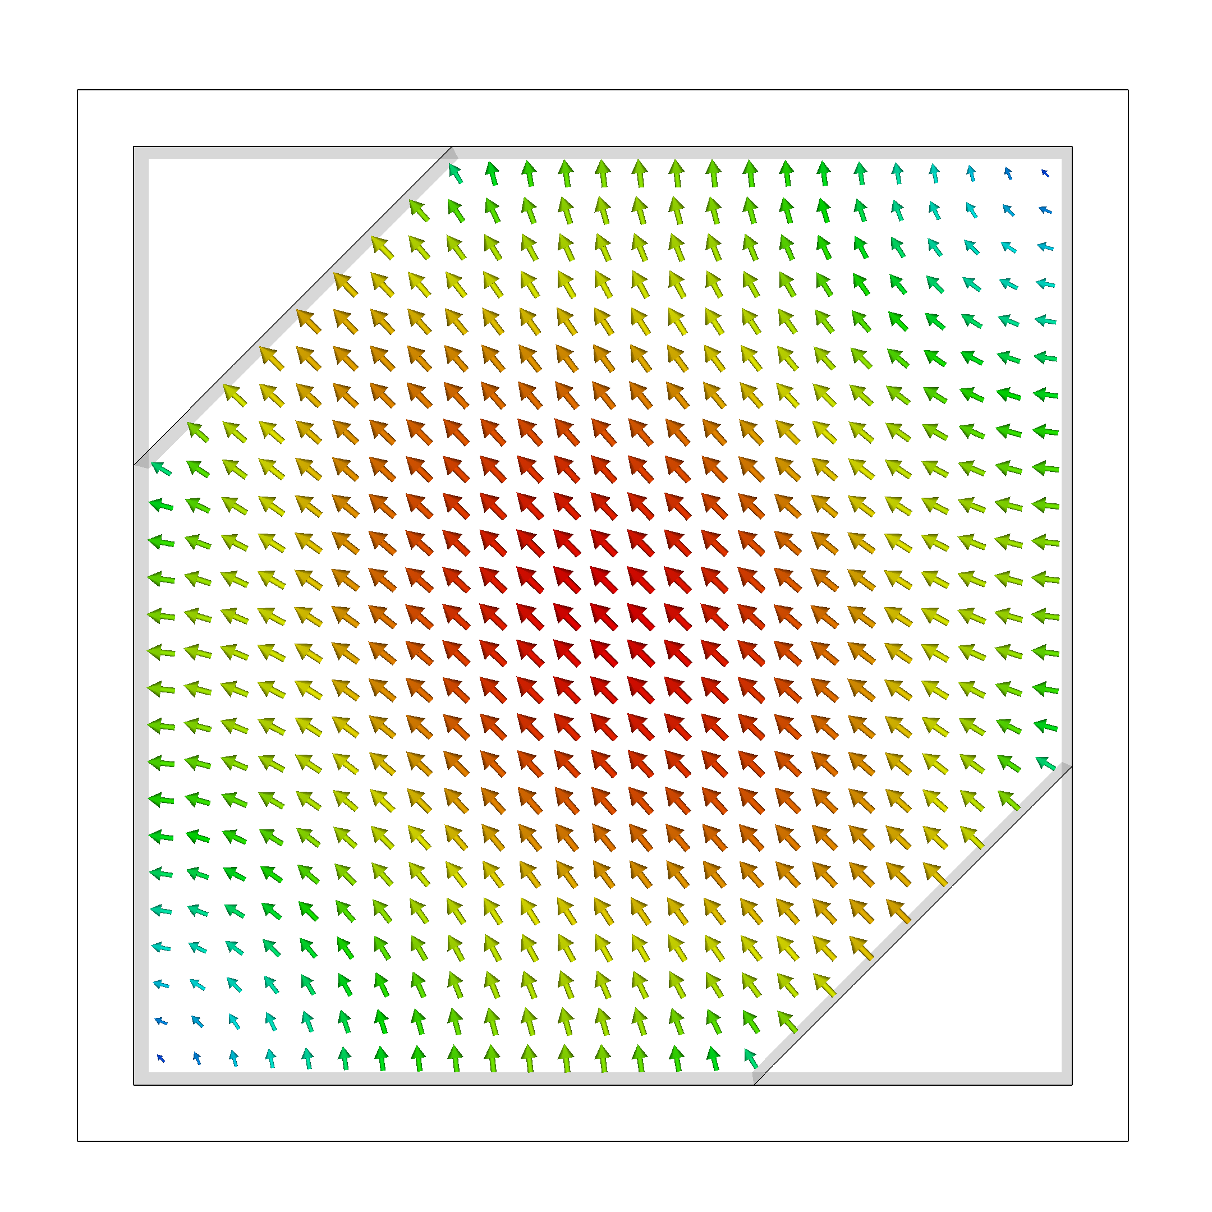
[picture p78: latex/src/polarizer_square_mode1.png]
        
        \caption{\label{fig:square-polarizer-mode1}}
    \end{subfigure}
    ~
    \begin{subfigure}{.45\textwidth}
        \centering
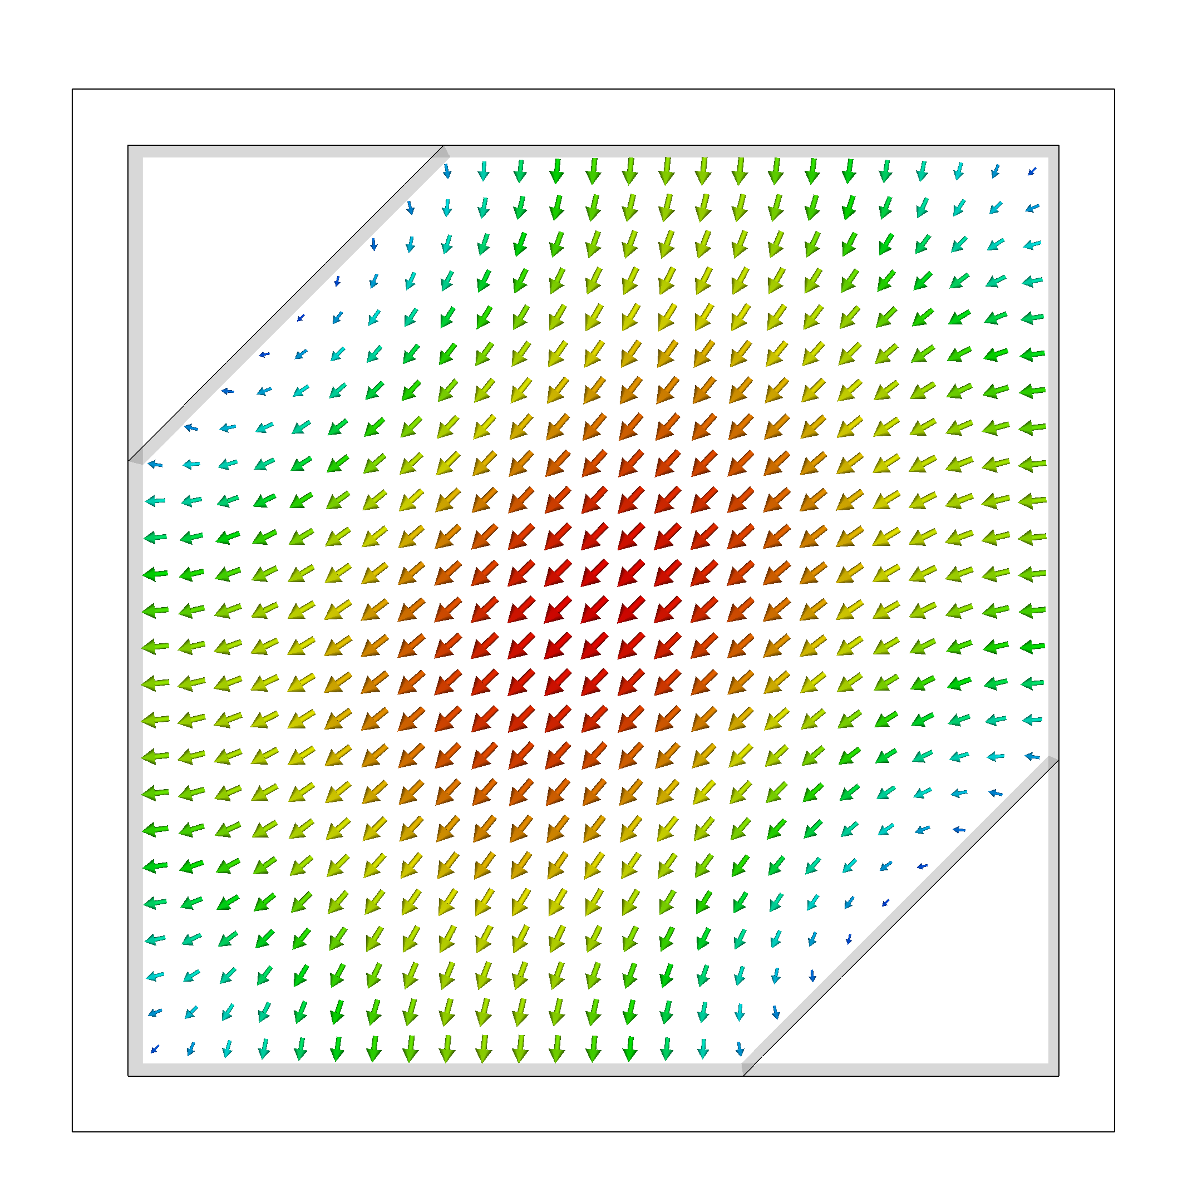
[picture p79: latex/src/polarizer_square_mode2.png]
        
        \caption{\label{fig:square-polarizer-mode2}}
    \end{subfigure}
    \\
    \begin{subfigure}{.45\textwidth}
        \centering
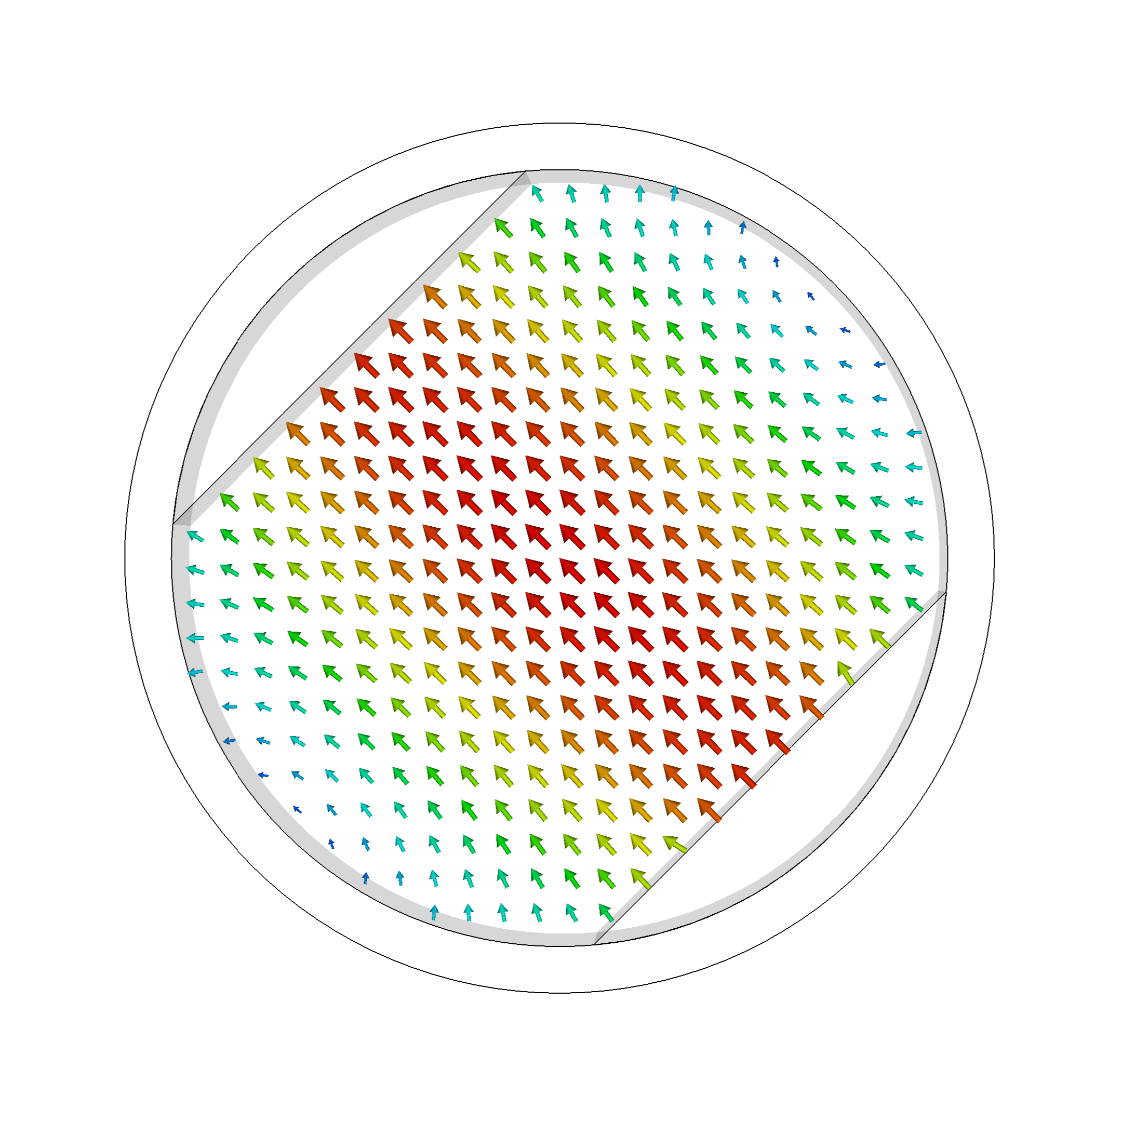
[picture p80: latex/src/polarizer_circular_mode1.png]
        
        \caption{\label{fig:circular-polarizer-mode1}}
    \end{subfigure}
    ~
    \begin{subfigure}{.45\textwidth}
        \centering
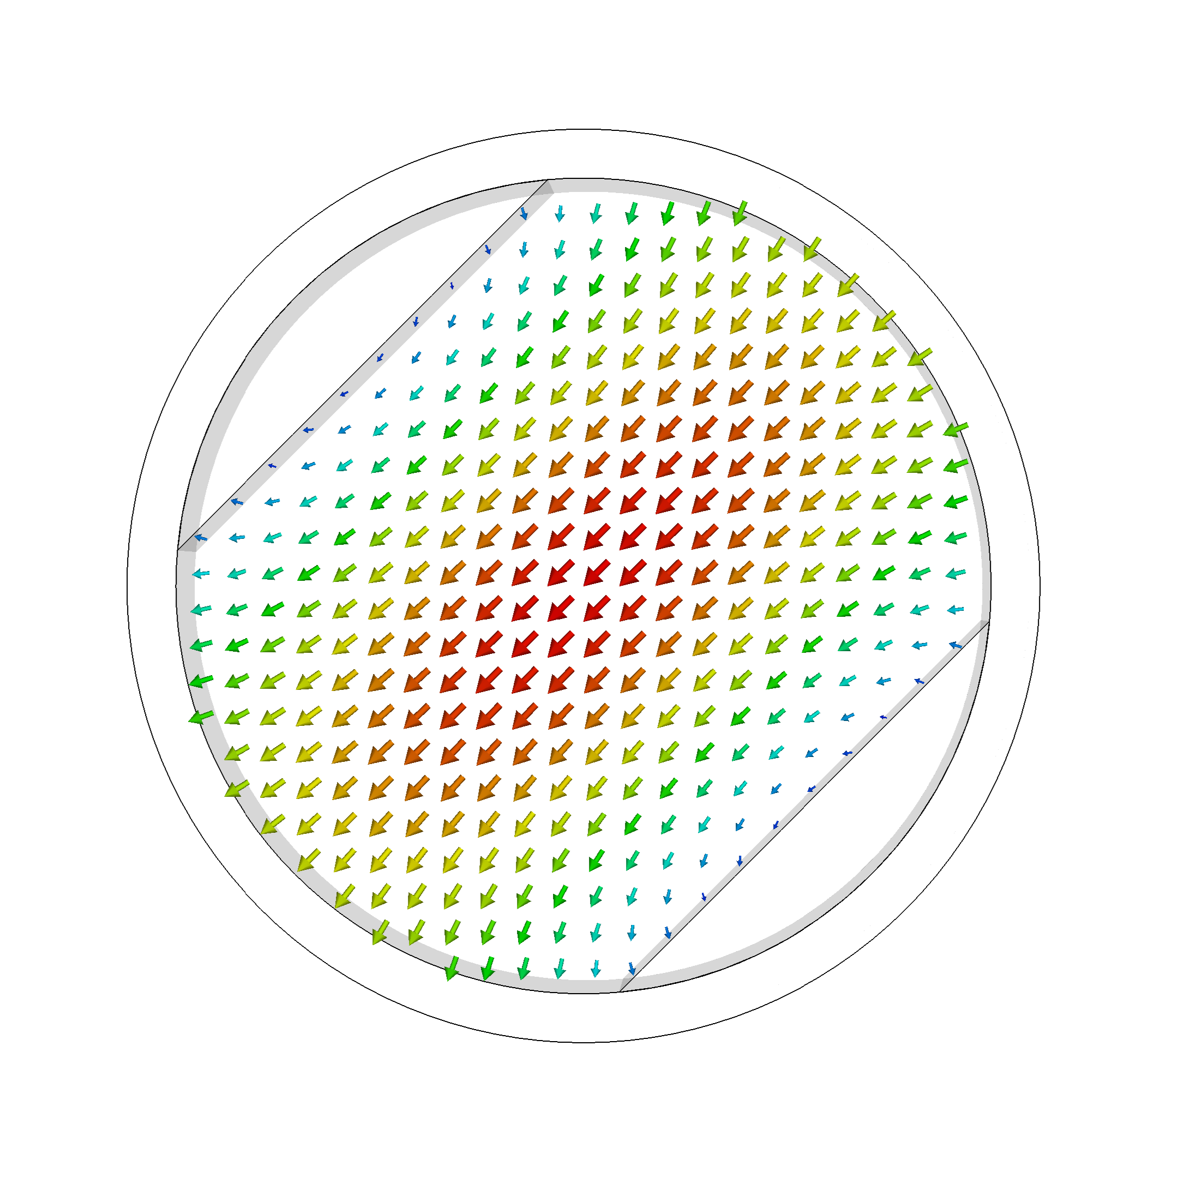
[picture p81: latex/src/polarizer_circular_mode2.png]
        
        \caption{\label{fig:circular-polarizer-mode2}}
    \end{subfigure}
    \caption{\label{fig:symmetric-polarizer-modes}Symmetric polarizers: fundamental modes}
\end{figure}

With the incident modes established, the eigenmodes of the polarizers, which are the identical waveguides but now \emph{with} the shapes inserted, are analyzed. The eigenmodes take the form presented in \cref{fig:square-polarizer-mode1,fig:square-polarizer-mode2} for the square geometry, whereas the circular waveguide with inserts supports two fundamental modes depicted in \cref{fig:circular-polarizer-mode1,fig:circular-polarizer-mode2}. As expected, the transverse field exhibits a standing wave behavior in both cases as dictated by the boundary conditions on a conductive surface. More importantly, for the polarization transformation, the metallic shapes perturb the electromagnetic fields, changing the propagation constants of the existing modes. Crucially, the presence of these inserts breaks the original symmetry of the waveguide, causing a dispersion, or difference in phase velocity, between the two fundamental modes of propagation. This fact is illustrated in \cref{fig:symmetric-polarizer-modes}, wherein in both geometries, one of the modes perceives a different electric path than the other. This dispersion is the key mechanism for achieving circular polarization. The phase difference between the two fundamental modes accumulates as the electromagnetic wave propagates along the waveguide. This cumulative phase lag can be precisely controlled by carefully selecting the geometry and placement of the inserts and the length of the waveguide. In the context of a polarizer designed to generate circular polarization, the goal is to achieve precisely one-quarter wavelength phase difference between the two modes at the output. As shown in \cref{eq:polarization-circular-condition}, this quadrature phase relationship, combined with equal amplitudes of the two modes, generates a circularly polarized wave. The eigenmode analysis allows for accurately determining the modal field distributions, enabling precise design and optimization of the polarizer to achieve the desired phase shift and polarization state.

\begin{remark}[Dual polarization capability]
    \label{remark:dual-polarization-capatibility}
    It is important to note that, concerning the diagonal symmetry of the polarizer, one of its eigenmodes is always antisymmetric. This implies that if exciting the square-waveguide-based polarizer with the $\TE 01$ results in RHCP, the $\TE 10$ must result in LHCP, or vice versa, depending on the choice of the transverse coordinates.
    
    This principle can be visualized as decomposing the incident waveguide modes from \cref{fig:square-waveguide-mode1,fig:square-waveguide-mode2} into the orthogonal basis formed by polarizer eigenmodes depicted in \cref{fig:square-polarizer-mode1,fig:square-polarizer-mode2}. While the horizontal waveguide mode (\cref{fig:square-waveguide-mode1}) can be expressed as a positive sum of the two polarizer modes, the vertical waveguide mode (\cref{fig:square-waveguide-mode2}) requires the negative of the antisymmetric polarizer mode (\cref{fig:square-polarizer-mode2}). Moreover, assuming that the condition for circular polarization \eqref{eq:polarization-circular-condition} is satisfied by the polarizer eigenmodes, taking their positive sum is equivalent to the plus sign option in \cref{eq:polarization-circular-e-r0}, hence RHCP. Conversely, the negative value of the antisymmetric mode represents the negative sign option, hence LHCP. Although this principle was illustrated using the square waveguide structure, the same holds for the circular geometry with its two orthogonal degenerate $\TE 11$ modes (\cref{fig:circular-waveguide-mode1,fig:circular-waveguide-mode2}). This unique property enables the structures to produce dual circular polarization simply by switching between two excitations.

    Furthermore, due to the mirror symmetry of both polarizers, optimizing the structure with respect to just a single orientation of circular polarization is sufficient. By the essence of the matter, the other polarization must retain the same performance parameters, as will be proven by simulation.
\end{remark}

\subsection{Figures of merit}
A crucial outcome of the eigenmode analysis is the insight into the operational principles, which helps define relevant variables and performance parameters intrinsic to the structure's geometry, ultimately aiding in polarizer optimization. The optimization process aims to produce circular polarization while minimizing production costs, primarily by reducing the polarizer length, $L$. This necessitates maximizing the \emph{specific mode phase shift}, given by
\begin{align}
    \label{eq:polarizer-specific-phase-shift}
    \Delta k_L(f) &= \frac 1L \int_0^L \[k_2-k_1\](z,f)\,\d z,
\end{align}
where $k_1$ and $k_2$ are the propagation constants of the two polarizer modes, and $z$ is the Cartesian coordinate aligned with the propagation direction. This quantity represents the average difference in propagation constants between the two modes along the polarizer,%
    \footnote{This quantity is analogous to the birefringence effect observed in optics, where a material exhibits different refractive indices for different polarizations, causing a phase difference to accumulate between them as they propagate. Here, the waveguide structure, due to its geometry, effectively creates different propagation constants for the two orthogonal modes, leading to a similar effect.}
effectively quantifying the rate at which the phase difference between them accumulates as they propagate. However, \cref{eq:polarizer-specific-phase-shift} addresses only one of the two conditions for circular polarization \eqref{eq:polarization-circular-condition}, the other being the requirement for equal mode amplitudes:
\begin{align}
    \label{eq:polarizer-amplitude-ratio}
    \left.\frac{E_2}{E_1}\right|_{z=L} = 1,
\end{align}
where $E_1$ and $E_2$ are the amplitudes of the two modes and the polarizer output. A weighted aggregate of \cref{eq:polarizer-specific-phase-shift,eq:polarizer-amplitude-ratio} forms the objective function of the optimization problem, with the variables being the geometric parameters of the polarizer cross-section. Intuitively, larger inserted shapes induce a greater phase lag per unit length but also introduce more considerable amplitude distortions between the modes. This displays an inherent conflict within the problem, necessitating a trade-off. From an application perspective, a balance must be struck between the length of the structure, which compensates for a lower phase delay per unit length, and polarization purity, which is compromised by unequal mode magnitudes.

\subsection{Comparison of symmetric waveguides}
\label{subsection:comparison-of-symmetric-waveguides}
To conclude the eigenmode analysis, a decision will be made, using the previously introduced figures of merit, regarding which geometry is better suited for polarization control, considering both practical and performance aspects. Ideally, a minimal frequency dependence of both figures, \cref{eq:polarizer-specific-phase-shift,eq:polarizer-amplitude-ratio}, is desired. However, due to the inherently resonant operational principle of the waveguide, achieving feasible performance across an ultrawide band with a single section of such a polarizing structure is not considered possible.

Before proceeding, the practical evaluation of \cref{eq:polarizer-specific-phase-shift,eq:polarizer-amplitude-ratio}  should be addressed. Given that both polarizers are analyzed as uniform waveguides (\cref{fig:polarizer-square-perspective,fig:polarizer-circular-perspective}), the propagation dispersion between the two modes, and consequently both metrics, can be approximated as constant throughout the polarizer, i.e., $\partial_z\Delta k_L=0$. This approximation allows \cref{eq:polarizer-specific-phase-shift} to be expressed as
\begin{align}
    \label{eq:polarizer-phase-shift}
    \Delta k_L(f) &= \[k_2-k_1\](f),
\end{align}
and the overall mode phase shift at the polarizer output is given by
\begin{align}
    \Delta\phi(f) &= L\[k_2-k_1\](f).
\end{align}

Furthermore, this simplification permits evaluating both \cref{eq:polarizer-amplitude-ratio,eq:polarizer-phase-shift} from a single reading at the polarizer output. For this purpose, an \emph{$E$-field probe} functionality within CST Studio Suite was utilized, allowing the magnitude and phase of the electric field to be determined at a specified point in space and evaluated across all frequencies. Consequently, the objective function for maximum specific phase shift, \cref{eq:polarizer-specific-phase-shift}, is transformed into the minimization of
\begin{align}
    \label{eq:polarizer-length-for-90deg}
    L_\perp(f) &= \frac\pi4\frac{L}{\Delta\phi(f)}
\end{align}
representing the polarizer length required to achieve a mode phase shift of $\pi/4$.%
    \footnote{It is important to note that, due to phase wrapping, the cross-section tuning simulations must be
    conducted for a polarizer shorter than that required to produce a $\pi/4$ phase shift.}
This modified objective function can be readily computed using the \emph{Template-Based Post-Processing} feature within CST Studio Suite, using $\Delta\phi(f)$ obtained from the $E$-field probe result. Moreover, the practical feasibility of the polarizer is inherently incorporated into this formulation.

\begin{figure}[!htbp]
    \centering
    \includesvg[width=\textwidth]{src/polarizers_cutoff_frequencies.svg}
    \caption{\label{fig:polarizers-cutoff-frequencies}Polarizers: cutoff frequencies}
\end{figure}

\begin{figure}[!htbp]
    \centering
    \includesvg[width=\textwidth]{src/square_polarizer_cross_section.svg}
    \caption{\label{fig:square-polarizer-cross-section}Square polarizer: cross-section tuning}
\end{figure}

\begin{figure}[!htbp]
    \centering
    \includesvg[width=\textwidth]{src/circular_polarizer_cross_section.svg}
    \caption{\label{fig:circular-polarizer-cross-section}Circular polarizer: cross-section tuning}
\end{figure}

The two polarizers depicted in \cref{fig:polarizer-square-perspective,fig:polarizer-circular-perspective} are modelled with a similar cutoff frequency to facilitate a fair comparison. A diameter of $\qty{50}{mm}$ for the circular waveguide and a side length of $\qty{50}{mm}$ for the square waveguide are selected for the operating band of $\frequencyrange$. This selection results in a cutoff frequency of approximately $\qty{3}{GHz}$ for both underlying waveguides. As previously discussed, both polarizer metrics, \cref{eq:polarizer-amplitude-ratio,eq:polarizer-length-for-90deg}, are predominantly influenced by the cross-sectional geometry. Consequently, both polarizers have been parameterized by the width, $w$, of their chamfering inserts, as depicted in \cref{fig:polarizer-square-perspective,fig:polarizer-circular-perspective}.

The mode cutoff frequency dispersion in \cref{fig:polarizers-cutoff-frequencies} is observed to be similar for both polarizers. However, a comparison of \cref{fig:square-polarizer-cross-section,fig:circular-polarizer-cross-section} reveals that the square waveguide achieves superior phase dispersion while maintaining a lower amplitude dispersion gradient. Henceforth, this text concerns the design of a square waveguide polarizer, and the simple term \emph{polarizer} will refer to this specific kind.

\section{Square waveguide polarizer}
With the fundamental waveguide structure established, the complete polarizer design can now be elaborated upon. This section outlines the design procedure, including all key considerations and design choices made. The process begins by defining the design requirements, which will serve as the foundation for modelling the structure.

\paragraph{Selection of parameters.} The first step in the design process was to define the operating band. A frequency band spanning from $\frequencyrange$ was selected for this polarizer. This range was chosen to cover common satellite communication and radar systems applications.

Based on this frequency range, the initial dimensions of the square waveguide were determined. As outlined in \cref{subsection:comparison-of-symmetric-waveguides}, the corresponding side length of $\qty{50}{mm}$ was selected for the square waveguide. This value was chosen based on the commercially available WR-187 rectangular waveguide,
    \footnote{Also known as WG12 in the RCSC standard and R48 in the IEC standard.}
a standard component with dimensions and frequency range specified in~\parencite{spinner:waveguide-specifications}. However, it is essential to note that the insertion of prisms into the square waveguide, a key element of the design, significantly alters the dispersion characteristics compared to a standard rectangular waveguide. Thus, the $\qty{50}{mm}$ value was chosen as a starting point and further refined through simulations.

Subsequently, simulations were carried out to confirm the suitability of this dimension. The results of these simulations, which were already presented in \cref{fig:polarizers-cutoff-frequencies}, show the cutoff frequencies of the waveguide with the inserted prisms. These cutoff frequencies are critical as they define the operating bandwidth of the waveguide. Based on the simulated cutoff frequencies, it was confirmed that the $\qty{50}{mm}$ side length provided an appropriate operating bandwidth for the target frequency range of $\frequencyrange$.

With the side length established, the next step involved determining the dimensions of the chamfering and the overall length of the polarizer. These parameters were determined through a parametric sweep using simulations. This involved systematically varying the chamfering width and observing its impact on the polarizer's performance. The results of this parametric sweep are presented in \cref{fig:square-polarizer-cross-section}.

After carefully analyzing the simulated results, a chamfering width of $\qty{23}{mm}$ and a polarizer length of $\qty{126}{mm}$ were chosen. These values were selected to provide optimal performance with respect to polarization purity, meaning the ability to effectively transform a linearly polarized wave into a circularly polarized one. Additionally, these dimensions maintain a satisfactory axial ratio, which, as represented by the amplitude ratio in \cref{eq:polarizer-amplitude-ratio}, is a critical measure of the quality of the generated circular polarization.

\subsection{Simulation results}
The polarizer design section concludes with an evaluation of the polarizer's performance under full-wave simulation. Previous simulations were limited to analyzing the eigenmode properties of the polarizer geometry. Consequently, it remains to be verified that the proposed solution functions as intended, i.e., that a linearly polarized $\TE 01$ or $\TE 10$ wave, guided by a square waveguide (as depicted in \cref{fig:square-waveguide-mode1,fig:square-waveguide-mode2}), is effectively converted into a circularly polarized wave upon excitation of the structure.

To simulate more realistic operating conditions, two sections of standard rectangular waveguide, with the same side length as the polarizer, are introduced at each end of the polarizer structure, as depicted in \cref{fig:polarizer-perspective}. The input waveguide section facilitates the excitation of the polarizer with a linearly polarized wave. The output waveguide section serves as a rudimentary radiating element, allowing for an initial assessment of the radiated field. It also allows for verification that the generated circular wave maintains its integrity during the transition from the polarizer to a subsequent waveguide section while also minimizing the influence of reflections. This configuration further permits an examination of the radiation characteristics of the open-ended waveguide, providing preliminary insights into parameters such as co-polarization, cross-polarization directivity, and axial ratio, effectively representing a minimalist circularly polarized antenna.

\begin{figure}[!ht]
    \centering
    
    \caption{\label{fig:polarizer-perspective}Final polarizer: model}
\end{figure}

The results, in the form of radiation patterns for co polarization and cross polarization of both incident waveguide modes, are presented in \cref{fig:polarizer-radiation}. Other antenna parameters, such as scattering parameters, are not studied since the antenna in \cref{fig:polarizer-perspective} serves only as a validation of the polarizing functionality. While serving as a valid check of the radiation properties, the radiation from an open-ended waveguide suffers from large reflections due to the unmatched transition from a waveguide into free space. Perhaps the most crucial quality factor of circular polarization, the axial ratio, is evaluated in the far-field and is analogous to \cref{eq:polarizer-amplitude-ratio}, which describes the ratio of the orthogonal $E$-field components.

These results confirm the previous eigenmode analysis. As shown in \cref{fig:polarizer-radiation}, the axial ratio maintains a low value (with values below $<\qty{3}{dB}$ generally acceptable), even reaching $\qty{0}{dB}$ around the center of the design band. The elevation radiation patterns are displayed at the center frequency.

\begin{figure}[!ht]
    \centering
    \includesvg[width=\textwidth]{src/polarizer_radiation.svg}
    \caption{\label{fig:polarizer-radiation}Final polarizer: radiation properties}
\end{figure}

\chapter{Feeding structure}
\label{chapter:feeding-structure}
This chapter details the design of a transition from two coaxial cables into a square waveguide, with each cable exciting only one of the fundamental $\TE 01$ and $\TE 10$ modes propagating within the waveguide. This facilitates an excitation of the polarizer, detailed in \cref{chapter:polarizer}, equivalent to the artificial excitation used during the polarizer simulations, which were performed using a dual-mode waveguide port in CST Studio Suite.

The initial design considers the well-established problem of a single coaxial-to-waveguide transition employing a right-angled probe within the waveguide cavity. Following an evaluation of the single-feed adapter's performance, the feasibility of introducing a second feed into the same cavity is assessed, and the challenges posed by this are recognized. Separating the two excitation ports by a grating polarizer is adopted to allow their mutual displacement. This approach offers significant potential for reducing the mutual probe coupling below the margin of measurement error. Finally, simulation data are presented to demonstrate the performance of the final structure.

\section{Coaxial-to-waveguide transition}
\label{section:coaxial-to-waveguide-transition}
The problem of coaxial-to-waveguide transition is well-established and rudimentary, with a vast body of existing research available, such as~\parencite{fabregas-et-al:coaxial-to-rectangular-waveguide-transitions}. These transitions most frequently employ a \emph{right-angle transition}%
    \footnote{While there is also the option to feed the waveguide \emph{in-line}, i.e., by leading the coaxial cable's inner conductor through the adapter back wall, this technique is infeasible for the problem at hand. Apart from the obvious challenge of implementing this solution in a dual-feeding scheme, the in-line transition is known to generally perform in a narrower band, be prone to higher reflections, exhibit mode impurities in the waveguide, and pose a more difficult manufacturing challenge due to its use of a \enquote{shorting elbow} or other auxiliary constructions.}
due to its ease of implementation and tuning, especially when compared to alternative solutions, such as the in-line transition described in~\parencite{durga-et-al:millimiter-wave-inline-coaxial-to-rectangular-waveguide-transition}. This work adopts the most straightforward implementation, realized by a simple protrusion of the feeding cable's inner conductor through a side wall. The protruding conductor forms a radiating dipole element, exciting the waveguide with the carried wave. As with dipole antennas, this solution is expected to be relatively narrowband. Various methods exist to extend the bandwidth of low reflection, such as loading the dipole element with a metallic disc or cylinder or forming a conical widening at the probe's end. However, since the polarizer is already expected to operate in a limited band, such modifications are not considered in this thesis, trading the potential bandwidth benefits for enhanced ease of manufacturing.

\begin{figure}[!ht]
    \sbox\twosubbox{%
        \resizebox{\dimexpr.95\textwidth-1em}{!}{%
            %
            %
        }%
    }
    \setlength{\twosubht}{\ht\twosubbox}

    \centering
    \subcaptionbox{\label{fig:single-feed-side-cut-view}Side-cut view}{
        
    }\quad
    \subcaptionbox{\label{fig:single-feed-front-view}Front view}{
        
    }
    \caption{\label{fig:single-feed-model}Single feed: section views}
\end{figure}

The performance of a single right-angle transition, as illustrated in \cref{fig:single-feed-model}, depends crucially on the precise tuning of two key parameters: the probe length, denoted by $l_1$, and its distance from the \enquote{back-short}, denoted by $d_1$. This section will focus on determining the optimal values of these parameters to achieve efficient power transfer within the dominant $\TE 10$ mode.

Design guidelines typically suggest a probe length of half the waveguide's narrow dimension. Considering that rectangular waveguides are generally built with a $2:1$ side length ratio,%
    \footnote{The wider dimension $A$ is typically chosen to be $3\lambda/4$ at the center frequency as fundamental $\TE 10$ mode propagation is limited by the lower mode cutoff, occurring for $\lambda=2A$, and the higher mode cutoff, for $\lambda = A$. Consequently, utilizing the $2:1$ ratio, the narrow dimension is $3\lambda/8$.}
the suggested probe length is given by
\begin{align}
    \label{eq:probe-length}
    l_1 &= \frac{3}{16}\lambda_{\mathrm c},
\end{align}
where $\lambda_{\mathrm c}$ is the center wavelength. The probe acts similarly to a monopole antenna radiating into the waveguide. For optimal radiation, a monopole antenna's length should be somewhat smaller than one-quarter of the operating wavelength due to the deviation from the idealized elementary dipole model, which assumes an infinitely thin conductor. Furthermore, the analogy is imperfect due to the presence of the waveguide walls and the influence of fringing capacitance at the probe tip. Consequently, the empirical value presented in \cref{eq:probe-length} aligns well with the theory of monopole antenna radiation as the working principle of the transition.

Since the monopole radiates omnidirectional the half-space above the waveguide wall, a significant portion of the input power is directed towards the back-short. Therefore, the distance to this shorting wall, $d_1$, is primarily determined by the requirement for constructive interference of the wave reflected by the back-short with the waves emanating from the probe in the desired direction. To understand this, consider the wave propagation within the dominant $\TE 10$ mode. The back-short, acting as a conductive, hence a highly reflective wall, introduces a phase shift of $\pi$ upon reflection. For constructive interference, the total phase shift experienced by the wave during its round-trip journey from the probe to the back-short and back to the probe must be an integer multiple of $2\pi$. The simplest solution that satisfies the constructive interference requirement is to set the back-short distance to one-quarter of the guide wavelength.%
    \footnote{The relevant wavelength in this scenario is the guide wavelength, $\lambda_g$, which represents the wavelength of the propagating wave within the waveguide under the dominant $\TE 10$ mode. This is distinct from the free-space wavelength $\lambda$, as detailed in \cref{example:te-waves-in-a-rectangular-waveguide}, and is given by \cref{eq:guide-wavelength}.}
Consequently, the probe's distance to the back-short can be expressed as
\begin{align}
    \label{eq:probe-distance}
    d_1 &= \frac{\lambda_{\mathrm g}}{4} = \frac{\lambda}{4\sqrt{1-\(\dfrac{\lambda}{\lambda_{mn}}\)^2}},
\end{align}
where the cutoff wavelength $\lambda_{mn}$, corresponding to the cutoff frequency from \cref{eq:cutoff-frequency}, can be simplified as $2A$, where $A$ is the waveguide side length.

\begin{remark}
    \label{remark:probe-distance-higher-order-resonances}
    While constructive interference theoretically occurs for any probe distance $d_1 = (2\nu+1)\pi$, where $\nu\in\N_0$ (i.e., any odd-integer multiple of $\pi$), the quality factor of such resonances rapidly increases with distance, thus resonant wavelength. Consequently, higher-order resonances ($\nu > 0$) exhibit impractically narrow bandwidths and are highly sensitive to dimensional variations, such as engineering tolerances during fabrication, making them unsuitable for reliable operation. Therefore, the fundamental resonance ($\nu = 0$) is preferred for practical right-angle transition designs.
\end{remark}

\paragraph{Single feed tuning.} This section concludes with the optimization of the single-port adapter parameters. Unlike the polarizer tuning, design guidelines are now available, providing reasonable initial estimates. In conjunction with well-defined objective functions, these values are utilized as the starting point for a multi-variable optimization. The primary objective is efficient energy transfer from the coaxial TEM mode to one of the fundamental waveguide modes ($\TE 01$ or $\TE 10$); therefore, the optimization goal is defined as the minimization of port reflection ($S_{11}$).

Initial values for $d_1$ and $l_1$, calculated from \cref{eq:probe-length,eq:probe-distance}, are $\qty{17.64}{mm}$ and $\qty{10.81}{mm}$, respectively. Using these values, the optimizer minimizes $S_{11}$ across the operating band, yielding optimized values of $d_1 = \qty{15.62}{mm}$ and $l_1 = \qty{12.32}{mm}$. The corresponding performance is illustrated in \cref{fig:single-feed-reflection}. The optimized values are in good agreement with the theoretical estimates, falling within an acceptable margin. The observed deviations are likely attributable to the excited waveguide's non-standard height.

\begin{figure}[!ht]
    \centering
    \includesvg[width=\textwidth]{src/single_feed_reflection.svg}
    \caption{\label{fig:single-feed-reflection}Single feed: reflection}
\end{figure}

\section{Dual feed}
\label{section:dual-feed}
The rudimentary feeding structure detailed in the preceding section served as an initial design step, facilitating the excitation of a single linearly polarized $\TE 10$ wave, which can subsequently be fed into the polarizer's input. This structure also provided a rough reference for the general parameters of a right-angle coaxial-to-waveguide transition. However, the polarizer detailed in \cref{chapter:polarizer} was designed to support transforming the other fundamental mode, the $\TE 01$ wave, into a circularly polarized wave of the opposite handedness. A dual feeding structure is required to leverage this capability, incorporating two ports positioned perpendicularly to excite each mode without excessive mixing or coupling. The design principles established in \cref{section:coaxial-to-waveguide-transition} are used as a foundation for this dual-feeding structure.

The design of a dual-feeding structure presents significant challenges, necessitating careful consideration of several key factors. A simplistic approach, placing both ports within the same plane ($z = d_1$), would likely result in high cross-talk due to electromagnetic coupling between the probes. Increasing the distance between the ports requires modifying either the length of one probe or its distance from the back-short. However, as determined in \cref{section:coaxial-to-waveguide-transition}, such modifications significantly degrade individual port performance. An alternative, as mentioned in \cref{remark:probe-distance-higher-order-resonances}, involves displacing one of the ports half a guide wavelength in the propagation direction. While this results in higher-order constructive resonance, it concurrently limits the operational bandwidth of the antenna.

A novel approach, introduced in~\parencite{karki-et-al:dual-polarized-probe-for-planar-near-field-measurement}, utilizes a \emph{grating polarizer} to facilitate feeding probe displacement. This method theoretically enables arbitrary probe displacement without significantly degrading the performance of either port. As illustrated in \cref{fig:dual-feed-model}, the concept introduces a grating made of wires aligned parallel with the displaced port (Port 2). Due to its orientation, the grating is designed to discriminate the horizontally polarized waves radiated from Port 2, acting as a reflecting wall, while remaining transparent to vertically polarized waves, oscillating orthogonal to the wires, incident from the non-displaced port (Port 1).

\begin{figure}[!ht]
    \centering
    \begin{subfigure}{.8\textwidth}
        \centering
        
        \caption{\label{fig:dual-feed-side-cut-view}Side-cut view}
    \end{subfigure}
    \\[0.5cm]
    \begin{subfigure}{.4\textwidth}
        \centering
        
        \caption{\label{fig:dual-feed-front-view}Front view}
    \end{subfigure}
    \caption{\label{fig:dual-feed-model}Dual feed: section views}
\end{figure}

Optimizing the proposed structure is considerably more complex. However, analyzing the anticipated impact of individual parameters can improve initial estimates or eliminate them from the final optimization. For instance, the port parameters (probe length and distance from the back-short) can be assumed to primarily influence the reflection from the corresponding port without significantly affecting the other. Similarly, the distance, $d_g$, between Port 1 and the grating polarizer is assumed to have a negligible impact on reflection from Port 2 ($S_{22}$). Finally, the grating geometry parameters, $g$ and $r$ (intuitively representing \enquote{grating density}), must be optimized with respect to both ports. As shown in~\parencite{karki-et-al:dual-polarized-probe-for-planar-near-field-measurement}, careful selection of these parameters is crucial to managing the trade-off between reflection from Port 1 ($S_{11}$) and port cross-talk ($S_{21}$), whereby a lower grating density reduces $S_{11}$ at the expense of increased $S_{21}$, and vice versa.

\subsection{Grating}
\label{subsection:grating}
As hinted above, a strategic approach is taken whereby certain variables are selectively eliminated to streamline the optimization process. After adding a grating to Port 1, the impact of the grating distance $d_g$ on $S_{11}$ can be analyzed and optimized, as $d_g$ is expected to have a negligible effect on $S_{22}$. While ideally, the grating should be transparent to Port 1 excitation and exhibit minimal influence on $S_{11}$, this is an oversimplification. Although not detrimental to the overall concept, the grating's placement necessitates careful consideration.

Despite the generally low reflected energy from the grating, its introduction results in resonant behavior in $S_{11}$, causing sharp increases in reflection at specific frequencies. As shown in \cref{fig:grating-distance-sweep}, the resonant wavelength is directly proportional to $d_g$. Full-wave simulation at the resonant frequency reveals that the grating and back-short form a resonant cavity, but only when the reflection from the grating destructively interferes with the forward-propagating wave at the cavity's midpoint. This point creates a node for a standing wave, forming a cavity mode depicted in \cref{fig:cavity-resonant}, likely resulting from a superposition of fundamental modes.

\begin{figure}[!ht]
    \centering
    \includesvg[width=\textwidth]{src/grating_distance_sweep.svg}
    \caption{\label{fig:grating-distance-sweep}Single feed with grating: grating distance sweep}
\end{figure}

\begin{figure}[!ht]
    \centering
    \begin{subfigure}{.4\textwidth}
        \centering
        
        \caption{\label{fig:cavity-resonance-x-cutplane}$x$-cutplane}
    \end{subfigure}
    \\[0.5cm]
    \begin{subfigure}{.4\textwidth}
        \centering
        
        \caption{\label{fig:cavity-resonance-y-cutplane}$y$-cutplane}
    \end{subfigure}
    \\[0.5cm]
    \begin{subfigure}{.4\textwidth}
        \centering
        
        \caption{\label{fig:cavity-resonance-z-cutplane}$z$-cutplane}
    \end{subfigure}
    \caption{\label{fig:cavity-resonant}Cavity resonance: electric field section views}
\end{figure}

The results presented in \cref{fig:grating-distance-sweep} are consistent with the tuning results reported in~\parencite{karki-et-al:dual-polarized-probe-for-planar-near-field-measurement}, where the authors identify recurring local minima in reflection at the center frequency for $d_g = \lambda_{\mathrm g}/4$ and $d_g = 3\lambda_{\mathrm g}/4$. In contrast, a local maximum is observed for $d_g = \lambda_{\mathrm g}/2$. The referenced work further demonstrates that selecting $d_g = \lambda_{\mathrm g}/4$ is suboptimal, as the port cross-talk continually diminishes with increasing $d_g$, eventually saturating around $d_g = \lambda_{\mathrm g}/2$, provided that $d_2\approx d_1$. Consequently, a potential optimal value is given by
\begin{align}
    \label{eq:grating-distance}
    d_g &= \frac{3}{4}\lambda_{\mathrm g}
\end{align}

\paragraph{Optimization.} Passing the value given by \cref{eq:grating-distance} as the initial estimate to the native optimizer in CST Studio Suite, the algorithm refines it to $d_g = \qty{60.81}{mm}$ with respect to the optimization goal to achieve $|S_{11}| < -\qty{15}{dB}$, evaluated as a sum of differences across the operating band. The resulting reflection performance is illustrated in \cref{fig:single-feed-with-grating-reflection}.

\begin{figure}[!ht]
    \centering
    \includesvg[width=\textwidth]{src/single_feed_with_grating_reflection.svg}
    \caption{\label{fig:single-feed-with-grating-reflection}Single feed with grating: reflection}
\end{figure}

\subsection{Second feed}
\label{subsection:dual-feed-optimization}
The structure depicted in \cref{fig:dual-feed-model} is completed with the introduction of the second port. This configuration defines a high-dimensional optimization problem, the solution of which is challenging due to the propensity of many optimization algorithms to converge to local minima of the objective function. Consequently, achieving a satisfactory result without manual intervention is often hindered. The initial estimate for the optimization consists of the following parameters:
\begin{itemize}
    \item port parameters, probe lengths $l_1$ and $l_2$, and distances $d_1$ and $d_2$, obtained from the results presented in \cref{section:coaxial-to-waveguide-transition};
    \item grating distance, $d_g$, obtained from the results presented in \cref{subsection:grating};
    \item grating density parameters, namely wire radius $r$ and wire gap $g$, estimated based on the values reported in~\parencite{karki-et-al:dual-polarized-probe-for-planar-near-field-measurement}.
\end{itemize}
These initial values yield results that exhibit reasonable performance and primarily serve to verify the proposed solution. With the initial performance assessed and its validity as a solution to the design problem confirmed, further refinement is pursued through optimization.

\begin{figure}[!ht]
    \centering
    \includesvg[width=\textwidth]{src/dual_feed_sparameters.svg}
    \caption{\label{fig:dual-feed-sparameters}Dual feed: S-parameters}
\end{figure}

The final results of the optimization, presented as scattering parameters, are illustrated in \cref{fig:dual-feed-sparameters}. Good performance is demonstrated across a relatively wide frequency band with both ports exhibiting low reflection (considering values below~$-\qty{10}{dB}$ acceptable) and cross-talk levels suppressed into values typically considered the noise floor in most real-world measurements. The adjustments made to refine the initial performance were primarily related to the grating geometry, which did not perform adequately as a shorting wall for Port 2 in the initial estimate. Therefore, the grating depicted in \cref{fig:dual-feed-front-view} was thickened by reducing the grating gap $g$ and adequately increasing the wire count to 9. The optimum found for the dual feed parameters is
\begin{align}
    \label{eq:dual-feed-optimum}
    (d_1,l_1,d_g,d_2,l_2,r,g) &= (15.62,12.32,60.81,15.62,12.32,2,5.2)\,\unit{mm},
\end{align}
and the final model is depicted in \cref{fig:dual-feed-perspective}.

\begin{remark}[Results commentary]
    The ripple observed in \cref{fig:dual-feed-sparameters} at a frequency near $\qty{4.94}{GHz}$ is attributed to a cavity resonance. This resonance is caused by a small portion of energy penetrating the grating polarizer, as it is not an ideal shorting wall. At this frequency, the wavelength aligns with the distance $d_1+d_g$, creating a resonant cavity between the back-short and the grating polarizer. In practice, this resonance is expected to diminish due to conductive losses. Its visibility in the simulation is due to the simulator being configured to terminate after a certain input energy level has diminished. At the same time, the resonance causes a portion of the energy to persist.
\end{remark}

\begin{figure}[!ht]
    \centering
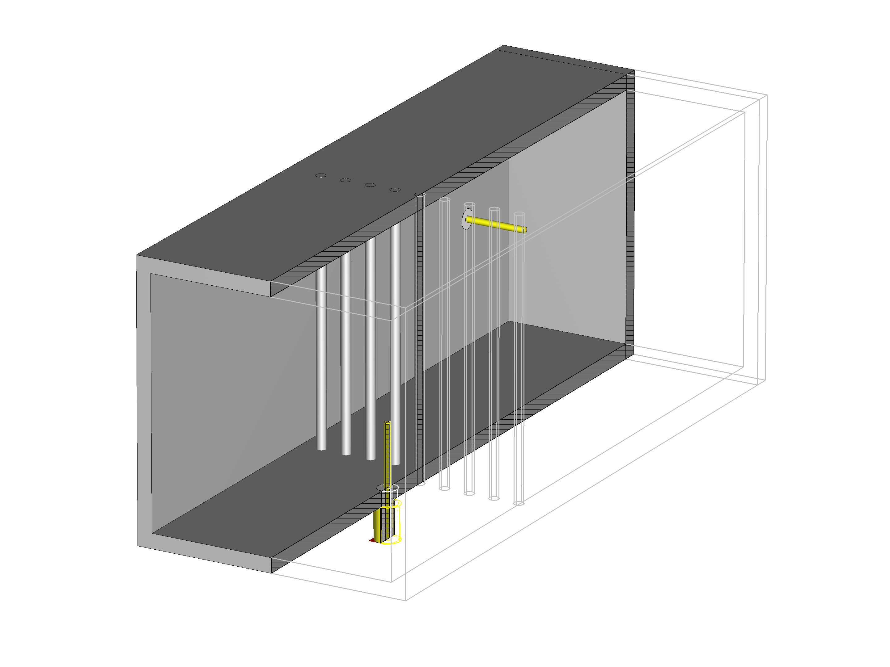
[picture p82: latex/src/dual_feed_perspective.png]
    
    \caption{\label{fig:dual-feed-perspective}Final dual feed: model}
\end{figure}

\chapter{Antenna}
\label{chapter:antenna}
This chapter details the design of the third and final component of the system under consideration. As depicted in \cref{fig:polarizer-radiation}, the polarizer demonstrates the potential for generating waves with favorable far-field radiation characteristics. However, to facilitate a smooth transition between the waveguide and free space, the structure must be coupled with an antenna exhibiting moderate gain, approximately $\qty{15}{dBi}$. Furthermore, the antenna needs to support circular polarization. These requirements, particularly within the context of waveguide technology, suggest the utilization of a symmetrical antenna. While a pyramidal horn antenna with a square aperture could be inferred from the polarizer geometry, a conical horn antenna, adapted to the square polarizer outlet, is selected for this application due to its more straightforward fabrication process and robust support of circular polarization.

\section{Conical horn}
The radiation characteristics of conical horn antennas, including gain, aperture phase distributions, loss factors, and amplitude patterns, have been comprehensively re-examined in~\parencite{aboserwal-et-al:conical-horn-gain-and-amplitude-patterns} utilizing spherical and quadratic aperture phase distributions. Moreover, a novel methodology for accurate computation of far-field amplitude patterns, including those in the far side and back lobe regions, was developed therein. This methodology leverages geometrical optics and diffraction theory, incorporating the Method of Equivalent Currents, which utilizes virtual magnetic source quantities. This approach is undertaken e.g., in \parencite{balanis:advanced-engineering-electromagnetics}, employing the \enquote{generalized} current concept in the formulation of Maxwell's equations.

The theoretical work presented in~\parencite{aboserwal-et-al:conical-horn-gain-and-amplitude-patterns} and similar publications is anticipated to be integrated into the practical functionalities offered by Antenna Magus. This software facilitates the automatic synthesis of antenna designs, predicated on desired performance requirements, through neural networks. These networks are trained on an extensive database comprising existing antenna models and their corresponding performance data. Moreover, seamless integration with CST Studio Suite is supported, allowing for direct export of the synthesized antenna designs into the CST simulation environment for further analysis. An antenna model demonstrating this design approach, demanding the target gain of $\qty{15}{dBi}$ at the center frequency of $\qty{5.2}{GHz}$, is illustrated in \cref{fig:conical-horn-magus-perspective}.

\begin{figure}[!ht]
    \centering
    \begin{subfigure}{.45\textwidth}
        \centering
        
        \caption{\label{fig:conical-horn-magus-perspective}Antenna Magus}
    \end{subfigure}
    ~
    \begin{subfigure}{.45\textwidth}
        \centering
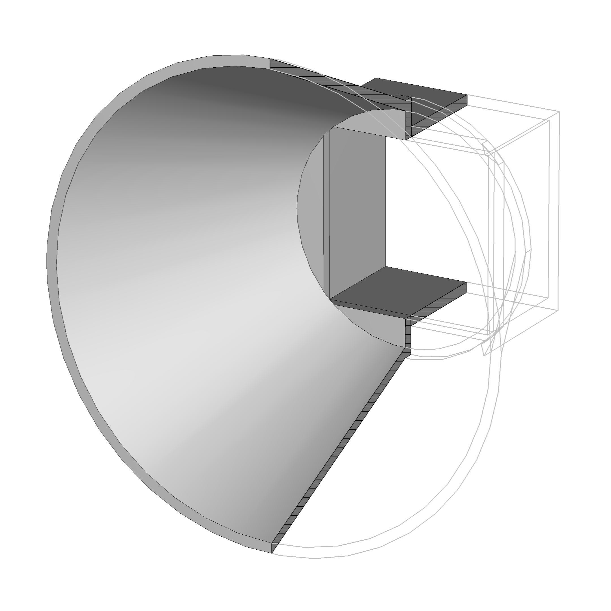
[picture p83: latex/src/conical_horn_perspective.png]
        
        \caption{\label{fig:conical-horn-perspective}Finalized}
    \end{subfigure}
    \caption{\label{fig:conical-horn-models}Conical horn: models}
\end{figure}

The antenna depicted in \cref{fig:conical-horn-magus-perspective} provides a robust performance benchmark for subsequent adaptation into a rectangular waveguide configuration. Maintaining the original horn dimensions while modifying the feed from a circular to a rectangular waveguide is hypothesized to yield comparable results, contingent upon a smooth rectangular-to-conical transition that minimizes reflections detrimental to horn performance. Parametric sweeps of the horn flare diameter, $D_f$, and flare length, $L_f$, indicate that the target gain can be realized through various combinations of these parameters. Notably, for each value of flare length, the relationship between gain and flare diameter exhibits a concave function characterized by a distinct local maximum.%
    \footnote{This behavior is observed and examined in Figure 3 of~\parencite{aboserwal-et-al:conical-horn-gain-and-amplitude-patterns}.}
Consequently, selecting optimal parameters necessitates a trade-off between achieving the desired gain with a sufficient margin and minimizing the overall antenna dimensions. Two promising configurations were identified:
\begin{enumerate}[label=(\alph*)]
    \item $D_f = \qty{120}{mm}$, $L_f = \qty{60}{mm}$, yielding a gain of $\qty{15}{dBi}$,
    \item $D_f = \qty{130}{mm}$, $L_f = \qty{70}{mm}$, yielding a gain of $\qty{15.5}{dBi}$.
\end{enumerate}
Ultimately, the latter configuration (b) was selected for the final design, prioritizing a gain margin despite the consequential increase in antenna dimensions. The finalized antenna design is depicted in \cref{fig:conical-horn-perspective}. Its performance is benchmarked against an idealized Antenna Magus design, which assumes perfect electric conductors and zero wall thickness. As illustrated in \cref{fig:conical-horn-performance-comparison}, adapting the model to a square waveguide configuration resulted in some deviations in the figures of merit. Nevertheless, the overall performance remains highly satisfactory, adhering to the required performance thresholds.

\begin{figure}[!ht]
    \centering
    \includesvg[width=\textwidth]{src/conical_horns_comparison.svg}
    \caption{\label{fig:conical-horn-performance-comparison}Conical horn: performance}
\end{figure}

\chapter{Final structure}
\label{chapter:final-structure}
This concluding chapter details the finalization of the antenna design, transitioning from individual component designs presented in \cref{chapter:polarizer,chapter:antenna} to a fully integrated and manufacturable product. The process begins with an assessment of initial full-system simulation results and an analysis of identified discrepancies. Driven by fabrication time constraints, a Minimum Viable Product (MVP) was developed, prioritizing core functionality. Subsequently, Design for Manufacturing (DFM) adjustments were incorporated into the structural design. The resulting DFM-compliant design was fabricated by Universal Microwave Technology, Inc. (UMT). The measurement data, including the network parameters and radiation properties, are presented herein and compared against the simulated results, with a discussion of performance alignment.

\section{Feed rework}
Preliminary simulations indicate that the performance of the final structure deviates significantly from expectations, particularly concerning the operation of the dual-feeding mechanism. This discrepancy is primarily reflected in the S-parameters, as illustrated in \cref{fig:grating-vs-mvp-sparameters}. While the performance of the feed incorporating a grating polarizer is acceptable in isolation, the figure also presents the S-parameters for a configuration with the grating entirely removed. This latter configuration represents the most straightforward implementation of a dual-feeding structure, previously discussed and dismissed in \cref{section:dual-feed} due to inherent high cross-talk between ports. However, as demonstrated in \cref{fig:grating-vs-mvp-sparameters}, despite exhibiting excellent individual performance, the grating polarizer provides only negligible improvement in cross-talk mitigation. This minimal benefit comes at the expense of a substantial increase in manufacturing complexity, overall size, and, consequently, the cost of the final product.

As previously addressed in \cref{section:dual-feed}, a manipulation of cross-talk levels can be achieved through increased grating density. Unfortunately, this tuning cannot improve the performance without significantly degrading port reflections. Consequently, integrating a grating polarizer fails to yield the anticipated performance improvements due to an as-yet-unidentified mechanism. A comprehensive investigation of this underlying mechanism necessitates further research, which falls outside this thesis's current scope and timeline, particularly considering the impending fabrication deadlines. Therefore, the MVP solution depicted in \cref{fig:final-perspective} is adopted to expedite the development process. This design omits the grating polarizer and positions both ports within the same plane, ultimately proving an equally viable solution.

\begin{figure}[!ht]
    \centering
    \includesvg[width=\textwidth]{src/grating_vs_mvp_sparameters.svg}
    \caption{\label{fig:grating-vs-mvp-sparameters}Final structure: grating performance}
\end{figure}

\begin{figure}[!ht]
    \centering
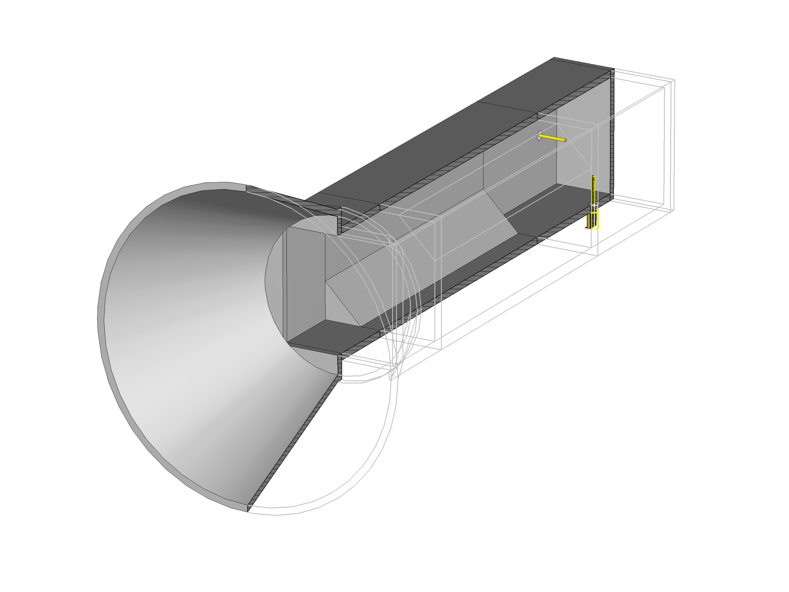
[picture p84: latex/src/final_perspective.png]
    
    \caption{\label{fig:final-perspective}Final structure: MVP model}
\end{figure}

\section{Product finalization}
The structure illustrated in \cref{fig:final-perspective} represents the finalized model used for electromagnetic simulations, establishing a benchmark for subsequent comparison with measurement data. These verification simulations employed exceptionally fine meshing settings and stringent convergence criteria based on energy dissipation to ensure the utmost accuracy. Concurrently, the final model underwent a design review with the principal engineer at UMT. This consultation led to the implementation of final DFM modifications. These adjustments, aimed at ensuring compatibility with standard CNC machining processes, involved modularizing the complete structure into five distinct components: conical horn, square waveguide section, polarizer, dual-feed, and back-short. Each of these components was designed with standard waveguide flanges to facilitate assembly, and the antenna's geometry was further refined for efficient fabrication using drilling techniques. The resulting DFM-compliant model, depicted in \cref{fig:final-umt-perspective}, demonstrates that the internal dimensions remain unchanged, thereby preserving the critical electromagnetic performance characteristics of the original design.

\begin{figure}[!ht]
    \centering
    
    \caption{\label{fig:final-umt-perspective}Final structure: DFM model}
\end{figure}

\begin{figure}[!ht]
    \centering
    
    \caption{\label{fig:final-ports}Back view of the final structure}
\end{figure}

\section{Measurement results}
UMT, a leading company in the design, development, and manufacturing of custom components, antennas, and cables for microwave and millimetre-wave frequency bands, was selected as the fabrication partner for their state-of-the-art technology and proven expertise, which instilled high confidence that the product would be fabricated with minimal manufacturing tolerances.

Two distinct experimental campaigns were conducted to fully characterize the prototype. The first campaign focused on S-parameter measurements, providing insights into impedance matching and power transmission across the operational frequency band using an Agilent Vector Network Analyzer (VNA); these measurements were performed by UMT, whose contributions are gratefully acknowledged. The second campaign, conducted in the department anechoic chamber, evaluated the prototype's radiation characteristics. A double-ridged horn antenna was employed as the receiving antenna during these measurements. The experimental setups for both measurement campaigns are visually depicted in \cref{fig:measurement-setup}.

To ensure clarity in interpreting measurement data, \cref{fig:final-ports} depicts the back view of the finalized antenna structure, designating Port 1 and Port 2, and establishing the orientation of the spherical coordinate system employed for all subsequent radiation pattern measurements.

\begin{figure}[!ht]
    \sbox\twosubbox{%
        \resizebox{\dimexpr.95\textwidth-1em}{!}{%
            %
            %
        }%
    }
    \setlength{\twosubht}{\ht\twosubbox}

    \centering
    \subcaptionbox{\label{fig:vna}S-parameters}{
        
    }\quad
    \subcaptionbox{\label{fig:chamber}Radiation properties}{
        
    }
    \caption{\label{fig:measurement-setup}Measurement setup}
\end{figure}

As anticipated, both the measured network parameters and the radiation properties, presented in \cref{fig:measurement-sparameters,fig:measurement-boresight-radiation}, respectively, demonstrate very good agreement with the high-fidelity simulations. Radiation patterns depicted in \cref{fig:measurement-elevation-pattern-port1,fig:measurement-azimuth-pattern-port1,fig:measurement-elevation-pattern-port2,fig:measurement-azimuth-pattern-port2} also align well with the simulation results, with only minor discrepancies for some angles, mostly off the boresight axis outside the HPBW range. These discrepancies are likely caused by a realistic tolerance in repeatability during anechoic chamber measurement.

\begin{figure}[!ht]
    \centering
    \includesvg[width=\textwidth]{src/meas2_sparameters.svg}
    \caption{\label{fig:measurement-sparameters}Measurement: S-parameters}
\end{figure}

\begin{figure}[!ht]
    \centering
    \includesvg[width=\textwidth]{src/antenna2_boresight_radiation.svg}
    \caption{\label{fig:measurement-boresight-radiation}Measurement: boresight gain and axial ratio}
\end{figure}

\begin{figure}[!ht]
    \centering
    \includesvg[width=\textwidth]{src/antenna2_port1_elevation.svg}
    \caption{\label{fig:measurement-elevation-pattern-port1}Measurement: port 1 elevation radiation pattern ($\varphi=\ang{90}$)}
\end{figure}

\begin{figure}[!ht]
    \centering
    \includesvg[width=\textwidth]{src/antenna2_port1_azimuth.svg}
    \caption{\label{fig:measurement-azimuth-pattern-port1}Measurement: port 1 azimuth radiation pattern ($\varphi=\ang{0}$)}
\end{figure}

\begin{figure}[!ht]
    \centering
    \includesvg[width=\textwidth]{src/antenna2_port2_elevation.svg}
    \caption{\label{fig:measurement-elevation-pattern-port2}Measurement: port 2 elevation radiation pattern ($\varphi=\ang{90}$)}
\end{figure}

\begin{figure}[!ht]
    \centering
    \includesvg[width=\textwidth]{src/antenna2_port2_azimuth.svg}
    \caption{\label{fig:measurement-azimuth-pattern-port2}Measurement: port 2 azimuth radiation pattern ($\varphi=\ang{0}$)}
\end{figure}

% ========== Conclusion ==========
\chapter*{Conclusion}
\label{chapter:conclusion}
\addcontentsline{toc}{chapter}{\nameref{chapter:conclusion}}

The thesis presents a comprehensive study on the design, fabrication, and measurement of a novel dual circularly polarized antenna operating within the $\frequencyrange$ frequency band. The work demonstrates high academic rigor and successfully achieves its core objectives, culminating in a functional prototype that exhibits excellent agreement between simulated and measured performance.

The primary academic goal of this thesis was to develop a waveguide-based antenna capable of producing switchable right-hand and left-hand circular polarization. This was achieved by introducing a novel polarizer design based on a square waveguide with chamfered corners, effectively creating a hexagonal waveguide structure. Through rigorous electromagnetic simulations and experimental validation, the thesis successfully demonstrates that this design allows for easy switching between polarization handedness by simply exciting one of the two orthogonal fundamental modes of the waveguide. This is a significant achievement with potential applications in polarization multiplexing, where dynamically controlling the polarization state can increase channel capacity. Moreover, the simple and robust design of the polarizer makes it suitable for scenarios where achieving polarization diversity might be challenging, such as in compact or integrated systems. The successful development of this novel polarizer constitutes the most significant academic contribution of this work, showcasing an innovative approach to polarization control in waveguide technology.

A further objective was to fabricate a physical prototype of the designed antenna and validate its performance through measurements. This goal was fully achieved, with the final product fabricated to high precision by Universal Microwave Technology, Inc. The measured performance demonstrates excellent agreement with the simulated results, strongly validating the design methodology and the accuracy of the electromagnetic simulations. The close agreement between simulation and measurement confirms the design's manufacturability, highlighting its potential for practical applications.

Despite the project's overall success, several potential areas for improvement are identified. The polarizer's performance could be enhanced by incorporating a tapered transition into the chamfered sections, potentially reducing reflections and improving the overall bandwidth, which warrants further investigation. Implementing multiple polarizer sections with varying geometries could also widen the operational bandwidth, albeit at the cost of increased complexity. Regarding the feeding structure, alternative coaxial-to-waveguide transition techniques, such as disc-loaded or prismatic probes, are known to widen the operation bandwidth. Finally, while the conical horn antenna provides satisfactory performance, considering a quad-ridge square pyramidal horn could offer a more robust and potentially broader bandwidth solution, especially for applications demanding higher polarization purity across a wider frequency range. These suggested improvements provide avenues for future research and development, building upon the solid foundation established by this thesis.

% ========== Bibliography ==========
\printbibliography[heading=bibintoc,title={References}]

\end{document}
