simakma5/diploma-thesis/progress-reports/04-progress_report.pptx

## Waveguide polarizer design

Dual circularly polarized waveguide antenna – eigenmode analysis

## Outline

- Principle of operation
- Square waveguide
- Circular waveguide
- Novel alternative
- References

Research progress report

## Principle of operation – overview

- Linear × circular × elliptical polarization
- Elliptical: E_(major) ⋅E_(minor) =0
- Circular: ‖E_(major) ‖=‖E_(minor) ‖
- Polarizer: transition from linear to circular

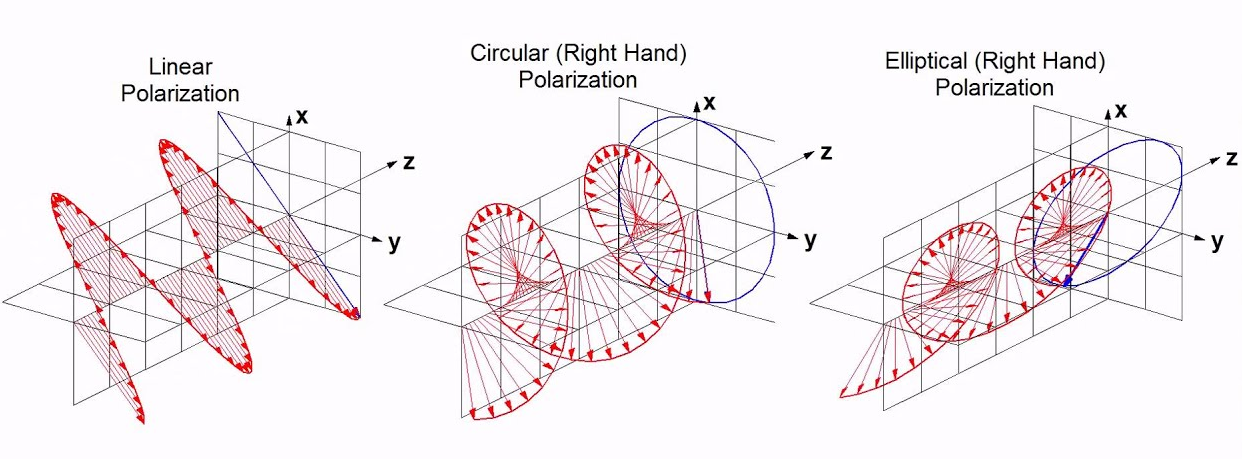
[picture p90: figure]

## Principle of operation – figures of merit

- Polarization purity
- Orthogonal mode excitation
  - Phase difference
  - Amplitude ratio
- Axial ratio AR=20log((E_(major))/(E_(minor)))
- Attenuation
  - S-parameters

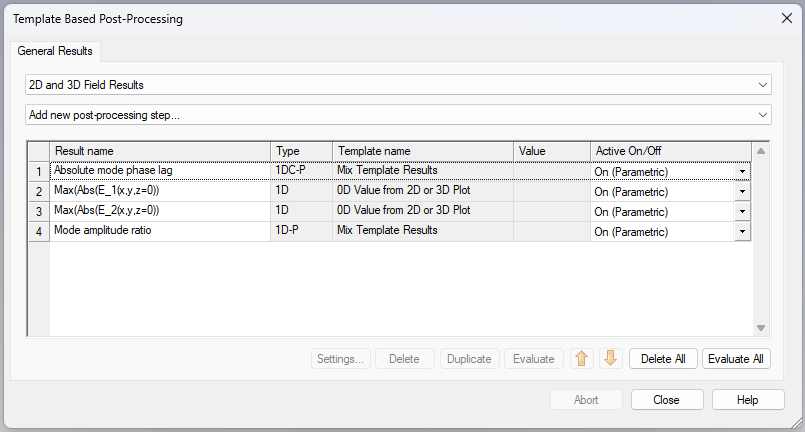
[picture p91: figure]

## Square waveguide – structure [1-2]

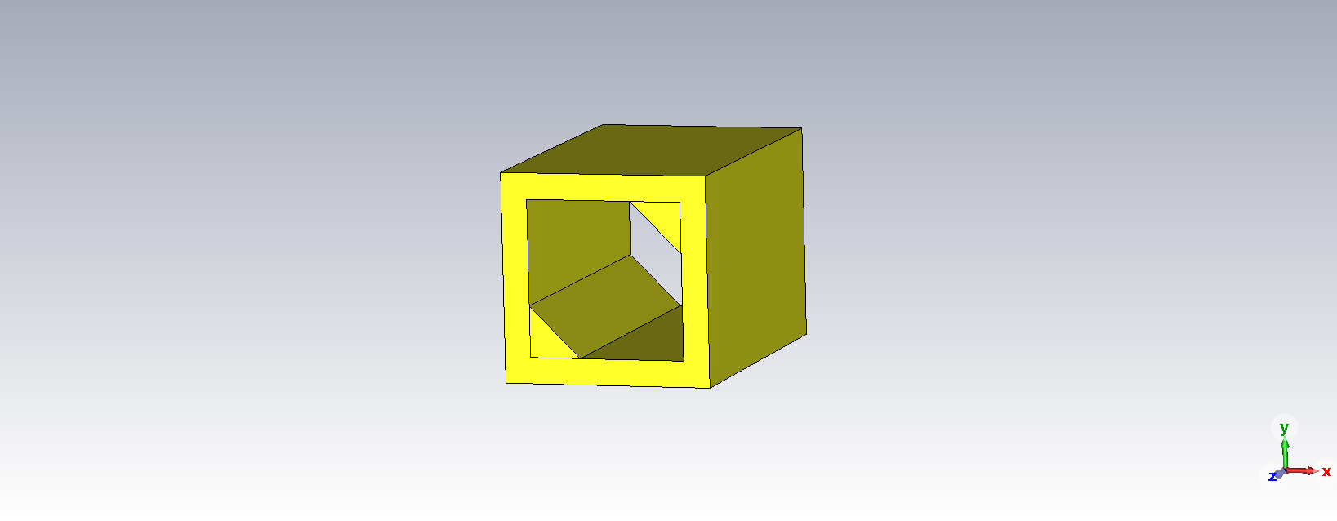
[picture p92: figure]

## Square waveguide – 1st mode excitation

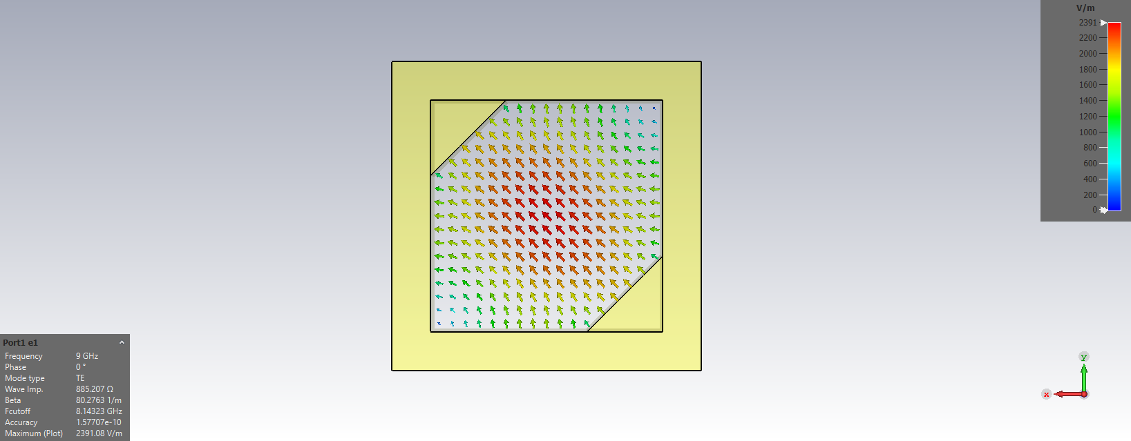
[picture p93: figure]

## Square waveguide – 2nd mode excitation

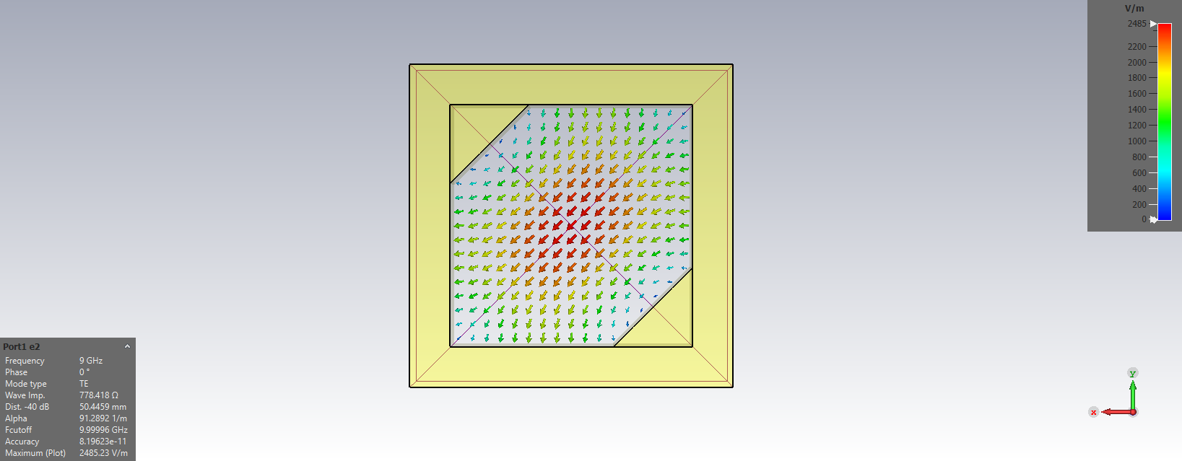
[picture p94: figure]

## Square waveguide – mode phase lag

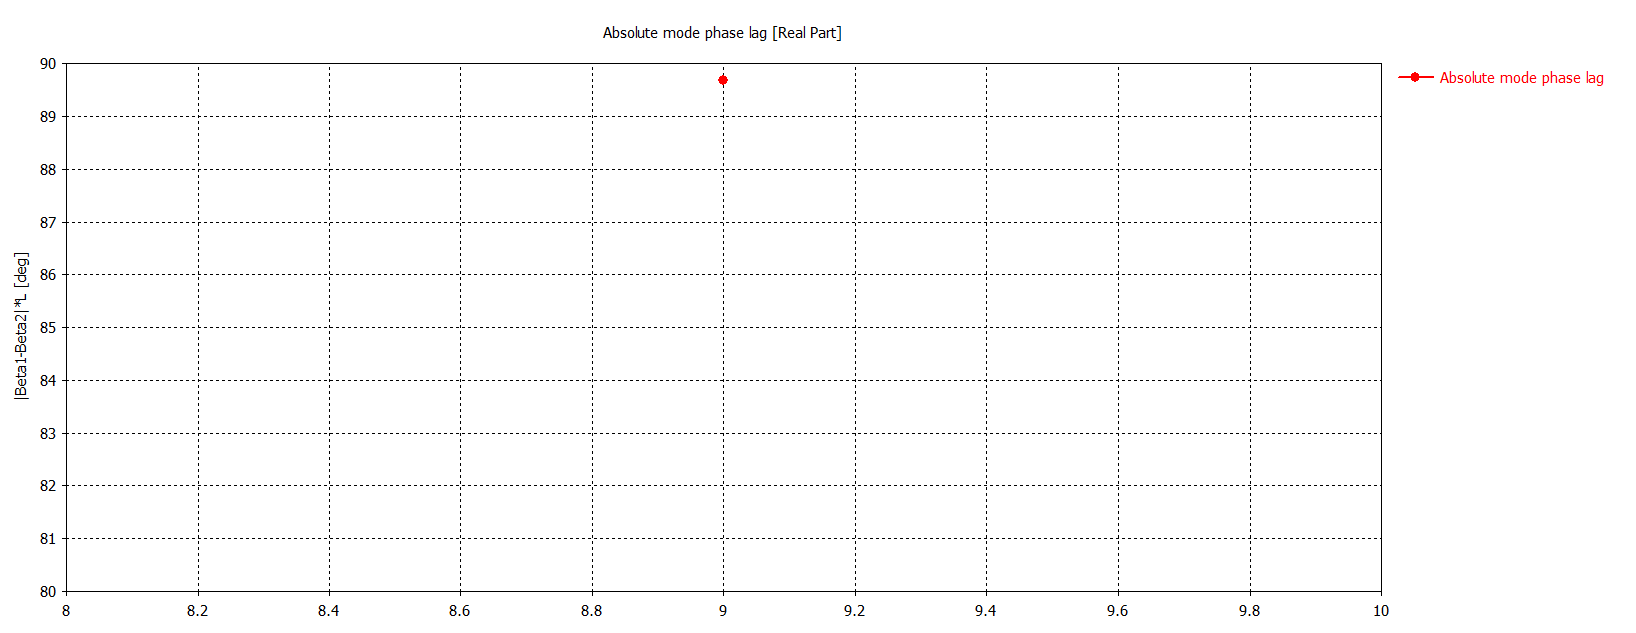
[picture p95: figure]

## Square waveguide – mode amplitude ratio

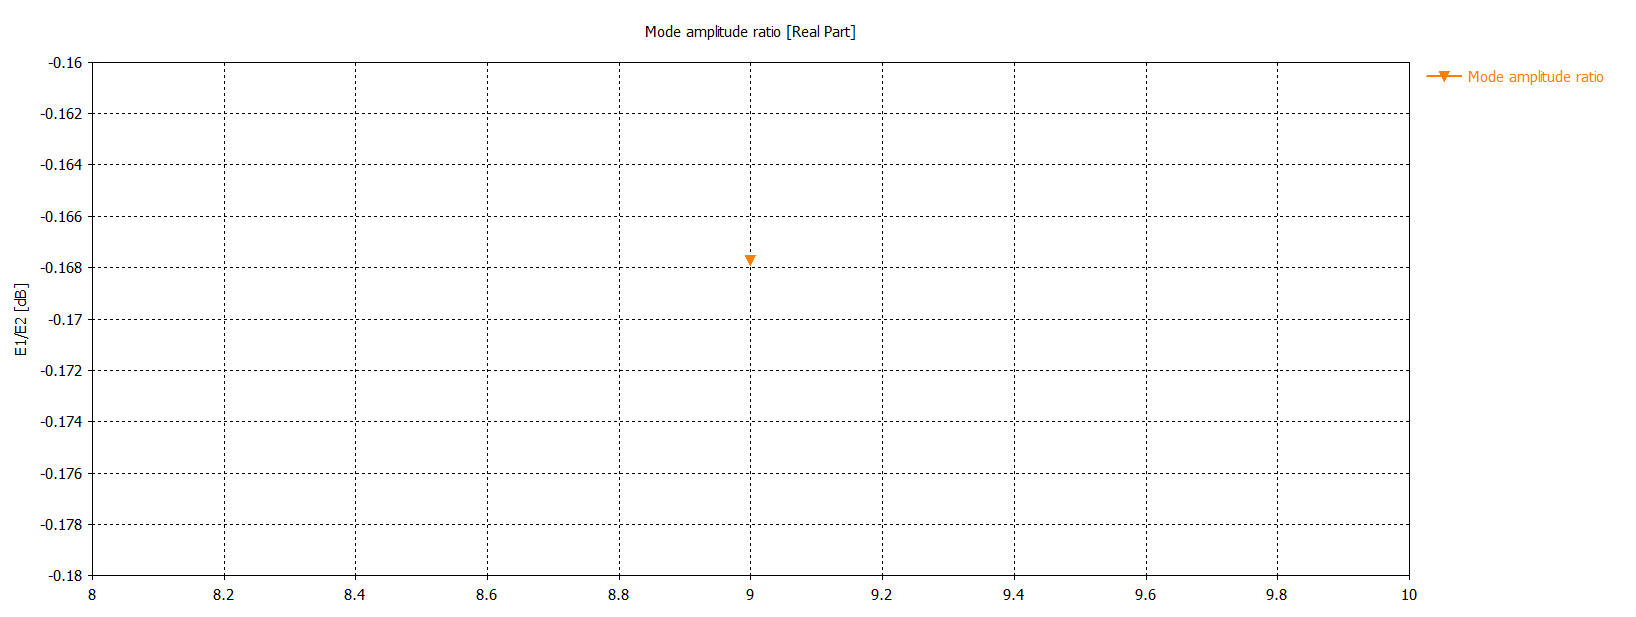
[picture p96: figure]

## Circular waveguide – structure

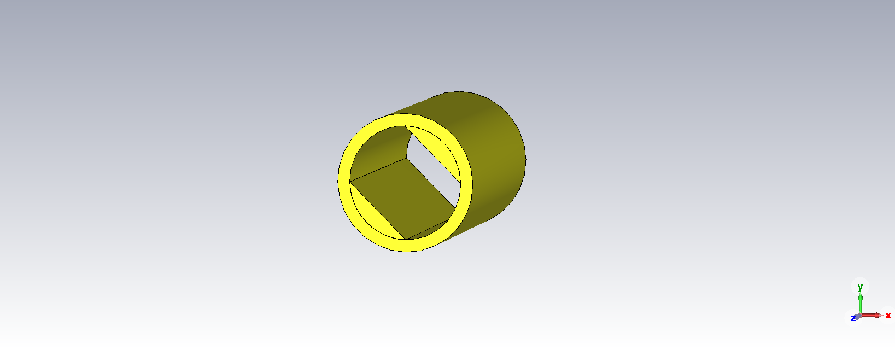
[picture p97: figure]

## Circular waveguide – 1st mode excitation

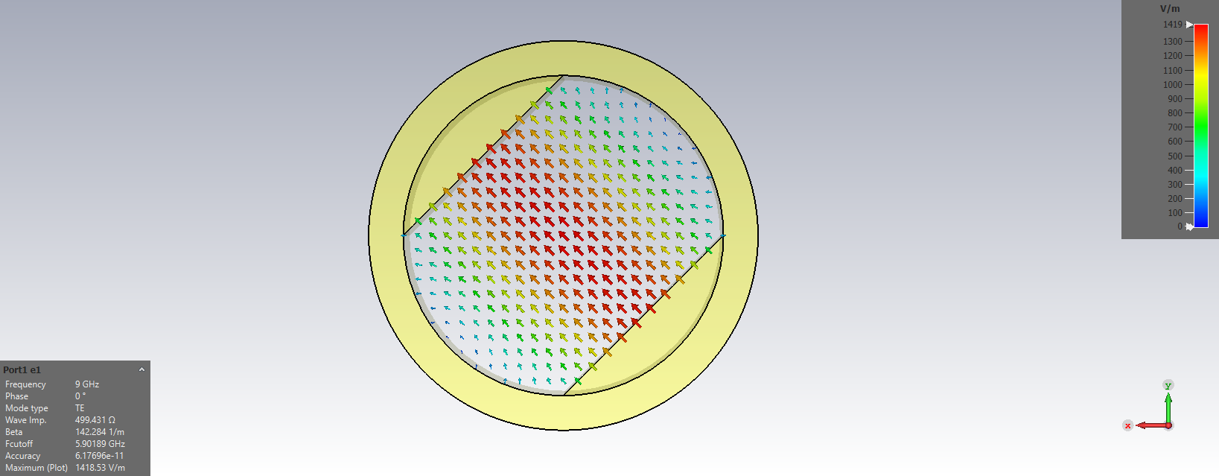
[picture p98: figure]

## Circular waveguide – 2nd mode excitation

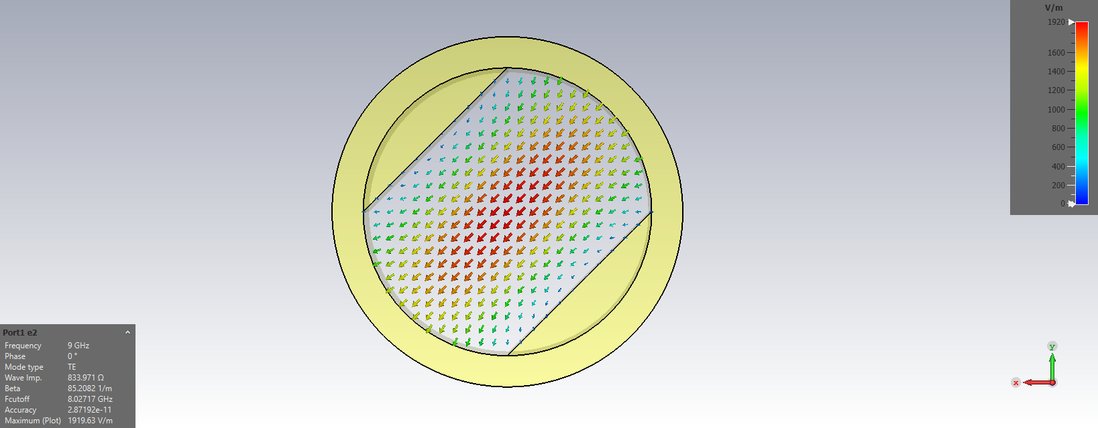
[picture p99: figure]

## Circular waveguide – mode phase lag

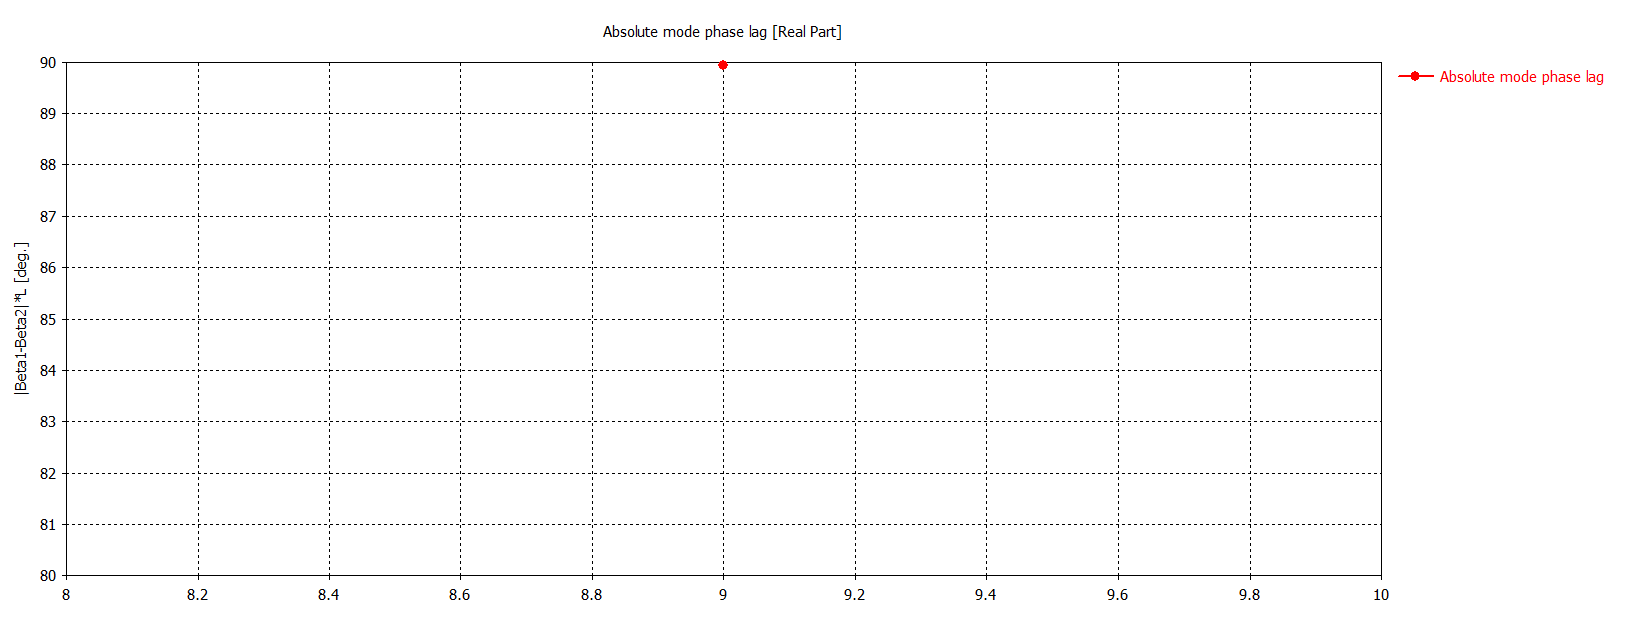
[picture p100: figure]

## Circular waveguide – mode amplitude ratio

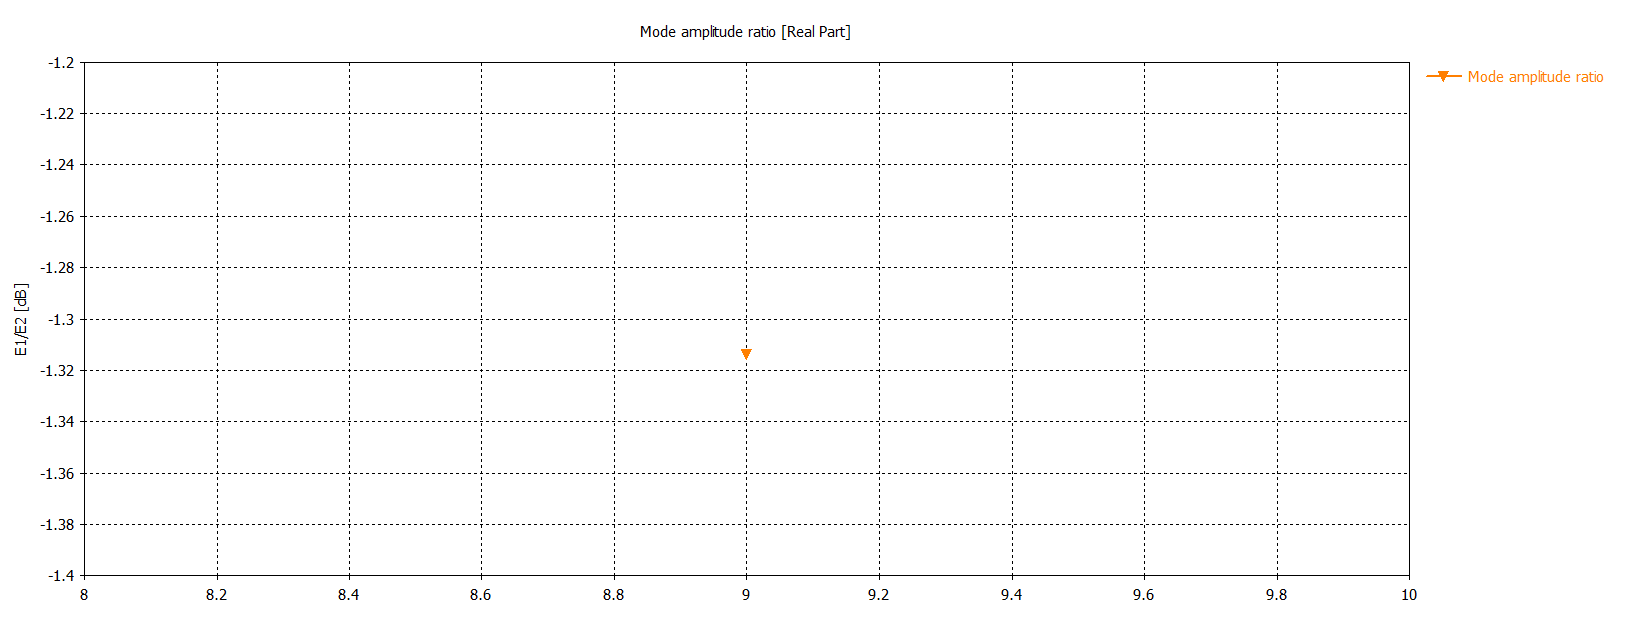
[picture p101: figure]

## Novel alternative: bow-tie cavity [3]

- Structures capable of both single and dual circular polarizations
- Improved attenuation and polarization-purity parameters
- Complex machining required
- Requirement on port isolation for dual polarization makes it even more complex

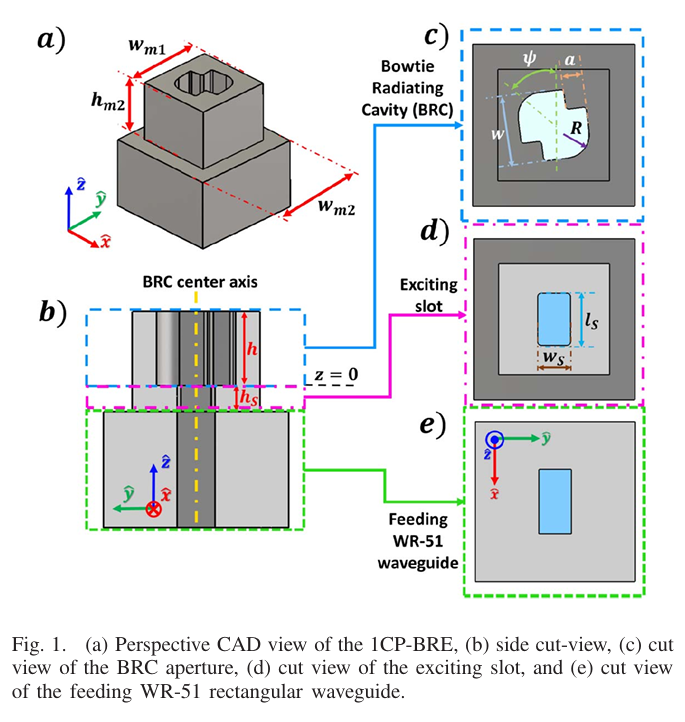
[picture p102: figure]

## Thank you

for your attention

## References

[1] S. Bhardwaj and J. Volakis, "Hexagonal waveguides: New class of waveguides for mm-wave circularly polarized horns," 2018 International Applied Computational Electromagnetics Society Symposium (ACES), Denver, CO, USA, 2018, pp. 1-2, doi: 10.23919/ROPACES.2018.8364165.
[2] S. Bhardwaj and J. L. Volakis, "Hexagonal Waveguide Based Circularly Polarized Horn Antennas for Sub-mm-Wave/Terahertz Band," in IEEE Transactions on Antennas and Propagation, vol. 66, no. 7, pp. 3366-3374, July 2018, doi: 10.1109/TAP.2018.2829842.
[3] E. Garcia-Marin, J. L. Masa-Campos, P. Sanchez-Olivares and J. A. Ruiz-Cruz, "Bow-Tie-Shaped Radiating Element for Single and Dual Circular Polarization," in IEEE Transactions on Antennas and Propagation, vol. 68, no. 2, pp. 754-764, Feb. 2020, doi: 10.1109/TAP.2019.2943357.
