simakma5/diploma-thesis/isap2025/src/isap2025logo-eps-converted-to.pdf

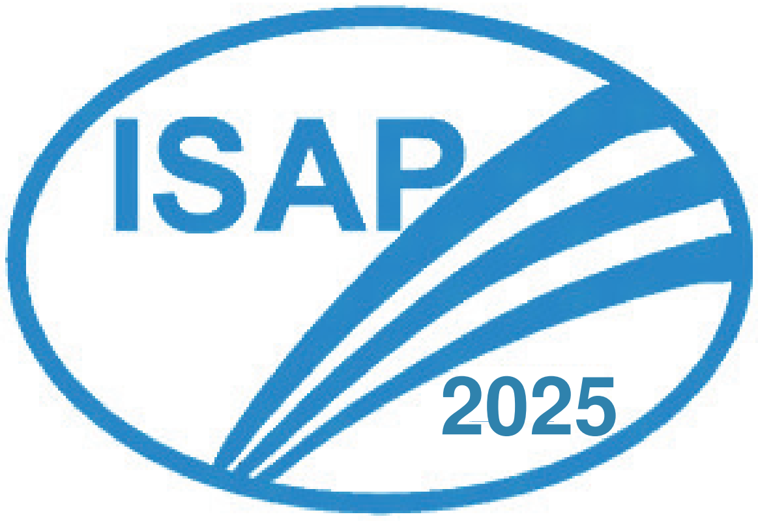
[picture p103: page 1]

2025
