simakma5/diploma-thesis/latex/src/qualification_form.pdf

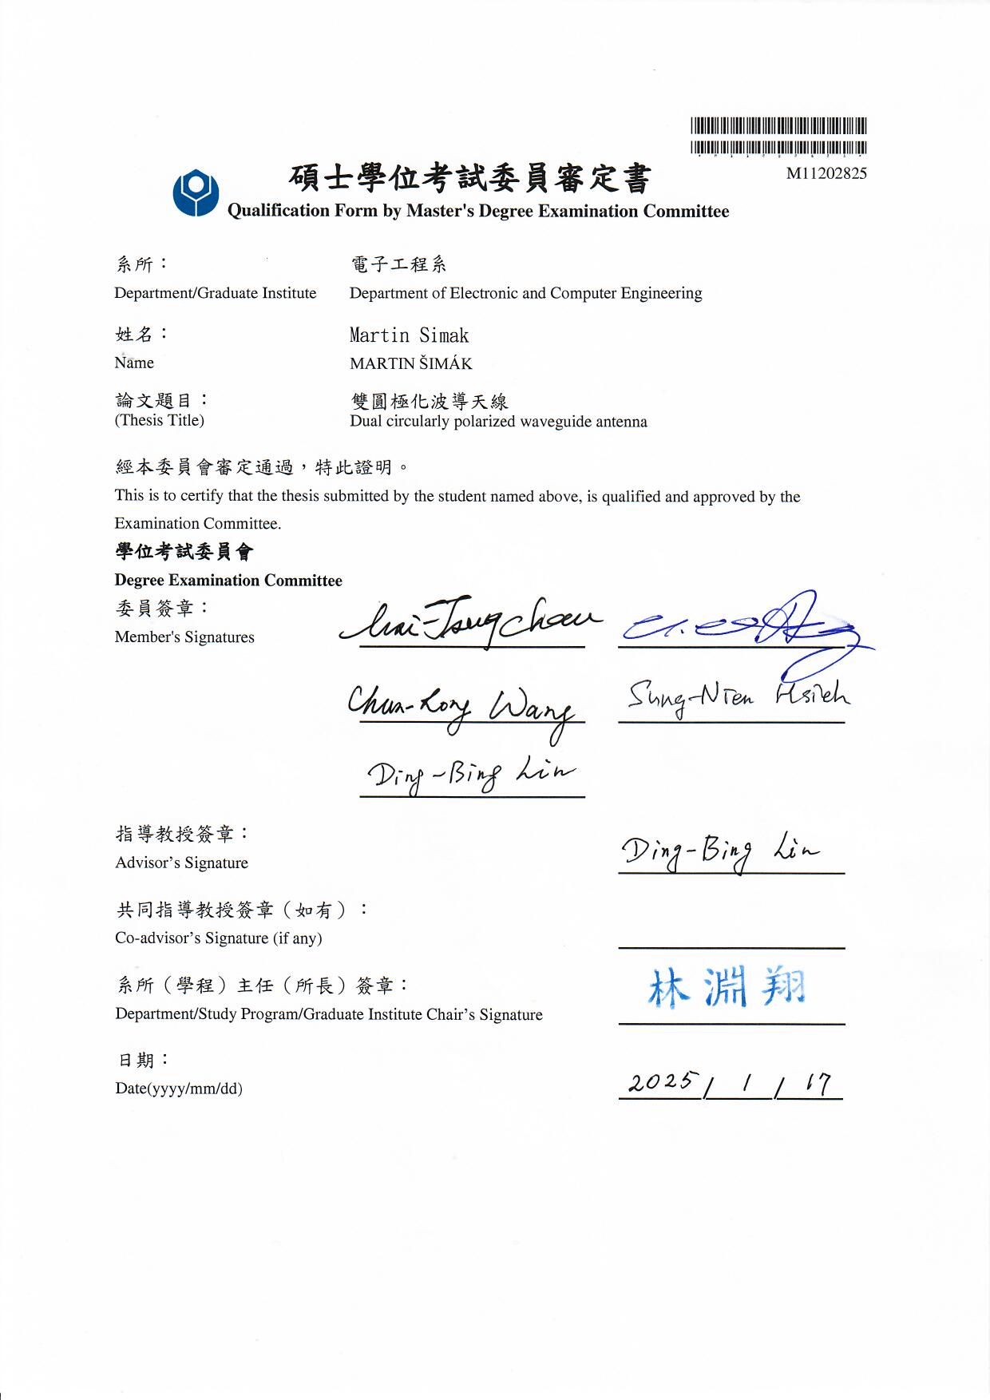
[picture p104: page 1]
