simakma5/diploma-thesis/latex/svg-inkscape/antenna2_port1_azimuth_svg-tex.pdf

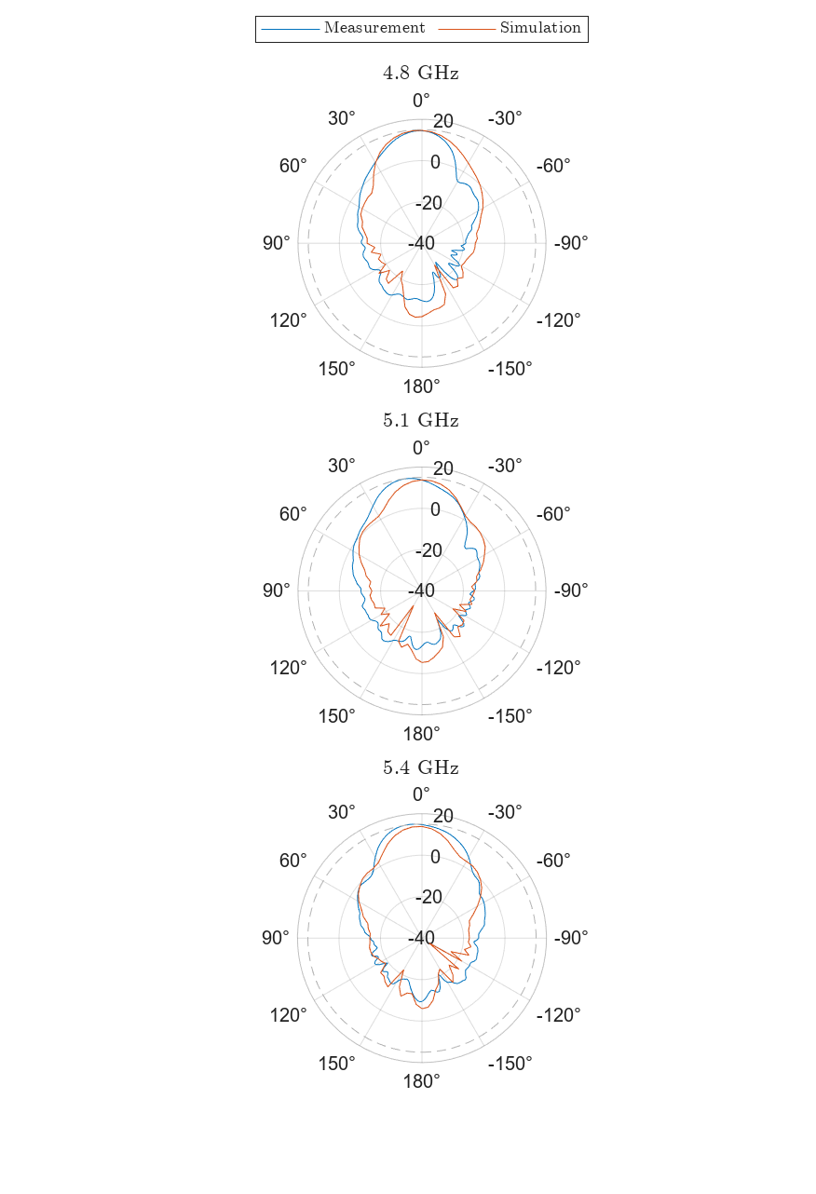
[picture p105: page 1]
