simakma5/diploma-thesis/latex/svg-inkscape/antenna2_port1_elevation_svg-tex.pdf

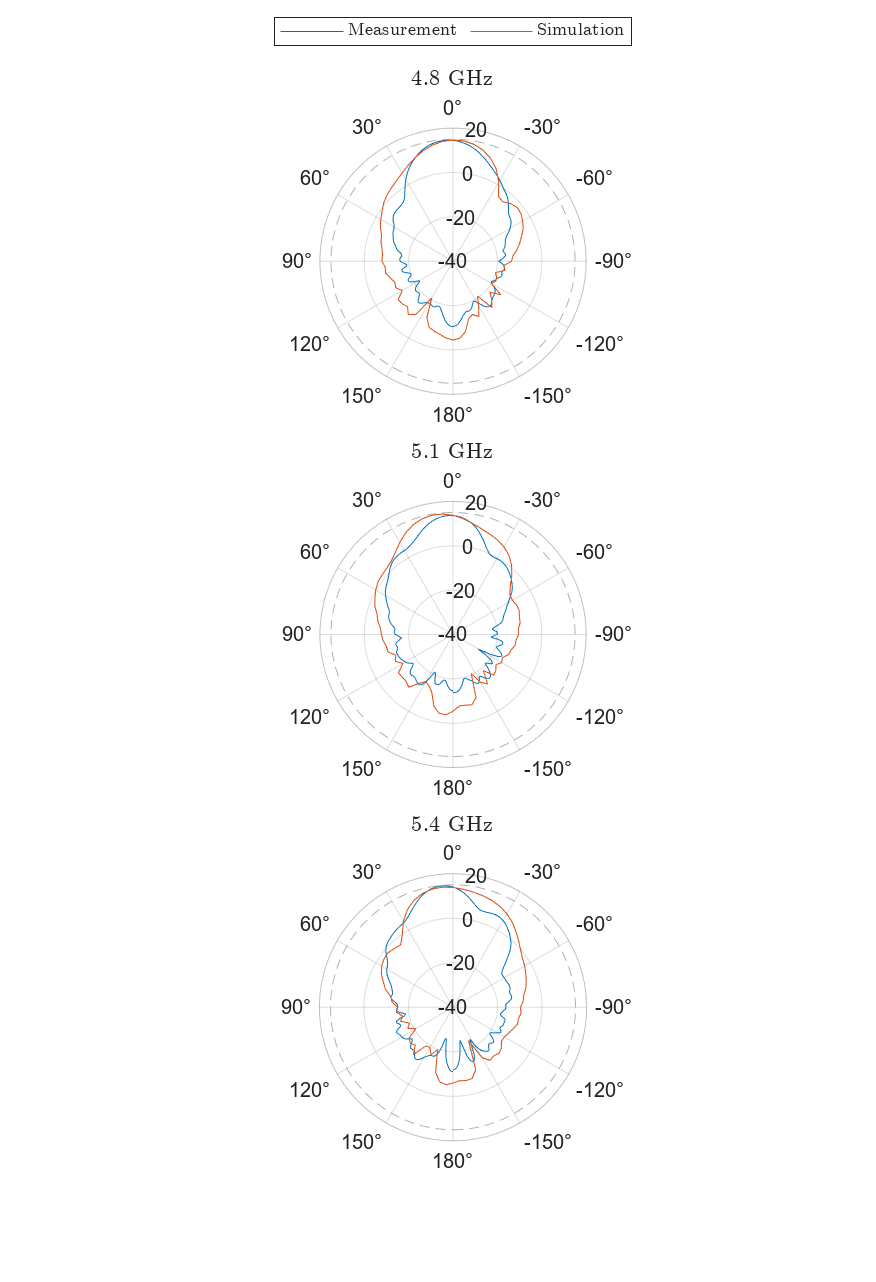
[picture p106: page 1]
