simakma5/diploma-thesis/latex/svg-inkscape/antenna2_port2_azimuth_svg-tex.pdf

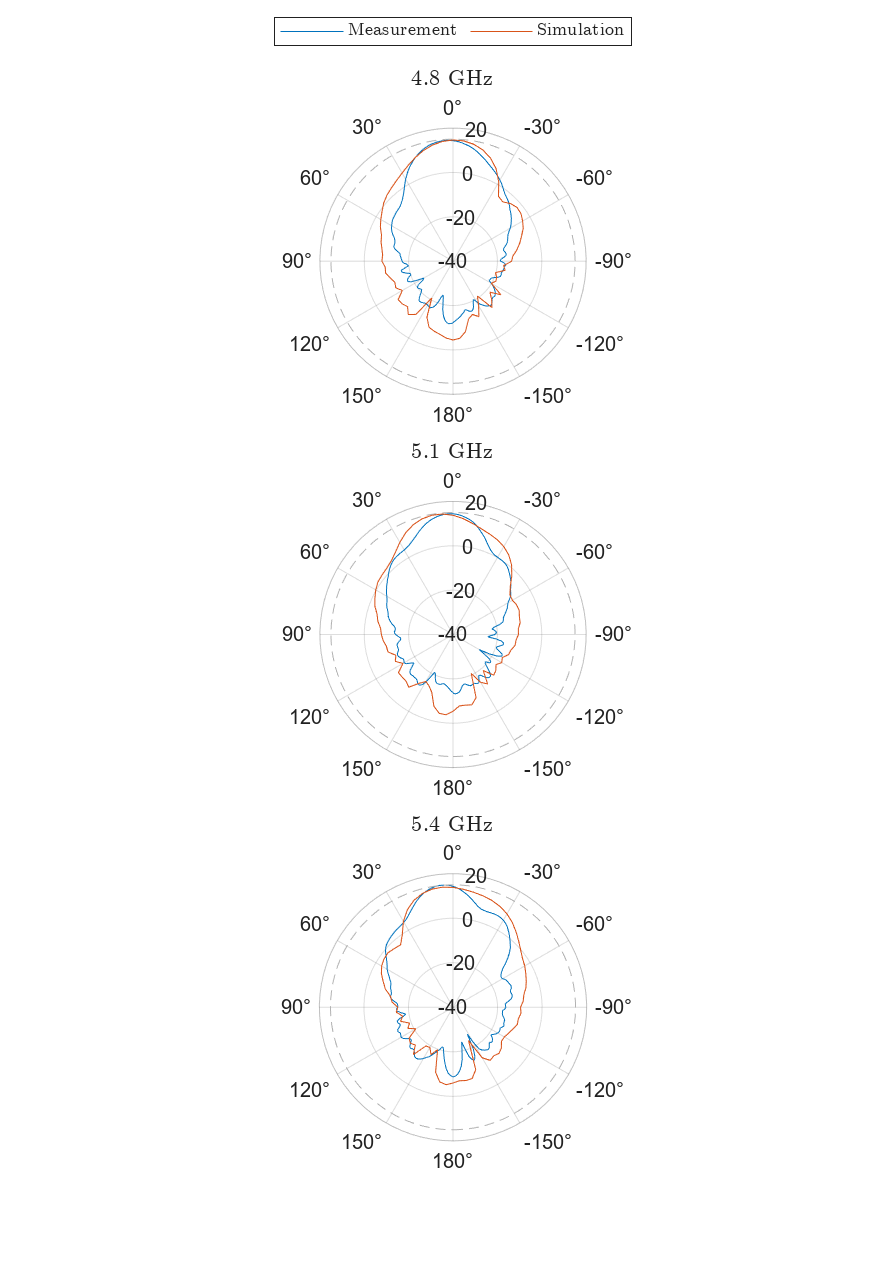
[picture p107: page 1]
