simakma5/diploma-thesis/latex/svg-inkscape/antenna2_port2_elevation_svg-tex.pdf

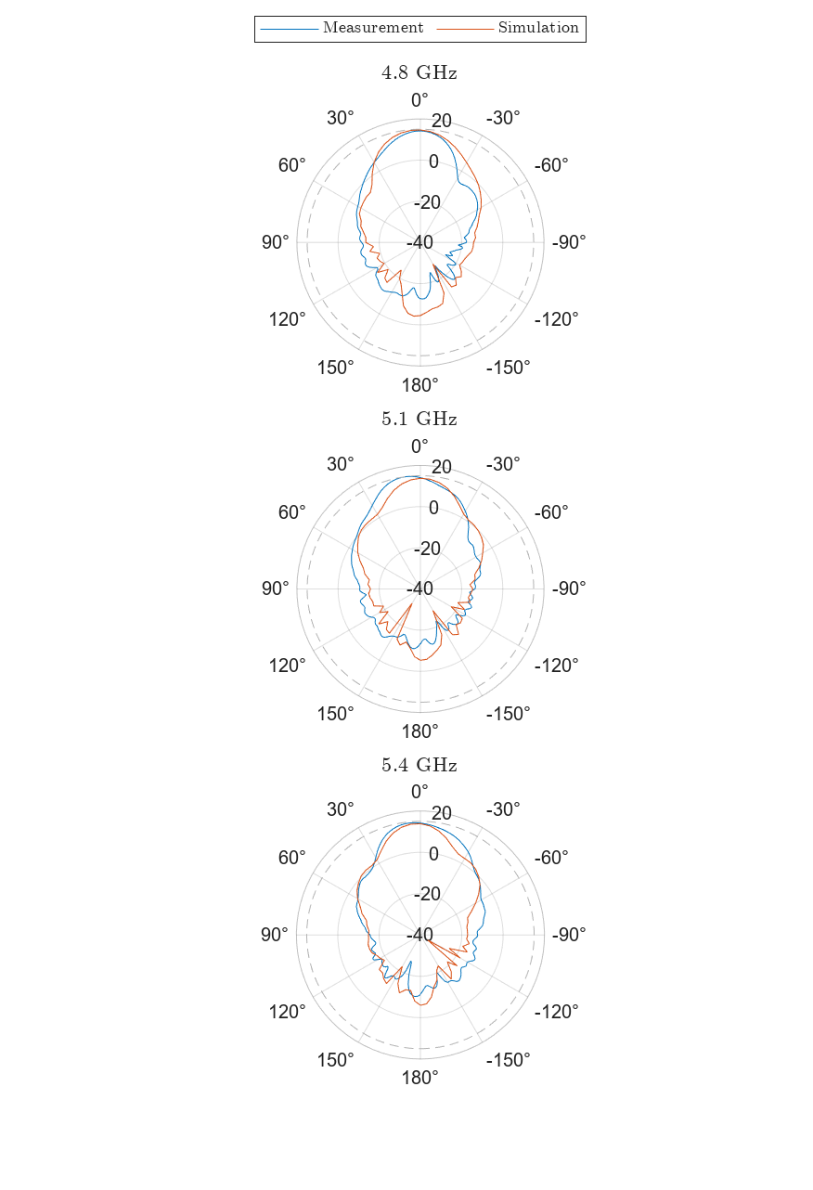
[picture p108: page 1]
