simakma5/diploma-thesis/latex/svg-inkscape/antenna2_azimuth_svg-tex.pdf

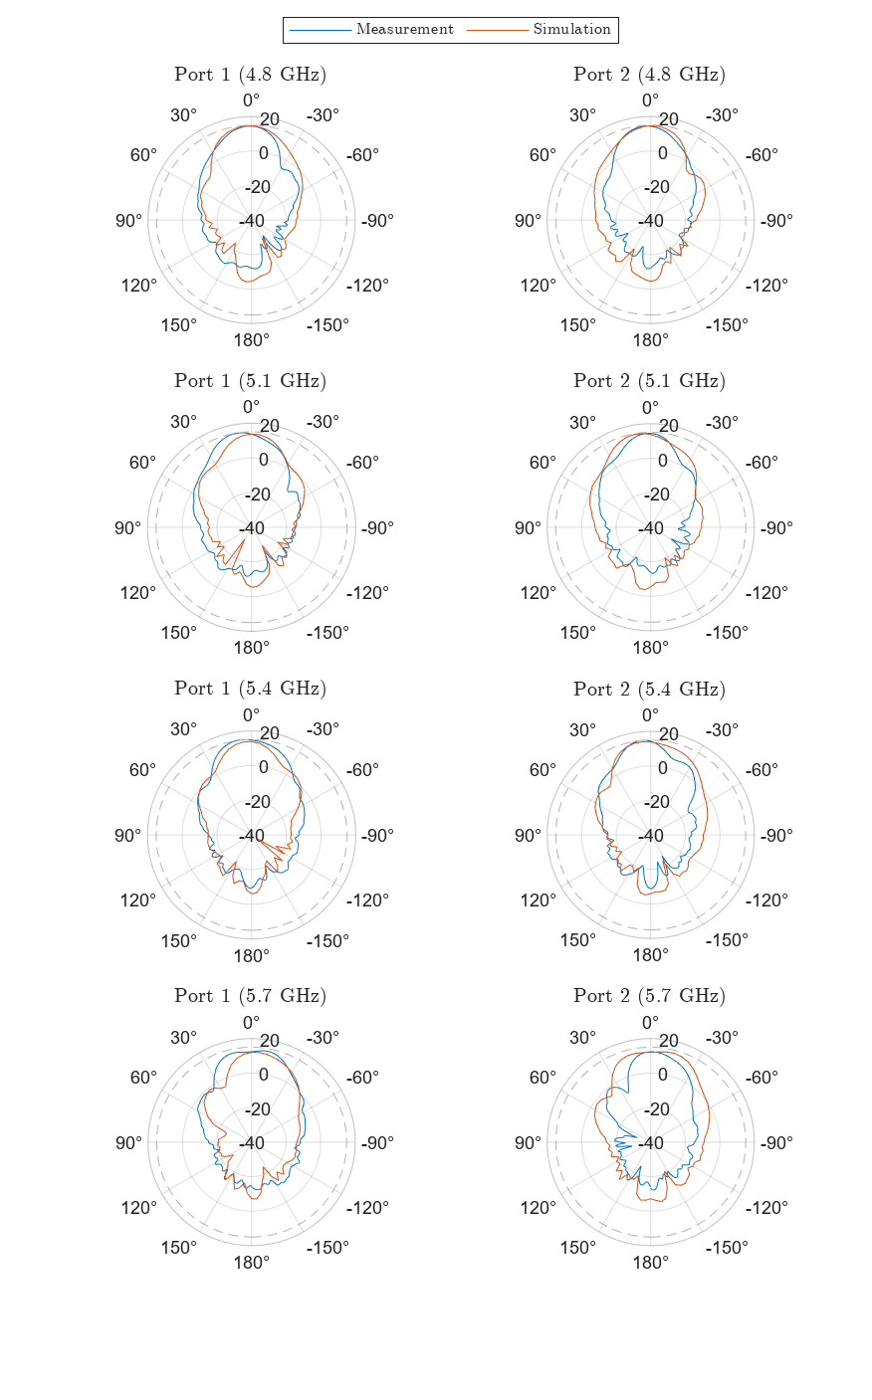
[picture p109: page 1]
