simakma5/diploma-thesis/latex/svg-inkscape/antenna2_elevation_svg-tex.pdf

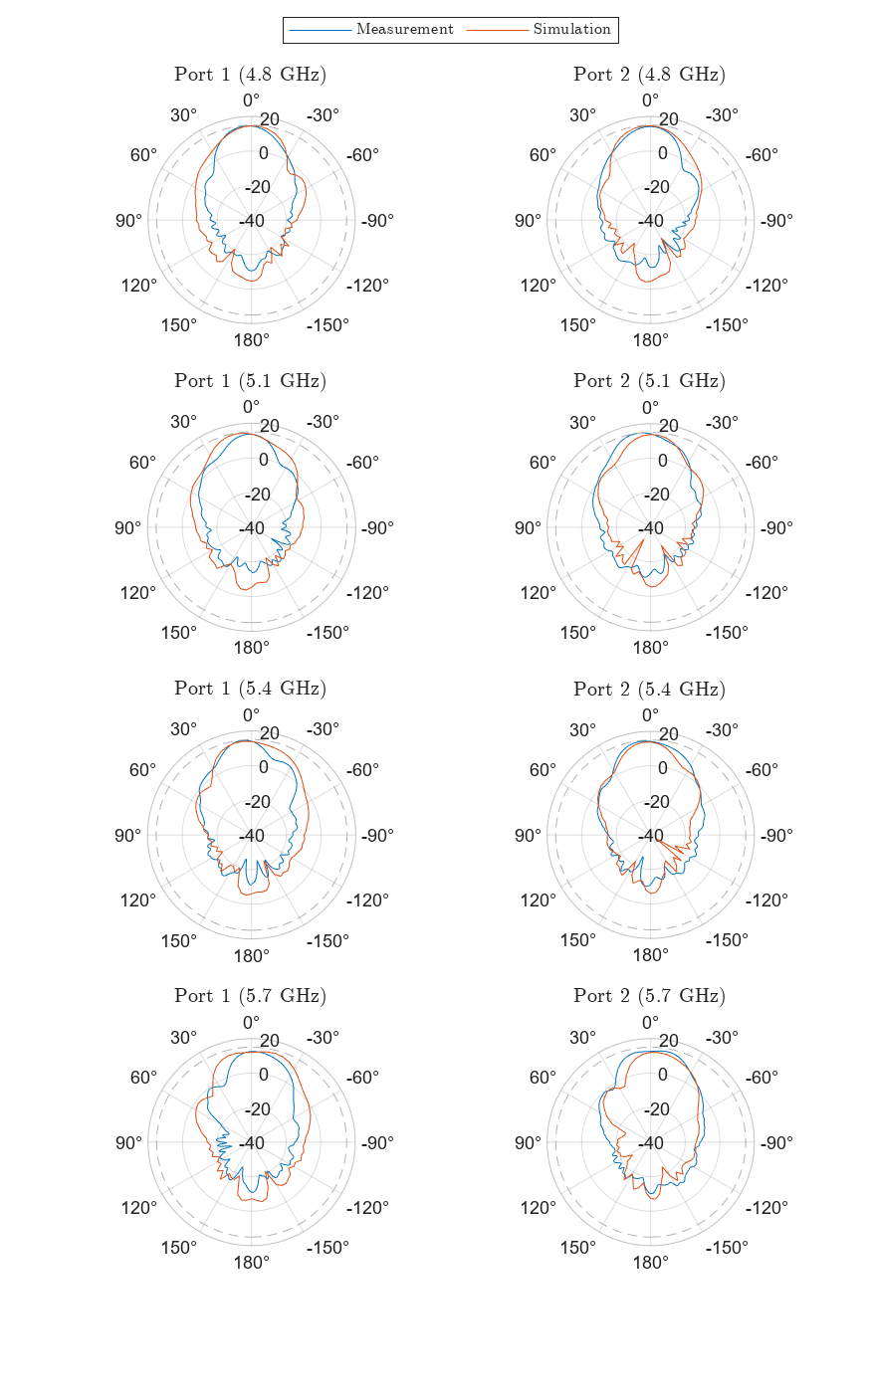
[picture p110: page 1]
