simakma5/diploma-thesis/outputs/completion/axial_ratio.png

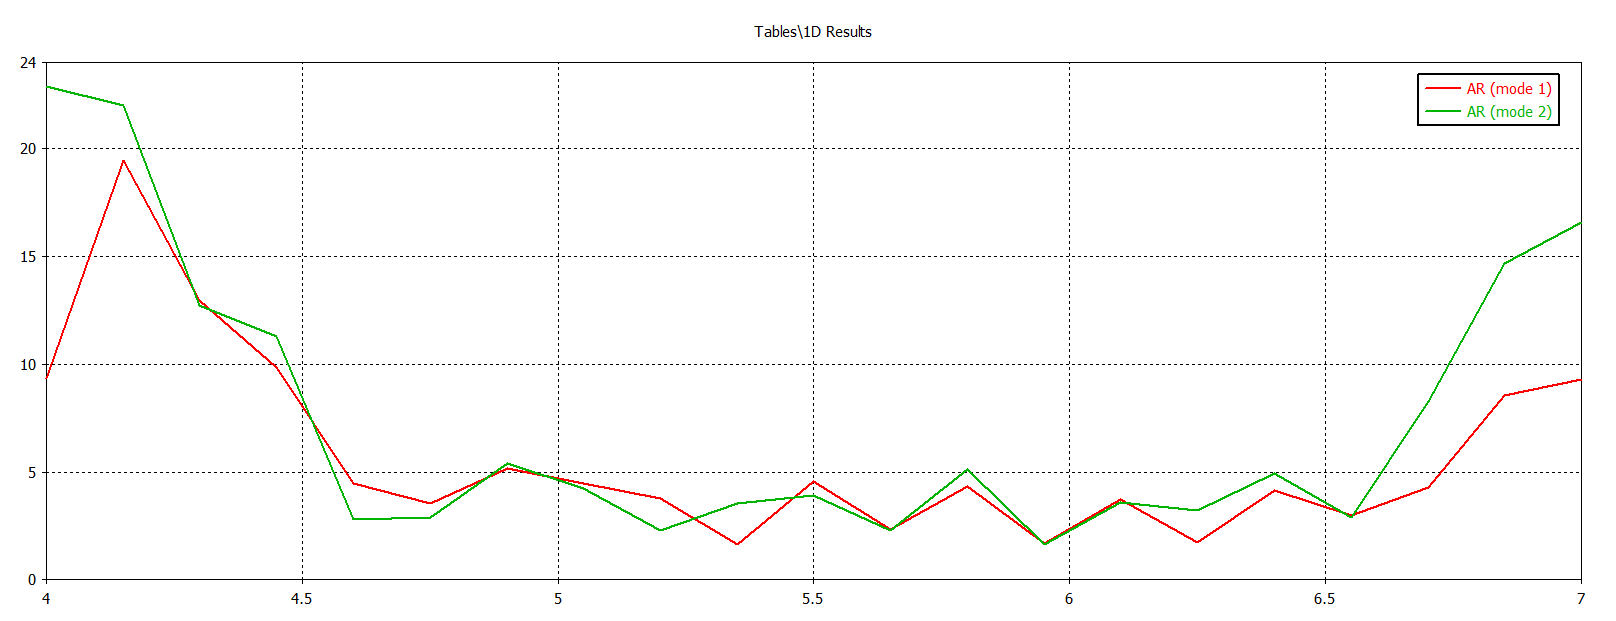
outputs/completion/axial_ratio.png
