simakma5/diploma-thesis/outputs/completion/crosstalk.png

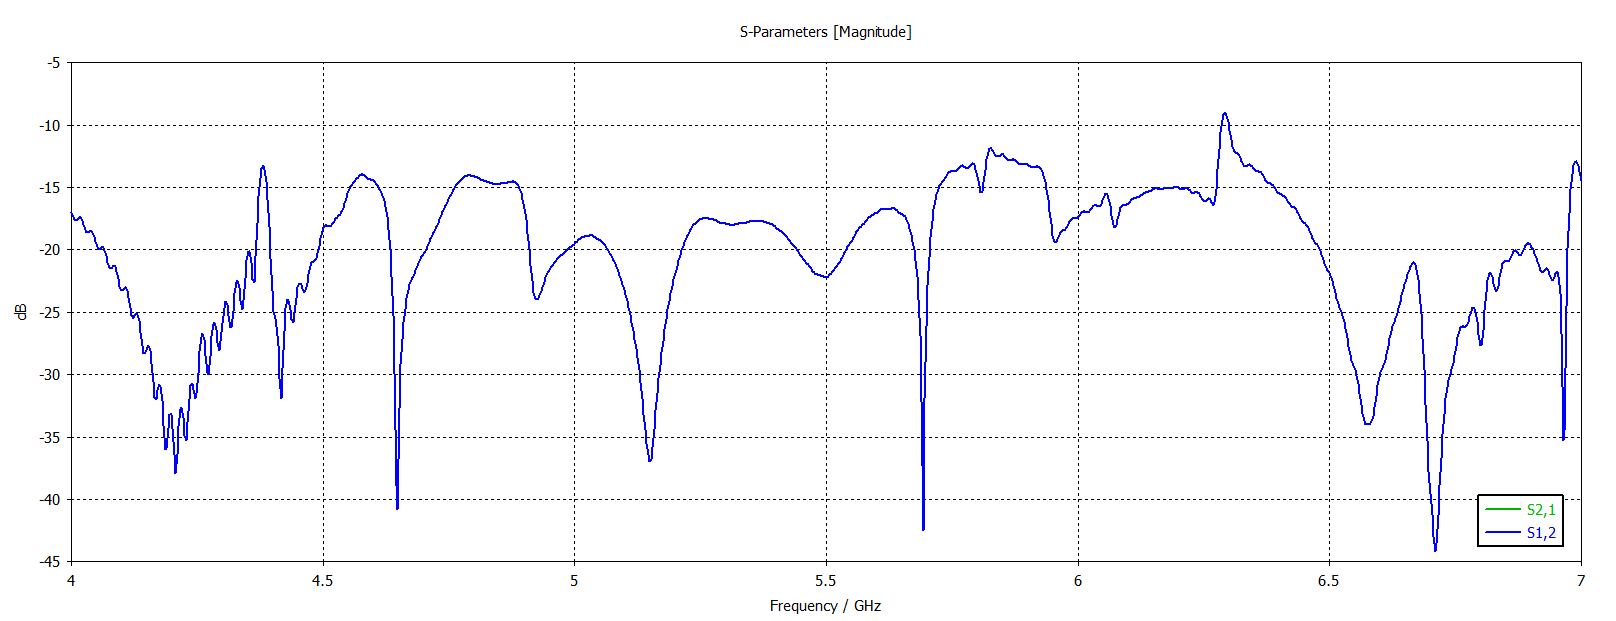
outputs/completion/crosstalk.png
