simakma5/diploma-thesis/outputs/completion/reflection.png

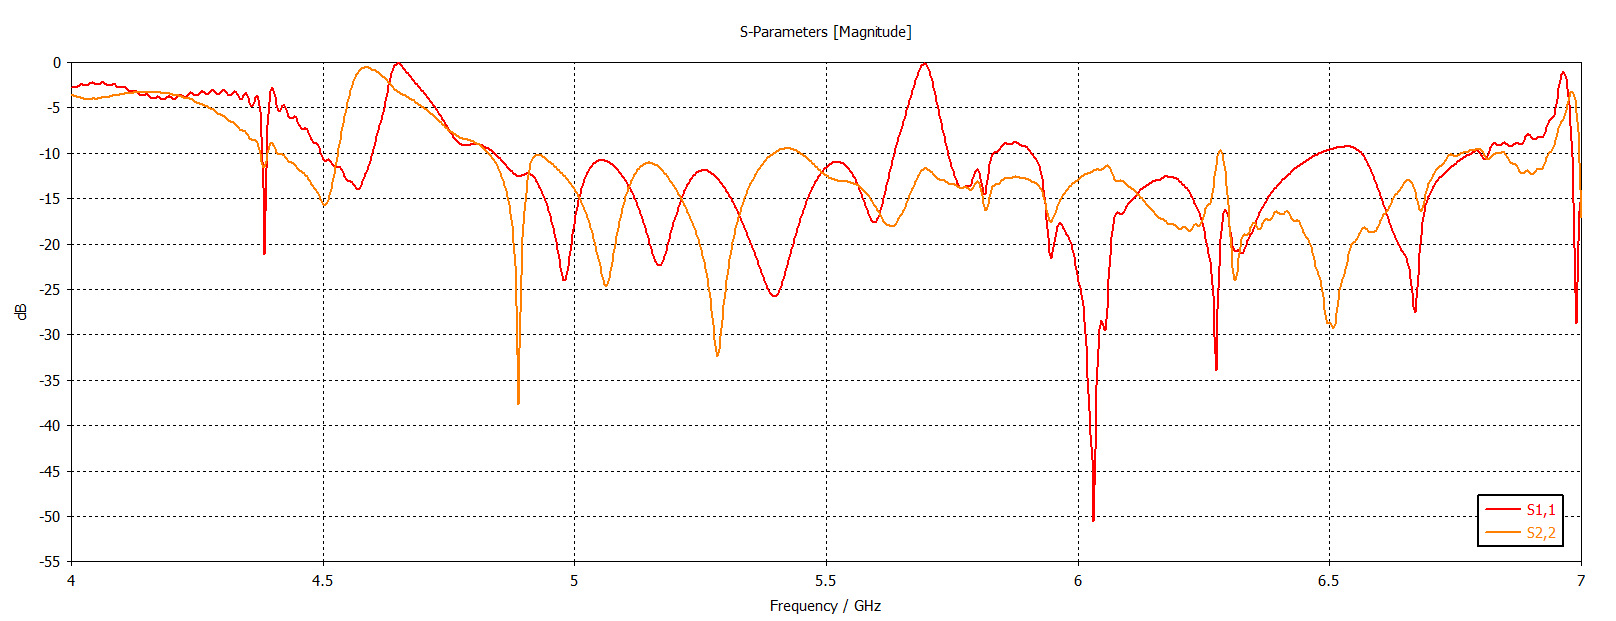
outputs/completion/reflection.png
