simakma5/diploma-thesis/outputs/conical-horn/radiation_mode1.png

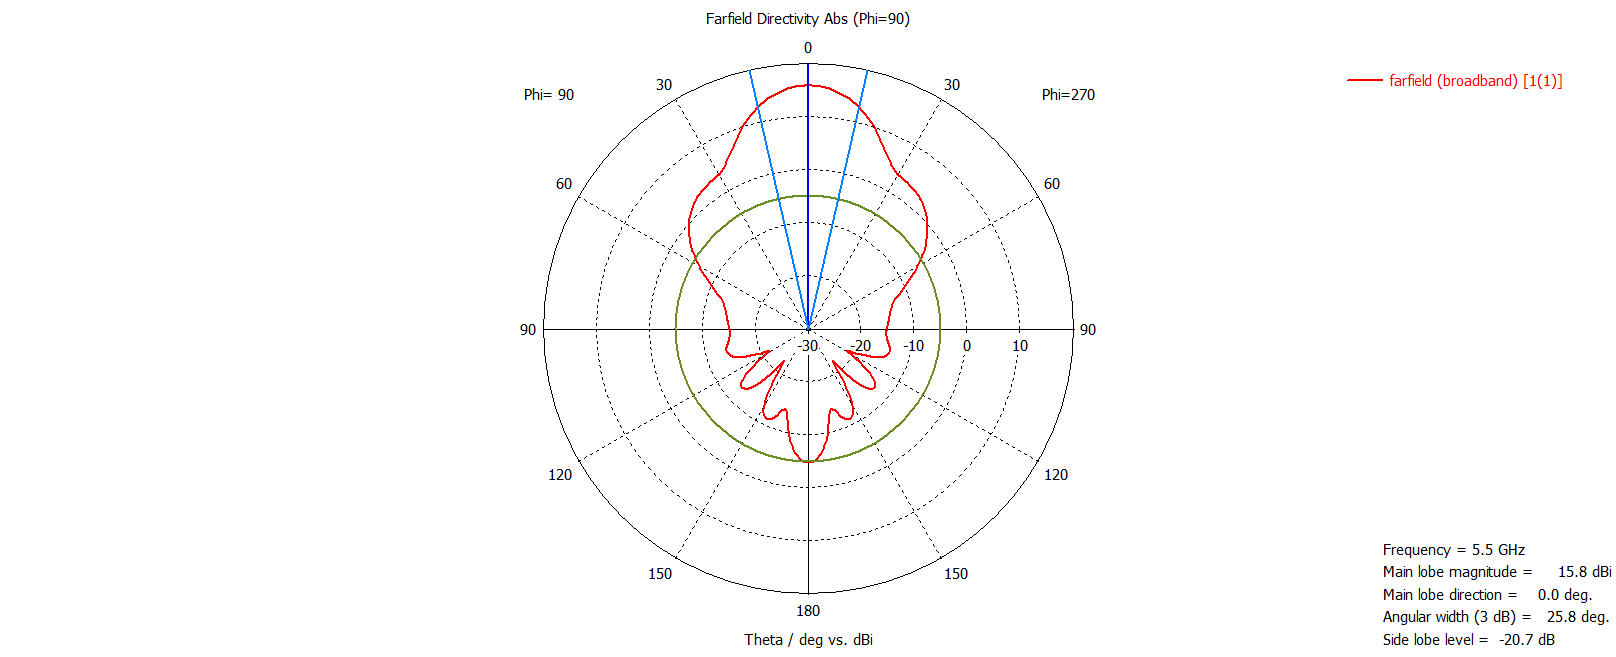
outputs/conical-horn/radiation_mode1.png
