simakma5/diploma-thesis/outputs/dual-feed/2024-11-21-optimization_values.png

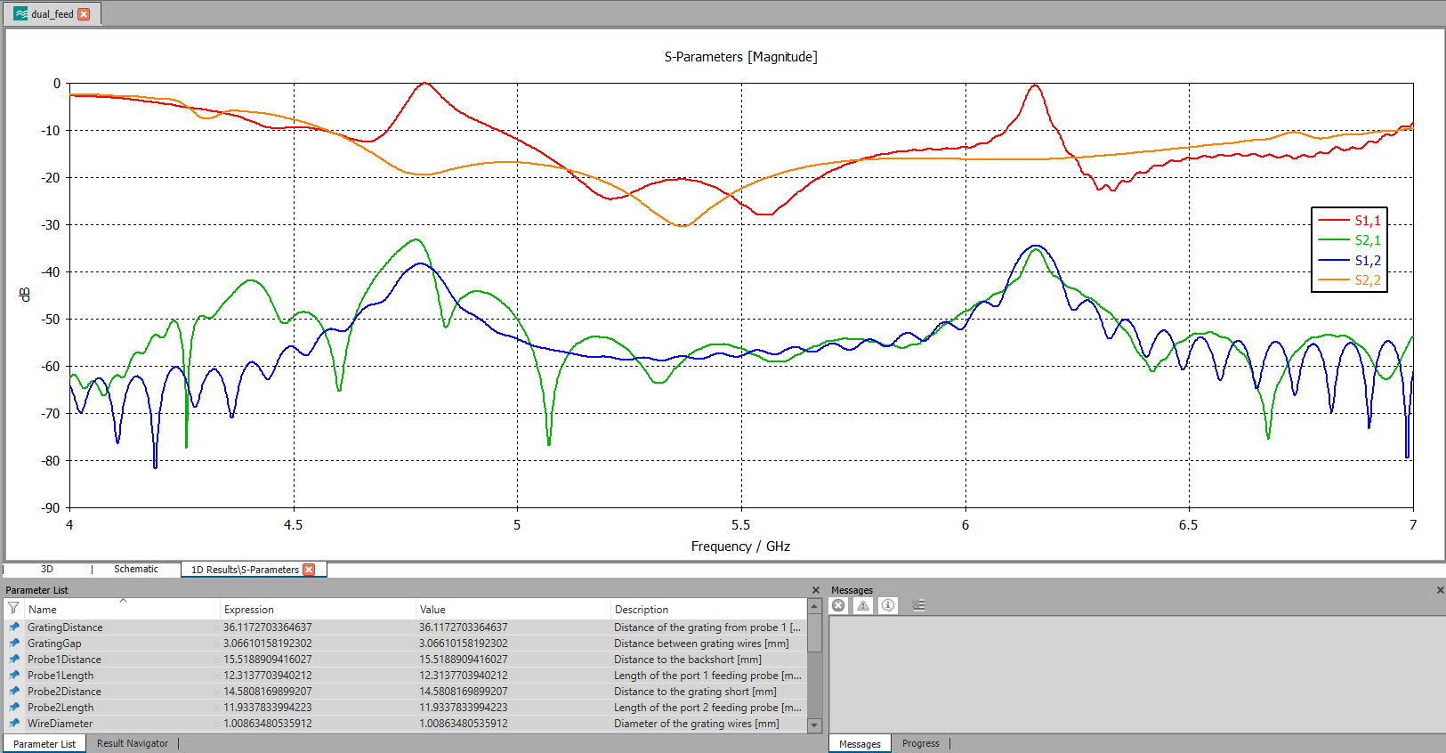
outputs/dual-feed/2024-11-21-optimization_values.png
