simakma5/diploma-thesis/outputs/dual-feed/incremental_stages/dual_feed-crosstalk.png

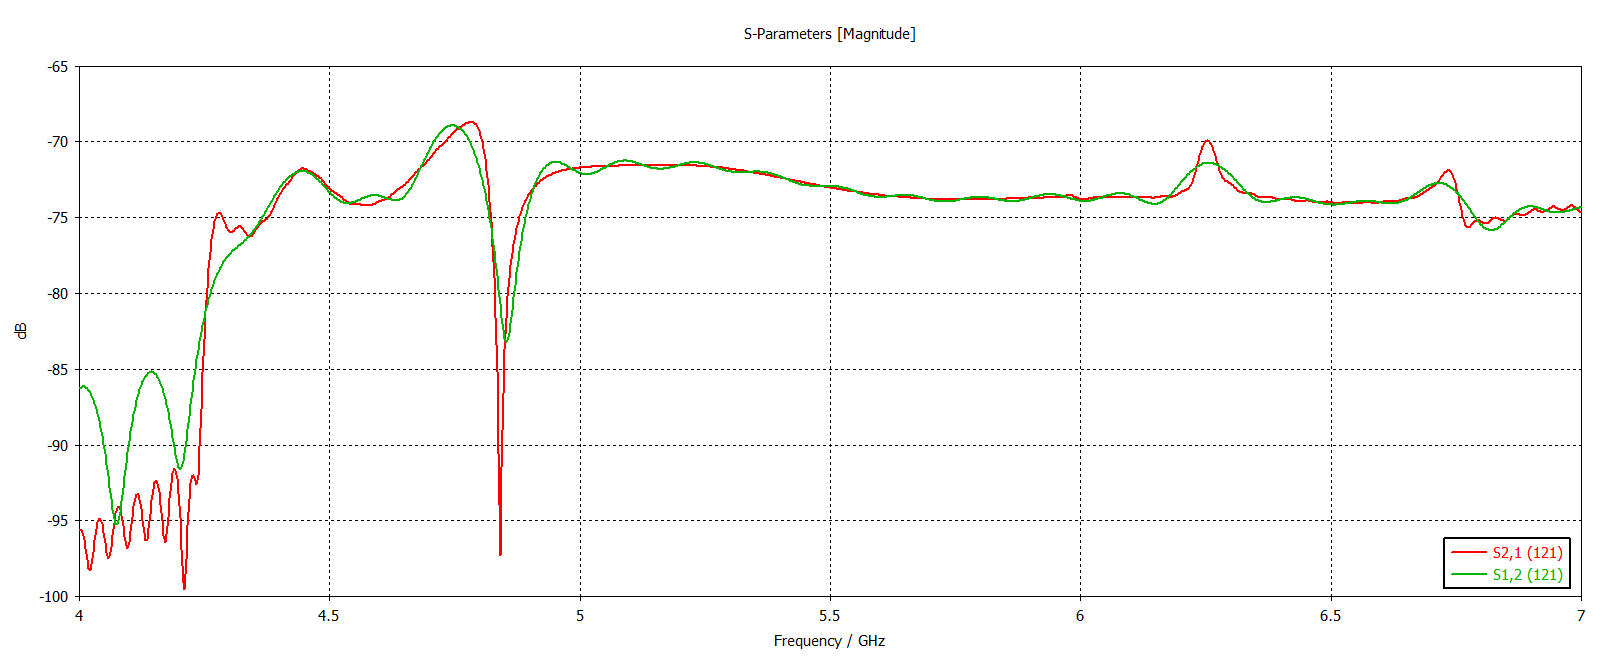
outputs/dual-feed/incremental_stages/dual_feed-crosstalk.png
