simakma5/diploma-thesis/outputs/dual-feed/incremental_stages/single_feed-reflection.png

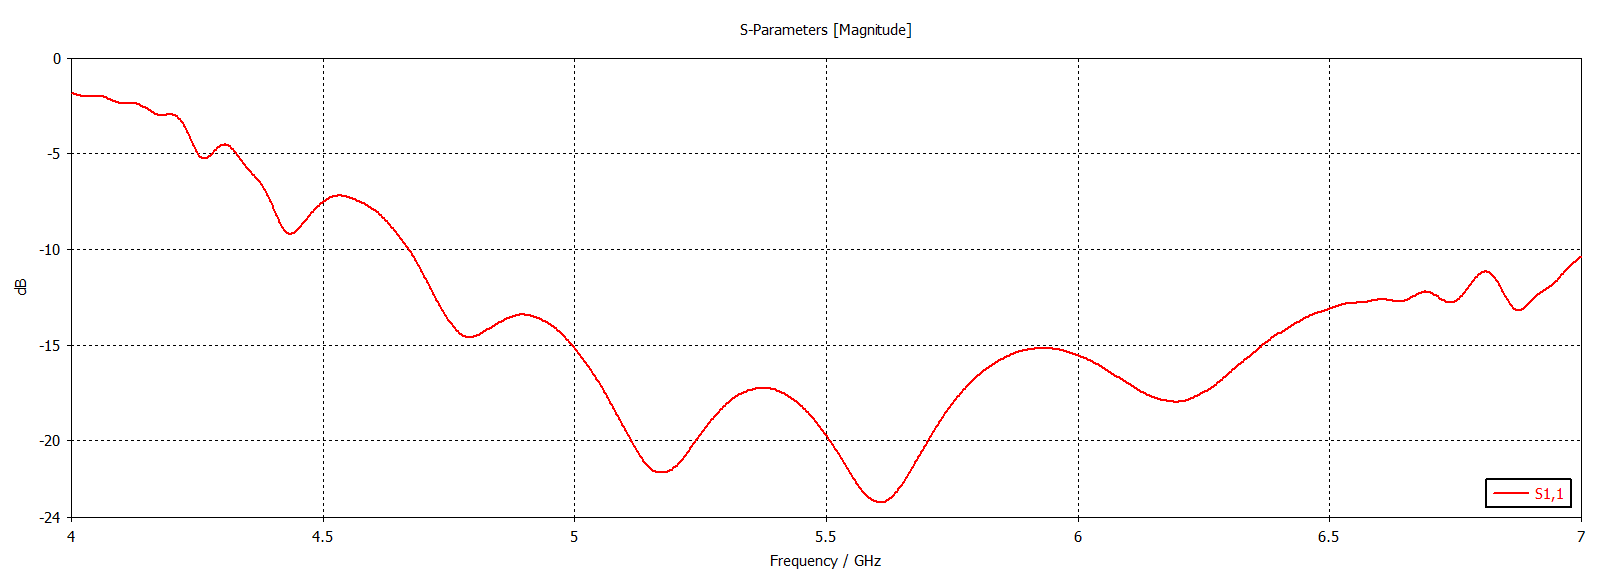
outputs/dual-feed/incremental_stages/single_feed-reflection.png
