simakma5/diploma-thesis/outputs/polarizer/figures_of_merit_comparison/probe_x-amplitude.png

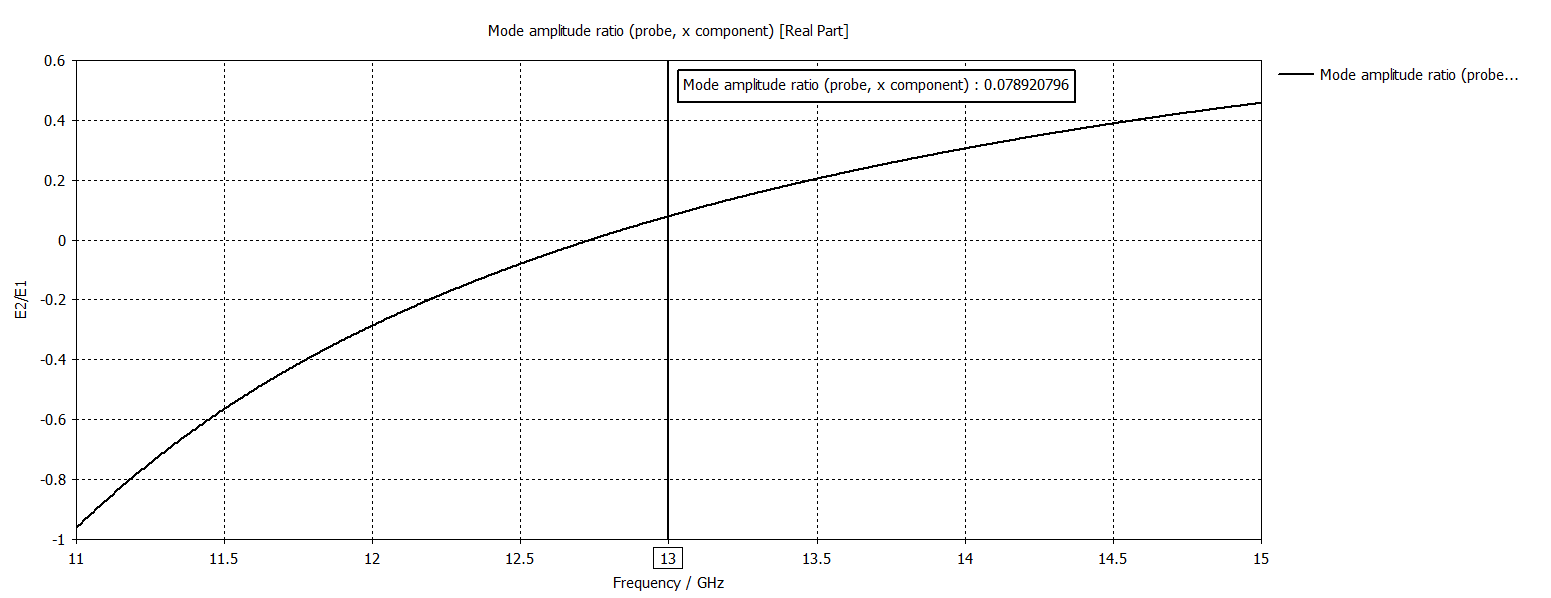
outputs/polarizer/figures_of_merit_comparison/probe_x-amplitude.png
