simakma5/diploma-thesis/outputs/polarizer/figures_of_merit_comparison/s_parameters-amplitude.png

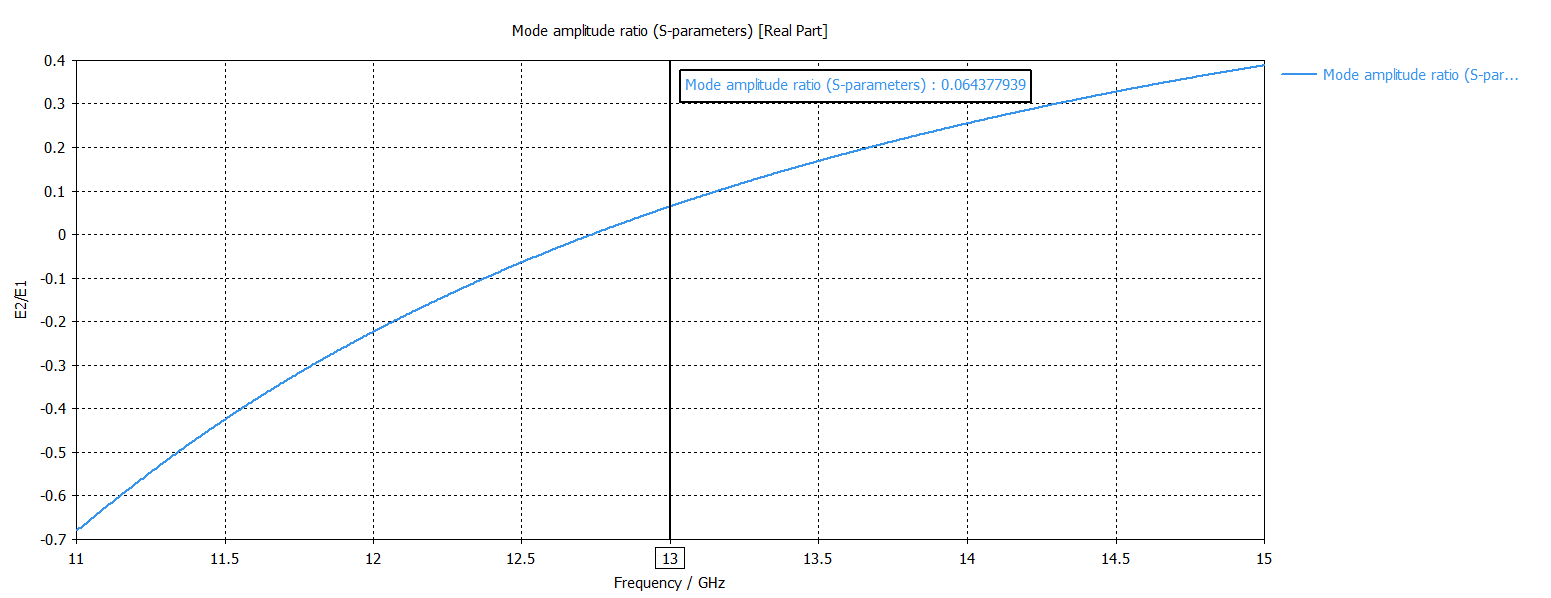
outputs/polarizer/figures_of_merit_comparison/s_parameters-amplitude.png
