simakma5/diploma-thesis/outputs/polarizer/stage1-polarizer_modelling/3d.png

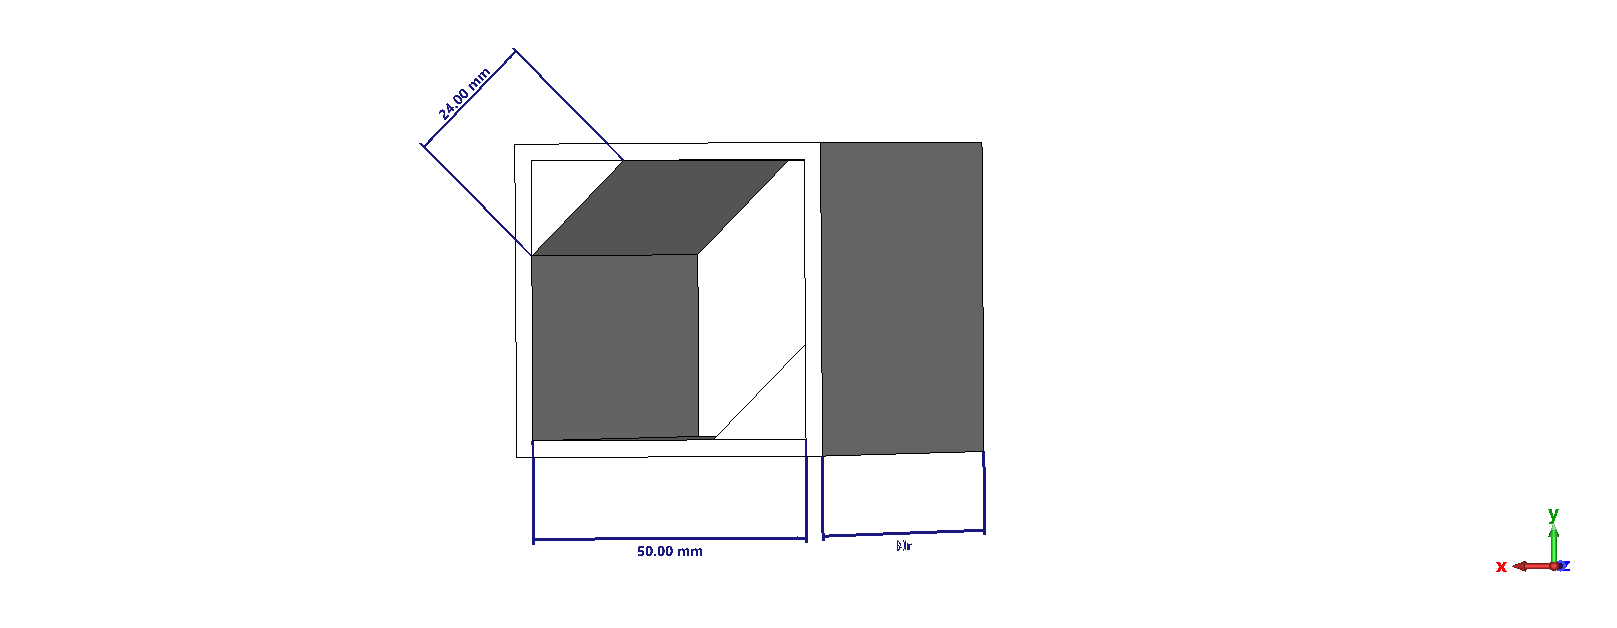
outputs/polarizer/stage1-polarizer_modelling/3d.png
