simakma5/diploma-thesis/outputs/polarizer/stage1-polarizer_modelling/45mm-absolute_mode_phase_lag.png

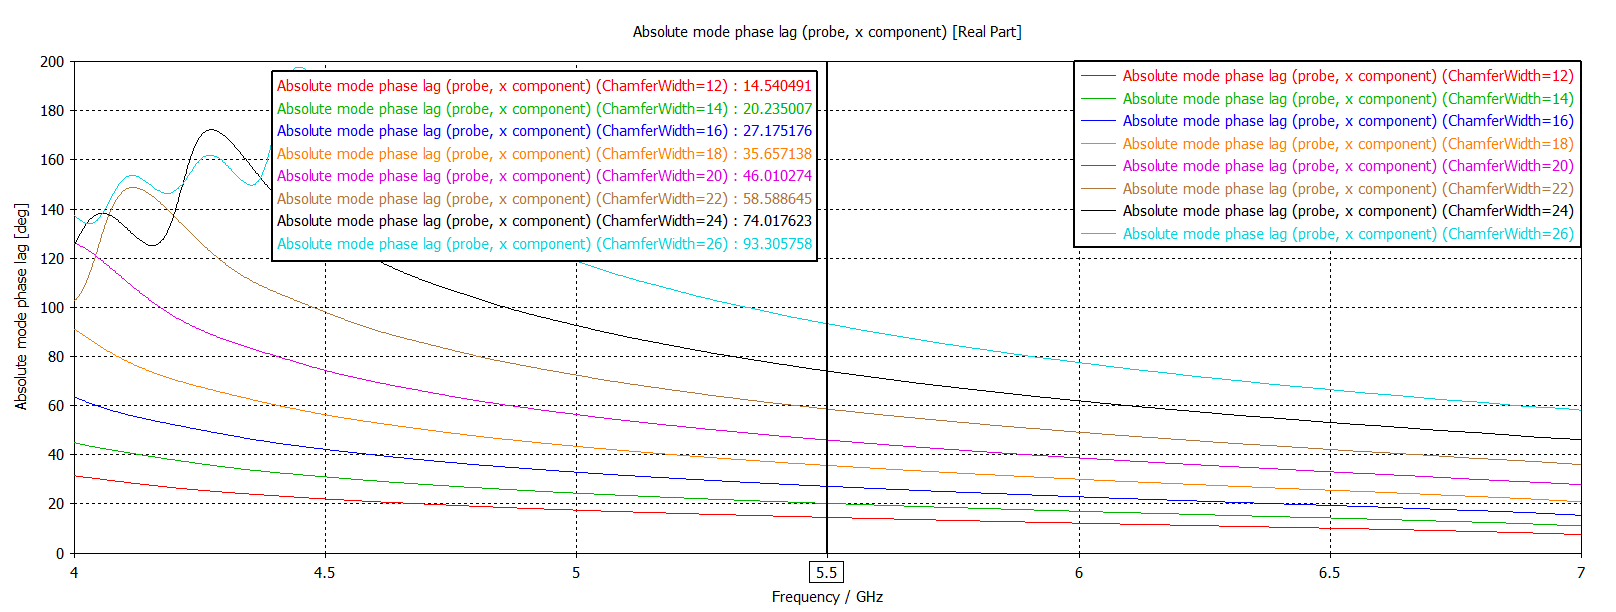
outputs/polarizer/stage1-polarizer_modelling/45mm-absolute_mode_phase_lag.png
