simakma5/diploma-thesis/outputs/polarizer/stage1-polarizer_modelling/45mm-length_required_for_90_deg_length_60mm.png

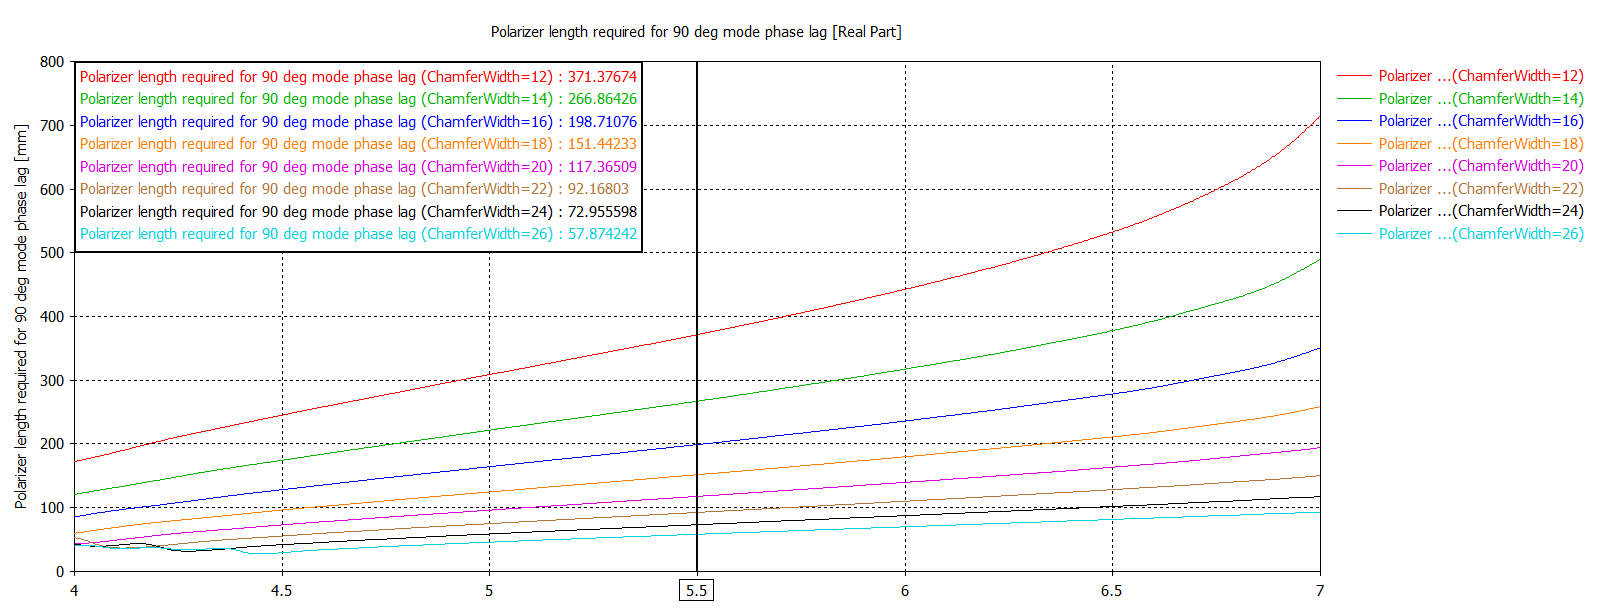
outputs/polarizer/stage1-polarizer_modelling/45mm-length_required_for_90_deg_length_60mm.png
