simakma5/diploma-thesis/outputs/polarizer/stage1-polarizer_modelling/50mm-cutoff_frequency.png

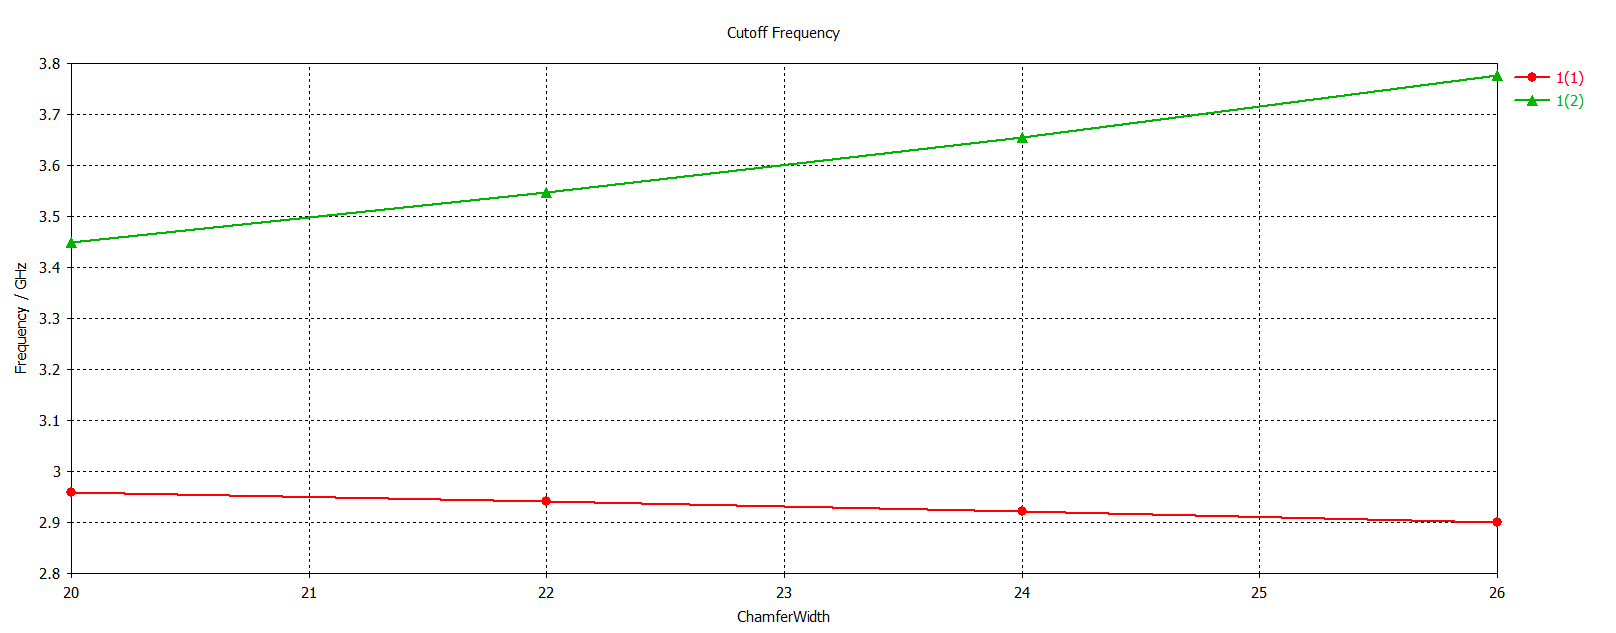
outputs/polarizer/stage1-polarizer_modelling/50mm-cutoff_frequency.png
