simakma5/diploma-thesis/outputs/polarizer/stage1-polarizer_modelling/50mm-length_required_for_90_deg-100mm.png

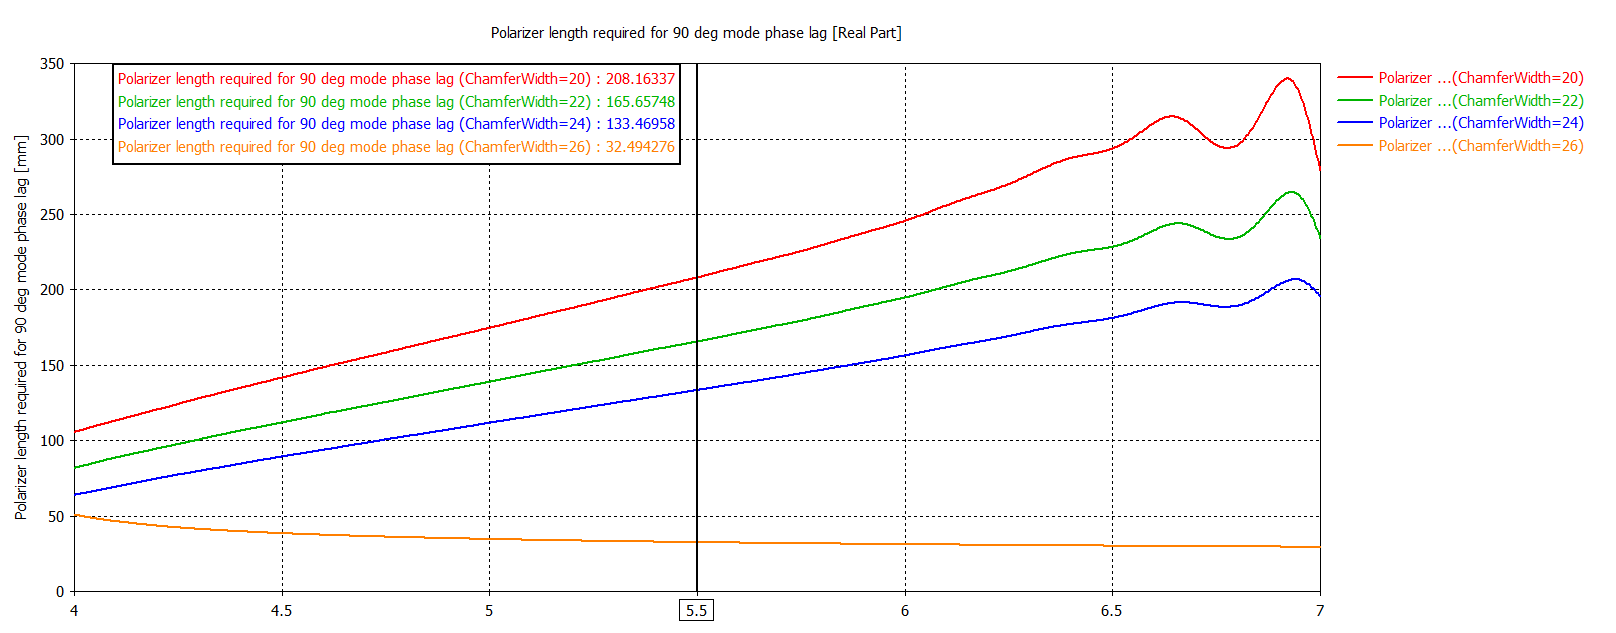
outputs/polarizer/stage1-polarizer_modelling/50mm-length_required_for_90_deg-100mm.png
