simakma5/diploma-thesis/outputs/polarizer/stage1-polarizer_modelling/50mm-mode1_probe_phase.png

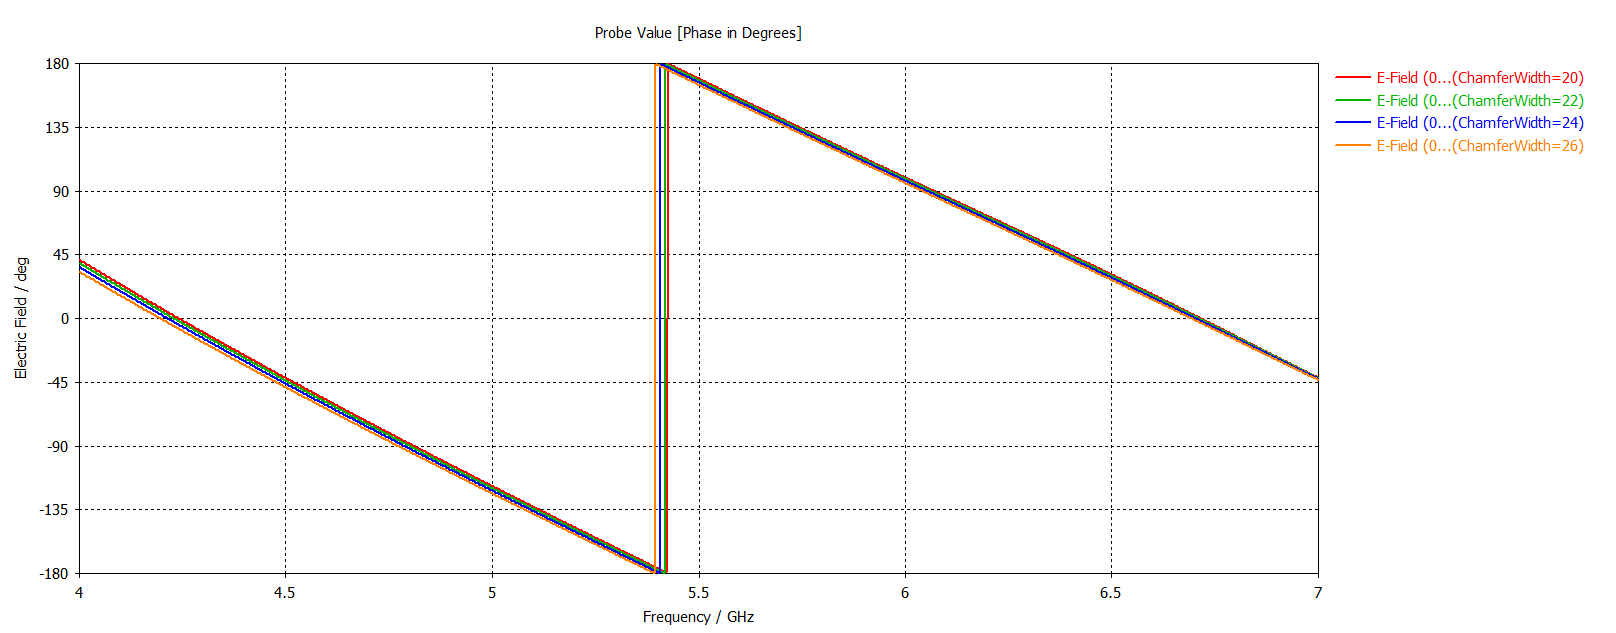
outputs/polarizer/stage1-polarizer_modelling/50mm-mode1_probe_phase.png
