simakma5/diploma-thesis/outputs/polarizer/stage1-polarizer_modelling/50mm-mode2_probe_phase.png

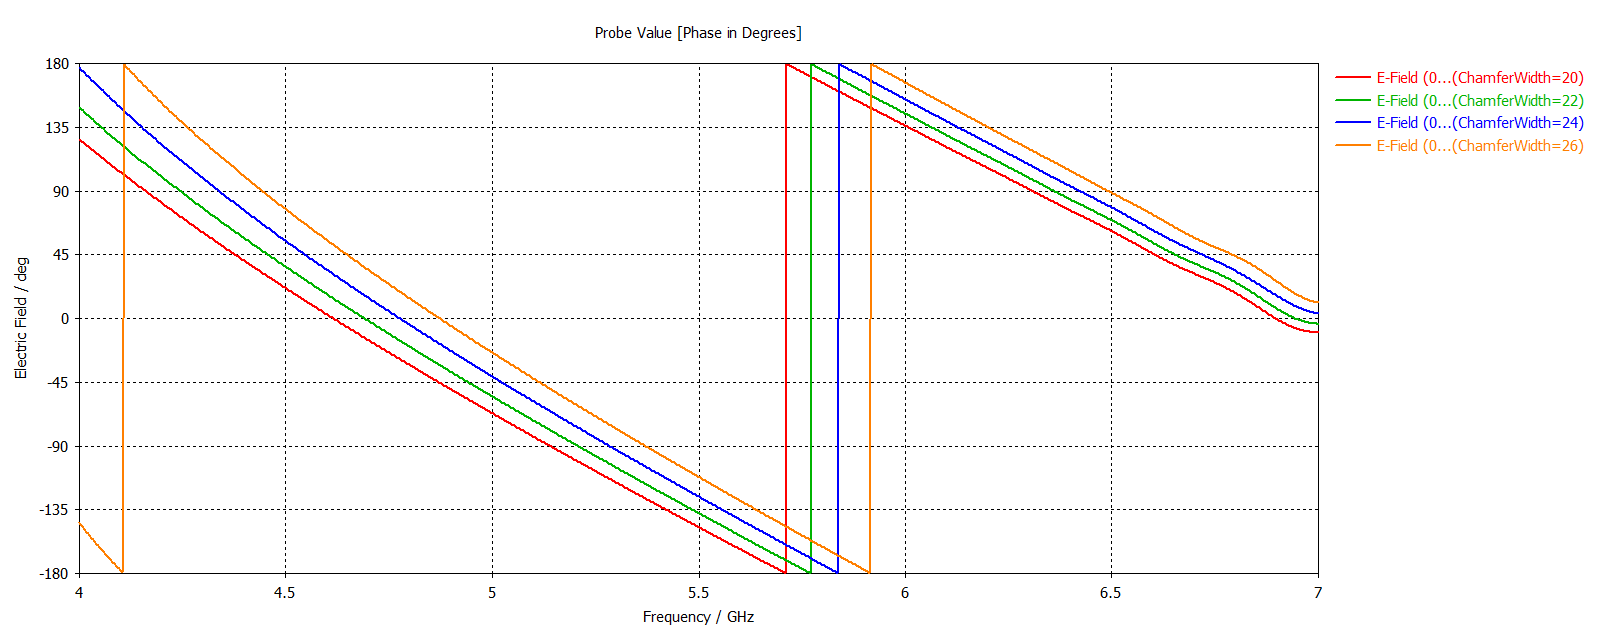
outputs/polarizer/stage1-polarizer_modelling/50mm-mode2_probe_phase.png
