simakma5/diploma-thesis/outputs/polarizer/stage1-polarizer_modelling/50mm-mode_amplitude_ratio.png

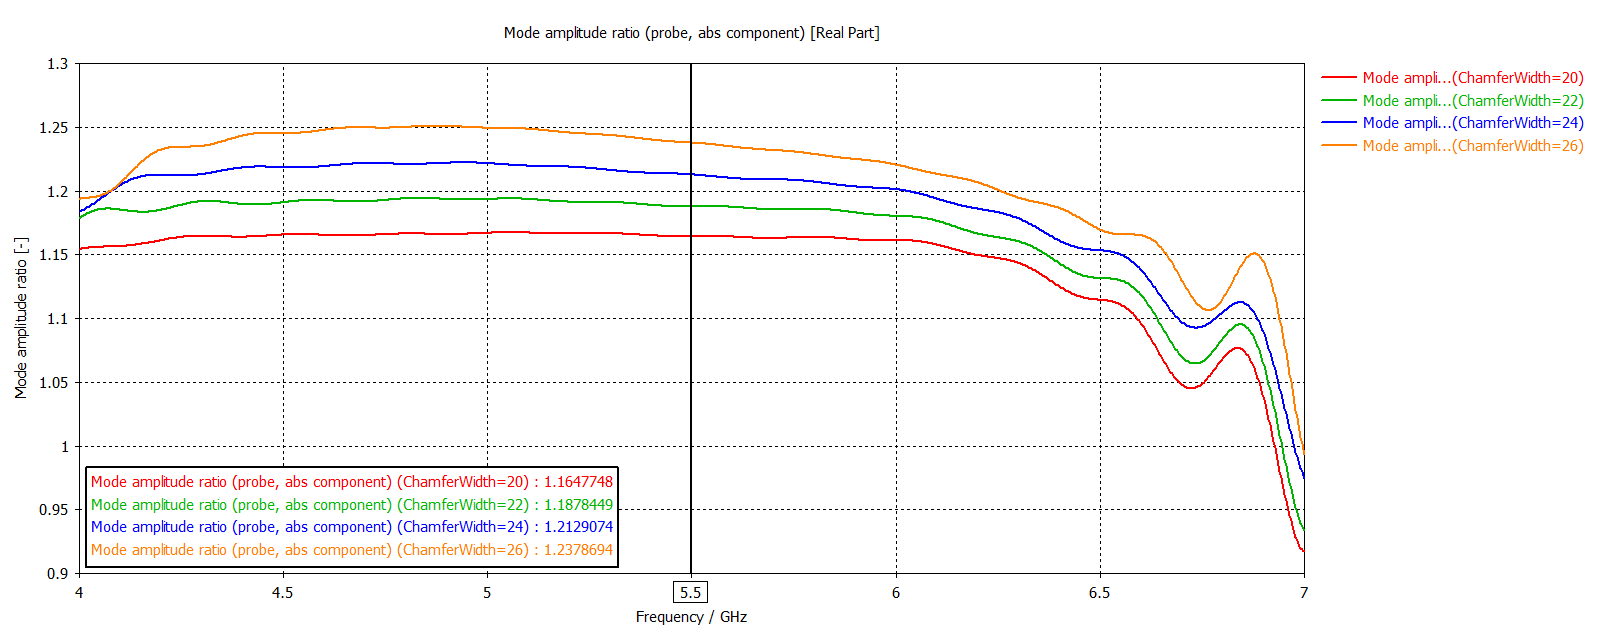
outputs/polarizer/stage1-polarizer_modelling/50mm-mode_amplitude_ratio.png
