simakma5/diploma-thesis/outputs/polarizer/stage1-polarizer_modelling/50mm-mode_phase_lag-100mm.png

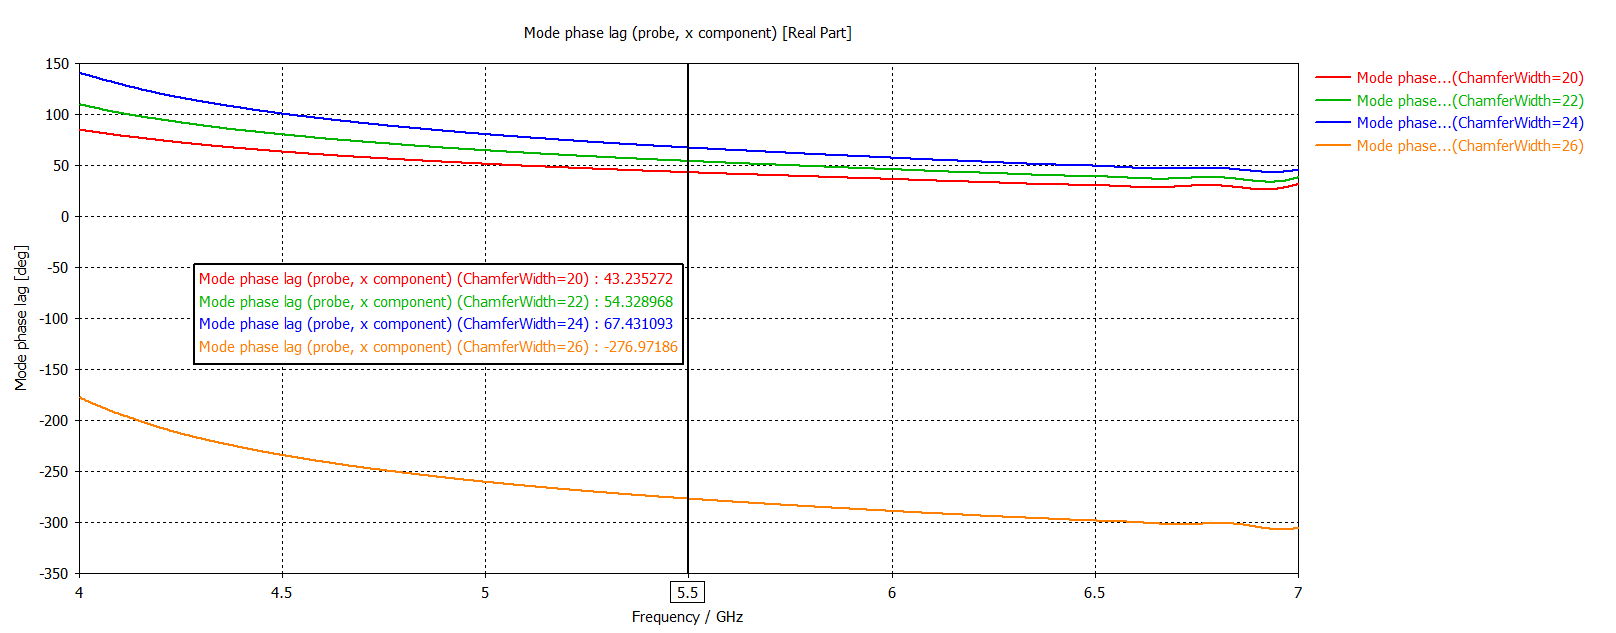
outputs/polarizer/stage1-polarizer_modelling/50mm-mode_phase_lag-100mm.png
