simakma5/diploma-thesis/outputs/polarizer/stage1-polarizer_modelling/mode2.gif

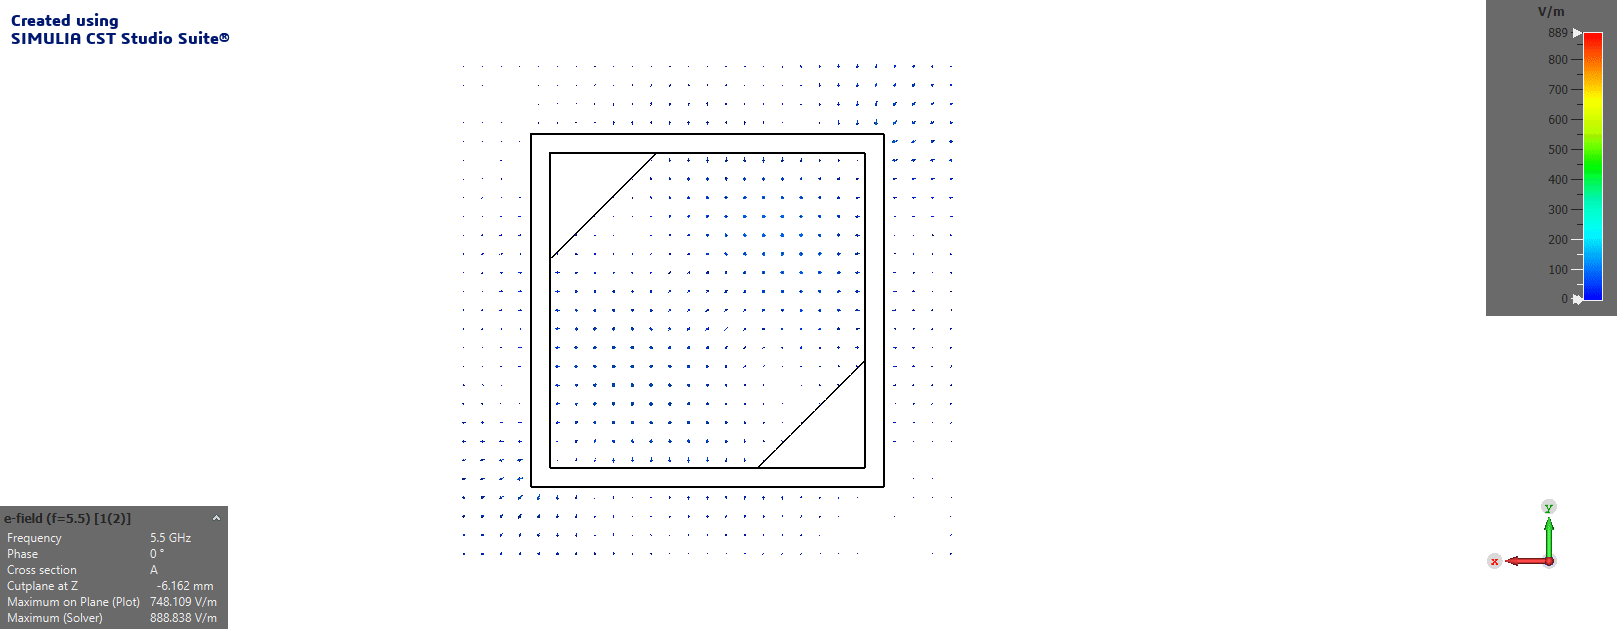
outputs/polarizer/stage1-polarizer_modelling/mode2.gif
