simakma5/diploma-thesis/outputs/polarizer/stage2-single_feed/3d.png

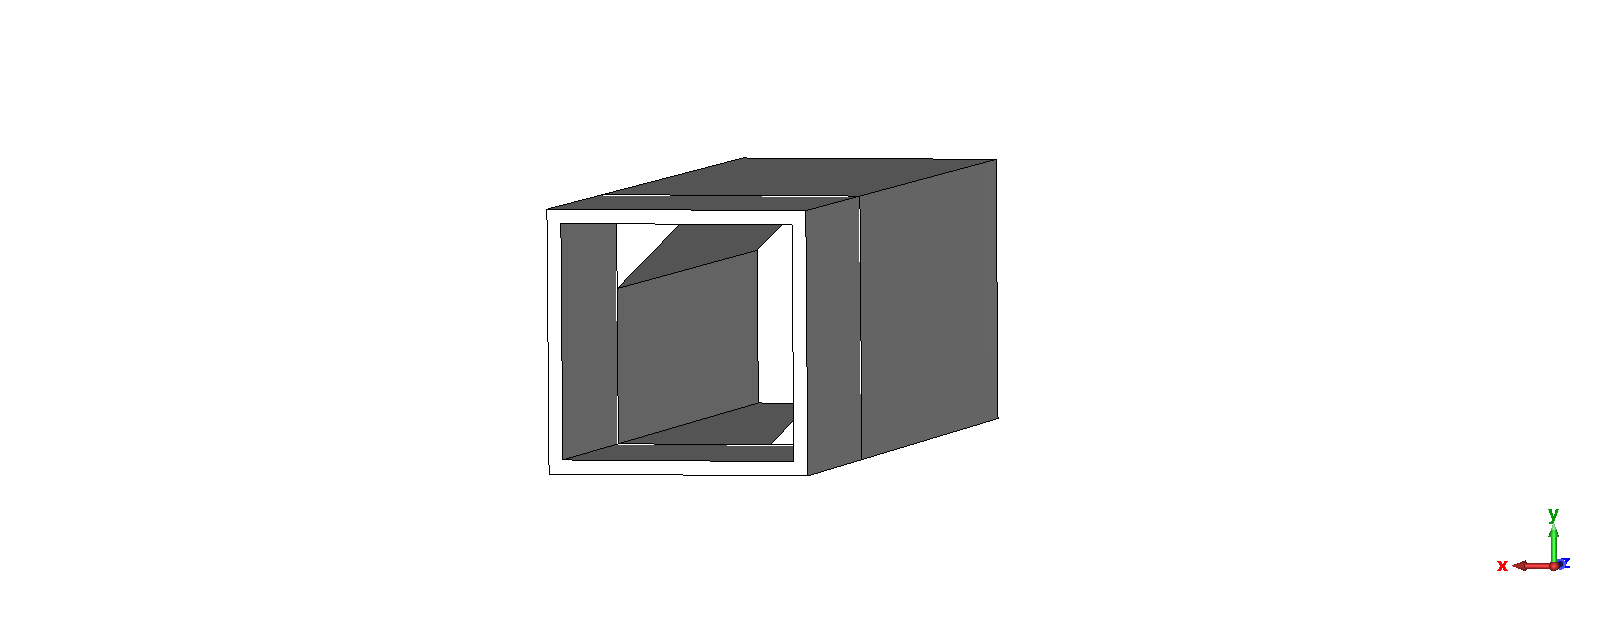
outputs/polarizer/stage2-single_feed/3d.png
