simakma5/diploma-thesis/outputs/polarizer/stage2-single_feed/mode1-output.gif

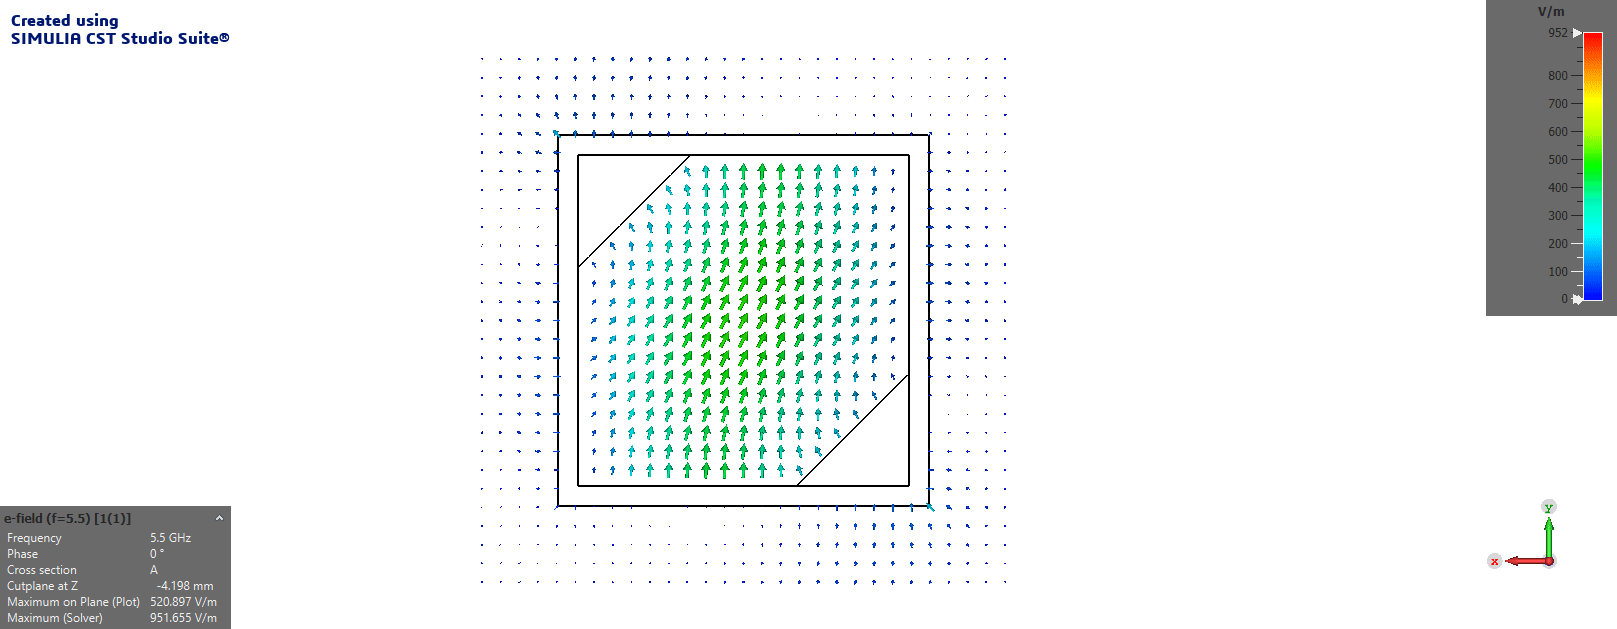
outputs/polarizer/stage2-single_feed/mode1-output.gif
