simakma5/diploma-thesis/outputs/polarizer/stage2-single_feed/mode2-output.gif

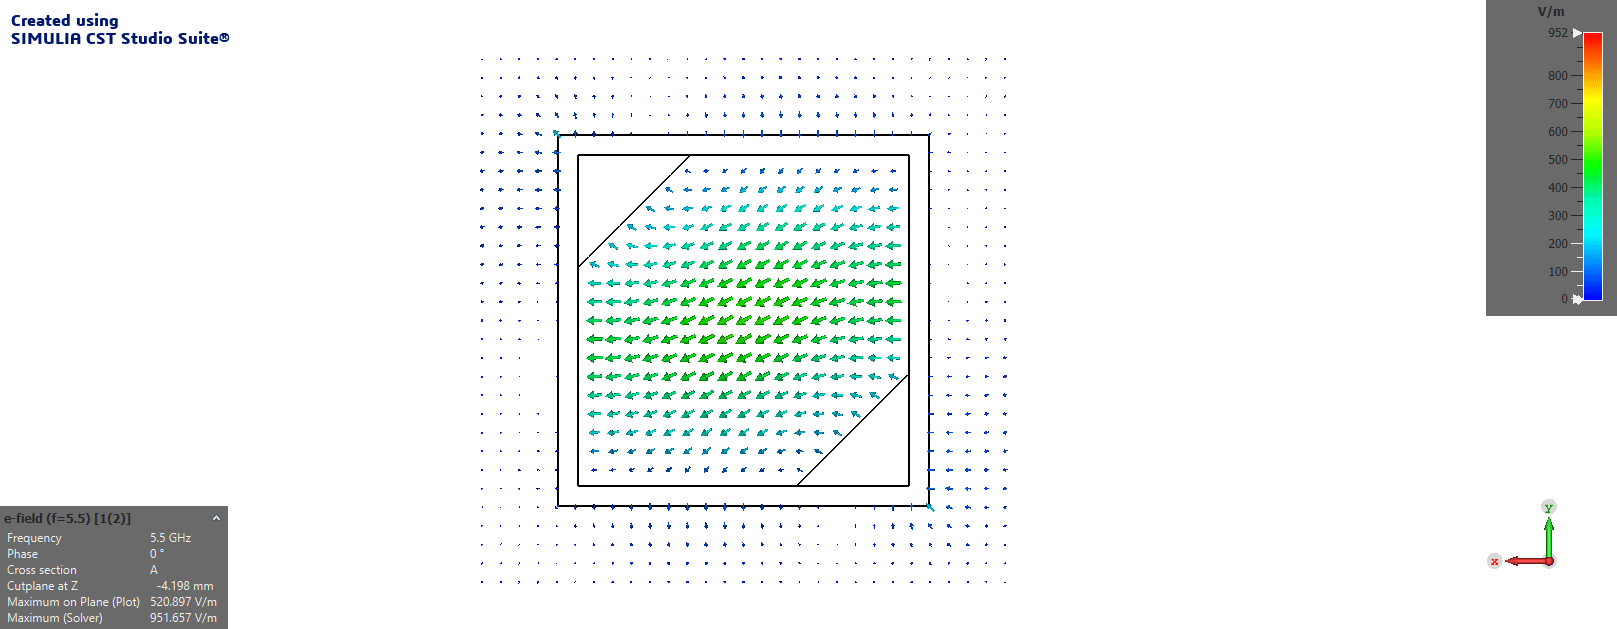
outputs/polarizer/stage2-single_feed/mode2-output.gif
