simakma5/diploma-thesis/outputs/polarizer/stage3-coaxial_feeds/3d.png

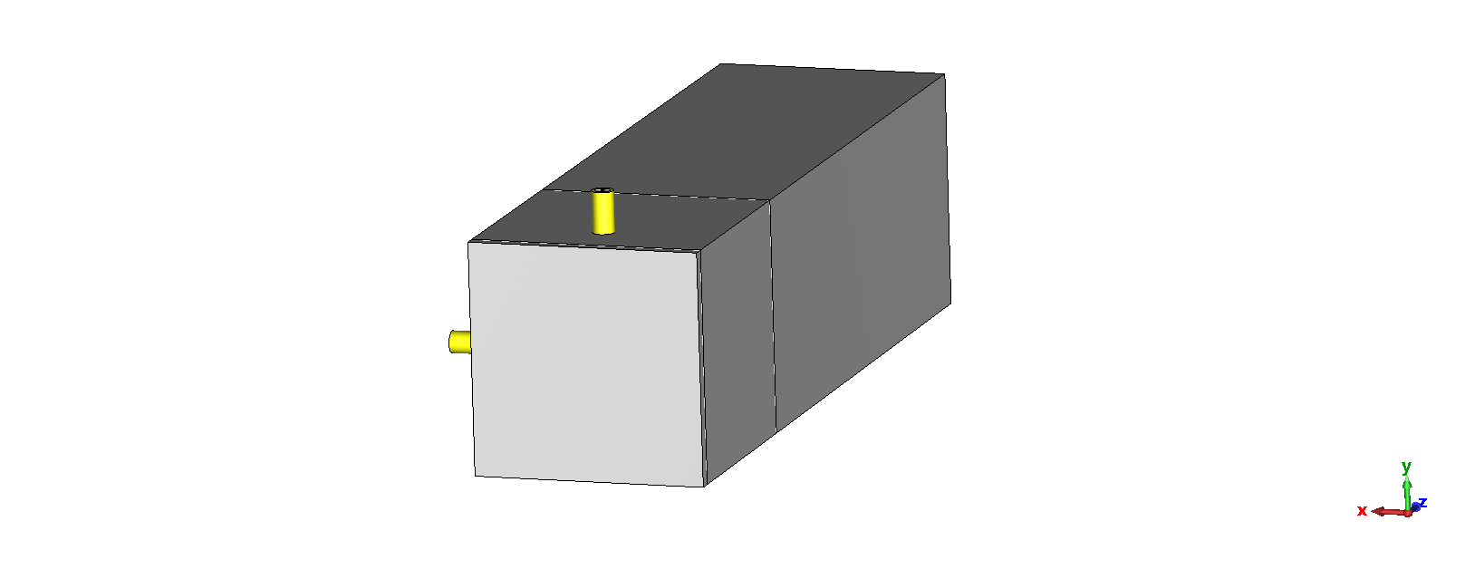
outputs/polarizer/stage3-coaxial_feeds/3d.png
