simakma5/diploma-thesis/outputs/polarizer/stage3-coaxial_feeds/mode1-prototype.gif

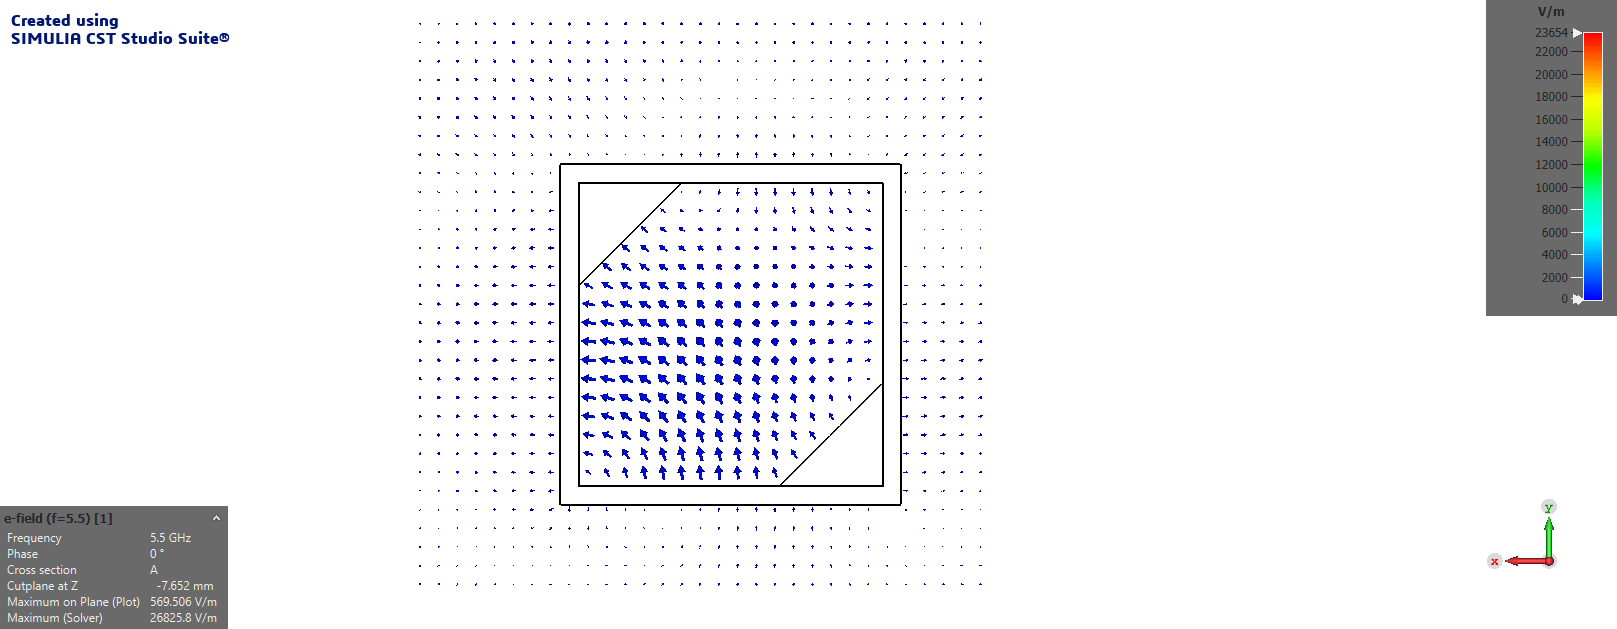
outputs/polarizer/stage3-coaxial_feeds/mode1-prototype.gif
