simakma5/diploma-thesis/outputs/polarizer/stage3-polarizer_outlet/no_outlet_mode1-axial_ratio.png

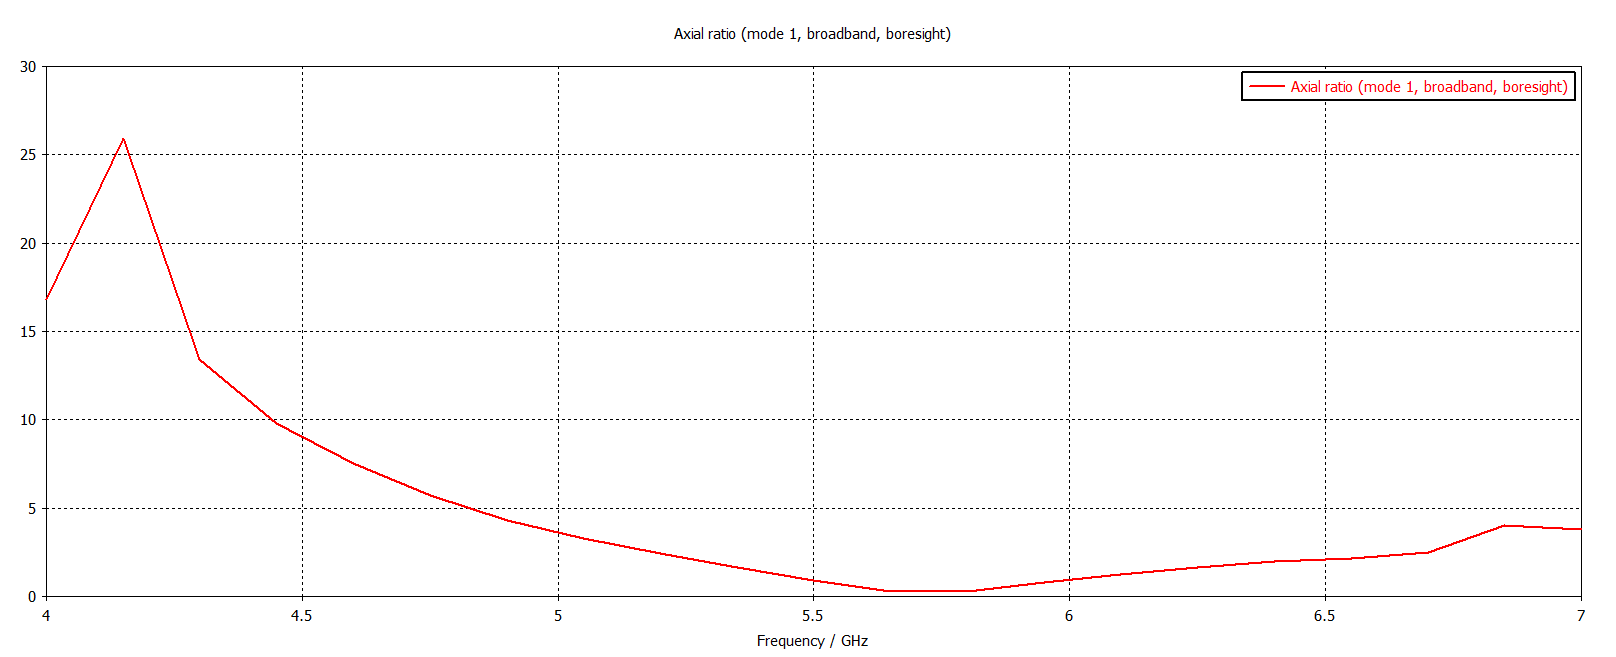
outputs/polarizer/stage3-polarizer_outlet/no_outlet_mode1-axial_ratio.png
