simakma5/diploma-thesis/outputs/[Measurement]Dual_circularly_polarized_antenna.pptx

## Dual Circularly Polarized Antenna Measurement report

By Jethro Wang / Dave Zhang
2025/01/02

## Content

- Compliance Matrix
- Antenna Photo
- Measurement Setup
- Return loss & Isolation
- Gain & Axial ratio

## Compliance Matrix

Item | Specification | Measurement #001 | Measurement #002 | Comply
Return loss | < -10 dB | < -11.17 dB | < -10.09 dB | Yes
Isolation | > 10 dB | > 10.29 dB | > 11.09 dB | Yes
Gain | > 15 dBi | > 17.28 dBi | > 17.31 dBi | Yes
Axial ration | 3 ~ 5 dB | < 4.51 dB | < 4.63 dB | Yes

## Antenna Photo

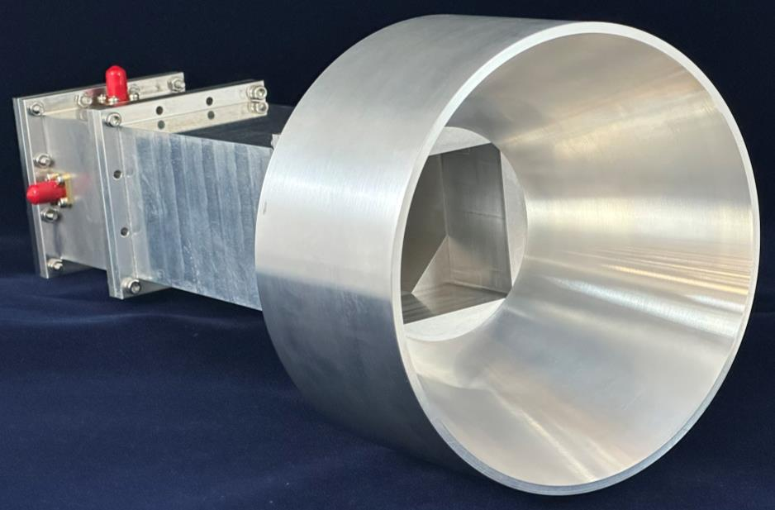
[picture p143: figure]

Port 2

Port 1

## Measurement Setup

Return loss & Isolation

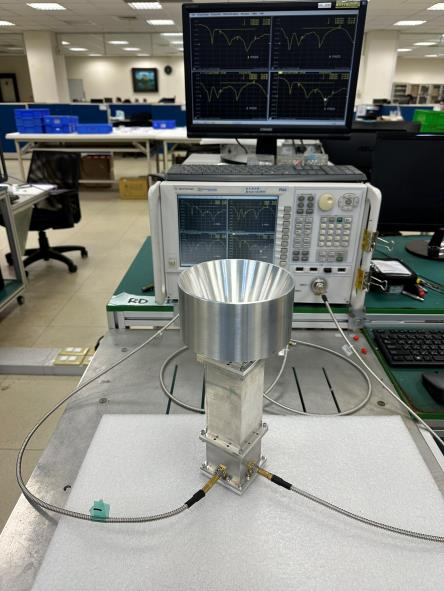
[picture p144: figure]

Gain & Axial ratio

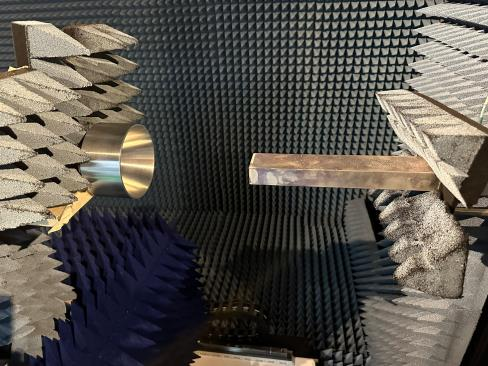
[picture p145: figure]
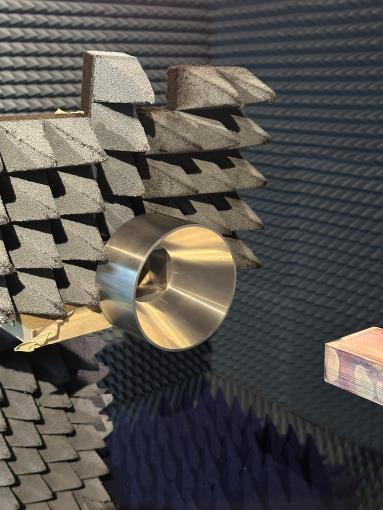
[picture p146: figure]

## Return loss & Isolation – #001

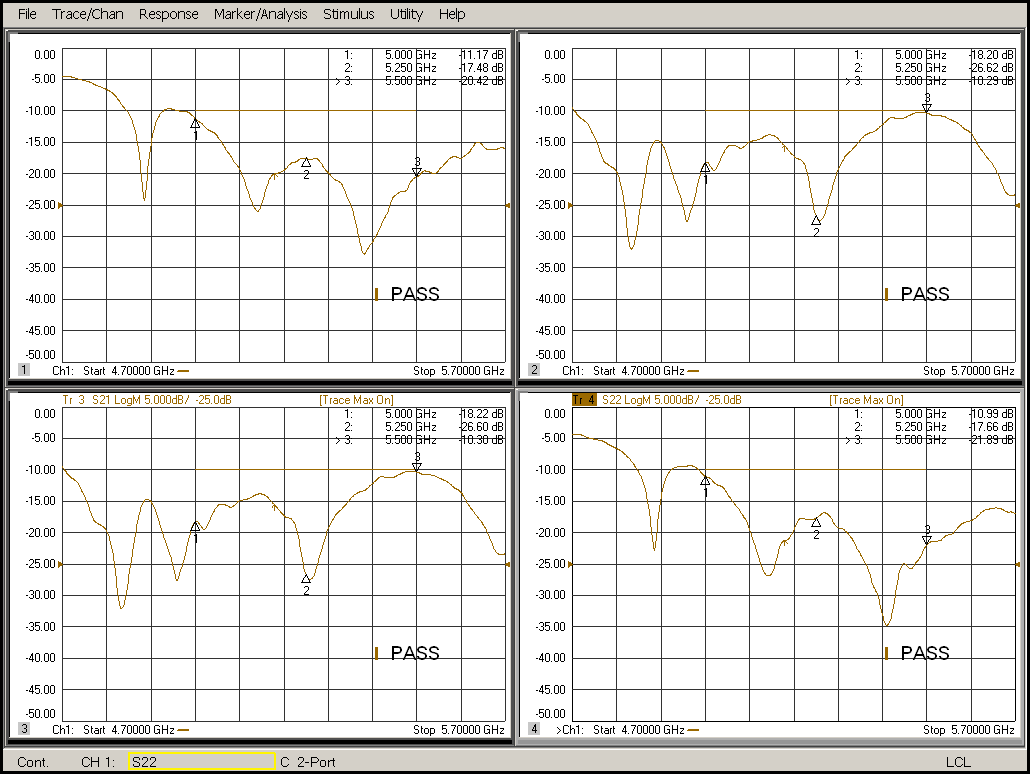
[picture p147: figure]

## Gain & Axial ratio – #001

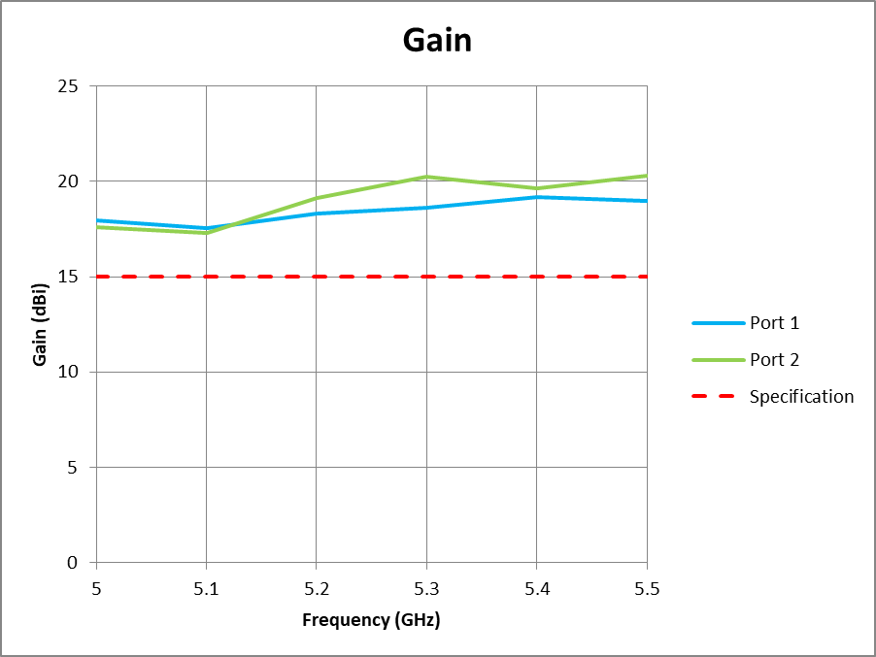
[picture p148: figure]
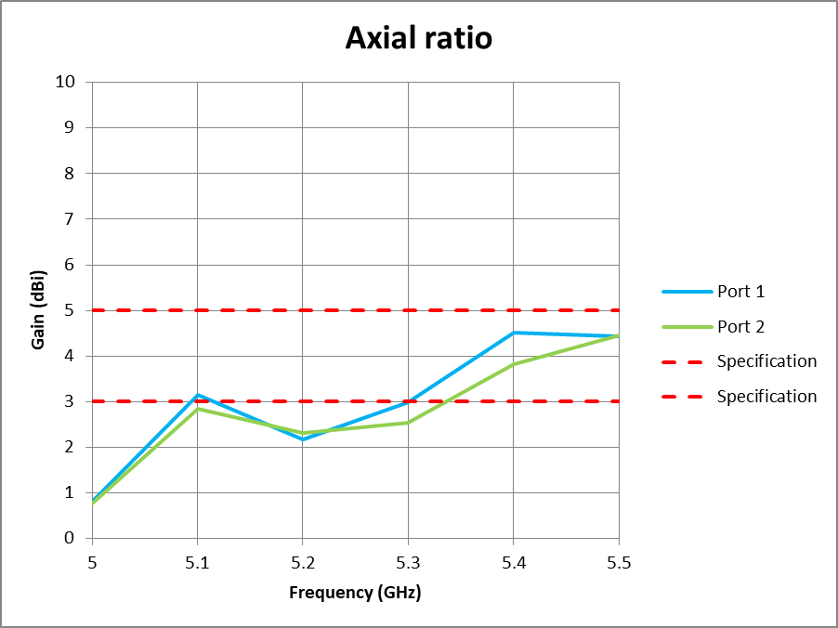
[picture p149: figure]

## Return loss & Isolation – #002

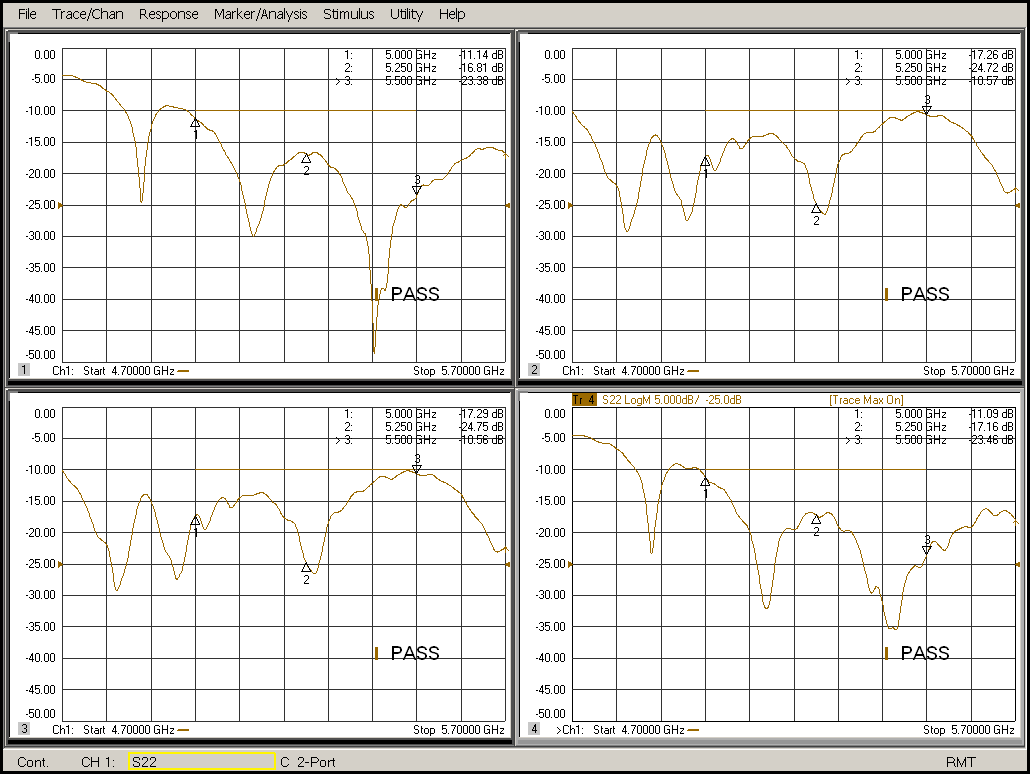
[picture p150: figure]

## Gain & Axial ratio – #002

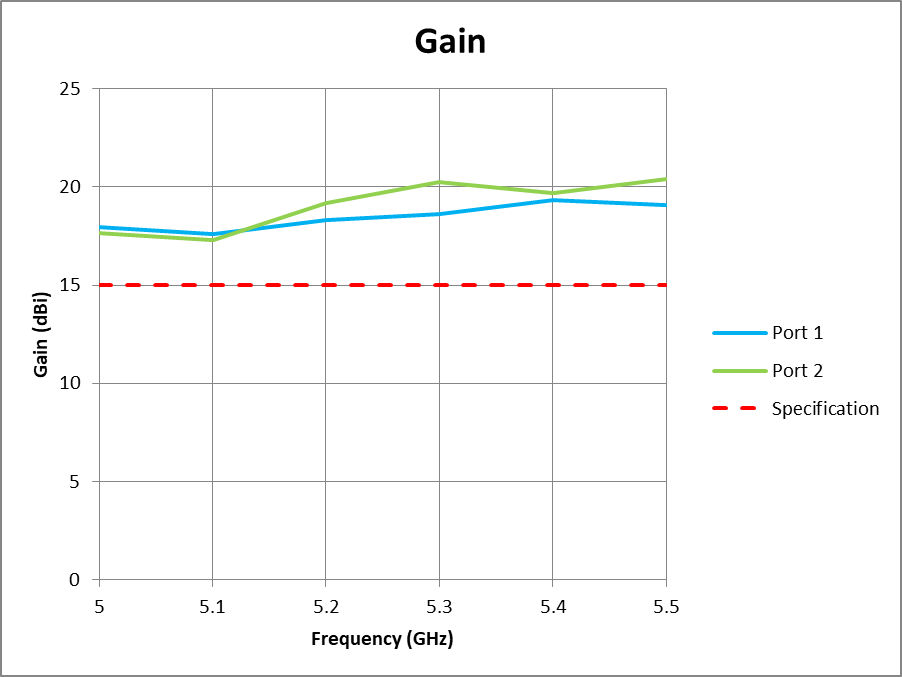
[picture p151: figure]
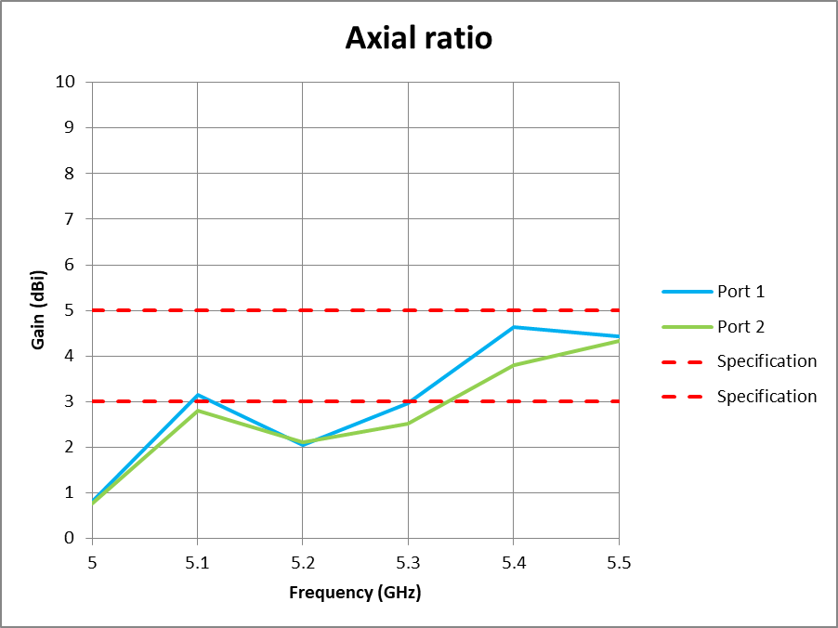
[picture p152: figure]

## Gain & Axial ratio Table

Antenna #001
Item | 5.0 GHz | 5.1 GHz | 5.2 GHz | 5.3 GHz | 5.4 GHz | 5.5 GHz
Gain – Port 1 | 17.94 | 17.55 | 18.33 | 18.60 | 19.20 | 18.97
Gain – Port 2 | 17.61 | 17.28 | 19.14 | 20.23 | 19.64 | 20.28
Axial ratio – Port 1 | 0.81 | 3.14 | 2.17 | 2.99 | 4.51 | 4.43
Axial ratio – Port 2 | 0.76 | 2.85 | 2.31 | 2.55 | 3.83 | 4.45

Antenna #002
Item | 5.0 GHz | 5.1 GHz | 5.2 GHz | 5.3 GHz | 5.4 GHz | 5.5 GHz
Gain – Port 1 | 17.96 | 17.59 | 18.29 | 18.64 | 19.31 | 19.09
Gain – Port 2 | 17.63 | 17.31 | 19.17 | 20.26 | 19.69 | 20.40
Axial ratio – Port 1 | 0.82 | 3.15 | 2.06 | 2.98 | 4.63 | 4.43
Axial ratio – Port 2 | 0.77 | 2.80 | 2.12 | 2.52 | 3.80 | 4.34

## Radiation pattern @ 5 GHz #001 – Port 1

- Azimuth

- Elevation

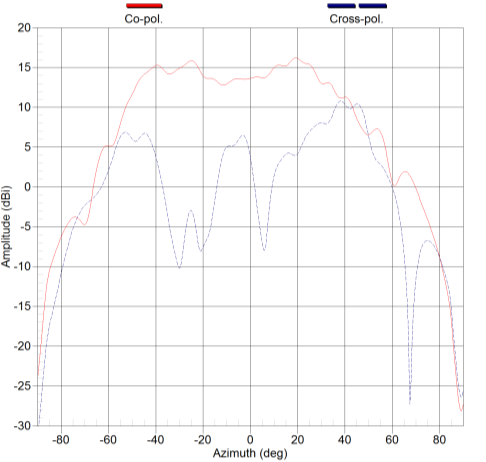
[picture p153: figure]
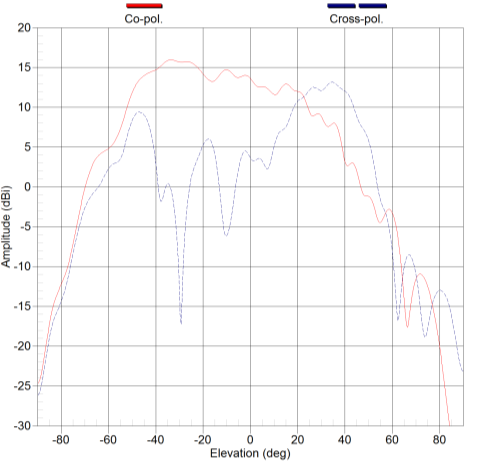
[picture p154: figure]

## Radiation pattern @ 5.3 GHz #001 – Port 1

- Azimuth

- Elevation

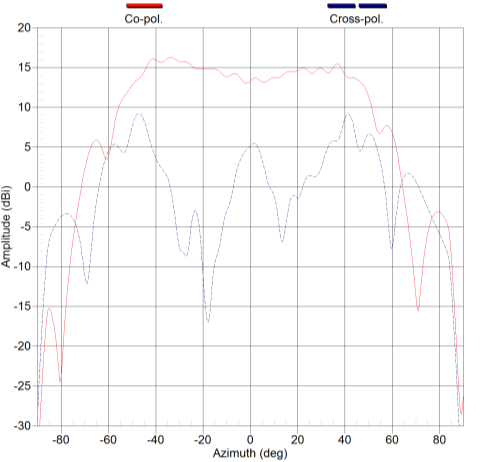
[picture p155: figure]
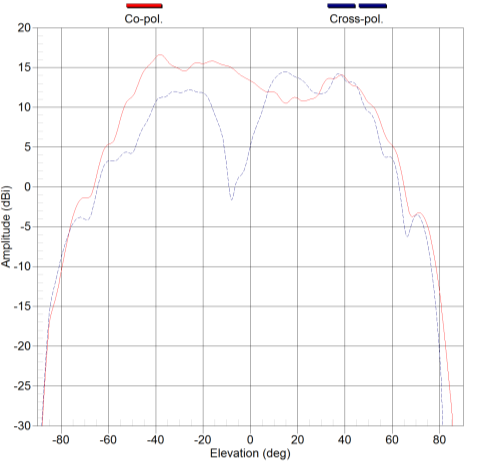
[picture p156: figure]

## Radiation pattern @ 5.5 GHz #001 – Port 1

- Azimuth

- Elevation

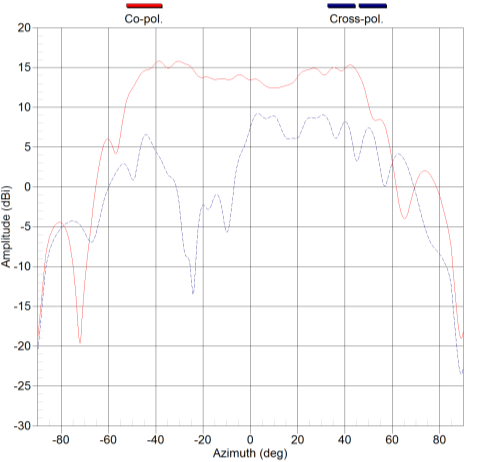
[picture p157: figure]
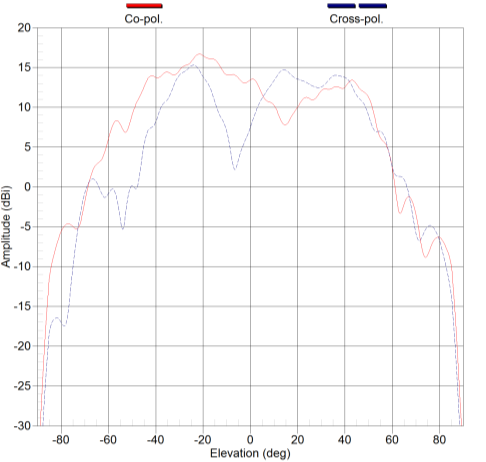
[picture p158: figure]

## Radiation pattern @ 5 GHz #001 – Port 2

- Azimuth

- Elevation

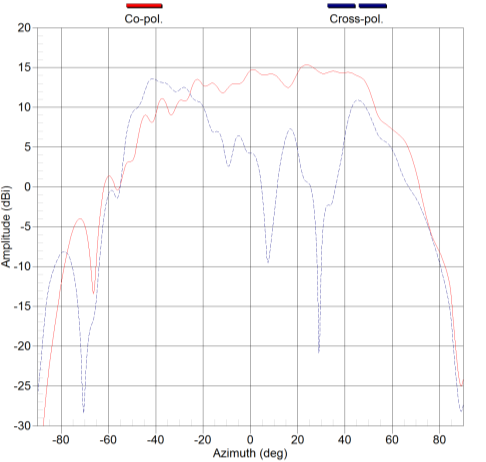
[picture p159: figure]
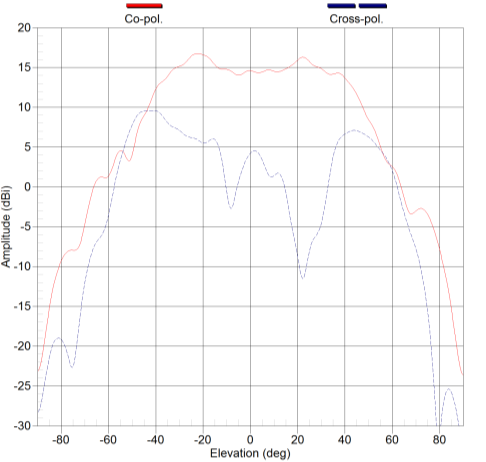
[picture p160: figure]

## Radiation pattern @ 5.3 GHz #001 – Port 2

- Azimuth

- Elevation

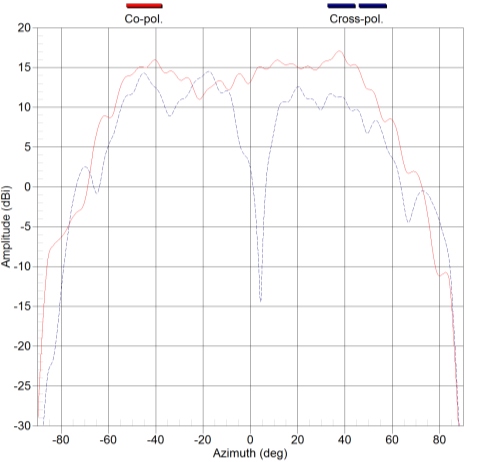
[picture p161: figure]
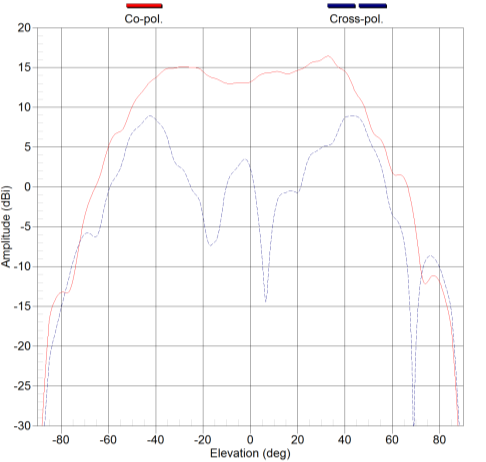
[picture p162: figure]

## Radiation pattern @ 5.5 GHz #001 – Port 2

- Azimuth

- Elevation

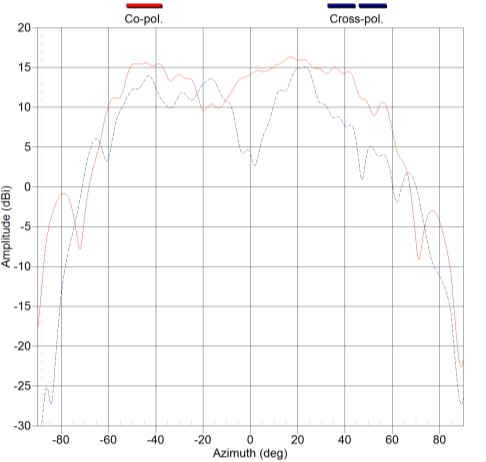
[picture p163: figure]
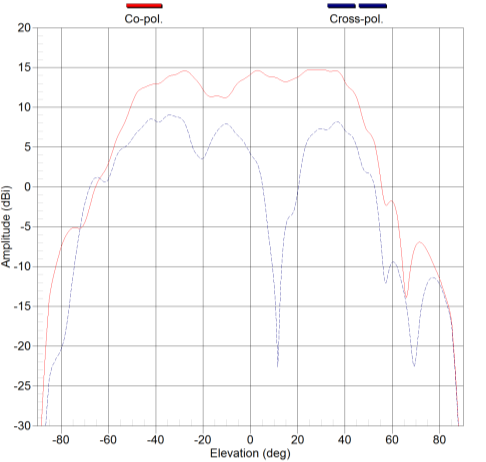
[picture p164: figure]

## Radiation pattern @ 5 GHz #002 – Port 1

- Azimuth

- Elevation

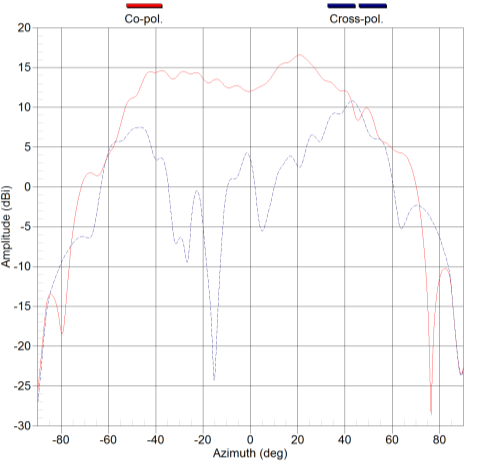
[picture p165: figure]
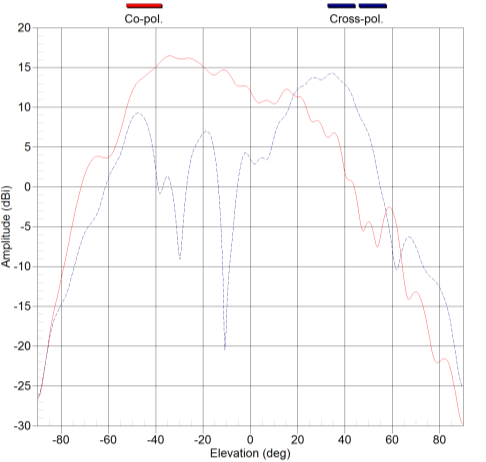
[picture p166: figure]

## Radiation pattern @ 5.3 GHz #002 – Port 1

- Azimuth

- Elevation

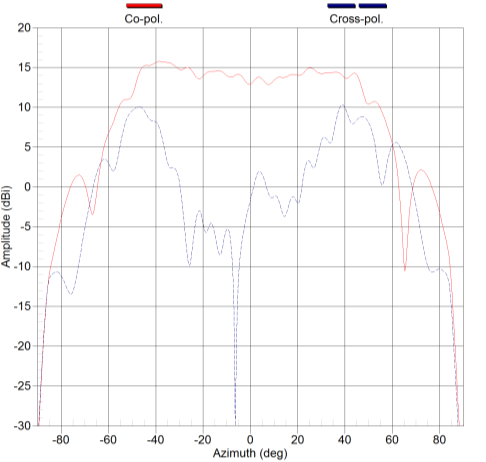
[picture p167: figure]
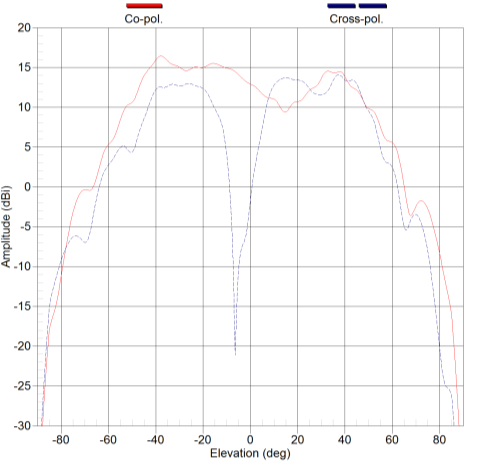
[picture p168: figure]

## Radiation pattern @ 5.5 GHz #002 – Port 1

- Azimuth

- Elevation

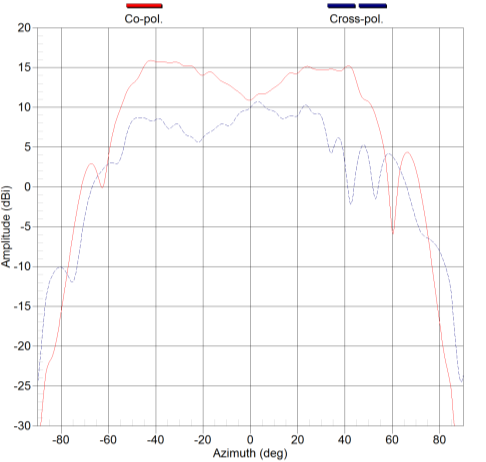
[picture p169: figure]
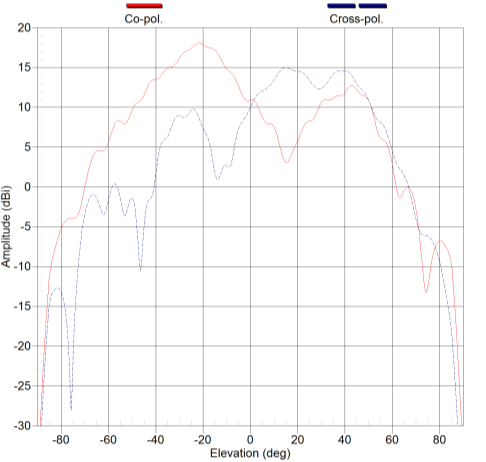
[picture p170: figure]

## Radiation pattern @ 5 GHz #002 – Port 2

- Azimuth

- Elevation

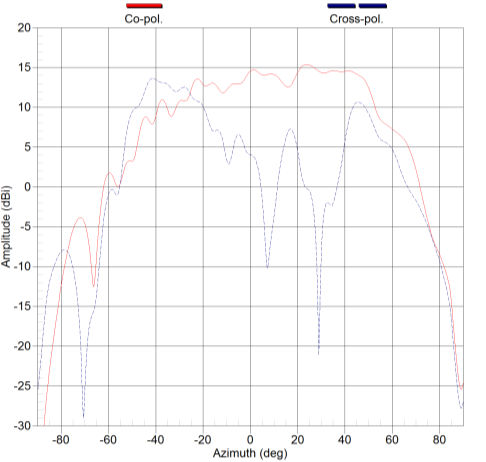
[picture p171: figure]
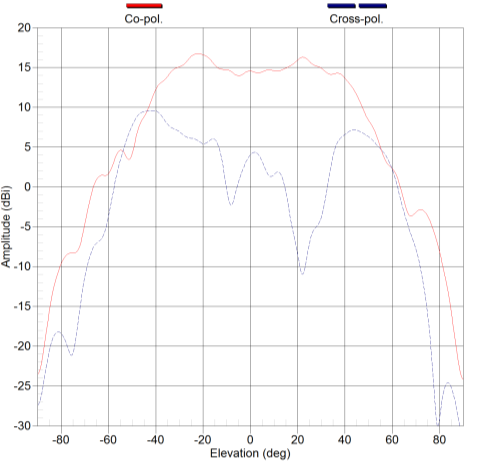
[picture p172: figure]

## Radiation pattern @ 5.3 GHz #002 – Port 2

- Azimuth

- Elevation

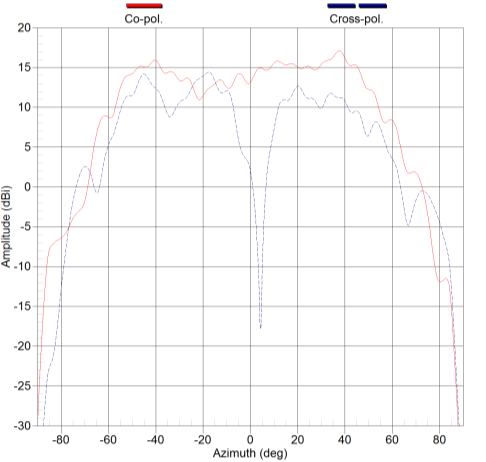
[picture p173: figure]
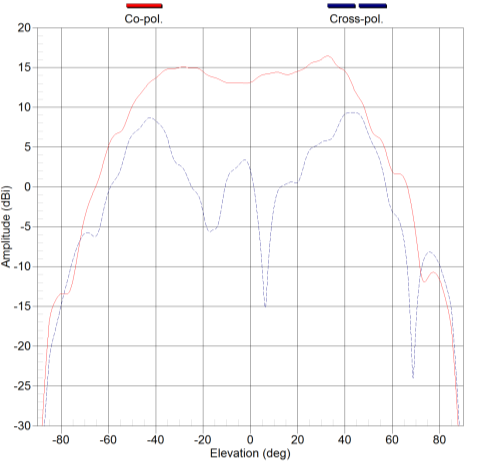
[picture p174: figure]

## Radiation pattern @ 5.5 GHz #002 – Port 2

- Azimuth

- Elevation

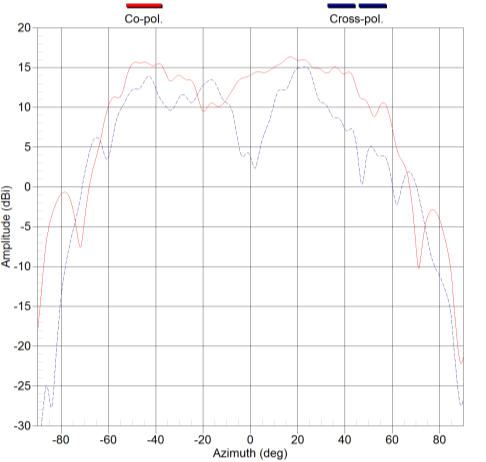
[picture p175: figure]
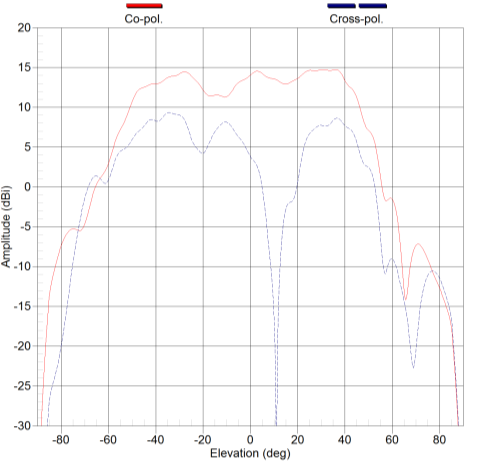
[picture p176: figure]

## Slide 23

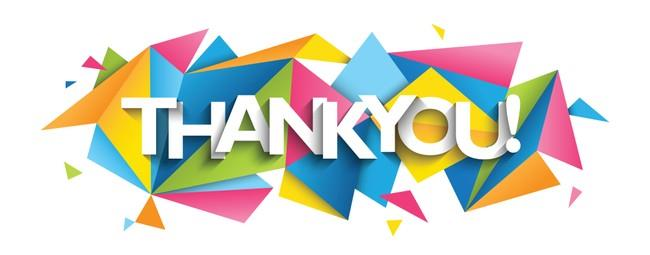
[picture p177: figure]
