simakma5/diploma-thesis/scripts/thesis-plots/university-measurement/antenna1_port1_azimuth.xls

Sheet: Info
Antenna OTA 2D Antenna Pattern
Infomation
Date | 2025-01-07
Start Time | 2025-01-07 20:14
Finish Time | 2025-01-07 20:22
Lab Name | OTA
Operator | Tester
Project Number | 20250107_martin
Manufacturer | test1_third
Model Name | test1_measure
Hardware Verson | 1
Software Verson | 3.8.2 Beta
Test Condition | Free Space
Tempurature | N/A
Humidity | N/A
Note | N/A
Test List
4.2GHz
4.3GHz
4.4GHz
4.5GHz
4.6GHz
4.7GHz
4.8GHz
4.9GHz
5GHz
5.1GHz
5.2GHz
5.3GHz
5.4GHz
5.5GHz
5.6GHz
5.7GHz
5.8GHz
5.9GHz
6GHz
6.1GHz
6.2GHz

Sheet: Overview
Frequency | 4.2GHz | 4.3GHz | 4.4GHz | 4.5GHz | 4.6GHz | 4.7GHz | 4.8GHz | 4.9GHz | 5GHz | 5.1GHz | 5.2GHz | 5.3GHz | 5.4GHz | 5.5GHz | 5.6GHz | 5.7GHz | 5.8GHz | 5.9GHz | 6GHz | 6.1GHz | 6.2GHz
Maximum H+V Gain (dBi) | 12.44 | 13.05 | 14.36 | 15.13 | 12.38 | 12.42 | 14.32 | 13.62 | 15.02 | 14.83 | 14.28 | 14.58 | 14.88 | 14.98 | 13.57 | 13.32 | 13.94 | 14.27 | 15.25 | 13.87 | 12.67
Maximum H+V @ Angle (deg.) | 182 | 182 | 182 | 180 | 182 | 182 | 180 | 194 | 188 | 188 | 190 | 188 | 184 | 178 | 172 | 170 | 174 | 176 | 172 | 170 | 170
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
