simakma5/diploma-thesis/scripts/thesis-plots/university-measurement/antenna1_port1_azimuth1.xls

Sheet: Info
Antenna OTA 2D Antenna Pattern
Infomation
Date | 2025-01-07
Start Time | 2025-01-07 19:44
Finish Time | 2025-01-07 19:52
Lab Name | OTA
Operator | Tester
Project Number | 20250107_martin
Manufacturer | test1
Model Name | test1_measure
Hardware Verson | 1
Software Verson | 3.8.2 Beta
Test Condition | Free Space
Tempurature | N/A
Humidity | N/A
Note | N/A
Test List
4.7GHz
4.8GHz
4.9GHz
5GHz
5.1GHz
5.2GHz
5.3GHz
5.4GHz
5.5GHz
5.6GHz
5.7GHz

Sheet: Overview
Frequency | 4.7GHz | 4.8GHz | 4.9GHz | 5GHz | 5.1GHz | 5.2GHz | 5.3GHz | 5.4GHz | 5.5GHz | 5.6GHz | 5.7GHz
Maximum H+V Gain (dBi) | 12.43 | 14.29 | 13.62 | 15.04 | 14.87 | 14.34 | 14.62 | 14.85 | 14.89 | 13.47 | 13.19
Maximum H+V @ Angle (deg.) | 182 | 180 | 192 | 188 | 188 | 190 | 188 | 184 | 178 | 172 | 170
Minimum H+V Gain (dBi) | -31.53 | -25.57 | -21.07 | -20.59 | -25.02 | -22.58 | -25.14 | -20.53 | -24.14 | -25.74 | -25.77
Minimum H+V @ Angle (deg.) | 32 | 18 | 22 | 28 | 26 | 342 | 344 | 344 | 304 | 340 | 342
Average H+V Gain (dBi) | 1.88 | 3.61 | 3.93 | 4.26 | 4.61 | 4.41 | 4.75 | 4.98 | 4.79 | 4.43 | 3.98
-3.0dBBW H+V (deg.) | 28.4 | 27 | 27.7 | 24.9 | 28.8 | 25.8 | 32.1 | 34.4 | 31.8 | 41.8 | 42.1
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
