simakma5/diploma-thesis/scripts/thesis-plots/university-measurement/antenna1_port1_azimuth2.xls

Sheet: Info
Antenna OTA 2D Antenna Pattern
Infomation
Date | 2025-01-07
Start Time | 2025-01-07 19:59
Finish Time | 2025-01-07 20:07
Lab Name | OTA
Operator | Tester
Project Number | 20250107_martin
Manufacturer | test1_second
Model Name | test1_measure
Hardware Verson | 1
Software Verson | 3.8.2 Beta
Test Condition | Free Space
Tempurature | N/A
Humidity | N/A
Note | N/A
Test List
4.2GHz
4.3GHz
4.4GHz
4.5GHz
4.6GHz
4.7GHz
4.8GHz
4.9GHz
5GHz
5.1GHz
5.2GHz
5.3GHz
5.4GHz
5.5GHz
5.6GHz
5.7GHz
5.8GHz
5.9GHz
6GHz
6.1GHz
6.2GHz

Sheet: Overview
Frequency | 4.2GHz | 4.3GHz | 4.4GHz | 4.5GHz | 4.6GHz | 4.7GHz | 4.8GHz | 4.9GHz | 5GHz | 5.1GHz | 5.2GHz | 5.3GHz | 5.4GHz | 5.5GHz | 5.6GHz | 5.7GHz | 5.8GHz | 5.9GHz | 6GHz | 6.1GHz | 6.2GHz
Maximum H+V Gain (dBi) | 12.6 | 13.22 | 14.21 | 14.31 | 13.44 | 12.12 | 14.3 | 13.69 | 15.03 | 15.07 | 14.44 | 14.38 | 14.9 | 13.76 | 13.21 | 13.62 | 13.7 | 13.06 | 14.24 | 13.91 | 12.94
Maximum H+V @ Angle (deg.) | 180 | 182 | 180 | 178 | 178 | 182 | 180 | 192 | 188 | 188 | 190 | 188 | 186 | 186 | 184 | 168 | 172 | 174 | 174 | 170 | 168
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
