simakma5/diploma-thesis/scripts/thesis-plots/university-measurement/antenna1_port1_elevation.xls

Sheet: Info
Antenna OTA 2D Antenna Pattern
Infomation
Date | 2025-01-07
Start Time | 2025-01-07 20:54
Finish Time | 2025-01-07 21:02
Lab Name | OTA
Operator | Tester
Project Number | 20250107_martin
Manufacturer | test1_elevation
Model Name | test1_elevation_measure
Hardware Verson | 1
Software Verson | 3.8.2 Beta
Test Condition | Free Space
Tempurature | N/A
Humidity | N/A
Note | N/A
Test List
4.2GHz
4.3GHz
4.4GHz
4.5GHz
4.6GHz
4.7GHz
4.8GHz
4.9GHz
5GHz
5.1GHz
5.2GHz
5.3GHz
5.4GHz
5.5GHz
5.6GHz
5.7GHz
5.8GHz
5.9GHz
6GHz
6.1GHz
6.2GHz

Sheet: Overview
Frequency | 4.2GHz | 4.3GHz | 4.4GHz | 4.5GHz | 4.6GHz | 4.7GHz | 4.8GHz | 4.9GHz | 5GHz | 5.1GHz | 5.2GHz | 5.3GHz | 5.4GHz | 5.5GHz | 5.6GHz | 5.7GHz | 5.8GHz | 5.9GHz | 6GHz | 6.1GHz | 6.2GHz
Maximum H+V Gain (dBi) | 12.57 | 13.03 | 14.4 | 15.2 | 12.29 | 12.62 | 14.62 | 10.97 | 13.63 | 13.62 | 12.56 | 13.43 | 14.78 | 15.04 | 13.53 | 12.57 | 13.81 | 14.17 | 14.9 | 15.38 | 15
Maximum H+V @ Angle (deg.) | 182 | 182 | 182 | 182 | 182 | 184 | 184 | 180 | 182 | 184 | 186 | 184 | 186 | 186 | 184 | 180 | 180 | 182 | 174 | 172 | 172
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
