simakma5/diploma-thesis/scripts/thesis-plots/university-measurement/antenna1_port2_azimuth.xls

Sheet: Info
Antenna OTA 2D Antenna Pattern
Infomation
Date | 2025-01-07
Start Time | 2025-01-07 21:12
Finish Time | 2025-01-07 21:20
Lab Name | OTA
Operator | Tester
Project Number | 20250107_martin
Manufacturer | test2_azimuth
Model Name | test2_azimuth_measure
Hardware Verson | 1
Software Verson | 3.8.2 Beta
Test Condition | Free Space
Tempurature | N/A
Humidity | N/A
Note | N/A
Test List
4.2GHz
4.3GHz
4.4GHz
4.5GHz
4.6GHz
4.7GHz
4.8GHz
4.9GHz
5GHz
5.1GHz
5.2GHz
5.3GHz
5.4GHz
5.5GHz
5.6GHz
5.7GHz
5.8GHz
5.9GHz
6GHz
6.1GHz
6.2GHz

Sheet: Overview
Frequency | 4.2GHz | 4.3GHz | 4.4GHz | 4.5GHz | 4.6GHz | 4.7GHz | 4.8GHz | 4.9GHz | 5GHz | 5.1GHz | 5.2GHz | 5.3GHz | 5.4GHz | 5.5GHz | 5.6GHz | 5.7GHz | 5.8GHz | 5.9GHz | 6GHz | 6.1GHz | 6.2GHz
Maximum H+V Gain (dBi) | 12.69 | 13.21 | 14.49 | 15.05 | 12.26 | 12.38 | 14.5 | 11.37 | 14.38 | 14.13 | 13.11 | 13.79 | 14.85 | 14.79 | 13.47 | 12.2 | 13.1 | 13.42 | 13.94 | 14.73 | 14.74
Maximum H+V @ Angle (deg.) | 180 | 180 | 180 | 182 | 180 | 182 | 182 | 178 | 180 | 182 | 184 | 182 | 184 | 184 | 182 | 178 | 178 | 180 | 172 | 170 | 170
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
