simakma5/diploma-thesis/scripts/thesis-plots/university-measurement/antenna1_port2_elevation.xls

Sheet: Info
Antenna OTA 2D Antenna Pattern
Infomation
Date | 2025-01-07
Start Time | 2025-01-07 20:38
Finish Time | 2025-01-07 20:46
Lab Name | OTA
Operator | Tester
Project Number | 20250107_martin
Manufacturer | test2_elevation
Model Name | test2_elevation_measure
Hardware Verson | 1
Software Verson | 3.8.2 Beta
Test Condition | Free Space
Tempurature | N/A
Humidity | N/A
Note | N/A
Test List
4.2GHz
4.3GHz
4.4GHz
4.5GHz
4.6GHz
4.7GHz
4.8GHz
4.9GHz
5GHz
5.1GHz
5.2GHz
5.3GHz
5.4GHz
5.5GHz
5.6GHz
5.7GHz
5.8GHz
5.9GHz
6GHz
6.1GHz
6.2GHz

Sheet: Overview
Frequency | 4.2GHz | 4.3GHz | 4.4GHz | 4.5GHz | 4.6GHz | 4.7GHz | 4.8GHz | 4.9GHz | 5GHz | 5.1GHz | 5.2GHz | 5.3GHz | 5.4GHz | 5.5GHz | 5.6GHz | 5.7GHz | 5.8GHz | 5.9GHz | 6GHz | 6.1GHz | 6.2GHz
Maximum H+V Gain (dBi) | 12.52 | 13.25 | 14.49 | 15.17 | 12.24 | 12.37 | 14.19 | 13.74 | 15.19 | 14.94 | 14.28 | 14.48 | 14.44 | 14.4 | 13.35 | 13.17 | 13.94 | 14.24 | 15.56 | 14.45 | 13.18
Maximum H+V @ Angle (deg.) | 182 | 182 | 182 | 180 | 182 | 184 | 182 | 194 | 188 | 190 | 192 | 190 | 186 | 180 | 186 | 172 | 176 | 178 | 174 | 172 | 174
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
