simakma5/diploma-thesis/scripts/thesis-plots/university-measurement/antenna2_port1_azimuth.xls

Sheet: Info
Antenna OTA 2D Antenna Pattern
Infomation
Date | 2025-01-07
Start Time | 2025-01-07 21:31
Finish Time | 2025-01-07 21:40
Lab Name | OTA
Operator | Tester
Project Number | 20250107_martin
Manufacturer | A2_port1_azimuth
Model Name | A2_port1_azimuth_measure
Hardware Verson | 1
Software Verson | 3.8.2 Beta
Test Condition | Free Space
Tempurature | N/A
Humidity | N/A
Note | N/A
Test List
4.2GHz
4.3GHz
4.4GHz
4.5GHz
4.6GHz
4.7GHz
4.8GHz
4.9GHz
5GHz
5.1GHz
5.2GHz
5.3GHz
5.4GHz
5.5GHz
5.6GHz
5.7GHz
5.8GHz
5.9GHz
6GHz
6.1GHz
6.2GHz

Sheet: Overview
Frequency | 4.2GHz | 4.3GHz | 4.4GHz | 4.5GHz | 4.6GHz | 4.7GHz | 4.8GHz | 4.9GHz | 5GHz | 5.1GHz | 5.2GHz | 5.3GHz | 5.4GHz | 5.5GHz | 5.6GHz | 5.7GHz | 5.8GHz | 5.9GHz | 6GHz | 6.1GHz | 6.2GHz
Maximum H+V Gain (dBi) | 12.49 | 13.29 | 14.48 | 15.21 | 12.6 | 12.42 | 14.47 | 13.13 | 14.94 | 14.88 | 14.3 | 14.67 | 15.15 | 15.15 | 13.78 | 13.48 | 13.95 | 14.35 | 15.25 | 13.94 | 12.74
Maximum H+V @ Angle (deg.) | 182 | 182 | 182 | 180 | 182 | 182 | 182 | 194 | 188 | 188 | 192 | 190 | 186 | 180 | 174 | 170 | 174 | 176 | 172 | 170 | 170
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
