simakma5/diploma-thesis/scripts/thesis-plots/university-measurement/antenna2_port1_elevation.xls

Sheet: Info
Antenna OTA 2D Antenna Pattern
Infomation
Date | 2025-01-07
Start Time | 2025-01-07 22:12
Finish Time | 2025-01-07 22:20
Lab Name | OTA
Operator | Tester
Project Number | 20250107_martin
Manufacturer | A2_port1_elevation
Model Name | A2_port1_elevation_measure
Hardware Verson | 1
Software Verson | 3.8.2 Beta
Test Condition | Free Space
Tempurature | N/A
Humidity | N/A
Note | N/A
Test List
4.2GHz
4.3GHz
4.4GHz
4.5GHz
4.6GHz
4.7GHz
4.8GHz
4.9GHz
5GHz
5.1GHz
5.2GHz
5.3GHz
5.4GHz
5.5GHz
5.6GHz
5.7GHz
5.8GHz
5.9GHz
6GHz
6.1GHz
6.2GHz

Sheet: Overview
Frequency | 4.2GHz | 4.3GHz | 4.4GHz | 4.5GHz | 4.6GHz | 4.7GHz | 4.8GHz | 4.9GHz | 5GHz | 5.1GHz | 5.2GHz | 5.3GHz | 5.4GHz | 5.5GHz | 5.6GHz | 5.7GHz | 5.8GHz | 5.9GHz | 6GHz | 6.1GHz | 6.2GHz
Maximum H+V Gain (dBi) | 12.63 | 13.21 | 14.46 | 15.22 | 12.4 | 12.48 | 14.61 | 11.47 | 13.57 | 13.66 | 12.51 | 13.33 | 14.75 | 15.03 | 13.64 | 12.54 | 13.7 | 14.13 | 14.89 | 15.28 | 14.97
Maximum H+V @ Angle (deg.) | 182 | 182 | 182 | 182 | 182 | 184 | 184 | 178 | 180 | 182 | 186 | 182 | 186 | 186 | 182 | 178 | 180 | 182 | 172 | 170 | 170
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
