simakma5/diploma-thesis/scripts/thesis-plots/university-measurement/antenna2_port2_azimuth.xls

Sheet: Info
Antenna OTA 2D Antenna Pattern
Infomation
Date | 2025-01-07
Start Time | 2025-01-07 21:45
Finish Time | 2025-01-07 21:53
Lab Name | OTA
Operator | Tester
Project Number | 20250107_martin
Manufacturer | A2_port2_azimuth
Model Name | A2_port2_azimuth_measure
Hardware Verson | 1
Software Verson | 3.8.2 Beta
Test Condition | Free Space
Tempurature | N/A
Humidity | N/A
Note | N/A
Test List
4.2GHz
4.3GHz
4.4GHz
4.5GHz
4.6GHz
4.7GHz
4.8GHz
4.9GHz
5GHz
5.1GHz
5.2GHz
5.3GHz
5.4GHz
5.5GHz
5.6GHz
5.7GHz
5.8GHz
5.9GHz
6GHz
6.1GHz
6.2GHz

Sheet: Overview
Frequency | 4.2GHz | 4.3GHz | 4.4GHz | 4.5GHz | 4.6GHz | 4.7GHz | 4.8GHz | 4.9GHz | 5GHz | 5.1GHz | 5.2GHz | 5.3GHz | 5.4GHz | 5.5GHz | 5.6GHz | 5.7GHz | 5.8GHz | 5.9GHz | 6GHz | 6.1GHz | 6.2GHz
Maximum H+V Gain (dBi) | 12.71 | 13.23 | 14.57 | 15.08 | 12.56 | 12.5 | 14.54 | 11.92 | 14.66 | 14.45 | 13.42 | 14.11 | 15.05 | 14.78 | 13.52 | 12.35 | 13.11 | 13.27 | 13.55 | 14.42 | 14.7
Maximum H+V @ Angle (deg.) | 182 | 182 | 182 | 182 | 182 | 184 | 184 | 178 | 180 | 182 | 184 | 182 | 186 | 186 | 182 | 180 | 178 | 180 | 174 | 170 | 170
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
