simakma5/diploma-thesis/scripts/thesis-plots/university-measurement/antenna2_port2_elevation.xls

Sheet: Info
Antenna OTA 2D Antenna Pattern
Infomation
Date | 2025-01-07
Start Time | 2025-01-07 22:00
Finish Time | 2025-01-07 22:08
Lab Name | OTA
Operator | Tester
Project Number | 20250107_martin
Manufacturer | A2_port2_elevation
Model Name | A2_port2_elevation_measure
Hardware Verson | 1
Software Verson | 3.8.2 Beta
Test Condition | Free Space
Tempurature | N/A
Humidity | N/A
Note | N/A
Test List
4.2GHz
4.3GHz
4.4GHz
4.5GHz
4.6GHz
4.7GHz
4.8GHz
4.9GHz
5GHz
5.1GHz
5.2GHz
5.3GHz
5.4GHz
5.5GHz
5.6GHz
5.7GHz
5.8GHz
5.9GHz
6GHz
6.1GHz
6.2GHz

Sheet: Overview
Frequency | 4.2GHz | 4.3GHz | 4.4GHz | 4.5GHz | 4.6GHz | 4.7GHz | 4.8GHz | 4.9GHz | 5GHz | 5.1GHz | 5.2GHz | 5.3GHz | 5.4GHz | 5.5GHz | 5.6GHz | 5.7GHz | 5.8GHz | 5.9GHz | 6GHz | 6.1GHz | 6.2GHz
Maximum H+V Gain (dBi) | 12.57 | 13.28 | 14.5 | 15.15 | 12.39 | 12.44 | 14.16 | 13.58 | 15.2 | 14.98 | 14.31 | 14.48 | 14.43 | 14.4 | 13.36 | 13.29 | 14.02 | 14.3 | 15.65 | 14.63 | 13.34
Maximum H+V @ Angle (deg.) | 180 | 180 | 180 | 178 | 180 | 182 | 180 | 192 | 188 | 188 | 190 | 188 | 186 | 178 | 184 | 170 | 174 | 176 | 172 | 170 | 172
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
