simakma5/diploma-thesis/latex/src/coverpage.pdf

## 國立台灣科技大學

## 電子 工程 系

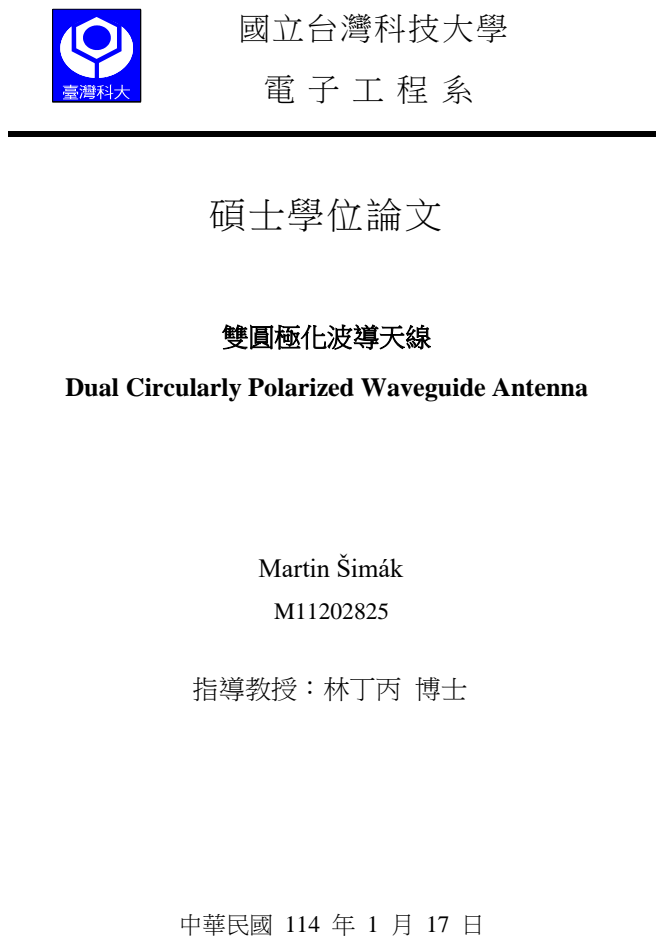
[picture p178: page 1]
碩士學位論文; 雙圓極化波導天線; Martin Šimák; 中華民國 114 年 1 月 17 日

Dual Circularly Polarized Waveguide Antenna

指導教授：林丁丙 博士
