simakma5/diploma-thesis/journal/src/dual_feed_sparameters-eps-converted-to.pdf

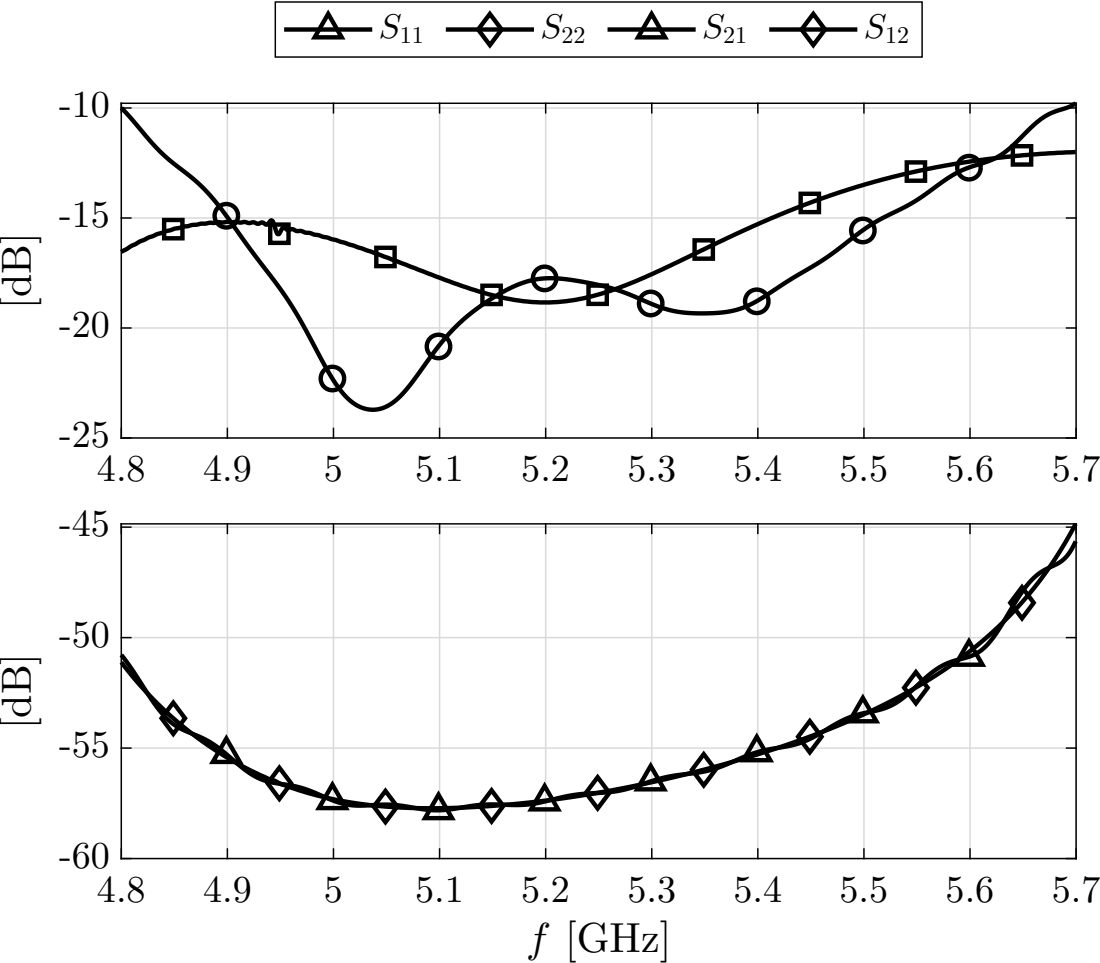
[picture p179: page 1]
f [GHz]
