simakma5/diploma-thesis/journal/src/final_radiation_pattern_azimuth-eps-converted-to.pdf

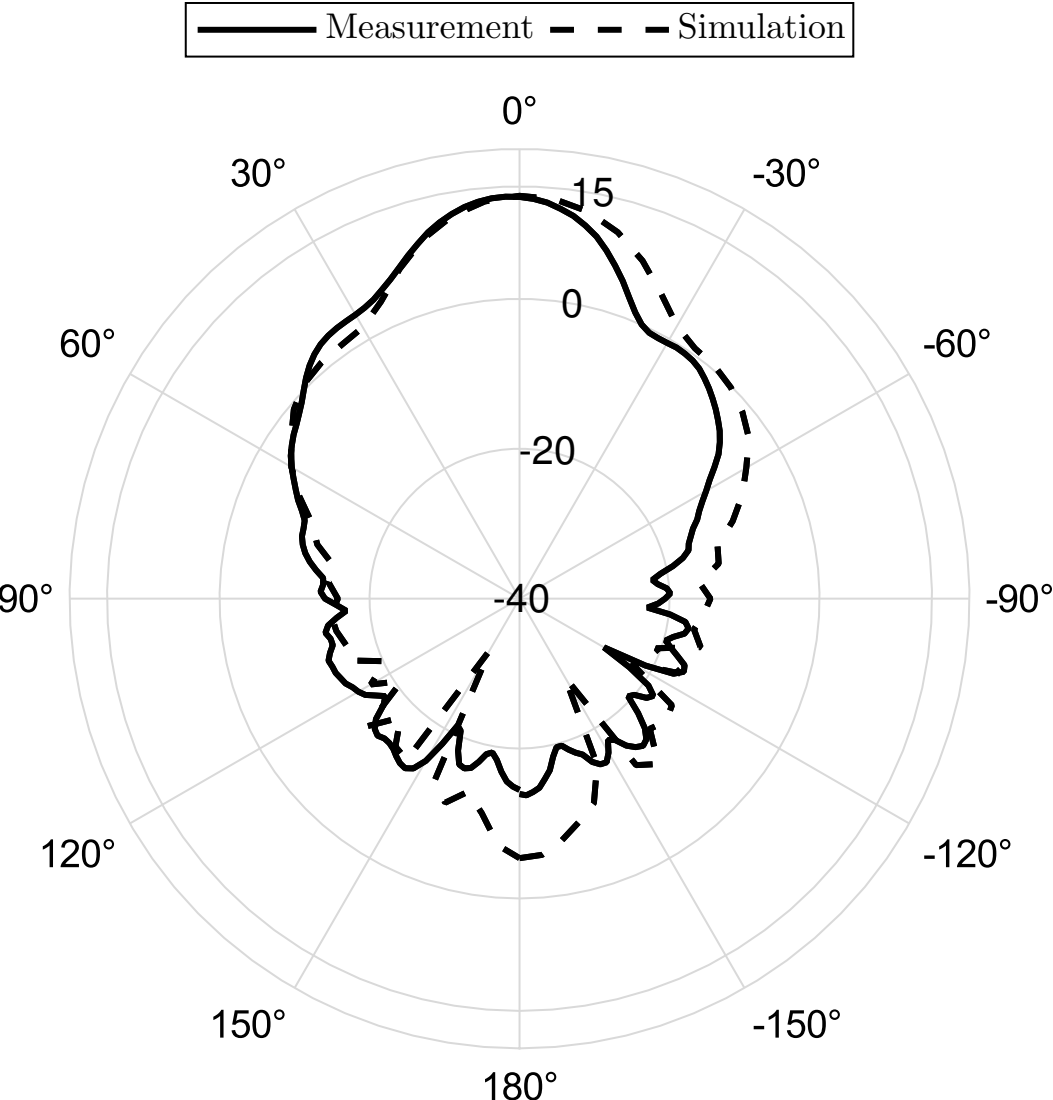
[picture p180: page 1]
Measurement; Simulation
