simakma5/diploma-thesis/journal/src/final_radiation_pattern_elevation-eps-converted-to.pdf

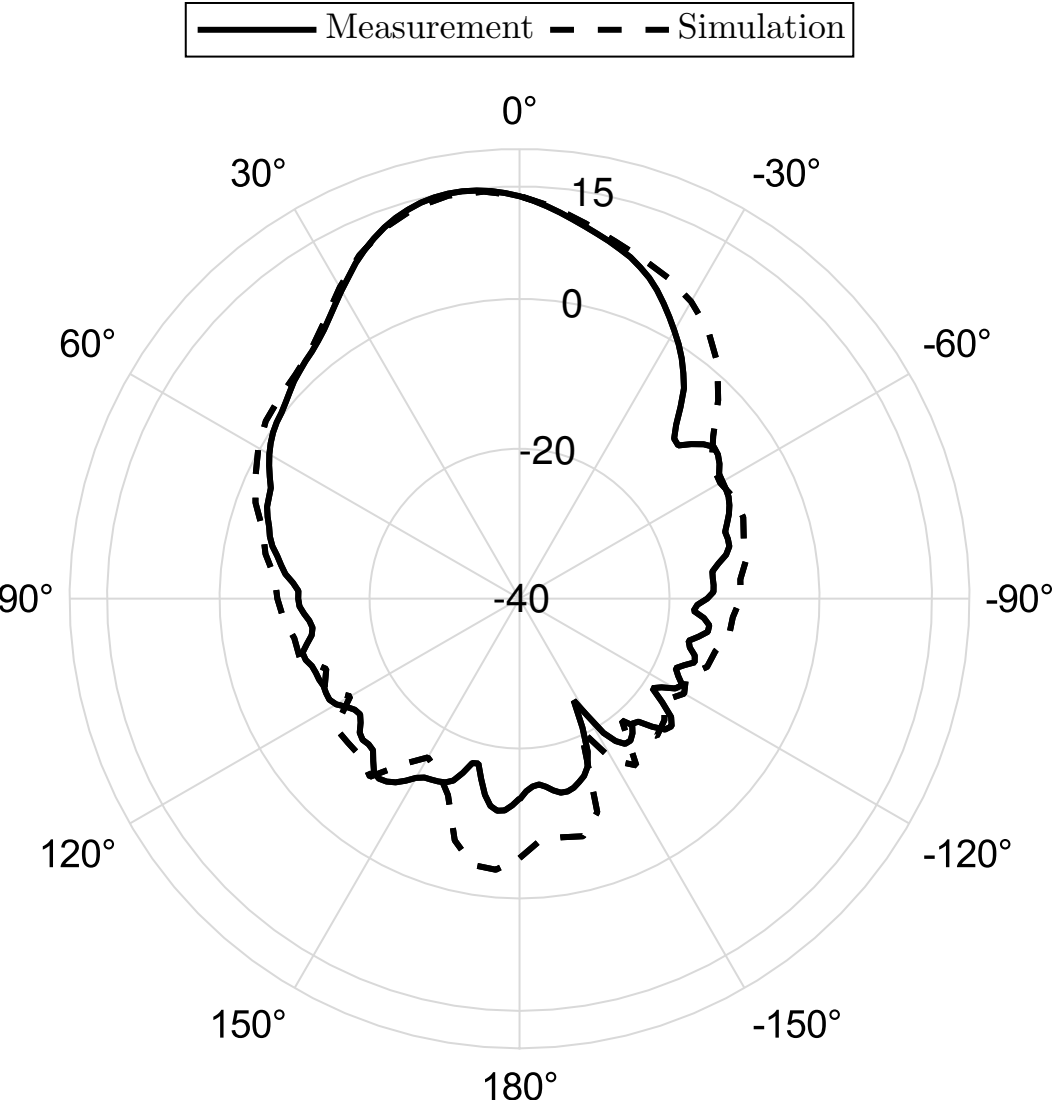
[picture p181: page 1]
Measurement; Simulation
