simakma5/diploma-thesis/journal/src/final_sparameters-eps-converted-to.pdf

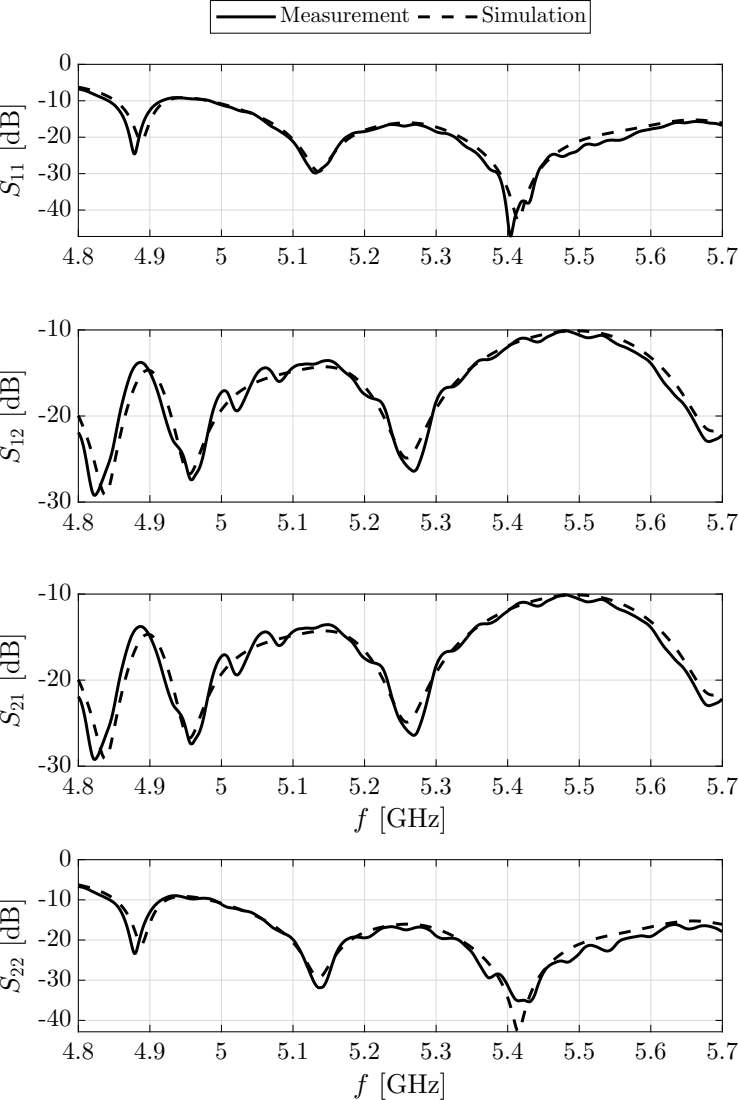
[picture p182: page 1]
f [GHz]; Measurement; Simulation
