simakma5/diploma-thesis/journal/src/polarizer_radiation-eps-converted-to.pdf

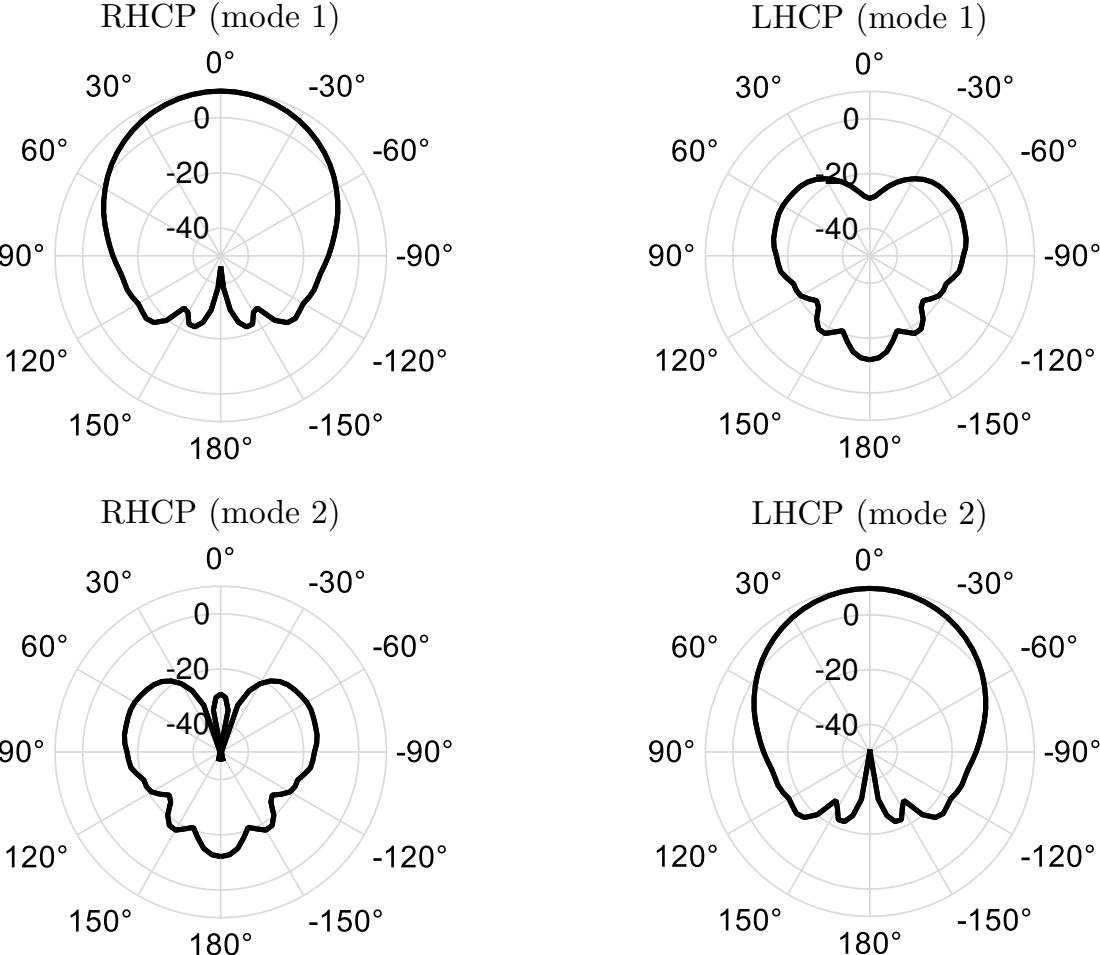
[picture p183: page 1]
RHCP (mode 1); LHCP (mode 1); RHCP (mode 2); LHCP (mode 2)
