simakma5/diploma-thesis/journal/src/polarizer_sweep-eps-converted-to.pdf

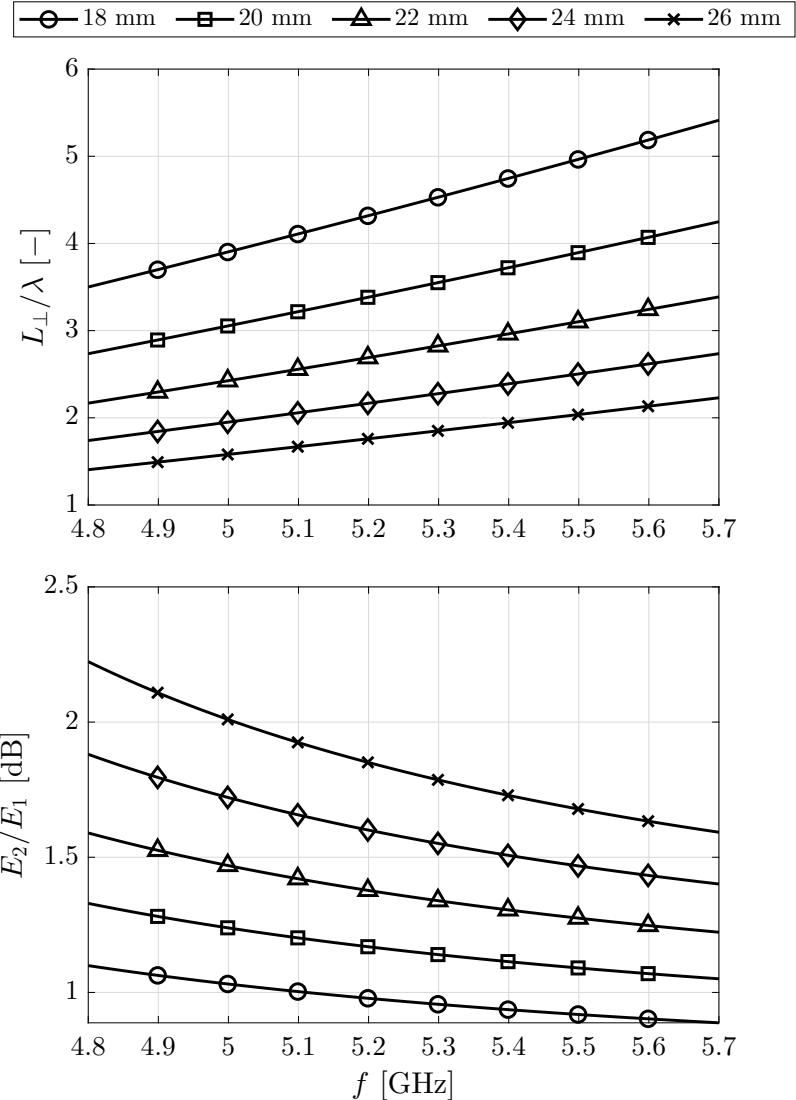
[picture p184: page 1]
f [GHz]
