simakma5/diploma-thesis/latex/svg-inkscape/antenna2_boresight_radiation_svg-tex.pdf

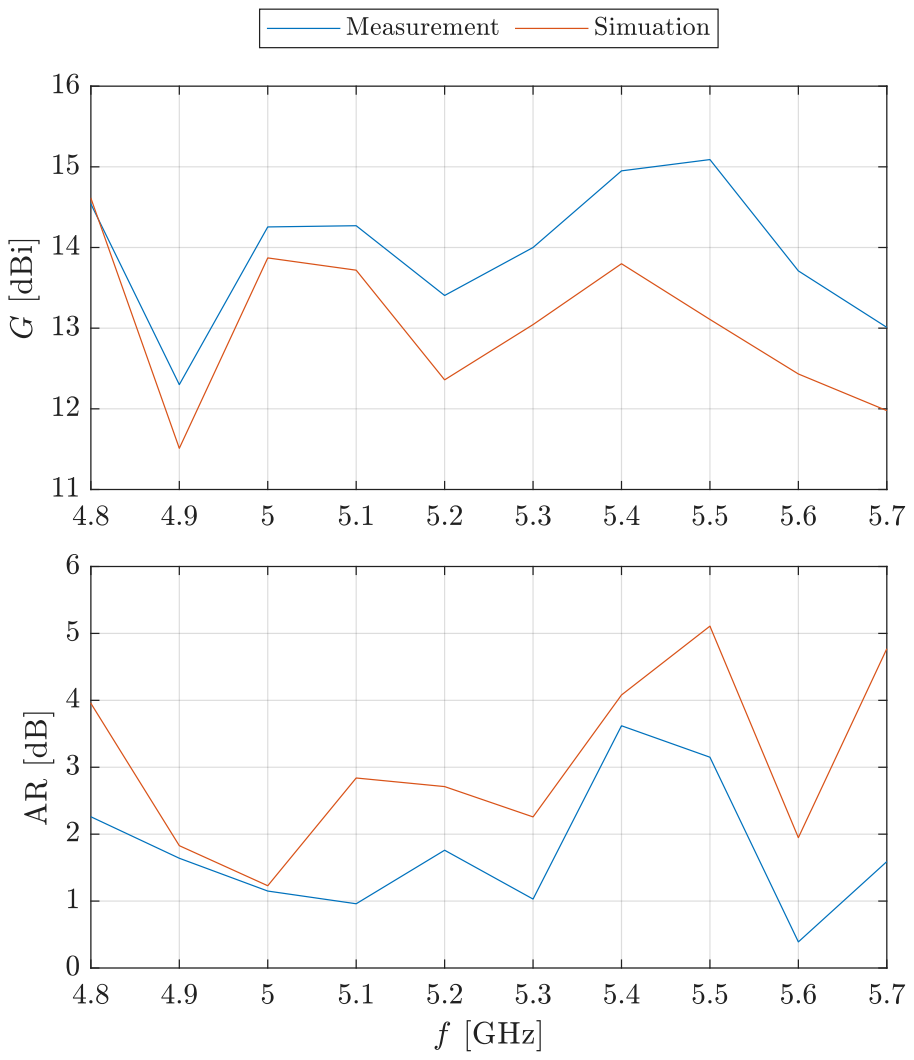
[picture p185: page 1]
