simakma5/diploma-thesis/latex/svg-inkscape/circular_polarizer_cross_section_svg-tex.pdf

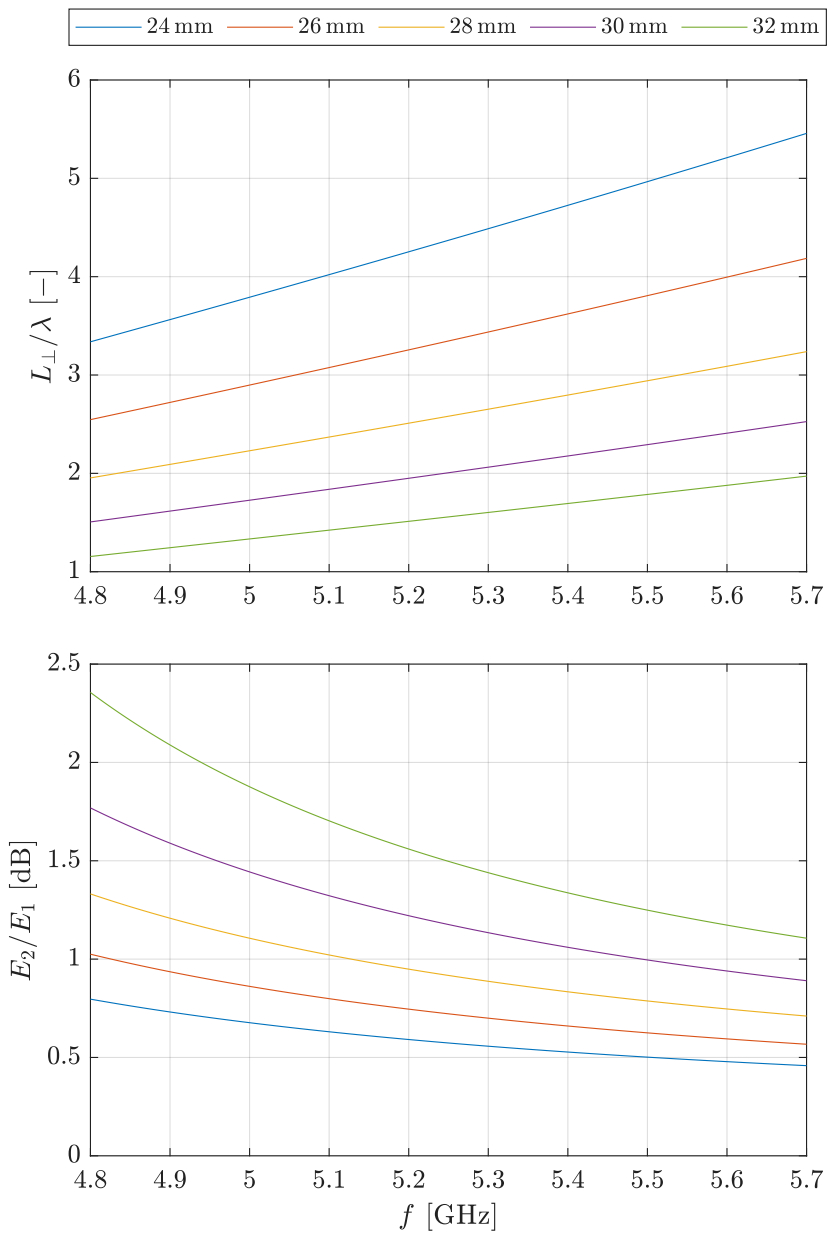
[picture p186: page 1]
