simakma5/diploma-thesis/latex/svg-inkscape/conical_horns_comparison_svg-tex.pdf

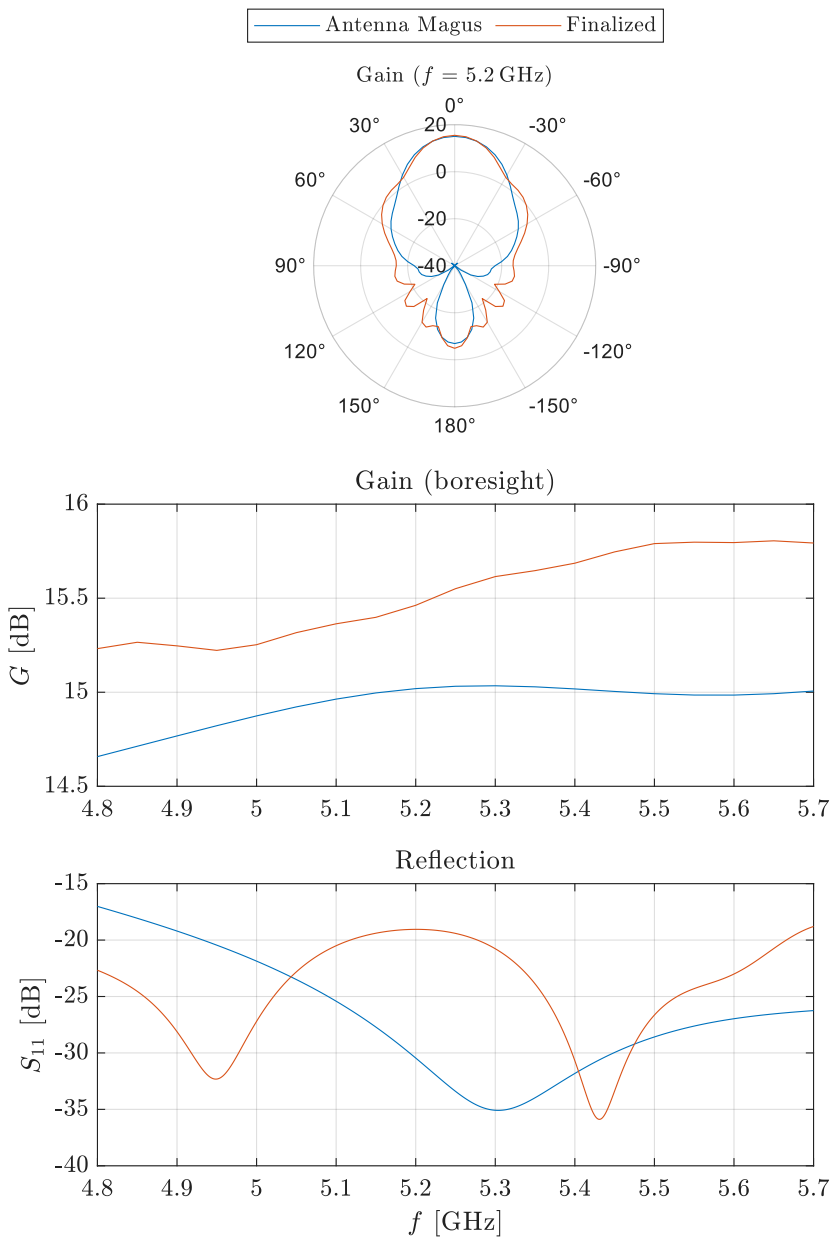
[picture p187: page 1]
