simakma5/diploma-thesis/latex/svg-inkscape/dual_feed_sparameters_svg-tex.pdf

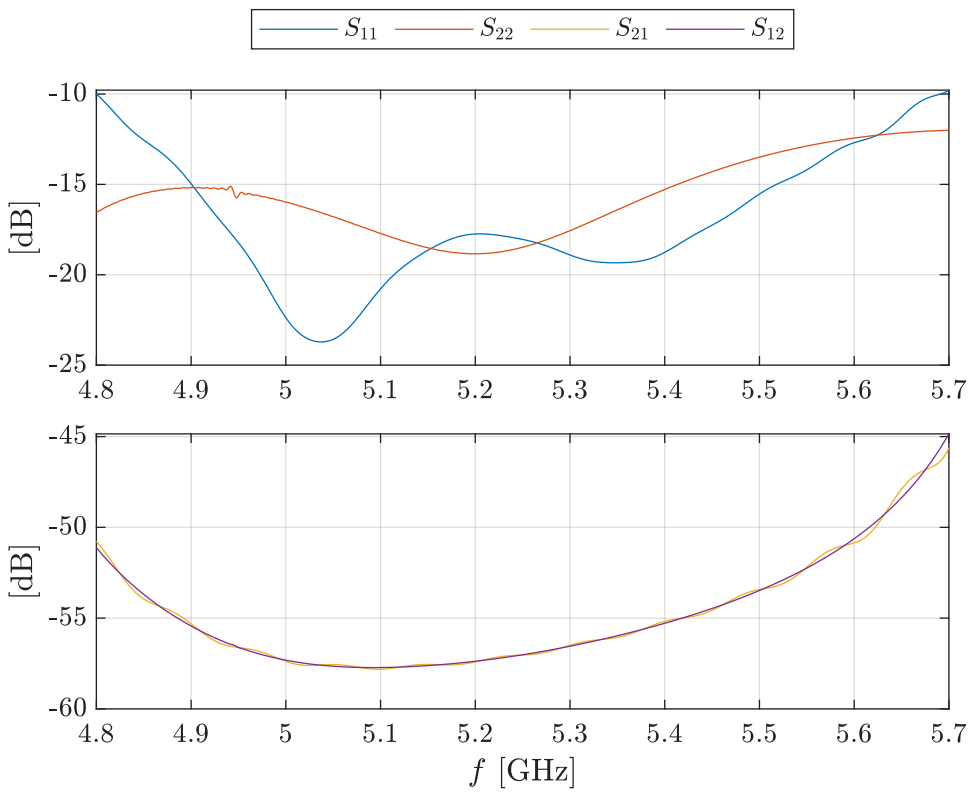
[picture p188: page 1]
