simakma5/diploma-thesis/latex/svg-inkscape/grating_vs_mvp_sparameters_svg-tex.pdf

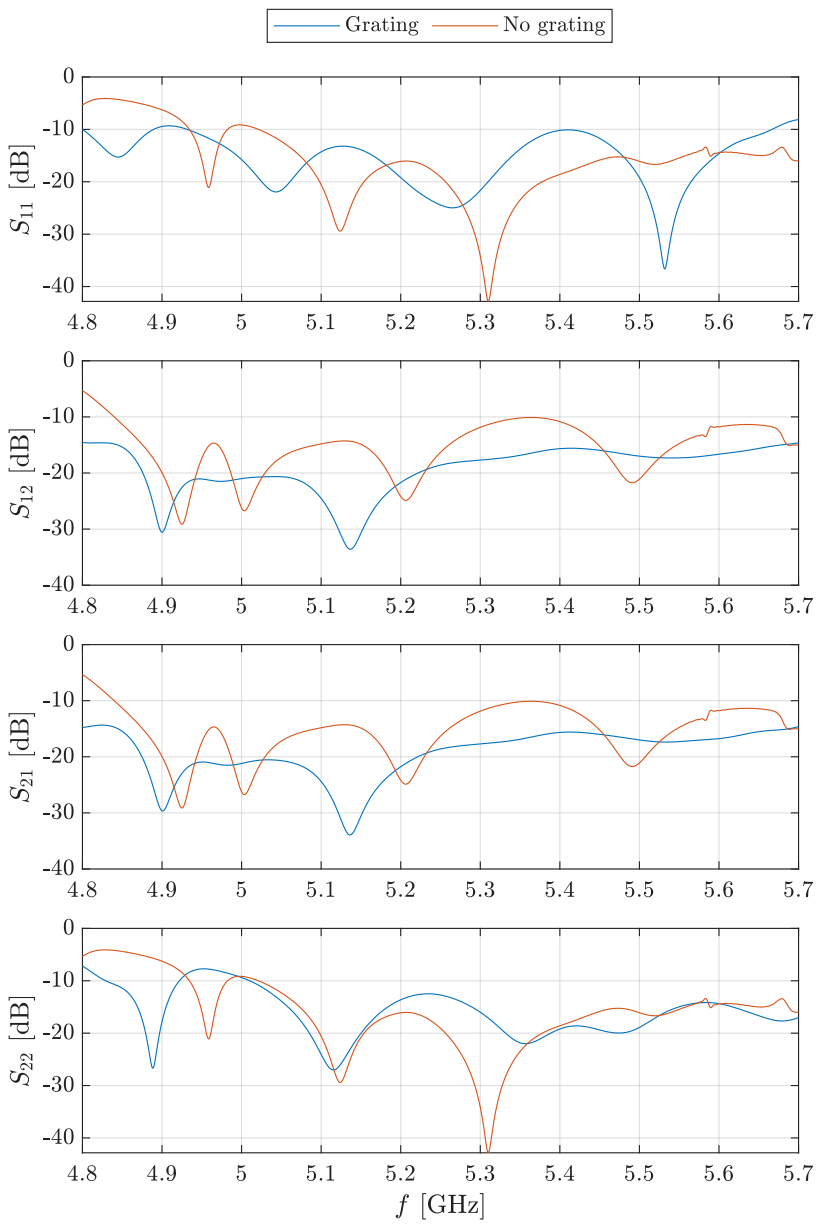
[picture p189: page 1]
