simakma5/diploma-thesis/latex/svg-inkscape/meas2_sparameters_svg-tex.pdf

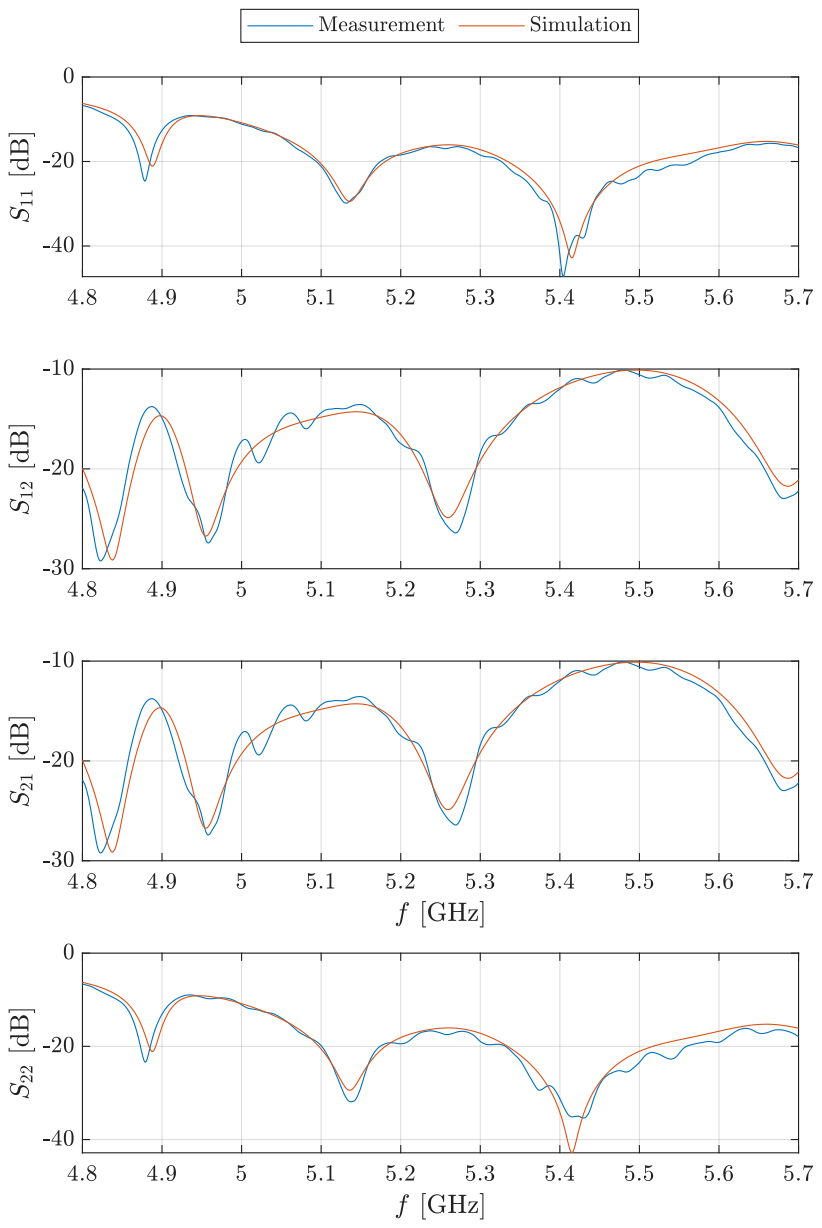
[picture p190: page 1]
