simakma5/diploma-thesis/latex/svg-inkscape/polarizer_radiation_svg-tex.pdf

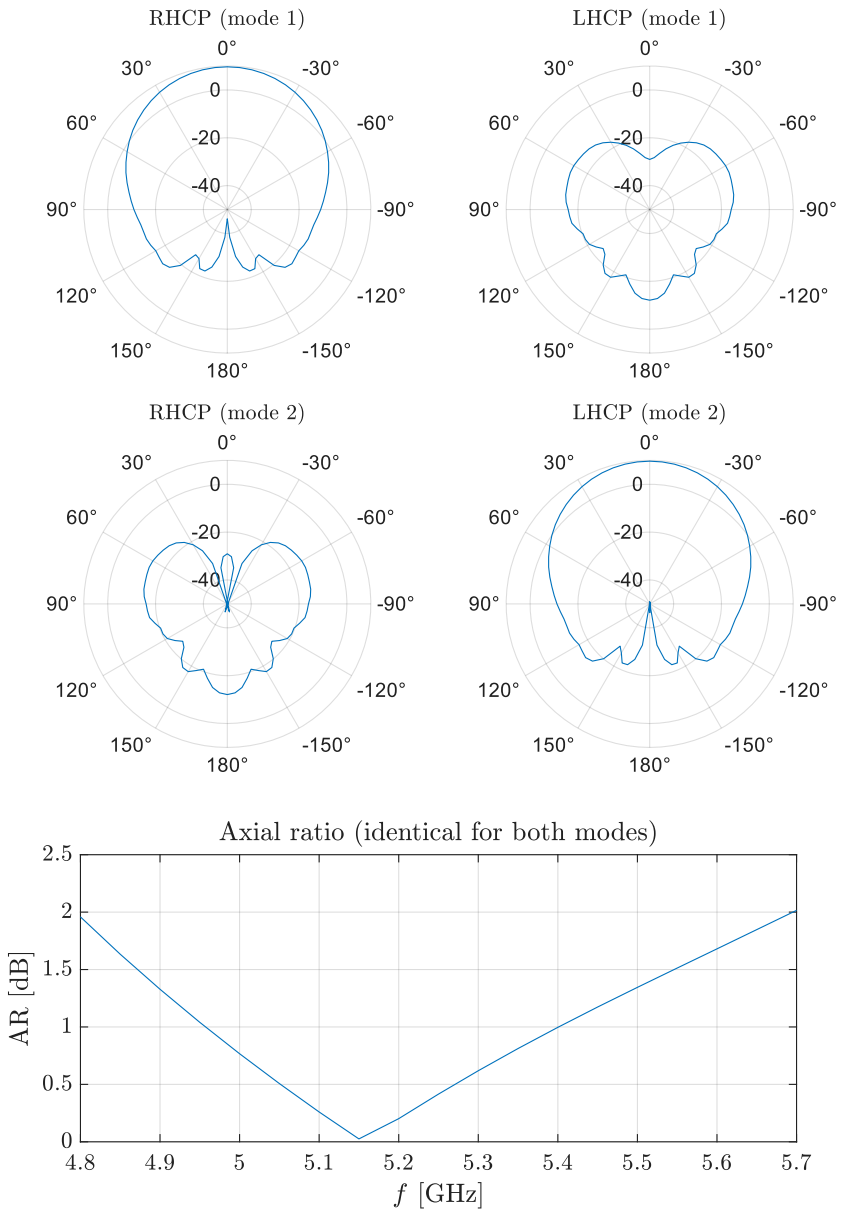
[picture p191: page 1]
