simakma5/diploma-thesis/latex/svg-inkscape/polarizers_cutoff_frequencies_svg-tex.pdf

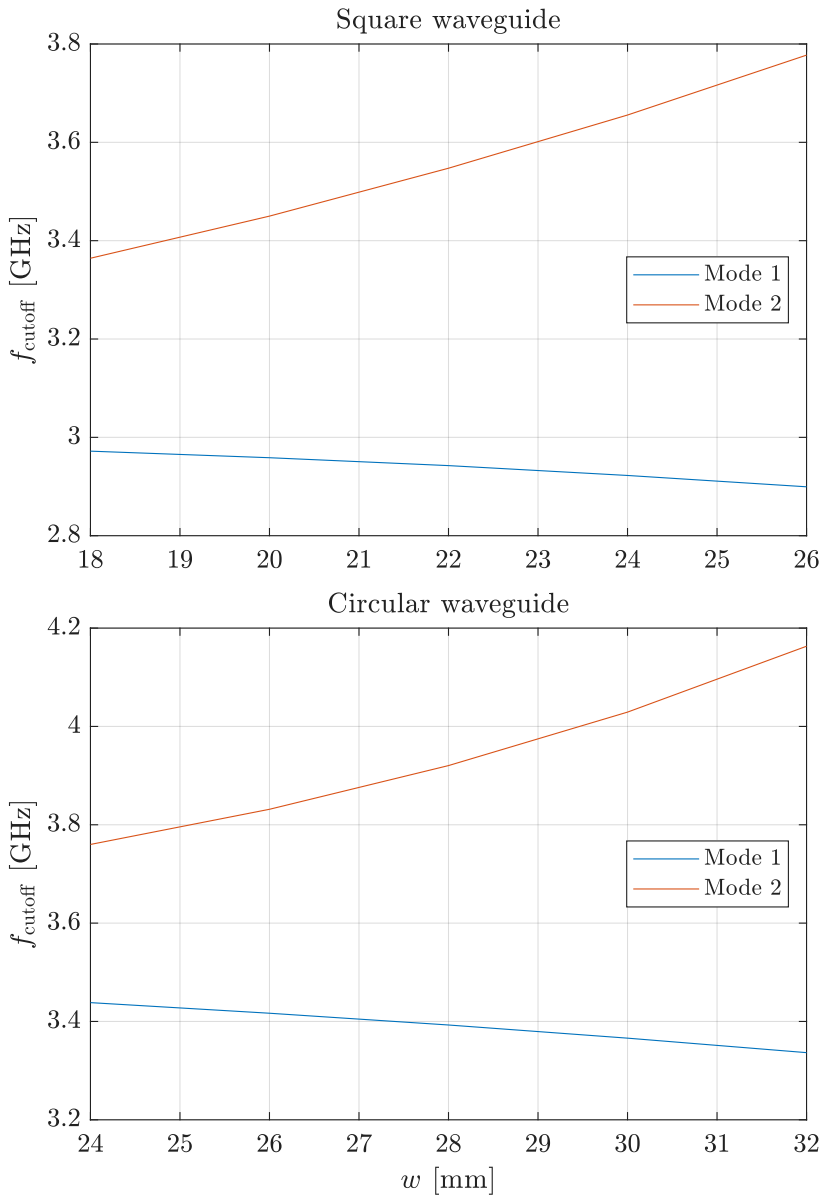
[picture p192: page 1]
