simakma5/diploma-thesis/latex/svg-inkscape/single_feed_reflection_svg-tex.pdf

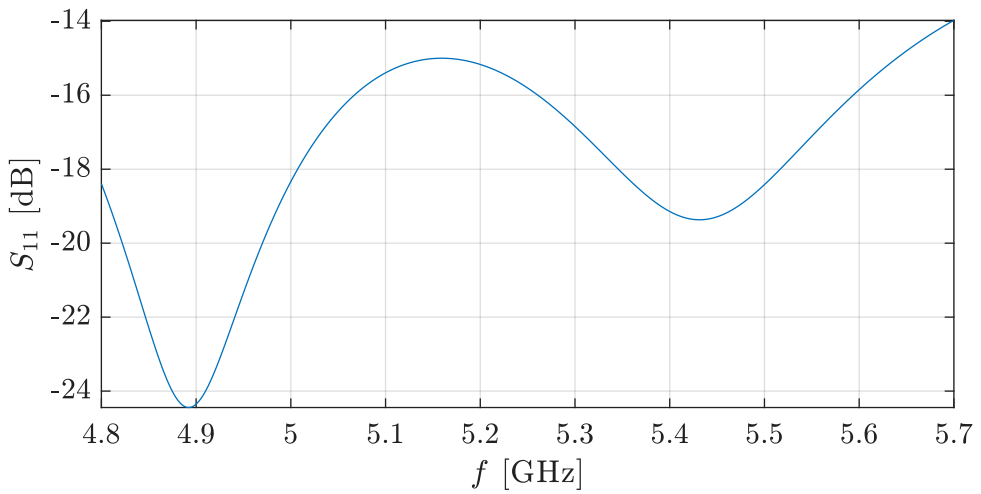
[picture p193: page 1]
