simakma5/diploma-thesis/latex/svg-inkscape/single_feed_with_grating_reflection_svg-tex.pdf

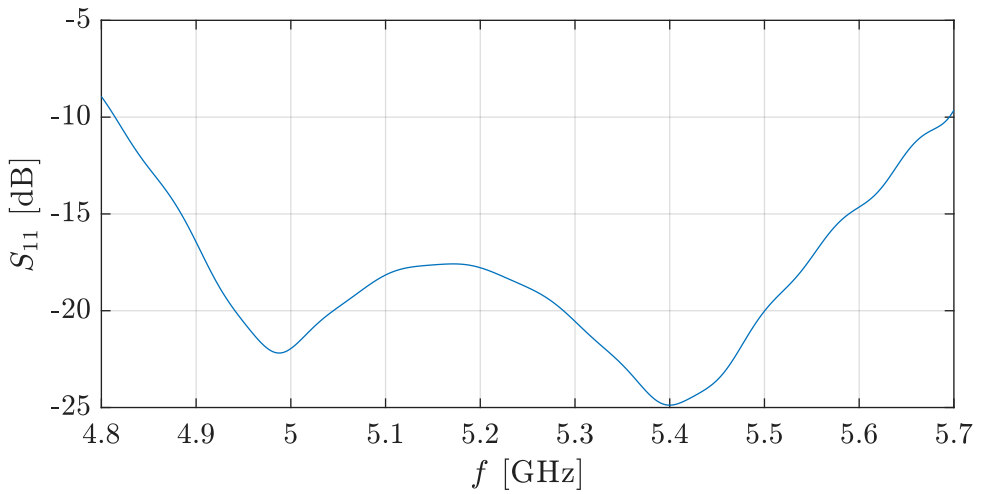
[picture p194: page 1]
