simakma5/diploma-thesis/latex/svg-inkscape/square_polarizer_cross_section_svg-tex.pdf

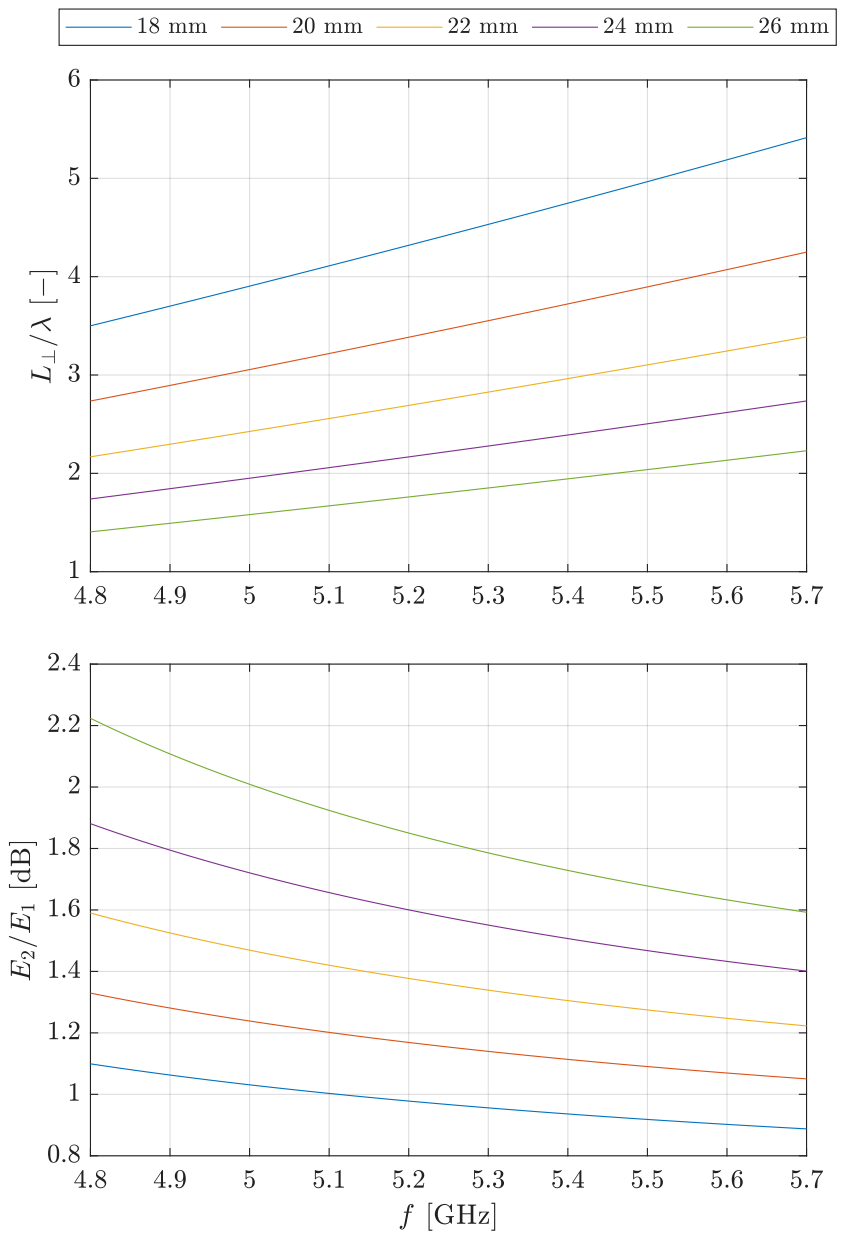
[picture p195: page 1]
