simakma5/diploma-thesis/latex/svg-inkscape/meas1_sparameters_svg-tex.pdf

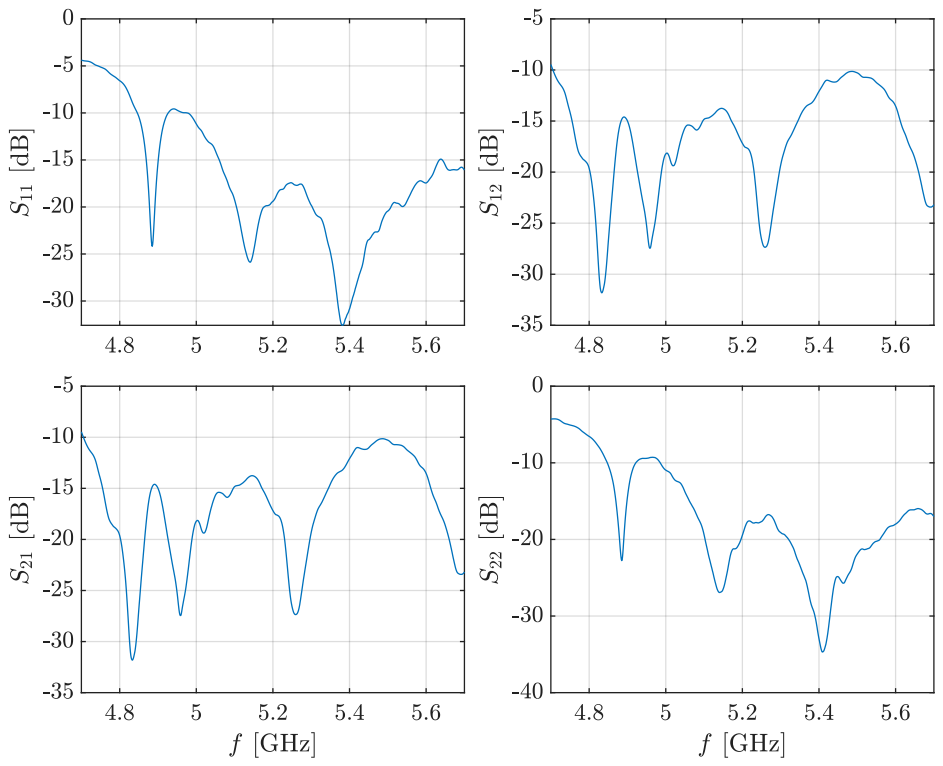
[picture p196: page 1]
