simakma5/diploma-thesis/latex/svg-inkscape/meas_vs_sim_boresight_radiation_svg-tex.pdf

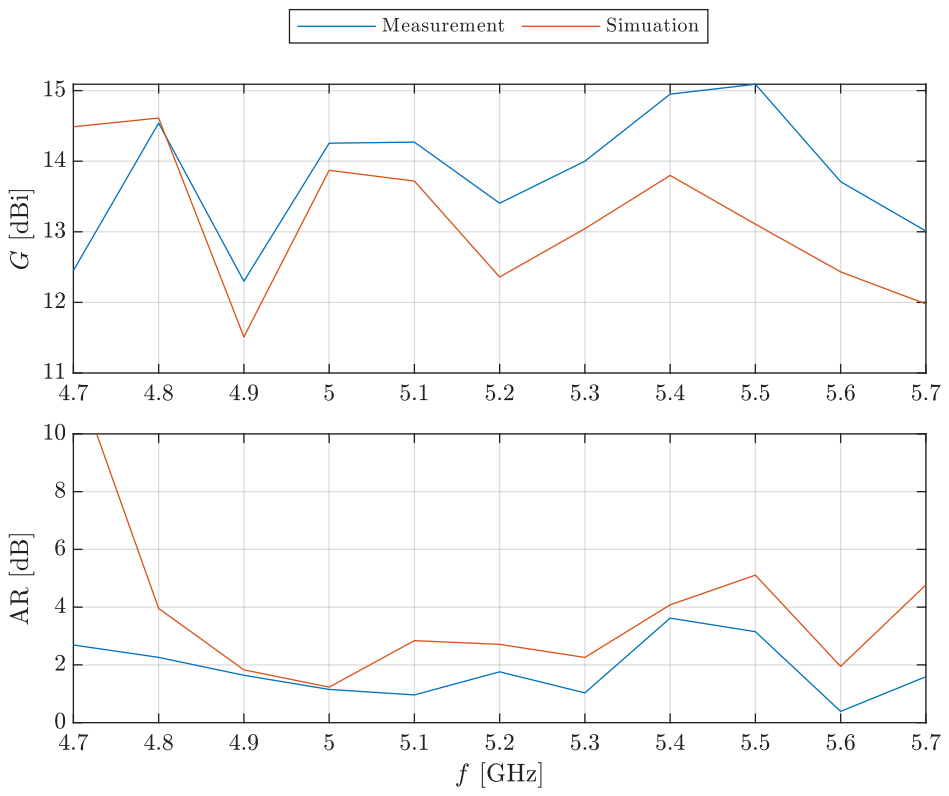
[picture p197: page 1]
