simakma5/diploma-thesis/latex/svg-inkscape/meas_vs_sim_sparameters_svg-tex.pdf

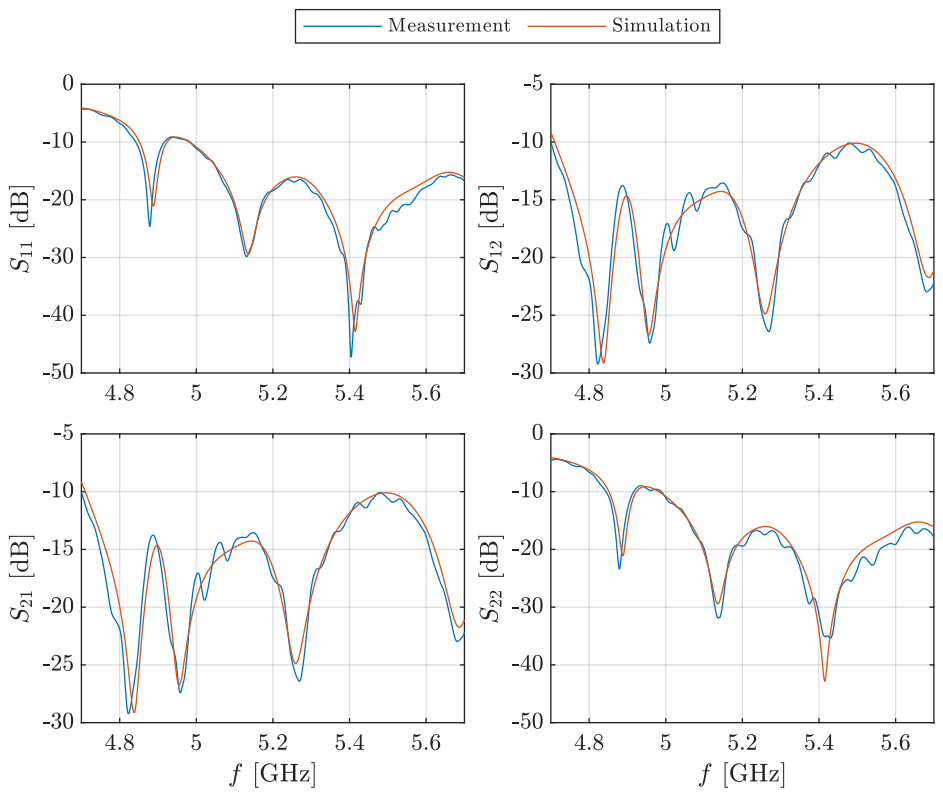
[picture p198: page 1]
