simakma5/diploma-thesis/latex/svg-inkscape/meas1_azimuth_radiation_svg-tex.pdf

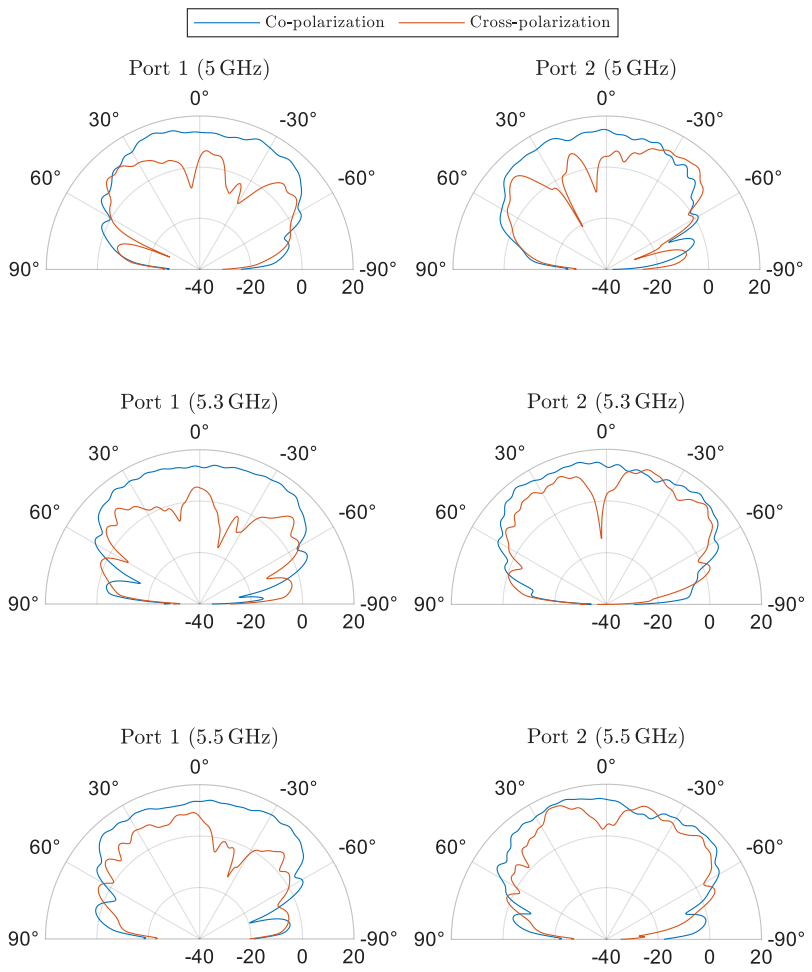
[picture p199: page 1]
