simakma5/diploma-thesis/latex/svg-inkscape/meas1_boresight_radiation_svg-tex.pdf

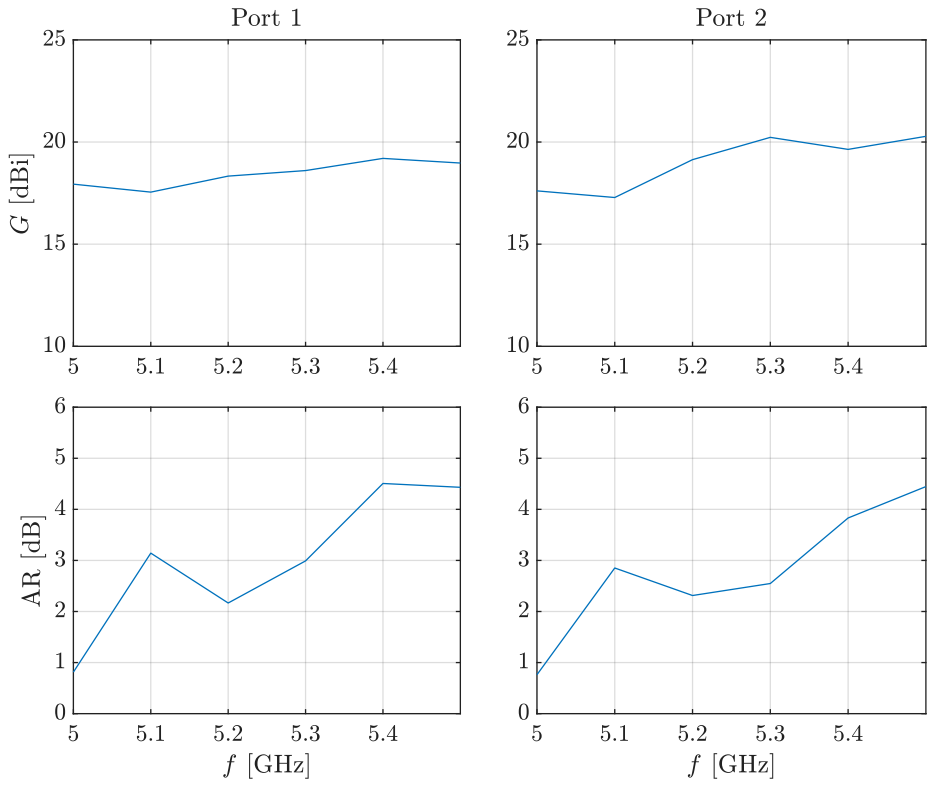
[picture p200: page 1]
