simakma5/diploma-thesis/latex/svg-inkscape/meas1_elevation_radiation_svg-tex.pdf

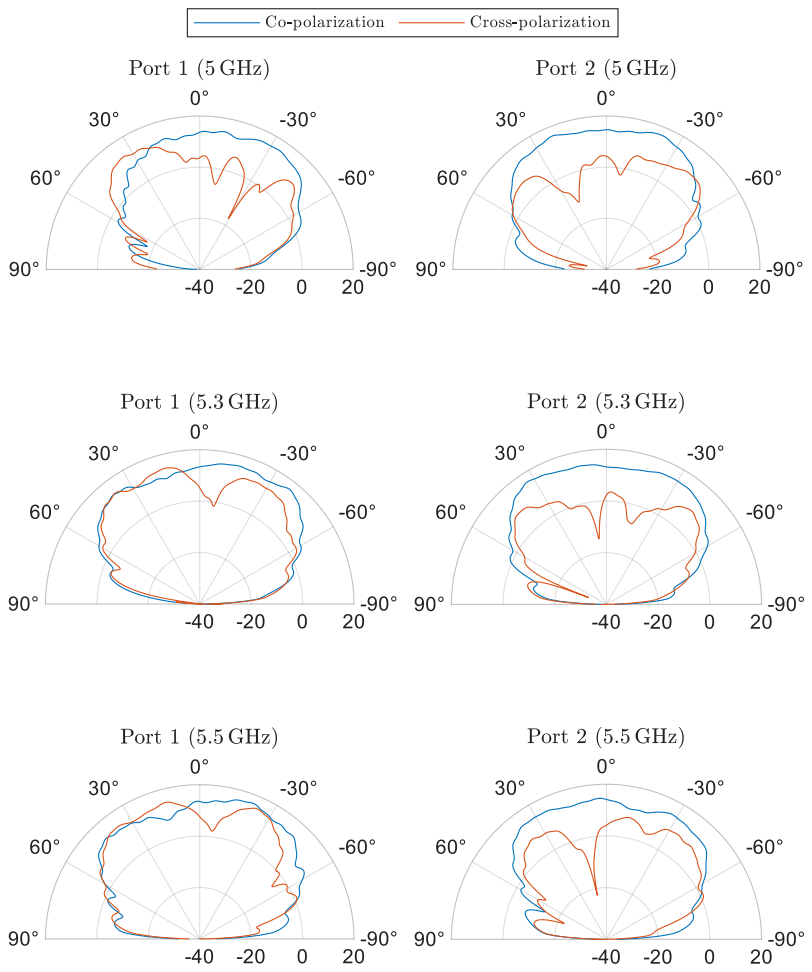
[picture p201: page 1]
