simakma5/diploma-thesis/latex/svg-inkscape/meas2_azimuth_radiation_svg-tex.pdf

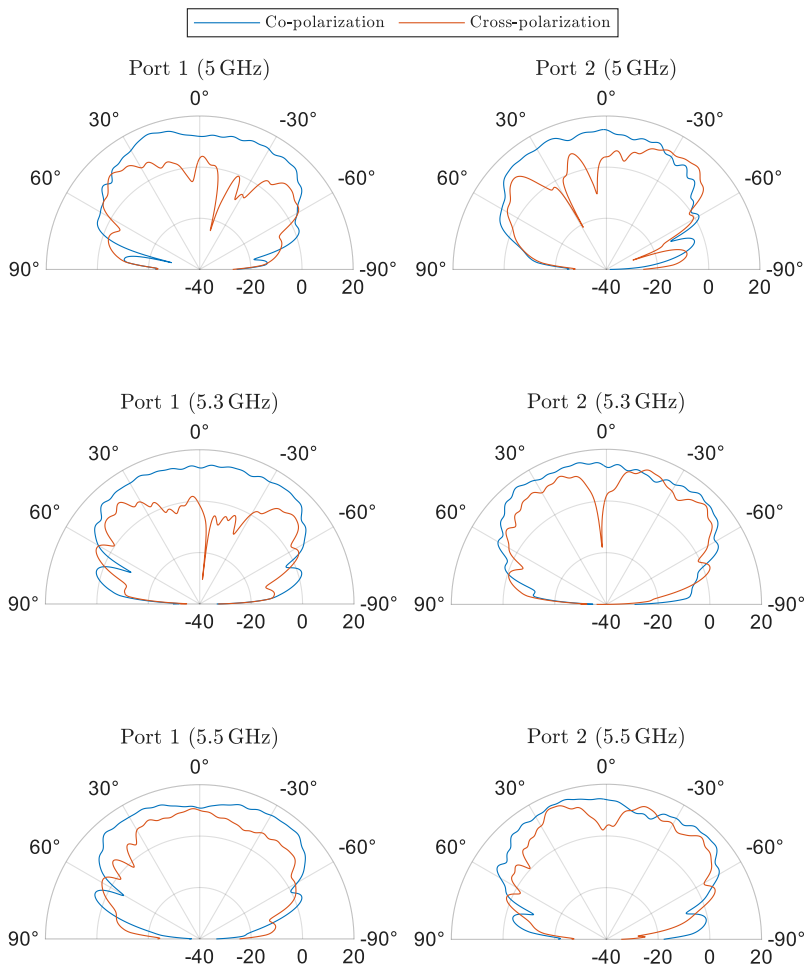
[picture p202: page 1]
