simakma5/diploma-thesis/latex/svg-inkscape/meas2_boresight_radiation_svg-tex.pdf

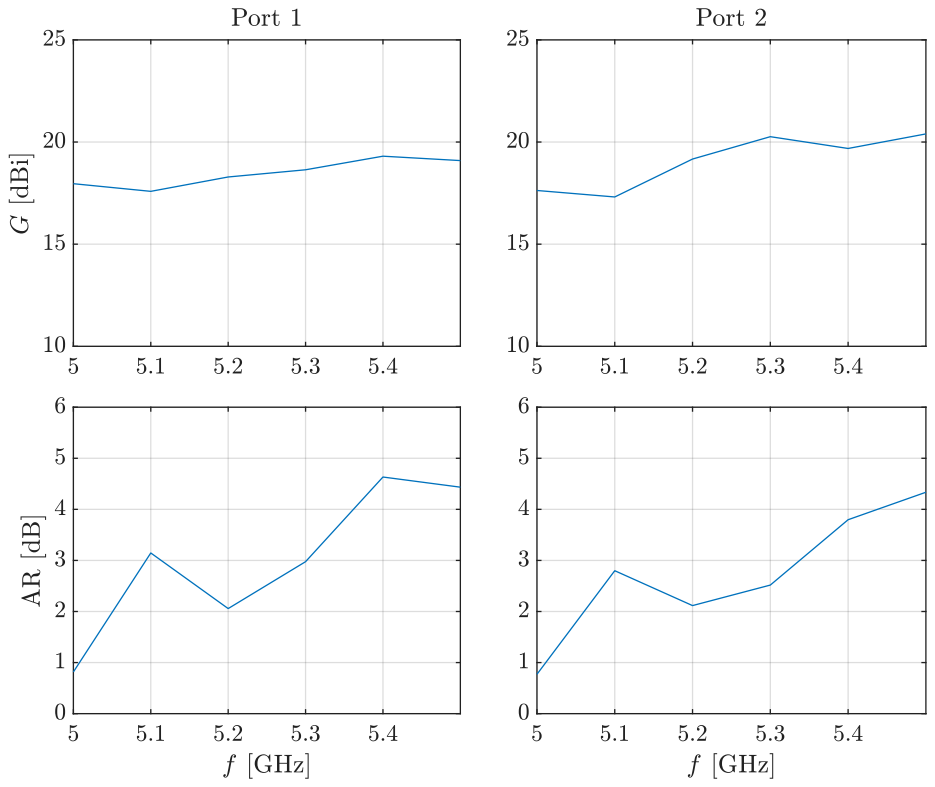
[picture p203: page 1]
