simakma5/diploma-thesis/latex/svg-inkscape/meas2_elevation_radiation_svg-tex.pdf

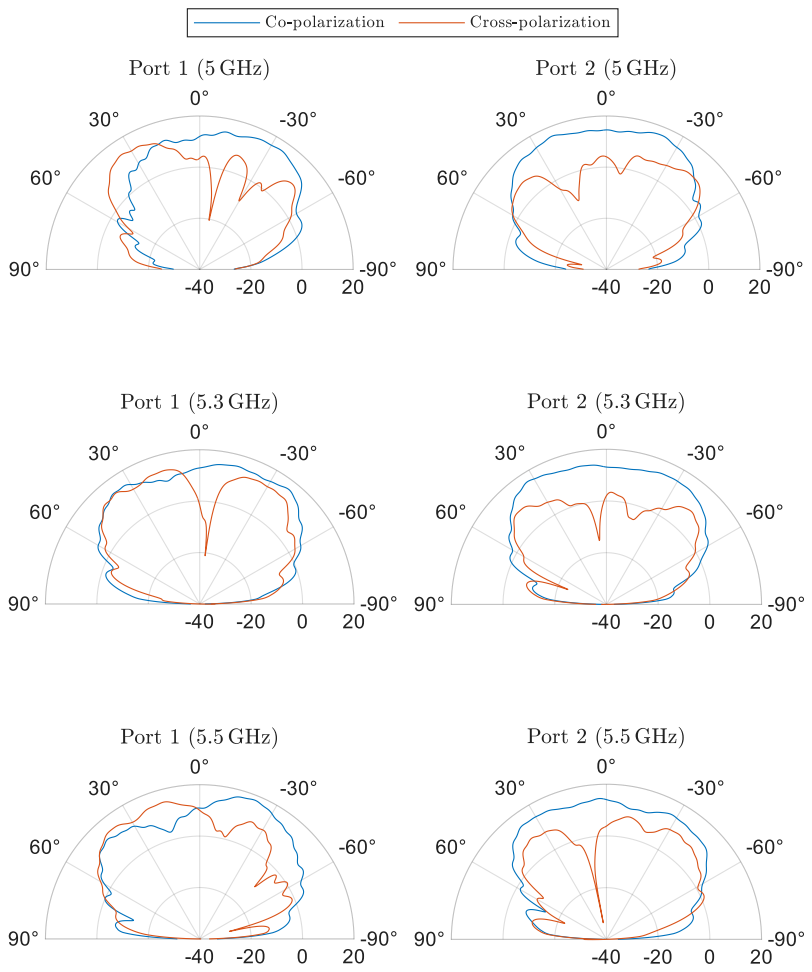
[picture p204: page 1]
