simakma5/diploma-thesis/latex/svg-inkscape/meas_vs_sim_gain_and_aperture_efficiency_svg-tex.pdf

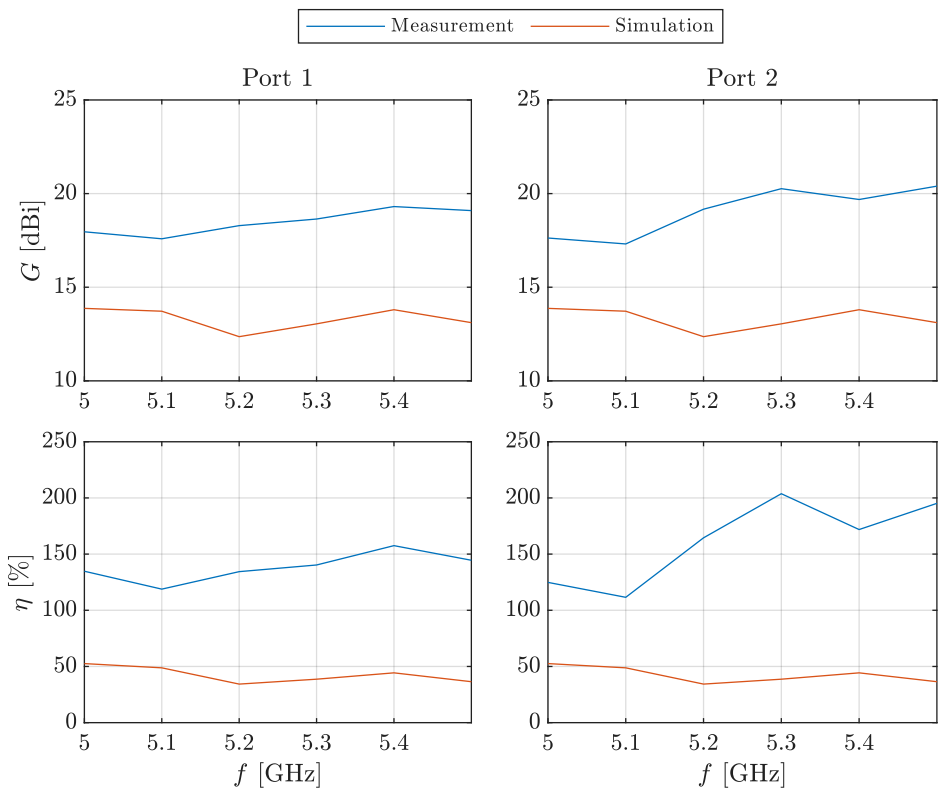
[picture p205: page 1]
