simakma5/diploma-thesis/latex/svg-inkscape/meas_vs_sim_aperture_efficiency_svg-tex.pdf

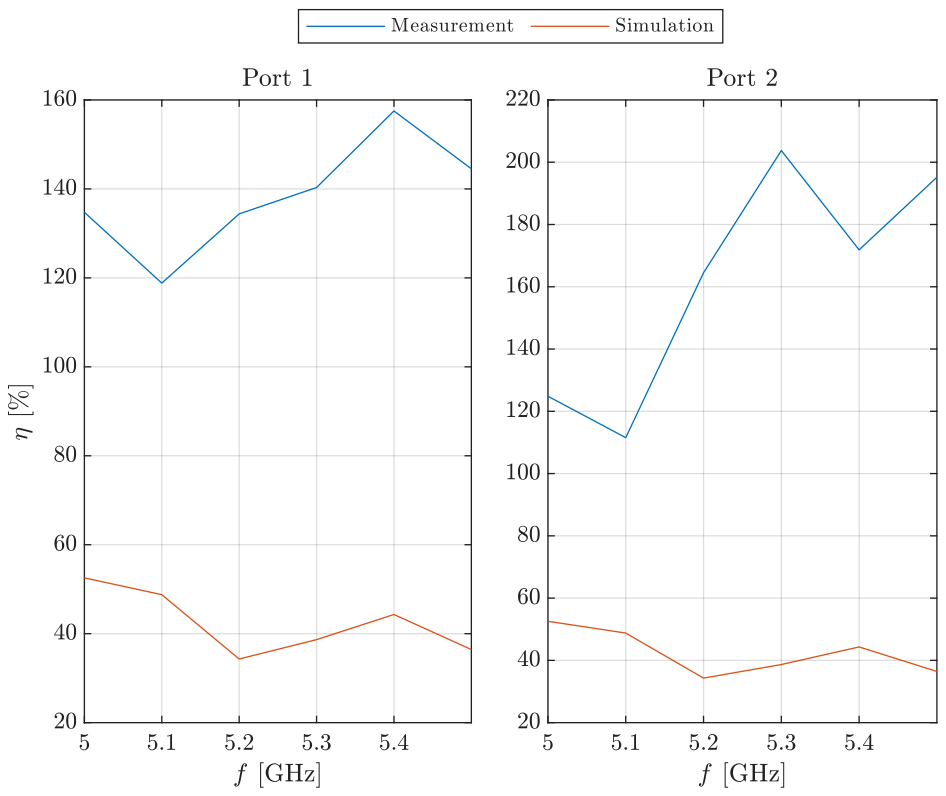
[picture p206: page 1]
