simakma5/diploma-thesis/latex/svg-inkscape/meas_vs_sim_axial_ratio_svg-tex.pdf

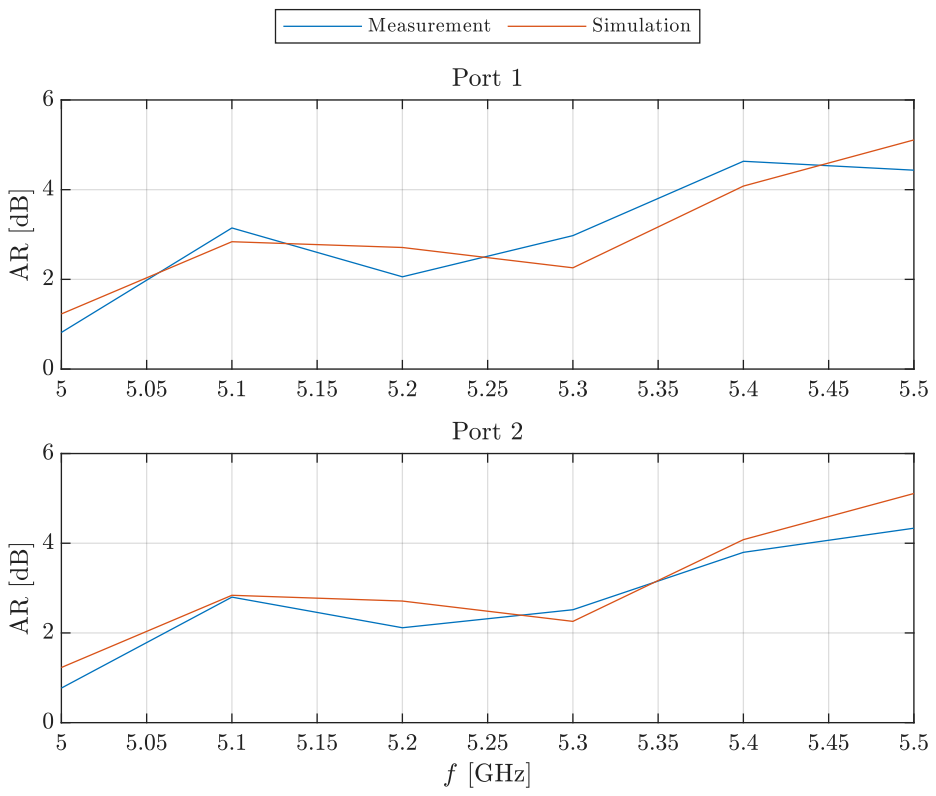
[picture p207: page 1]
