simakma5/diploma-thesis/latex/svg-inkscape/grating_distance_sweep_svg-tex.pdf

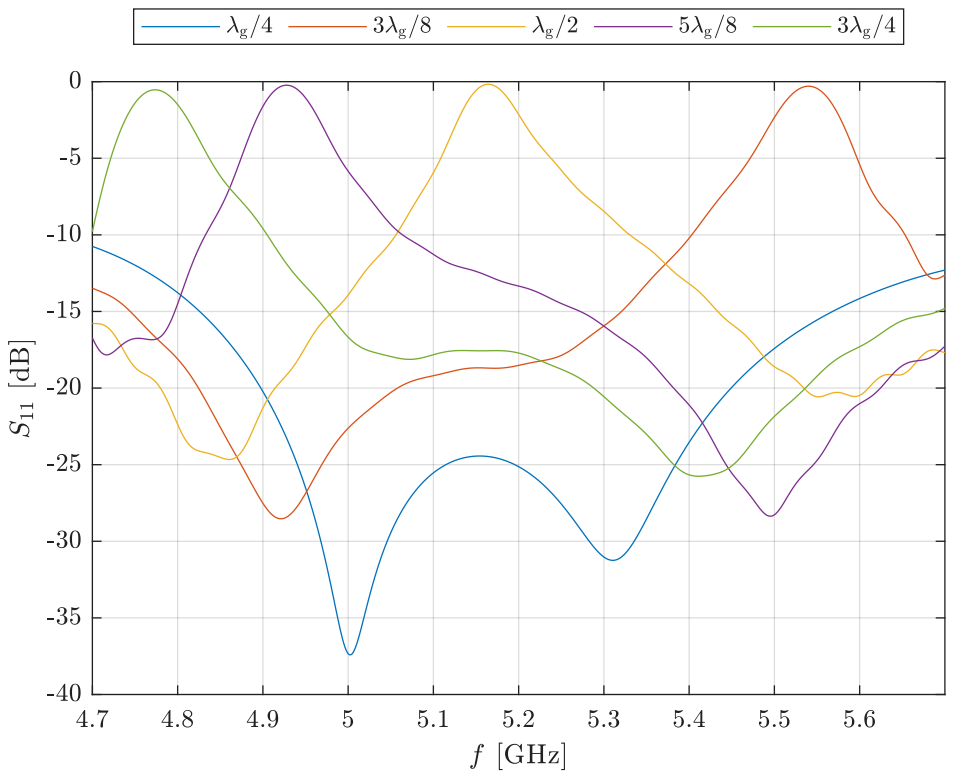
[picture p208: page 1]
