simakma5/diploma-thesis/latex/svg-inkscape/grating_vs_mvp_gain_sparameters_svg-tex.pdf

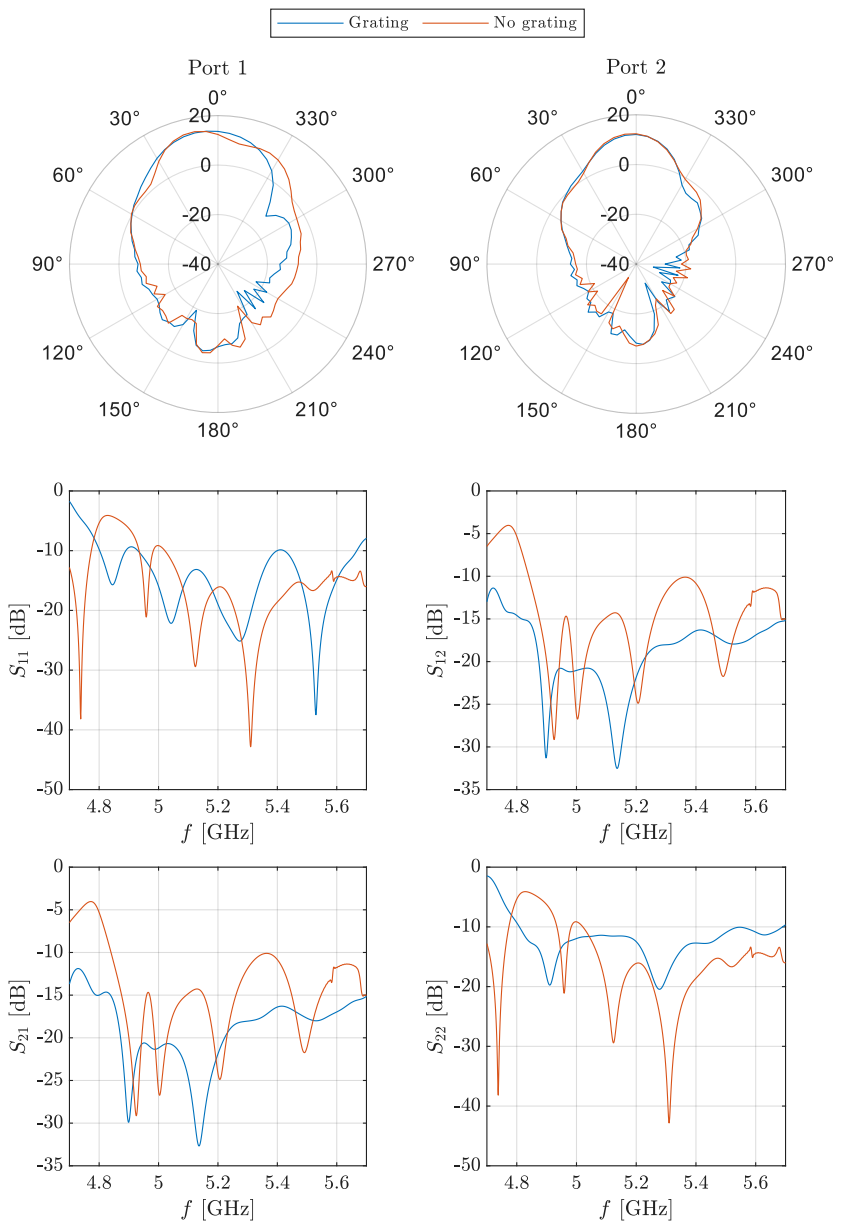
[picture p209: page 1]
