simakma5/diploma-thesis/latex/svg-inkscape/grating_vs_mvp_polarization_svg-tex.pdf

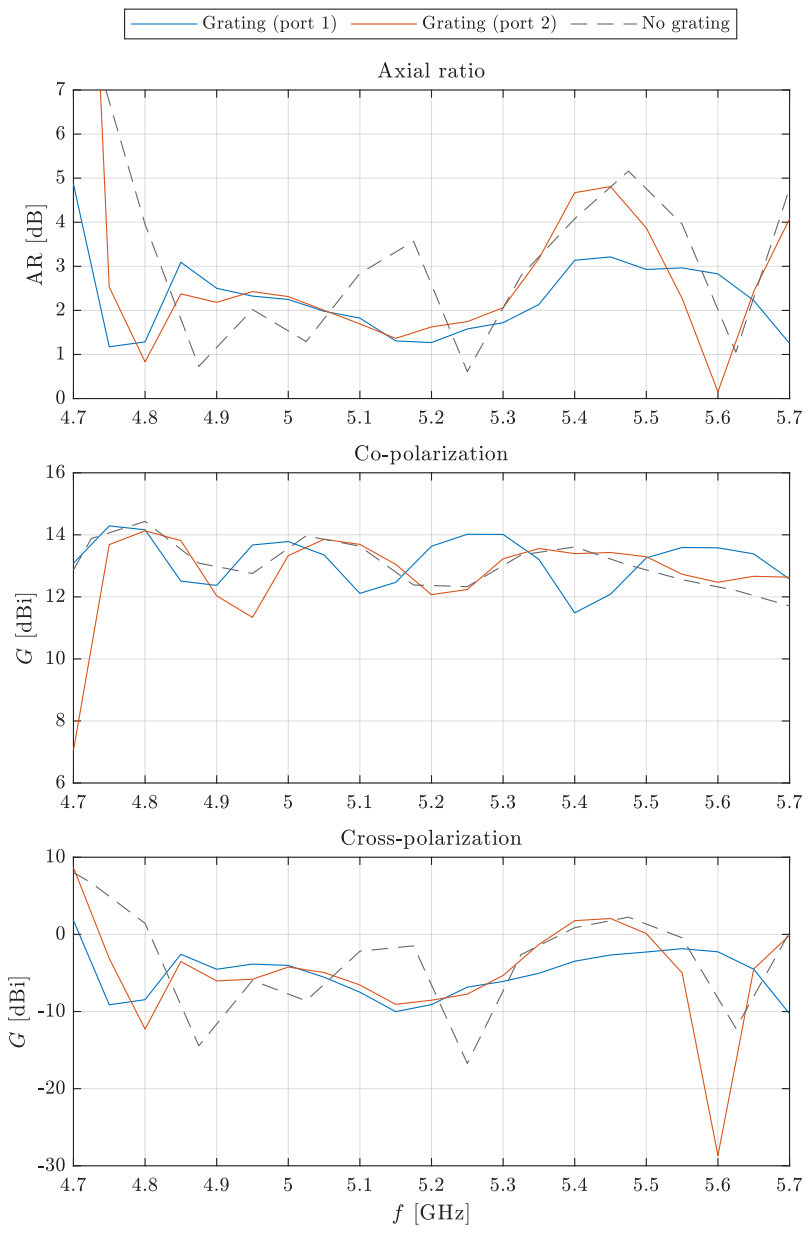
[picture p210: page 1]
