simakma5/diploma-thesis/latex/svg-inkscape/meas1_gains_svg-tex.pdf

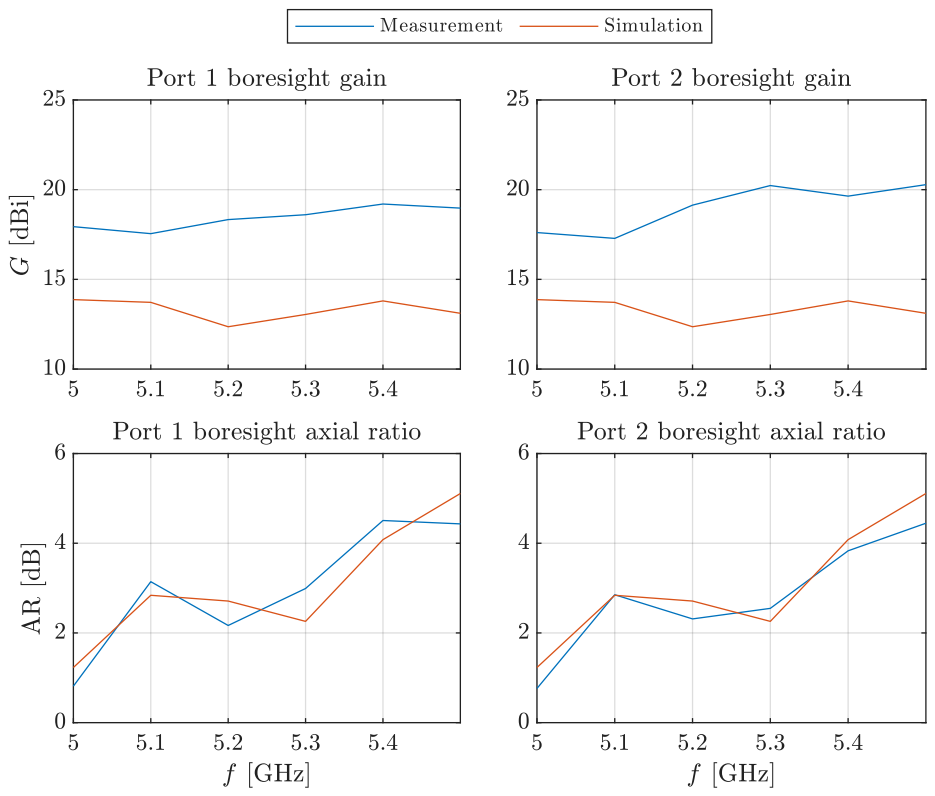
[picture p211: page 1]
