simakma5/diploma-thesis/latex/svg-inkscape/meas2_gains_svg-tex.pdf

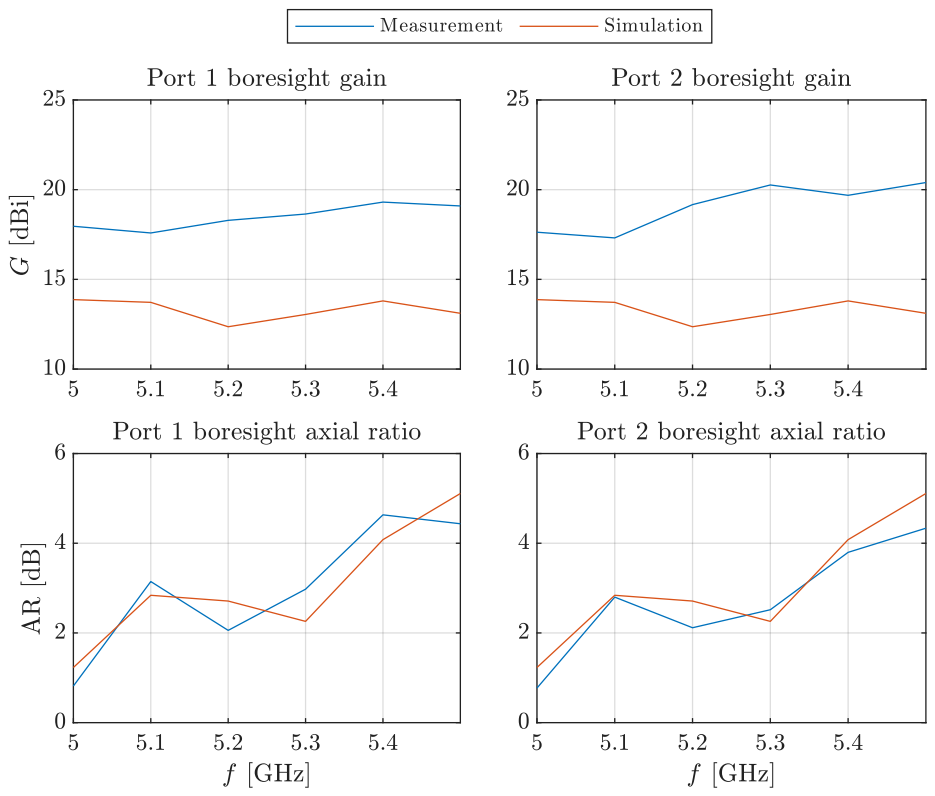
[picture p212: page 1]
