simakma5/diploma-thesis/(commit log)

2024-12-15 text: theory prototype finished
2025-01-10 text,matlab: new measurement (NTUST)
    [antenna1_port1_azimuth.xls, antenna1_port1_azimuth1.xls, antenna1_port1_azimuth2.xls, antenna1_port1_elevation.xls, antenna1_port2_azimuth.xls, antenna1_port2_elevation.xls, antenna2_port1_azimuth.xls, antenna2_port1_elevation.xls]
